OpenLogicEFI/Hardware/README.md

# [OpenLogicEFI](https://www.openlogicefi.com)
Formerly: DetonationEMS

</div>

OpenLogicEFI ECU's are based off an open source project called Speeduino by Josh Stewart. Currently all released boards use official Speeduino firmware. In TunerStudio set to "Board Layout" to "Speeduino 0.4"

</div>

# License
All designs are released under the [TAPR Open Hardware License v1.0](https://files.tapr.org/OHL/TAPR_Open_Hardware_License_v1.0.txt)

</div>

# Documentation

- The [Official Speeduino Manual](https://wiki.speeduino.com), documents and discord are the best places to start.

- [Official Speeduino Forum](https://speeduino.com/forum)

- [Official Speeduino Discord](https://discord.gg/jcmar3zfSJ)

- [Additional Documentation and Links](https://www.openlogicefi.com/support)

</div>
