OpenLogicEFI/Hardware/Modules/VR Conditioner NCV1124/RevB2/README.md

# VR Conditioner
Based on the NCV1124 Chip
RevB2

Changes:
*Updated Silkscreen 
*Increased input trace size
*Increased NCV1124 pad size for easier hand soldering
