OpenLogicEFI/Hardware/Engine Managment/Pre-Ignition/Pre-Ignition x4/End Cap/README.md

# PCB end caps for Hammond Cases (1455L1201,1455L1202) when used with Pre-Ignition x4 PN:MX4C
# End-caps compatible with Pre-Ignition x4 PN: MX4A,B,C when installed in 2nd slot from the bottom in Hammond Case PN: 1455L1201 & 1455L1202

www.OpenLogicEFI.com
