OpenLogicEFI/Hardware/Engine Managment/1.x/v1.3/1.3d/IDC8.PNG

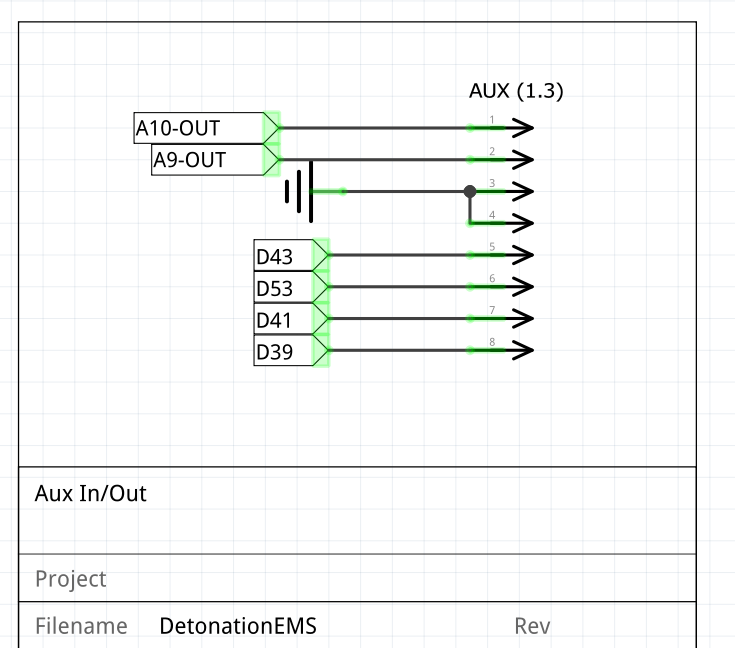
Engine Managment/1.x/v1.3/1.3d/IDC8.PNG
