OpenLogicEFI/Hardware/Engine Managment/1.x/v1.3/1.3d/uln2003.PNG

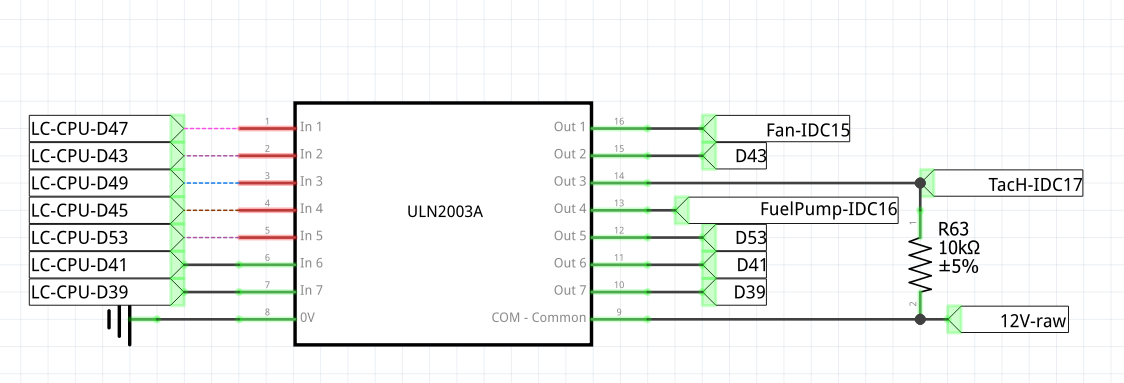
Engine Managment/1.x/v1.3/1.3d/uln2003.PNG
