OpenLogicEFI/Hardware/Engine Managment/Closed Deck/Closed Deck x4/Documentation/Black-B&W-Landscape.jpg

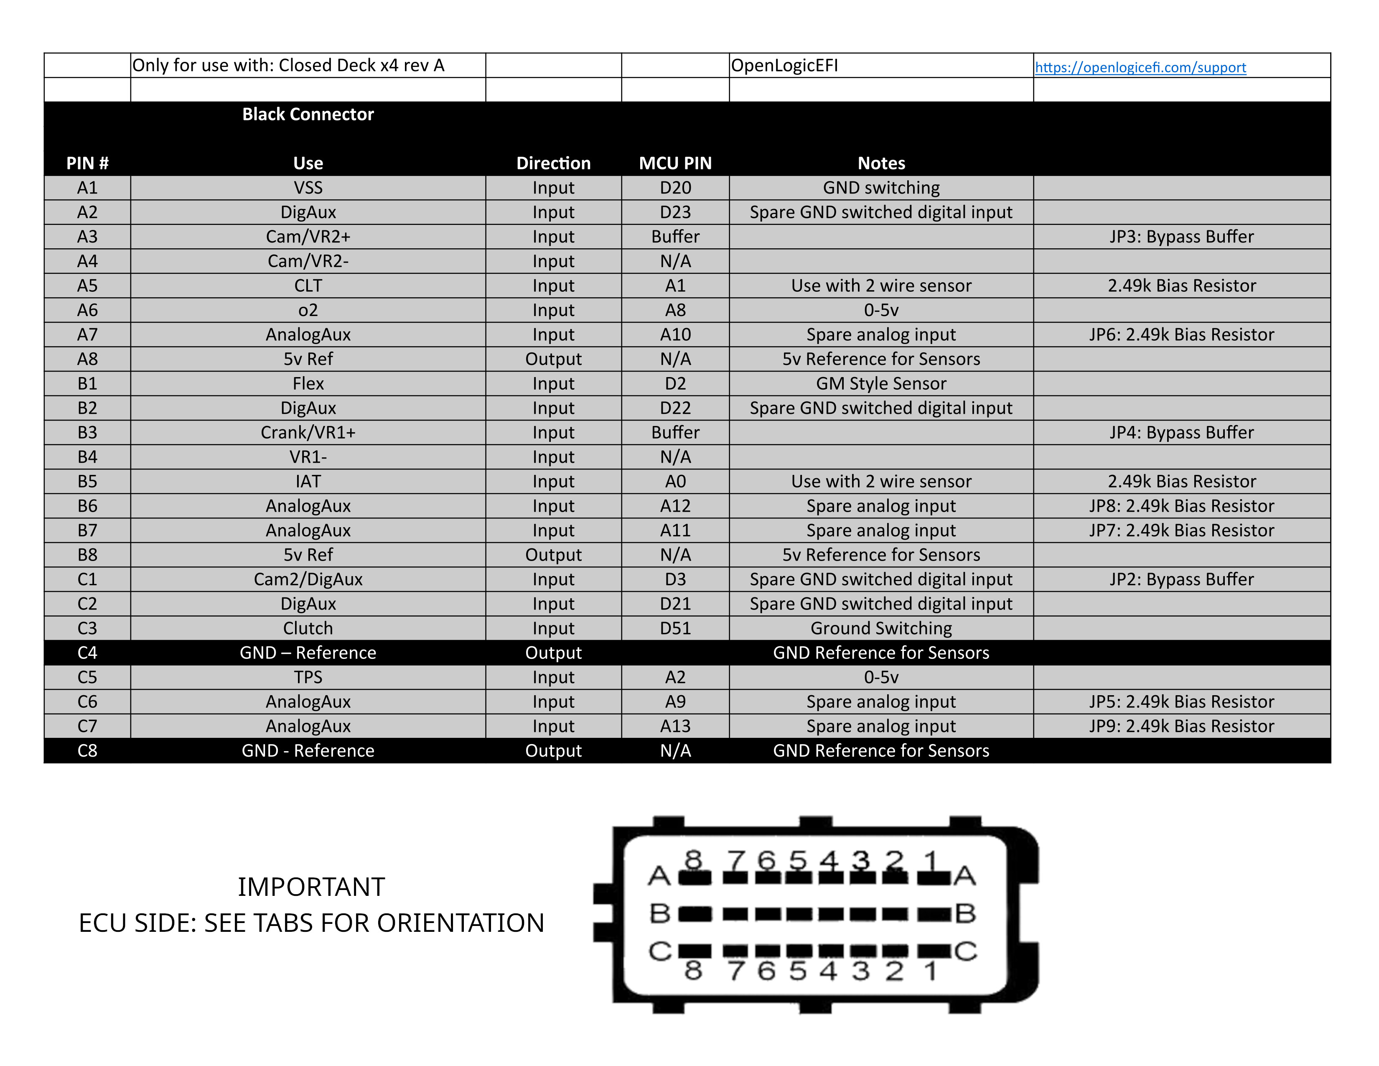
Engine Managment/Closed Deck/Closed Deck x4/Documentation/Black-B&W-Landscape.jpg
