OpenLogicEFI/Hardware/Engine Managment/Pre-Ignition/Pre-Ignition x2/Documents/MX2.jpg

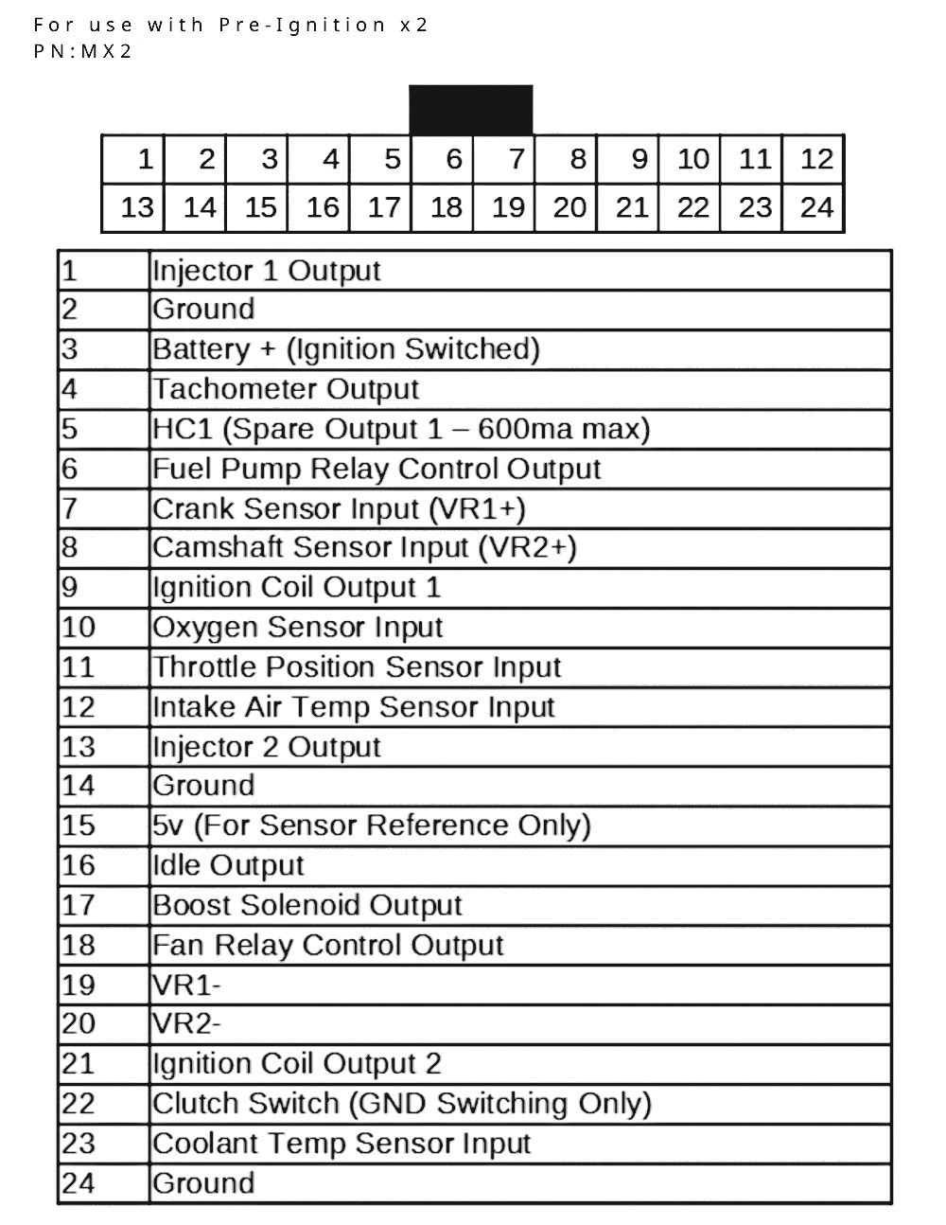
Engine Managment/Pre-Ignition/Pre-Ignition x2/Documents/MX2.jpg
