OpenLogicEFI/Hardware/Engine Managment/Pre-Ignition/Pre-Ignition x2/Documents/x2-24pin-harness.png

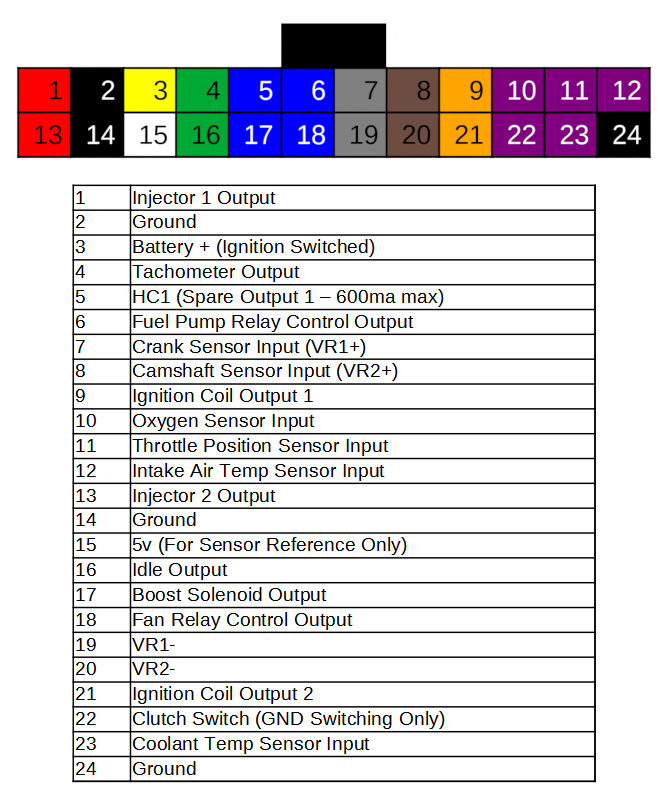
Engine Managment/Pre-Ignition/Pre-Ignition x2/Documents/x2-24pin-harness.png
