OpenLogicEFI/Hardware/Engine Managment/Pre-Ignition/Pre-Ignition x4/Documents/20pin-Bottom Mounted Connetcors.png

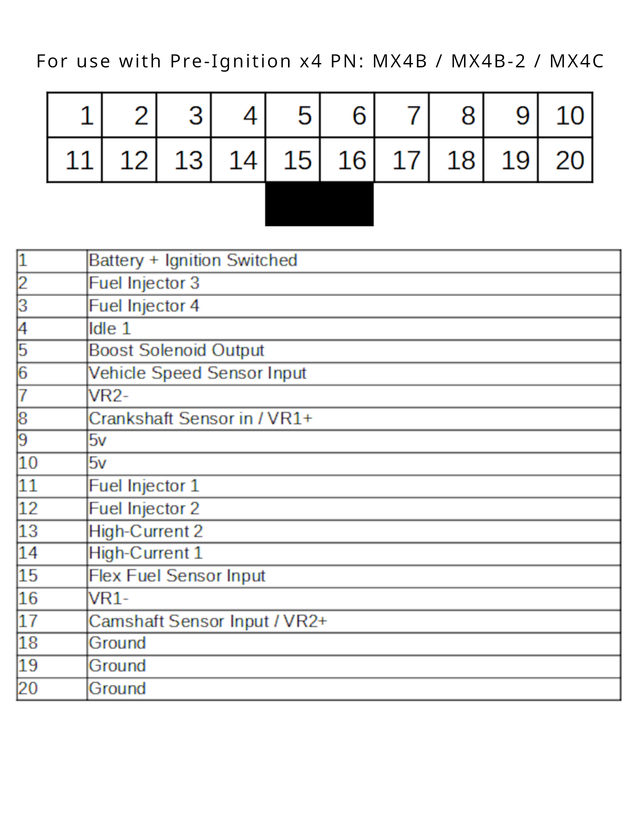
Engine Managment/Pre-Ignition/Pre-Ignition x4/Documents/20pin-Bottom Mounted Connetcors.png
