OpenLogicEFI/Hardware/Engine Managment/Pre-Ignition/Pre-Ignition x4/Documents/24pin-Bottom Mounted Connetcors.png

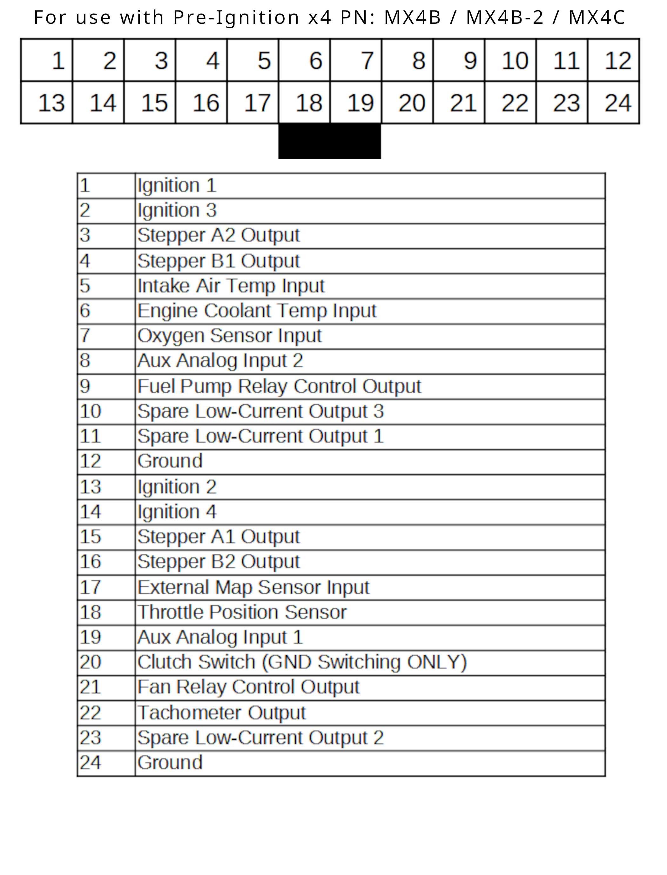
Engine Managment/Pre-Ignition/Pre-Ignition x4/Documents/24pin-Bottom Mounted Connetcors.png
