OpenLogicEFI/Hardware/Engine Managment/Pre-Ignition/Pre-Ignition x4/Documents/Harness20pin-LowMounted.png

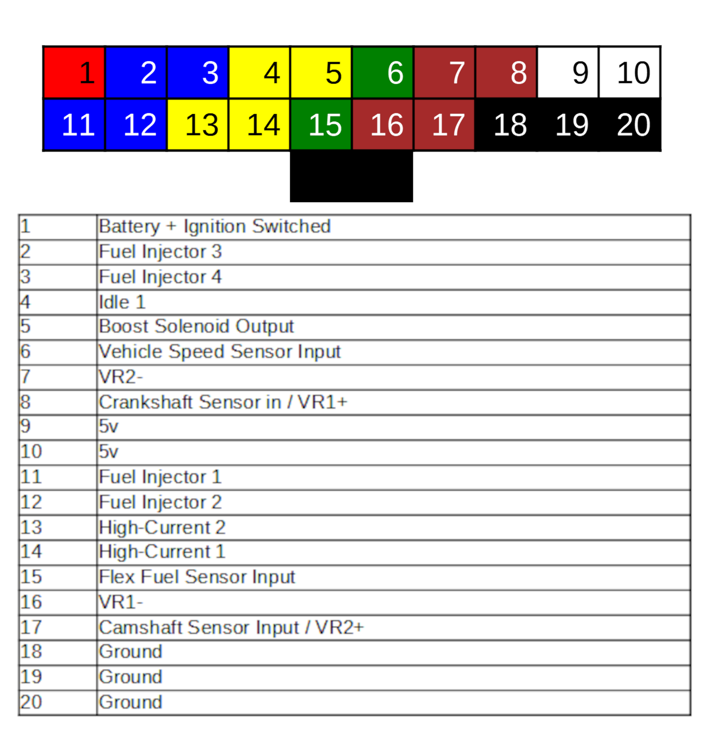
Engine Managment/Pre-Ignition/Pre-Ignition x4/Documents/Harness20pin-LowMounted.png
