OpenLogicEFI/Hardware/Engine Managment/Pre-Ignition/Pre-Ignition x4/Documents/Harness24pin-LowMounted.png

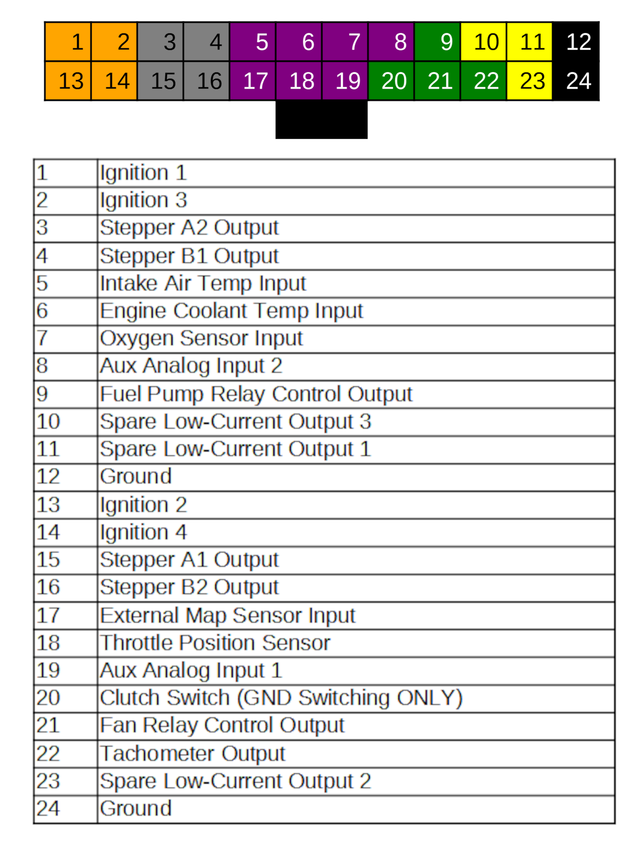
Engine Managment/Pre-Ignition/Pre-Ignition x4/Documents/Harness24pin-LowMounted.png
