OpenLogicEFI/Hardware/Modules/INJ THT Fet/docs/TO-220_pkgdim.gif

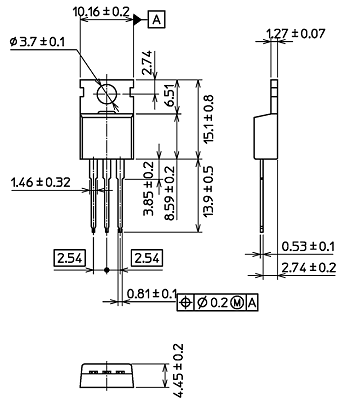
Modules/INJ THT Fet/docs/TO-220_pkgdim.gif
