OpenLogicEFI/Hardware/STL/1.3e/1.3 - Front.stl

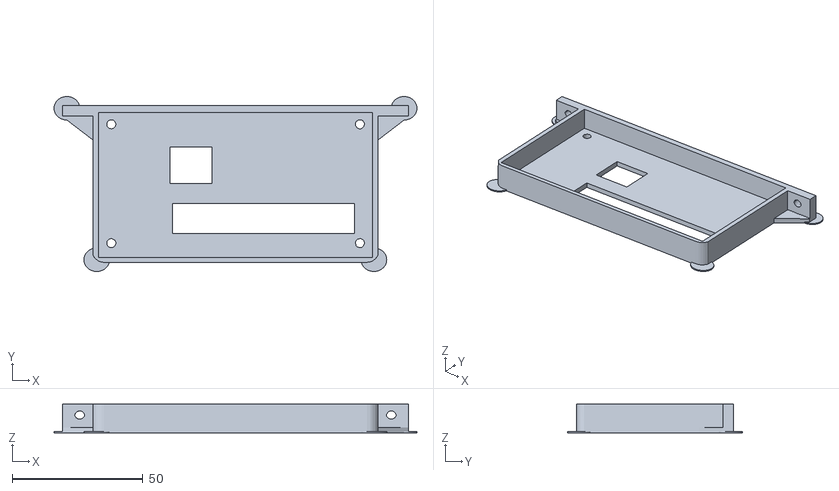
[picture p13: CAD file, 2022-08-21]
STL/1.3e/1.3 - Front.stl
139.0 x 67.0 x 11.1
