OpenLogicEFI/Hardware/STL/pre-ignition x4/Front.stl

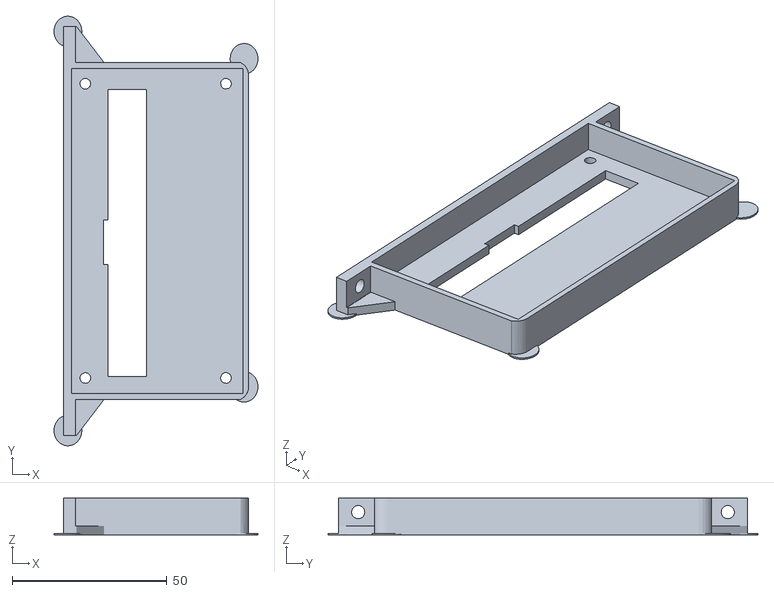
[picture p14: CAD file, 2022-08-21]
STL/pre-ignition x4/Front.stl
66.0 x 139.0 x 11.9
