OpenLogicEFI/Hardware/STL/1.3e/1.3 - Back.stl

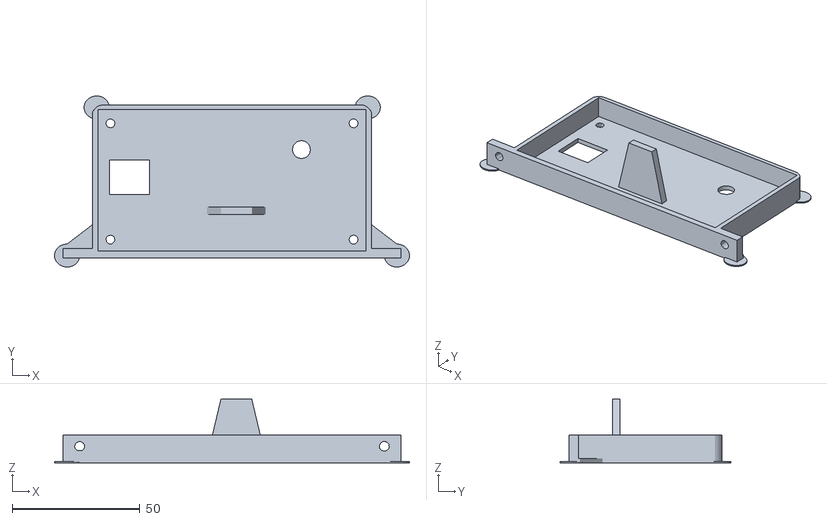
[picture p15: CAD file, 2022-08-21]
STL/1.3e/1.3 - Back.stl
139.0 x 67.0 x 25.0
