OpenLogicEFI/Hardware/STL/pre-ignition x4/Back.stl

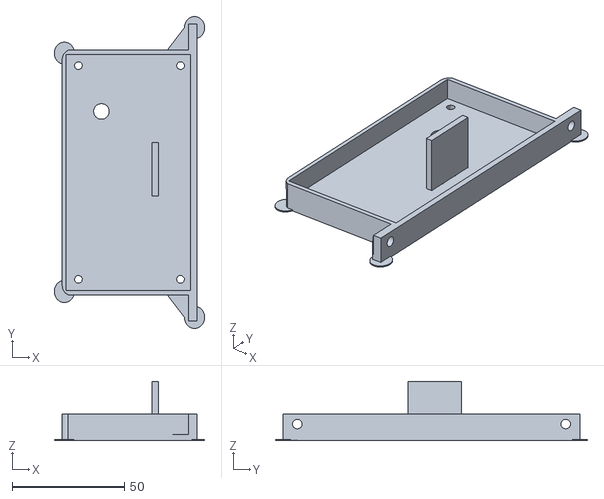
[picture p16: CAD file, 2022-08-21]
STL/pre-ignition x4/Back.stl
67.0 x 139.0 x 26.4
