OpenLogicEFI/Hardware/STL/Pre-Ignition x2/body.stl

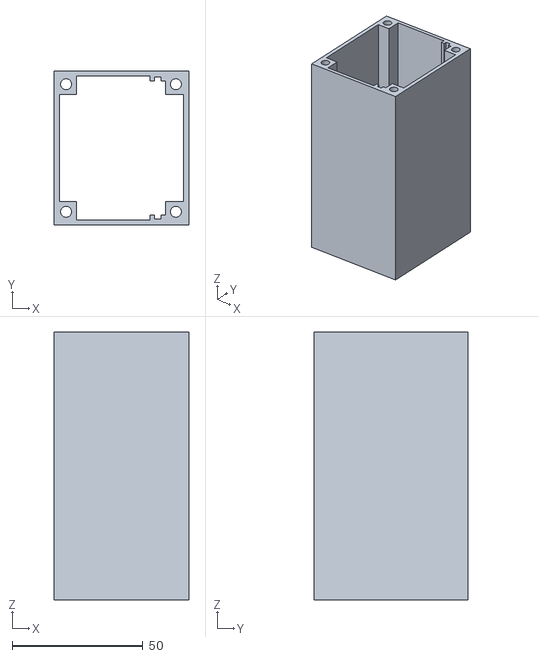
[picture p17: CAD file, 2021-10-03]
STL/Pre-Ignition x2/body.stl
51.5 x 58.8 x 102.5
