OpenLogicEFI/Hardware/STL/Pre-Ignition x2/back.stl

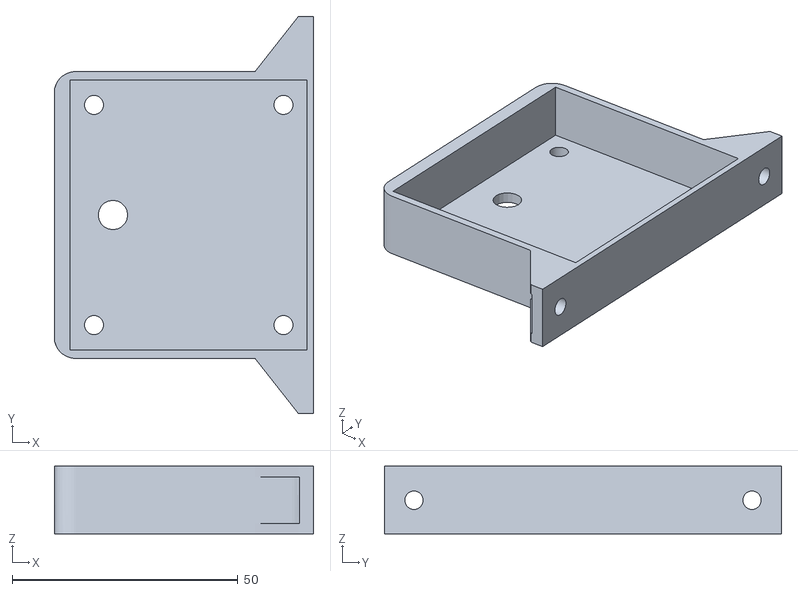
[picture p18: CAD file, 2021-10-03, an earlier design]
STL/Pre-Ignition x2/back.stl
57.5 x 88.0 x 15.0
