OpenLogicEFI/Hardware/STL/Pre-Ignition x2/front.stl

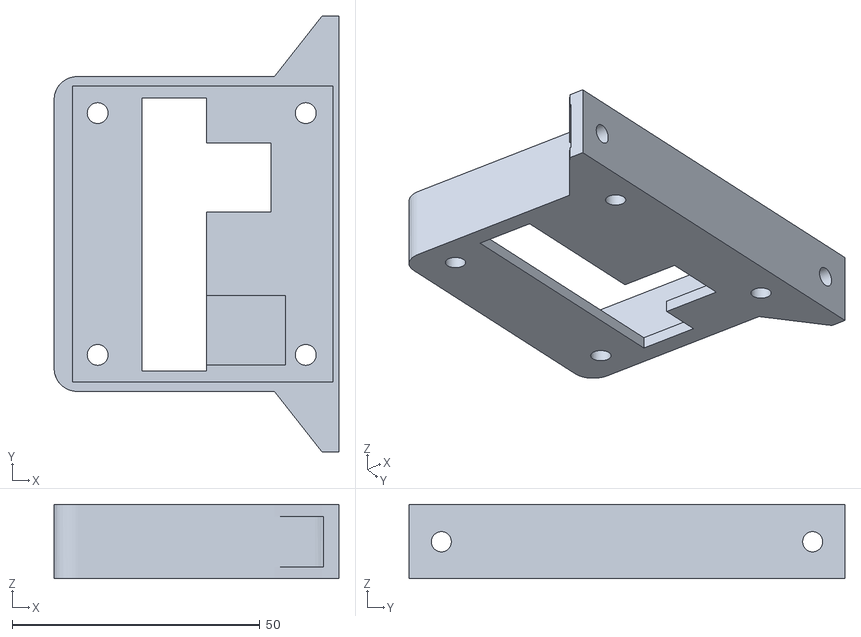
[picture p19: CAD file, 2021-10-03, an earlier design]
STL/Pre-Ignition x2/front.stl
57.5 x 88.0 x 15.0
