OpenLogicEFI/Hardware/Modules/VR Conditioner NCV1124/RevA/Instructions.odt

Instructions

Pin Setup:

This Conditioner is capable of conditioning two variable reluctance inputs but cannot pass through other signal types such as hall (square) signals. If one of your inputs is NOT a VR signal do NOT populate both input and output pins for that signal.

Crankshaft Position Sensor - VR1+ / 1 OUT

Camshaft Position Sensor - VR2+ / 2 OUT

Example: The following picture shows the conditioner setup for use with a VR Sensor on the Crankshaft and a Hall Sensor on the camshaft. The pins in the picture below are not populated on pins VR2+ and 2 OUT. Therefor the Camshaft position sensor will not be conditioned.

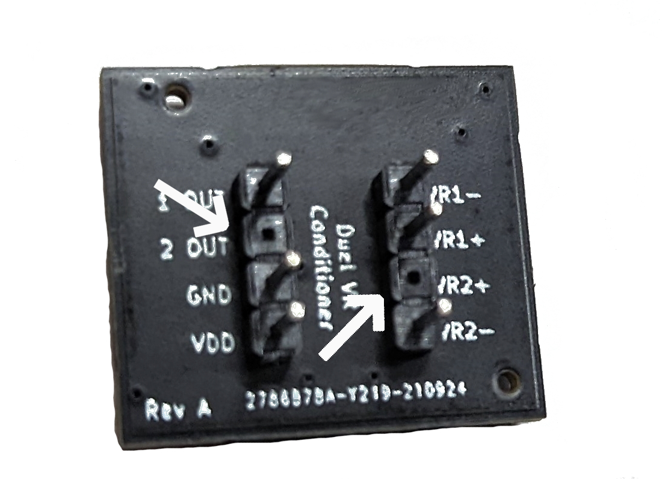
[picture p20: figure]
