OpenLogicEFI/Hardware/Engine Managment/Pre-Ignition/Pre-Ignition x2/MX2B/schematic.pdf

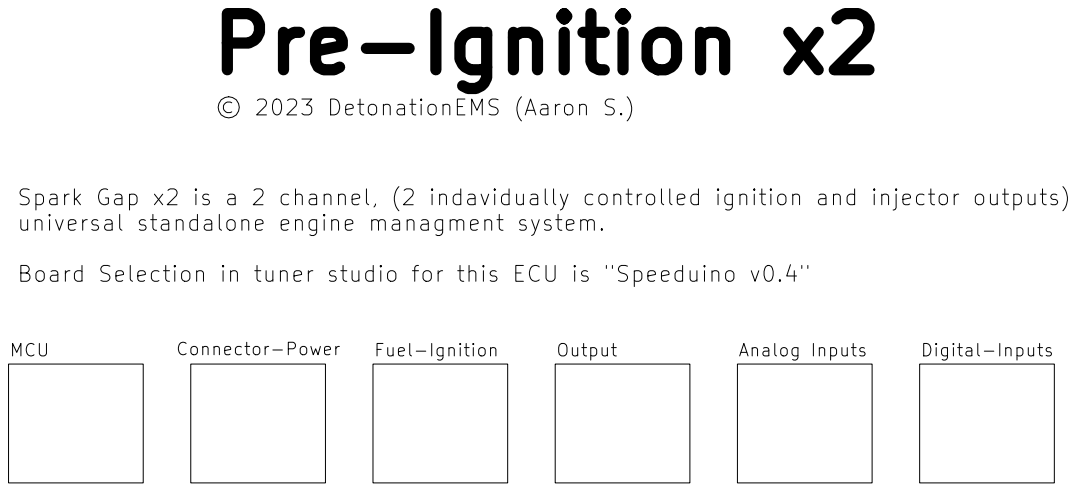
[picture p55: page 1]

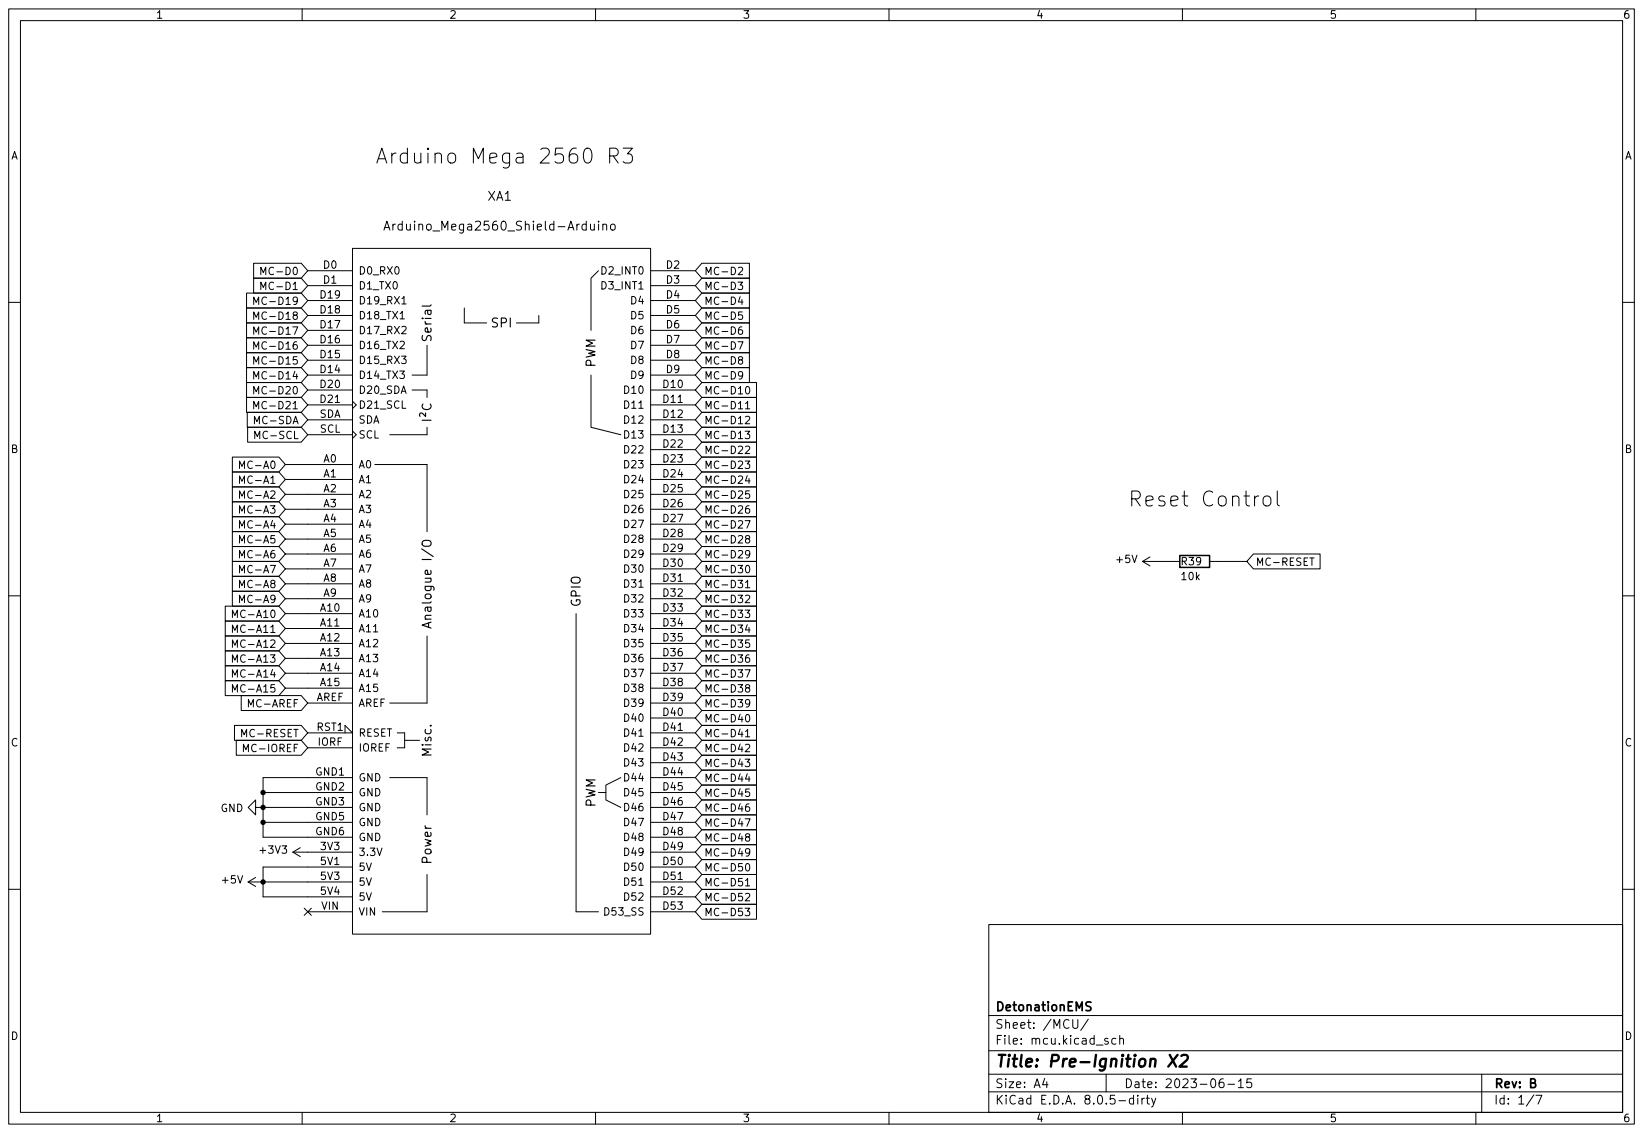
[picture p56: page 2]

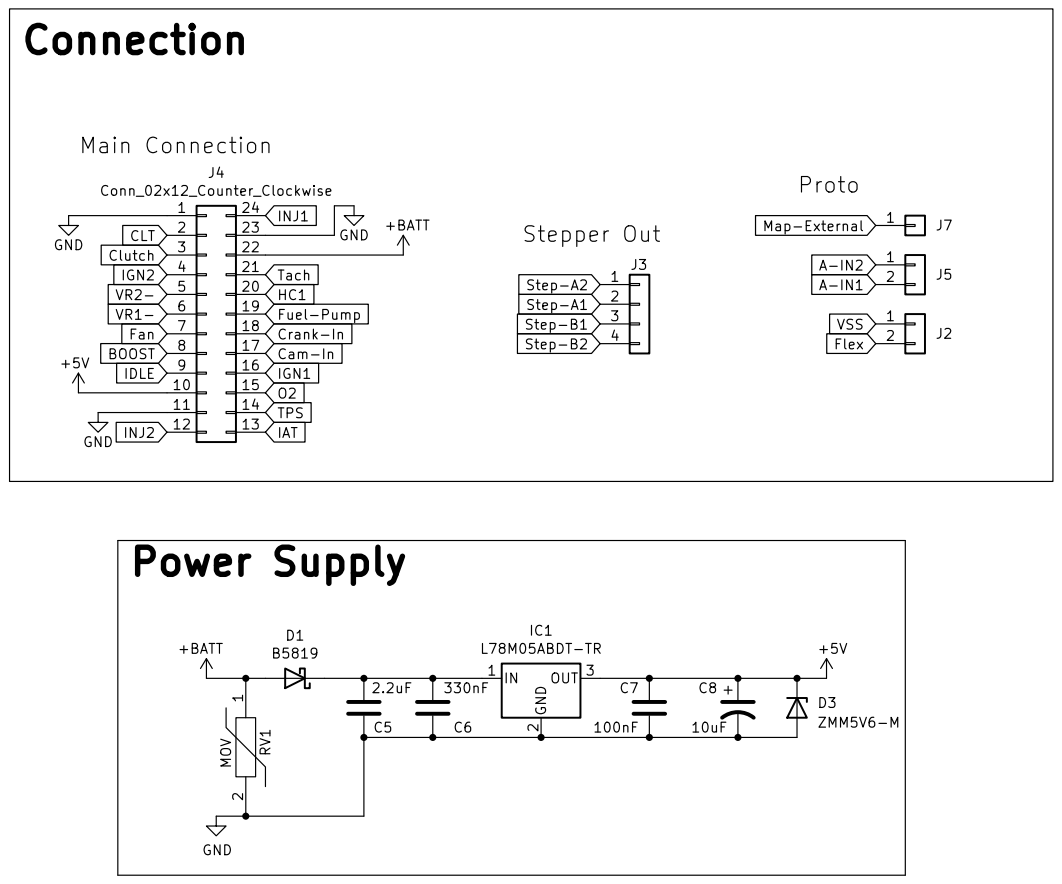
[picture p57: page 3]

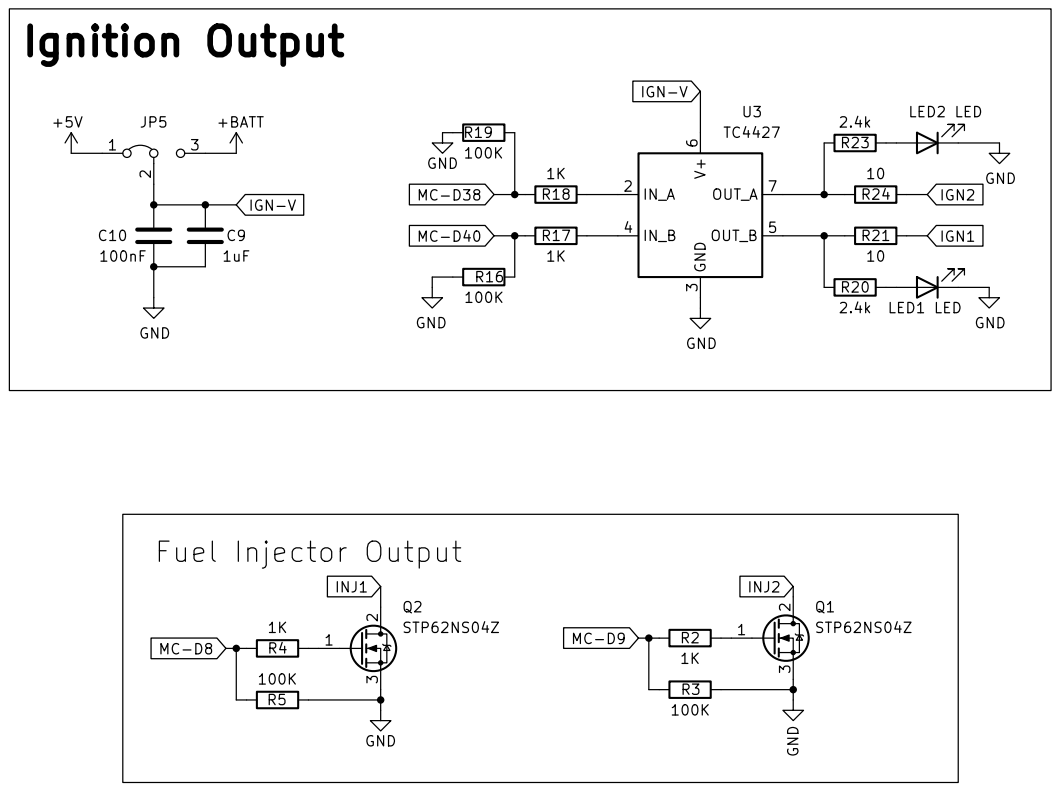
[picture p58: page 4]

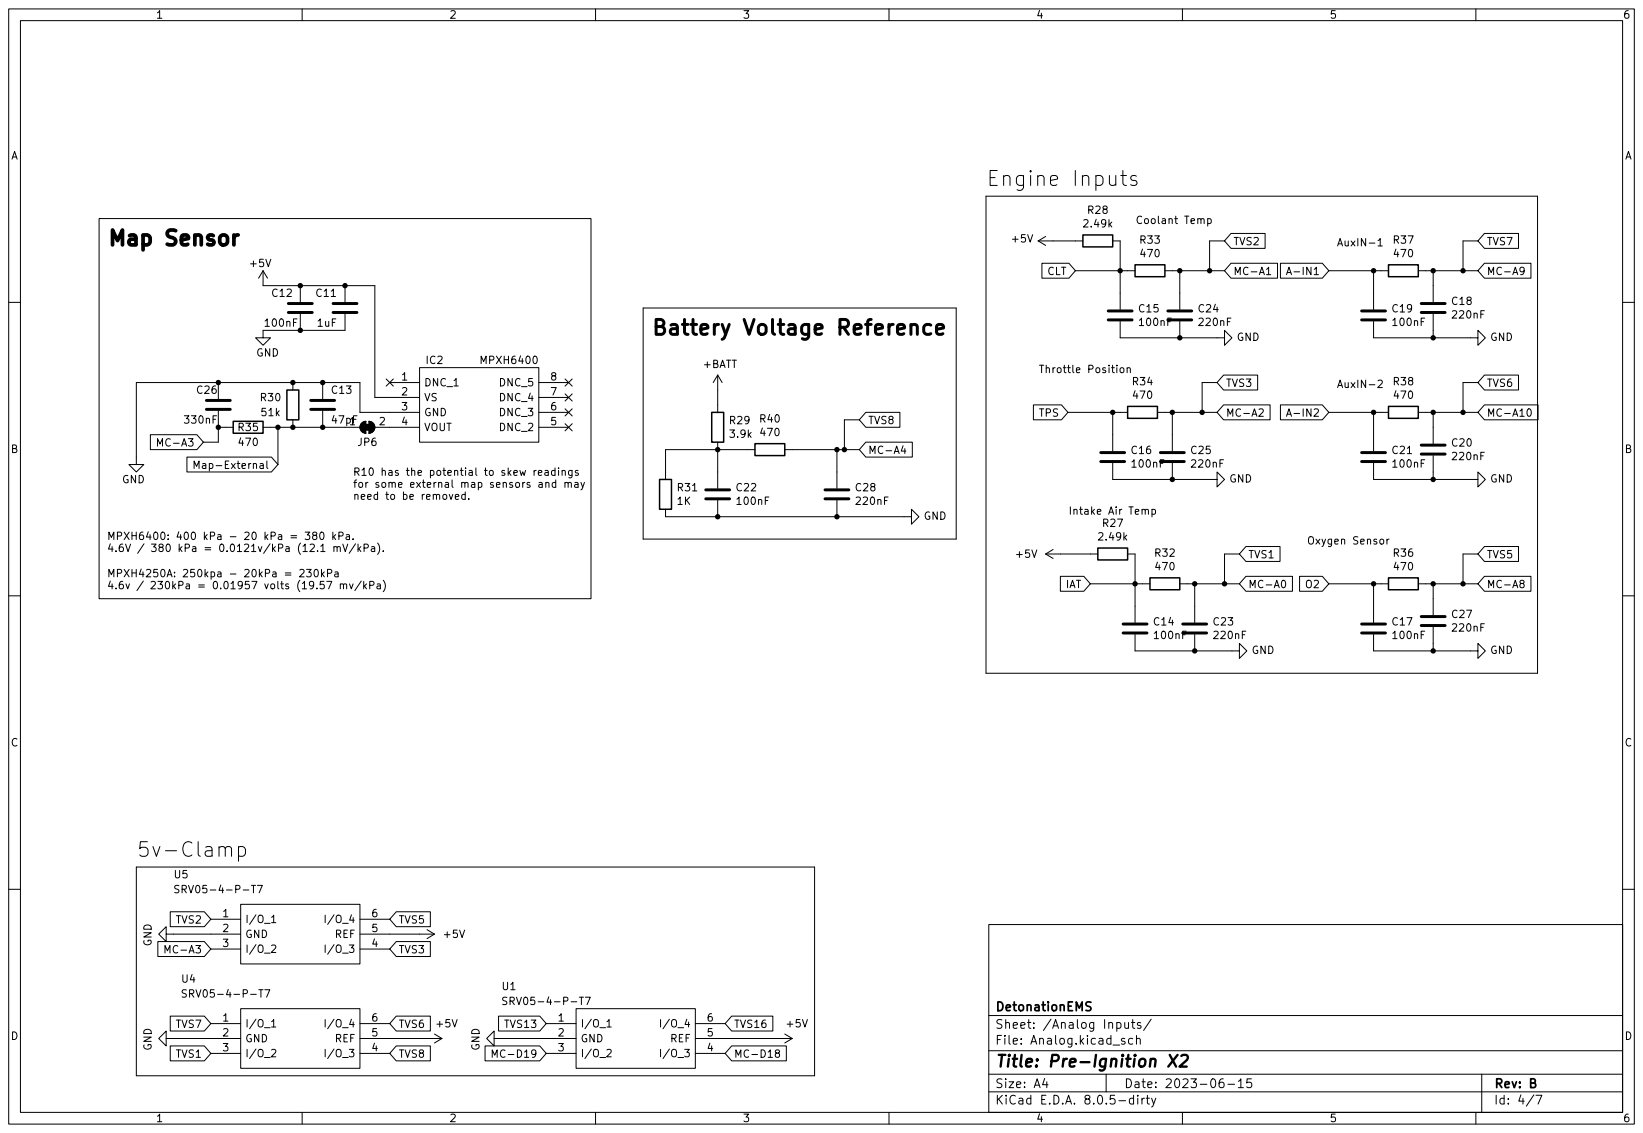
[picture p59: page 5]

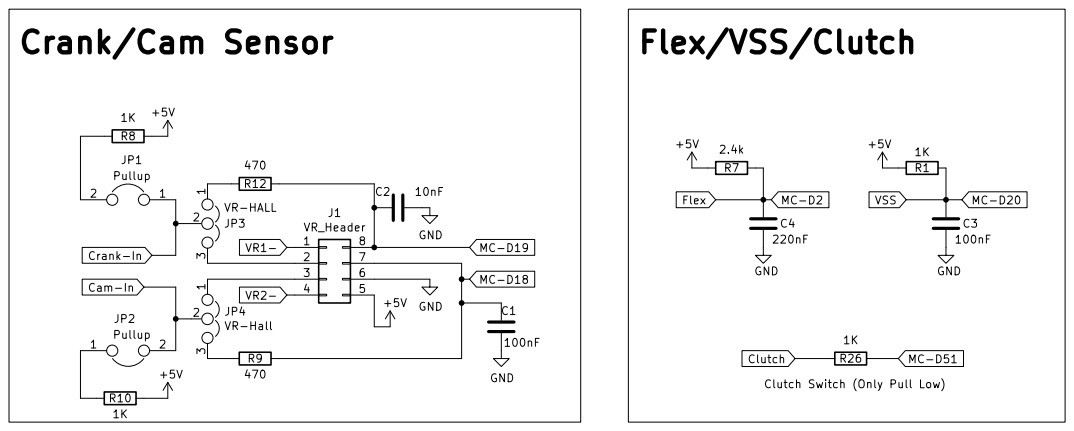
[picture p60: page 6]

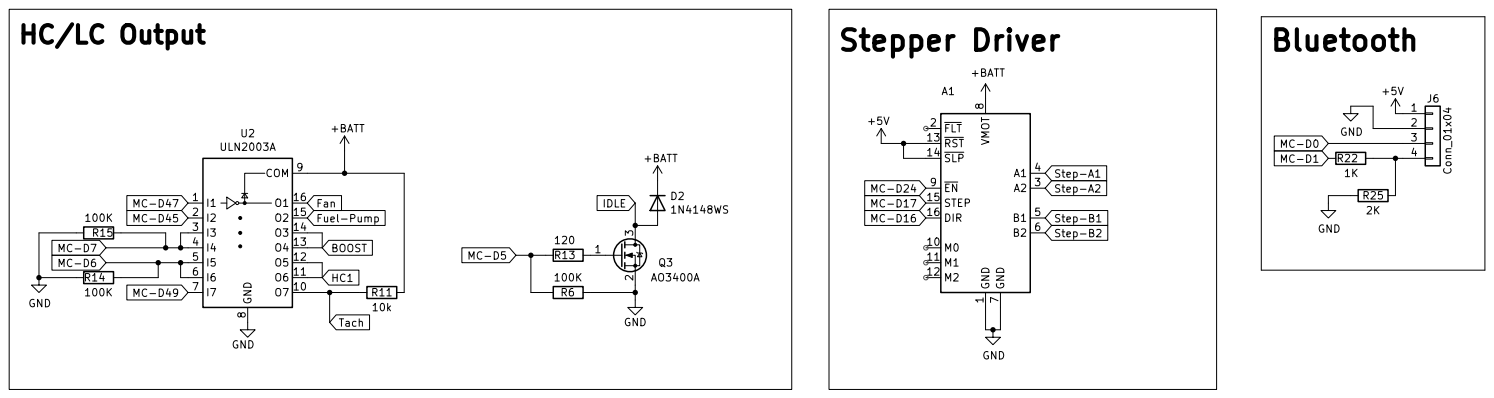
[picture p61: page 7]
