OpenLogicEFI/Hardware/Engine Managment/Spark Gap/Spark Gap X4/Documents/schematic_revA.pdf

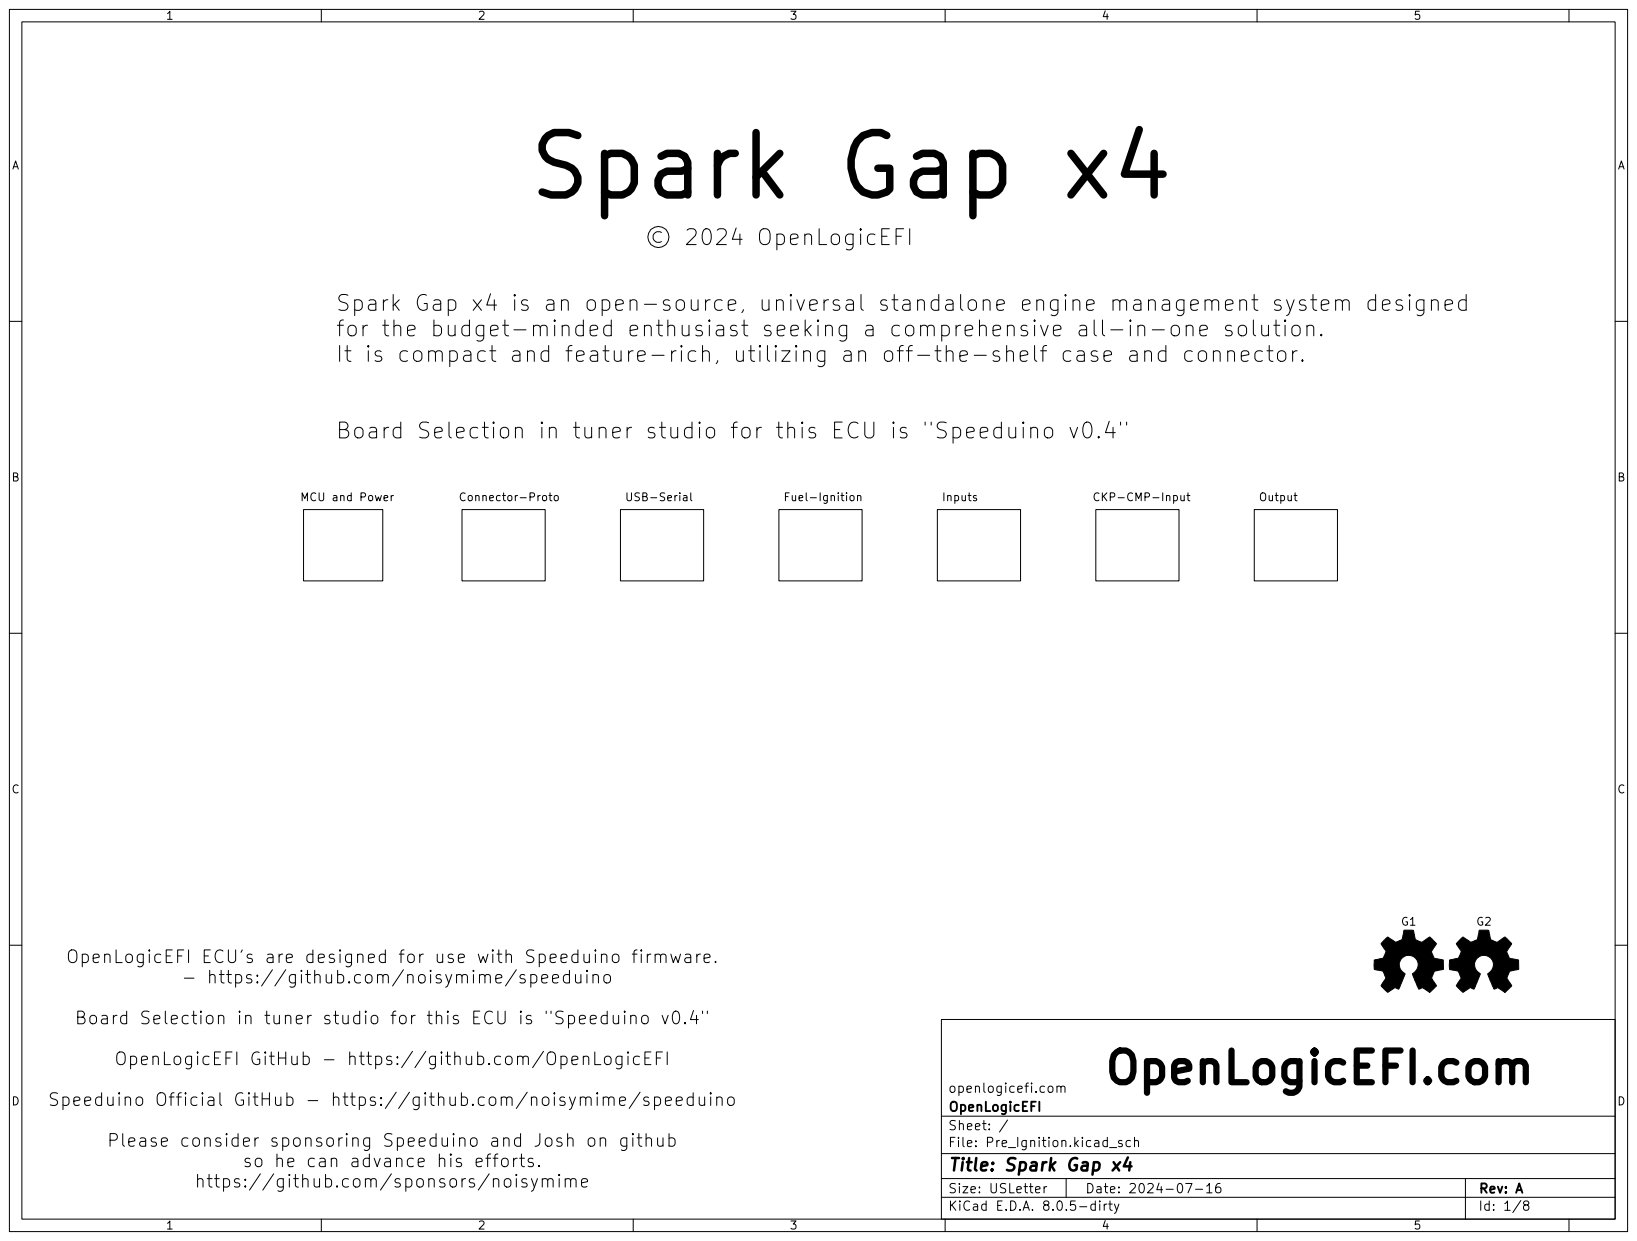
[picture p73: page 1]

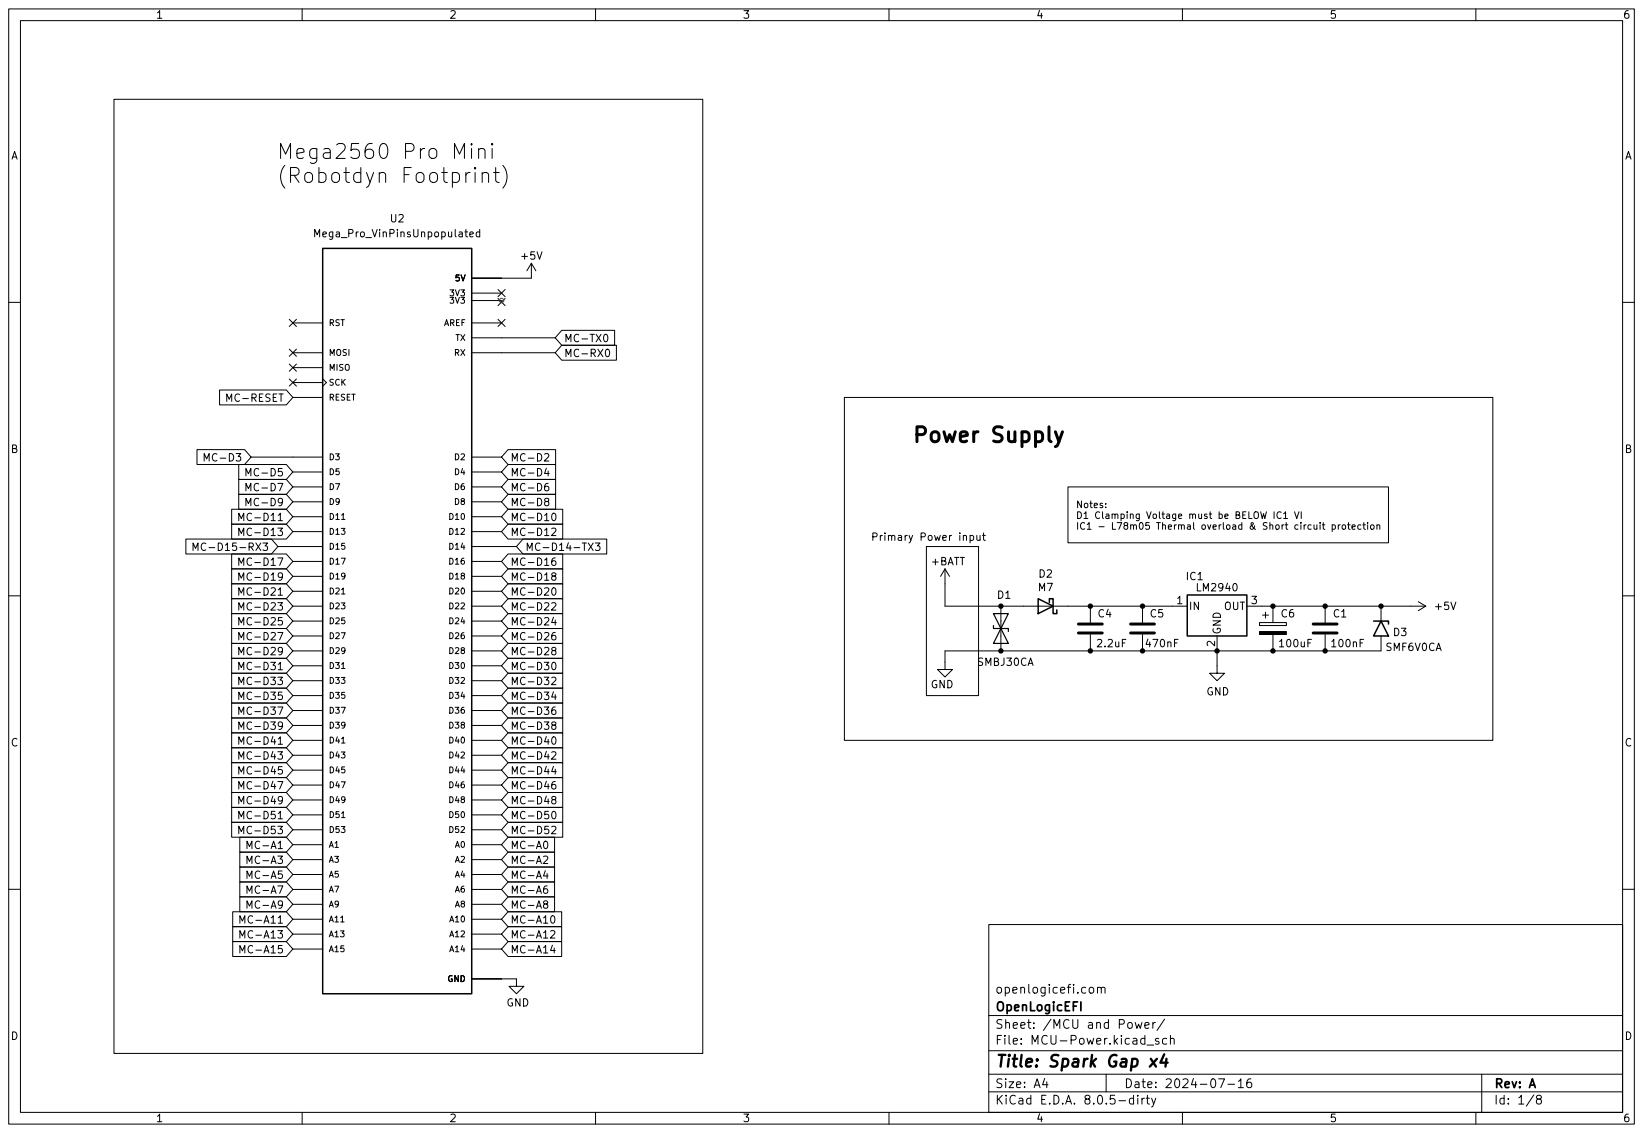
[picture p74: page 2]

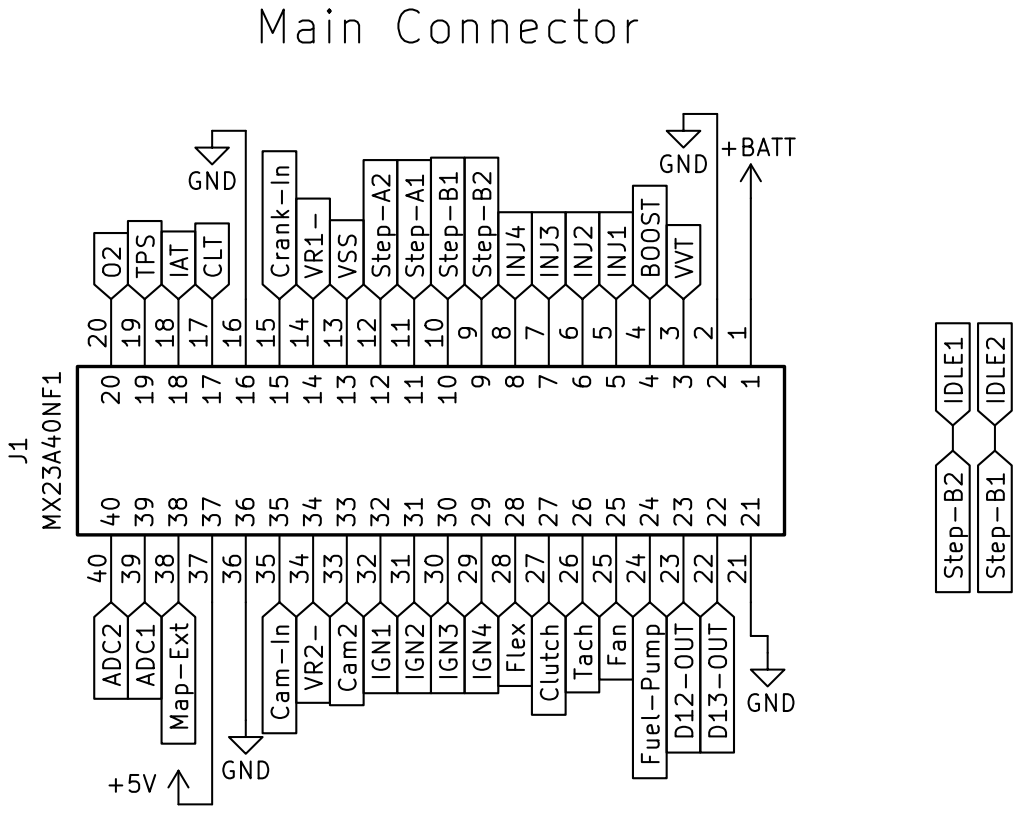
[picture p75: page 3]

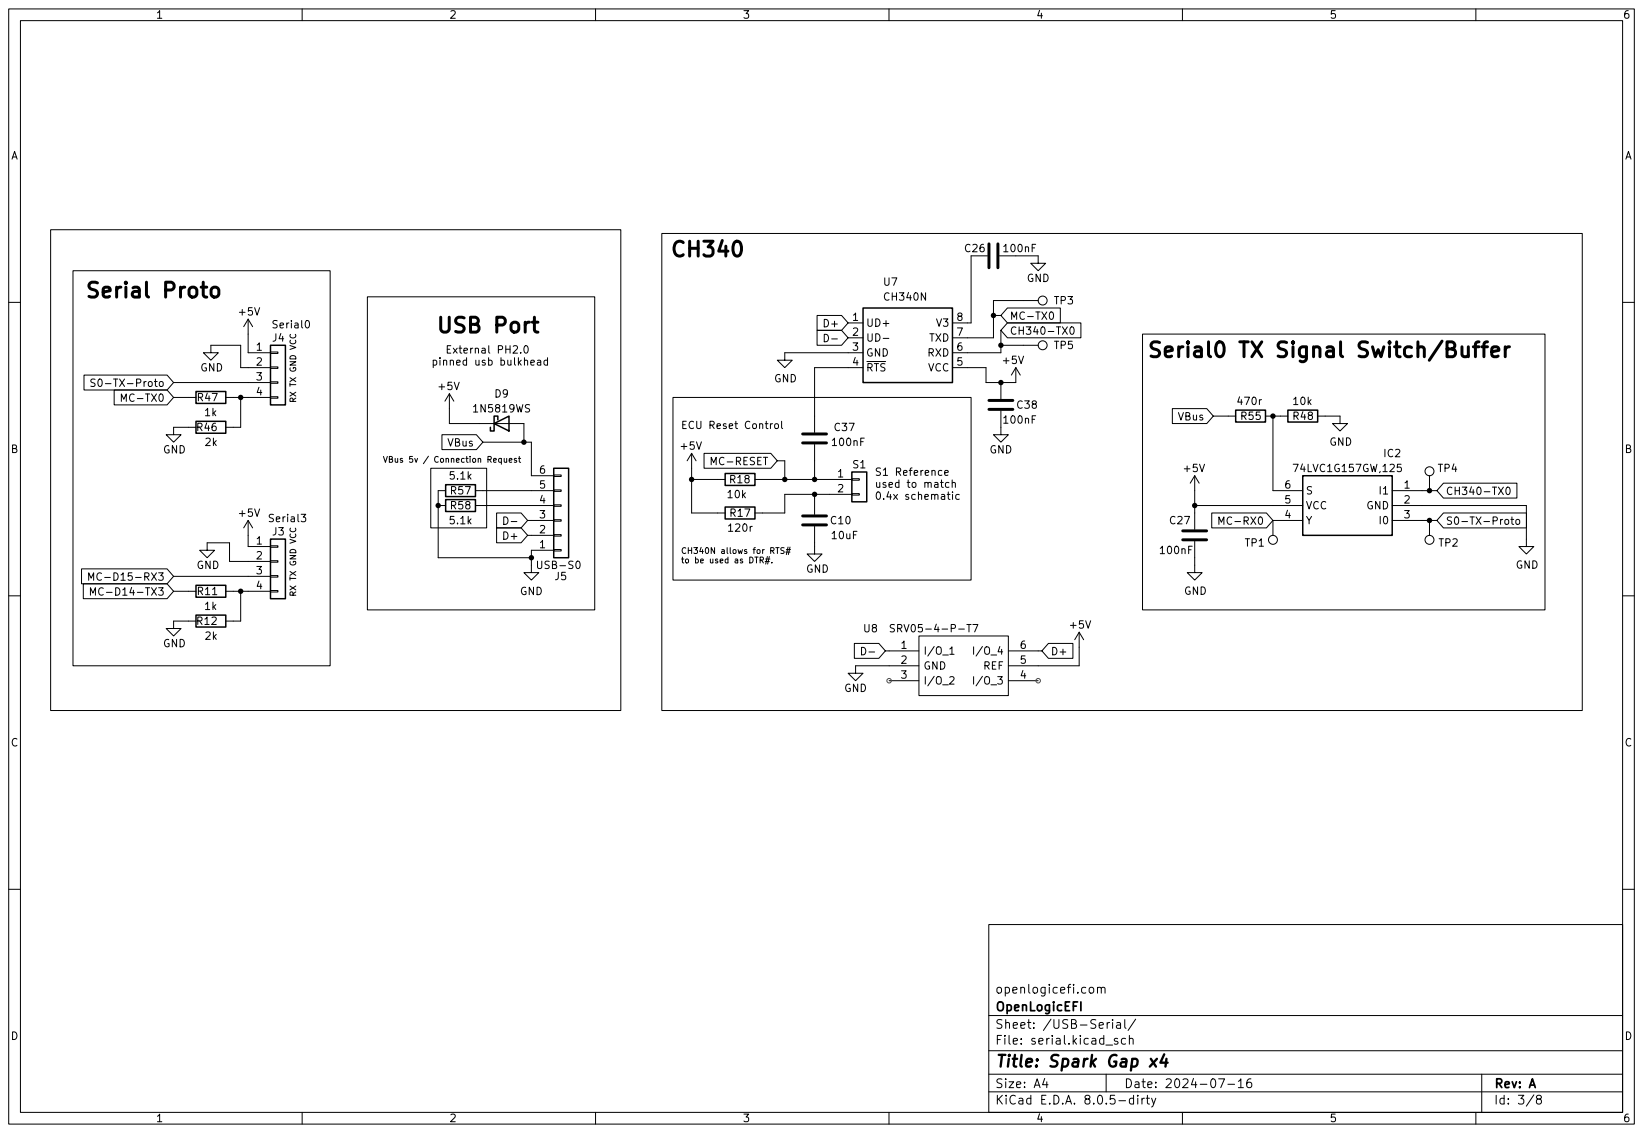
[picture p76: page 4]

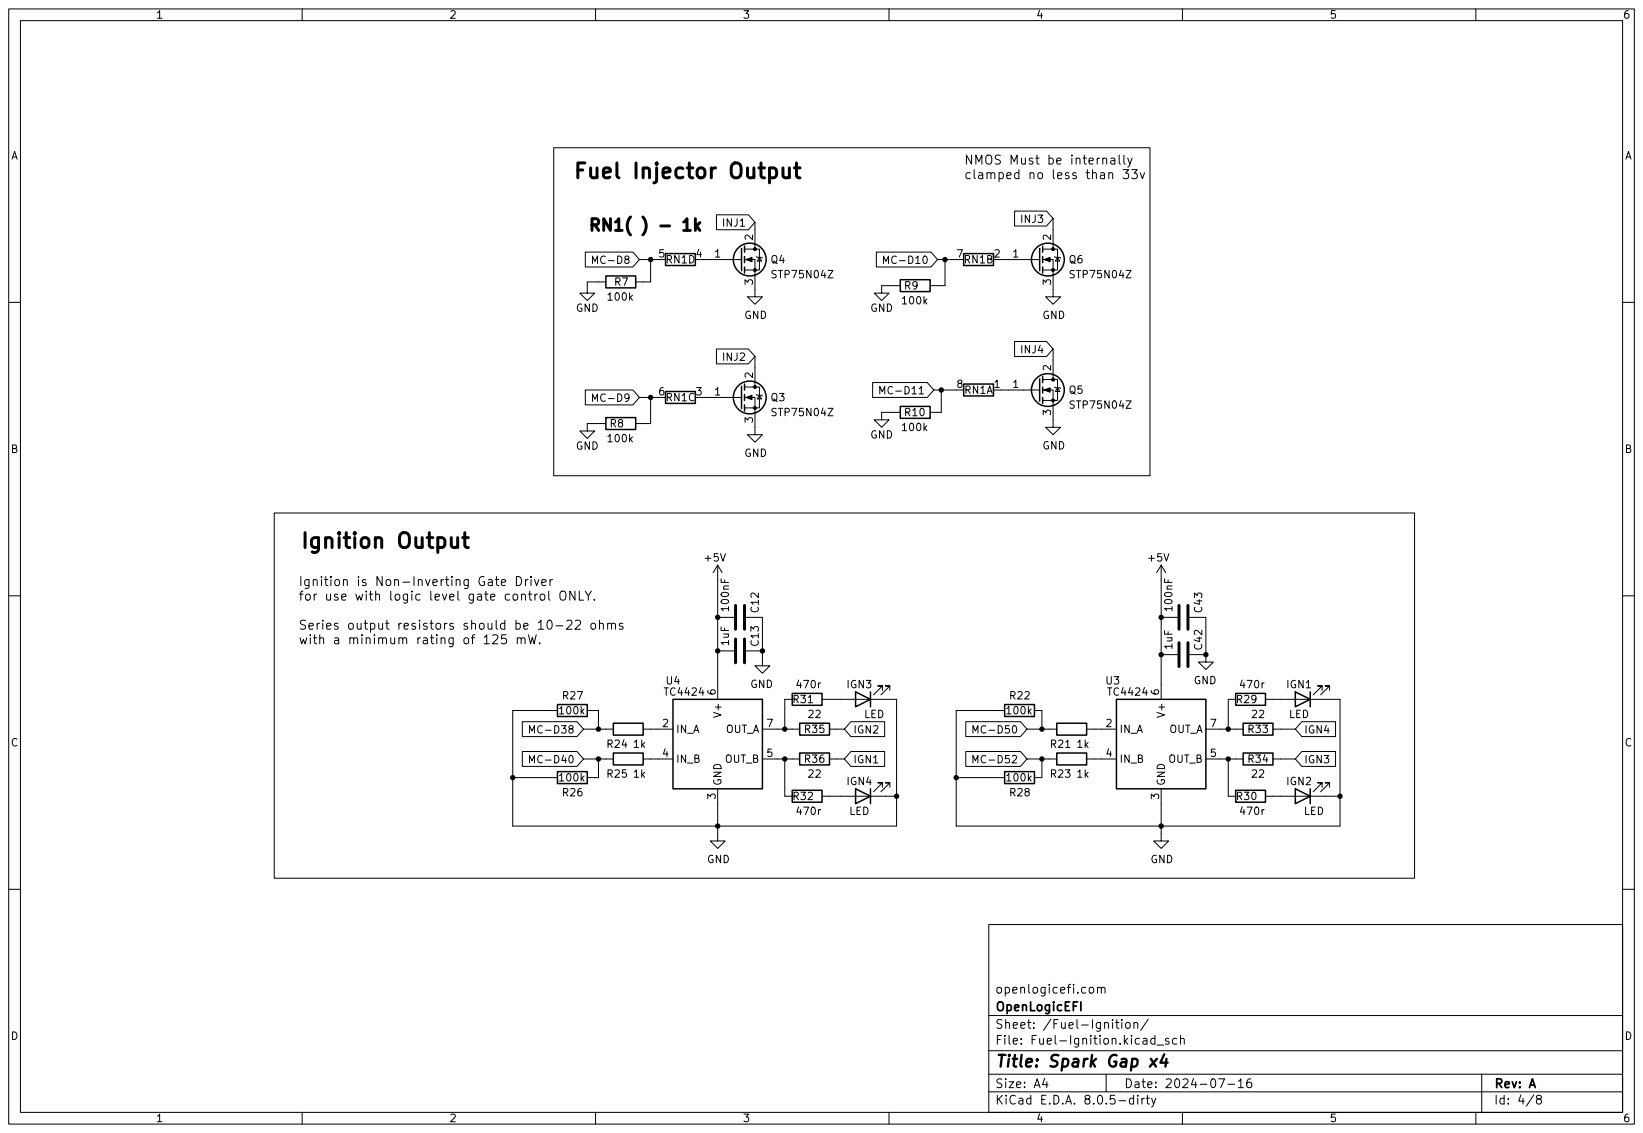
[picture p77: page 5]

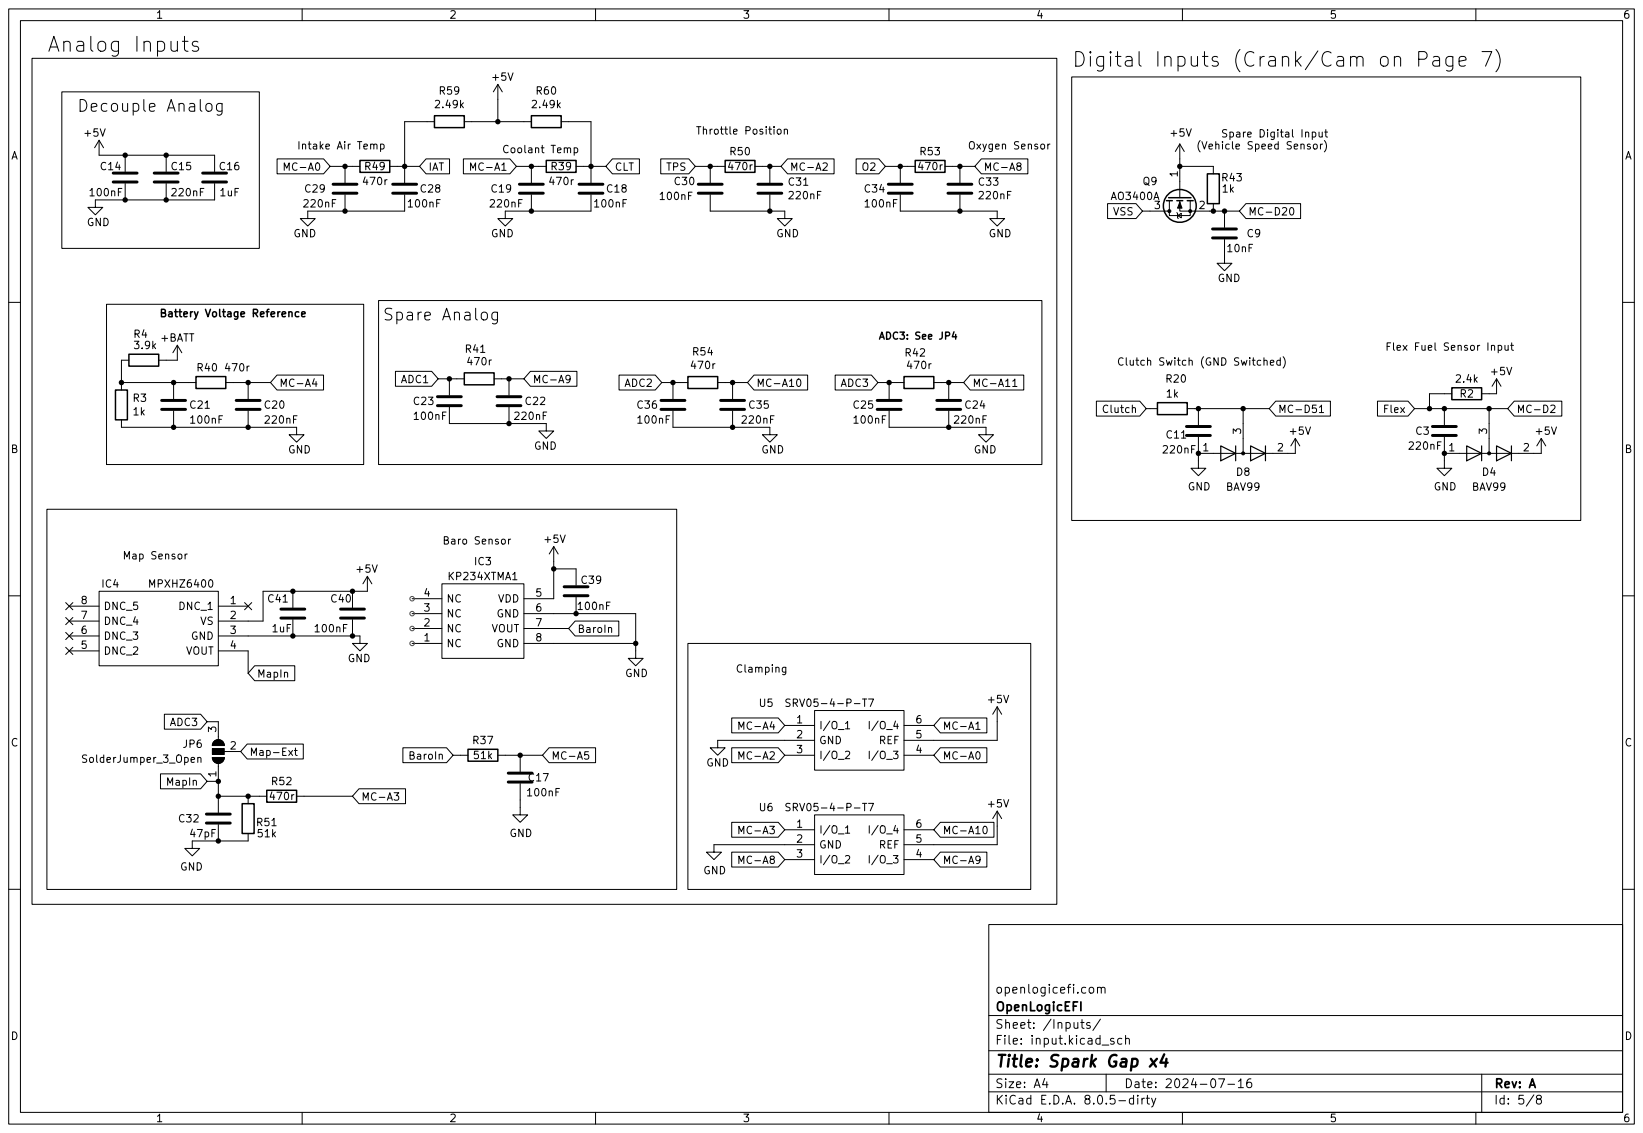
[picture p78: page 6]

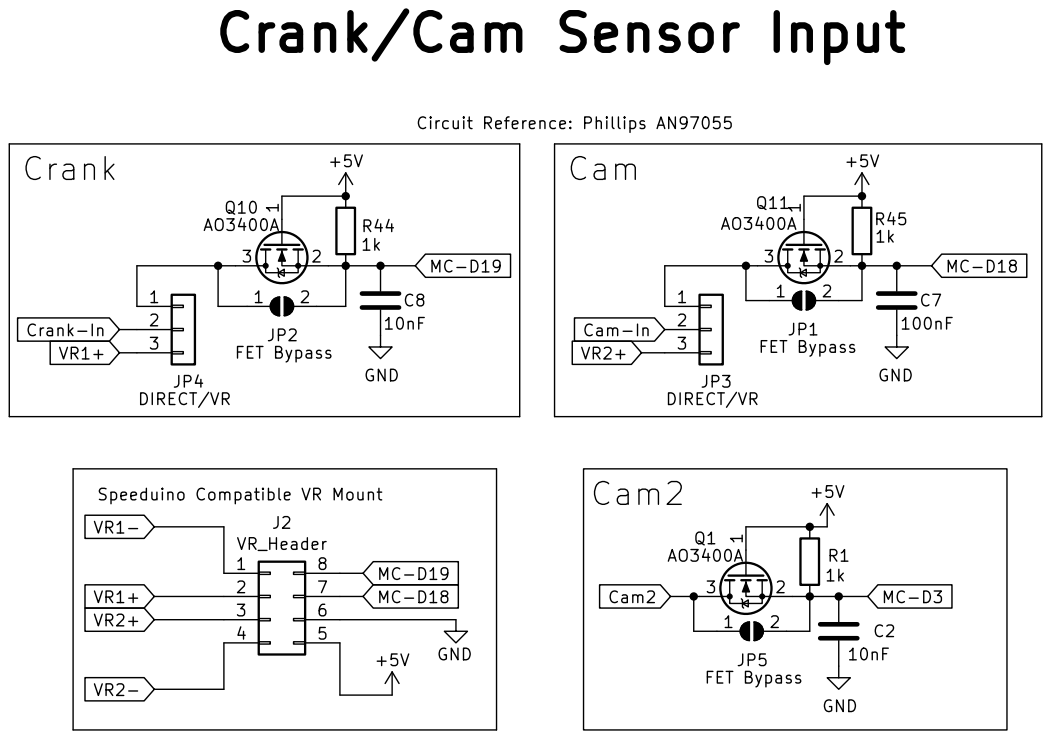
[picture p79: page 7]

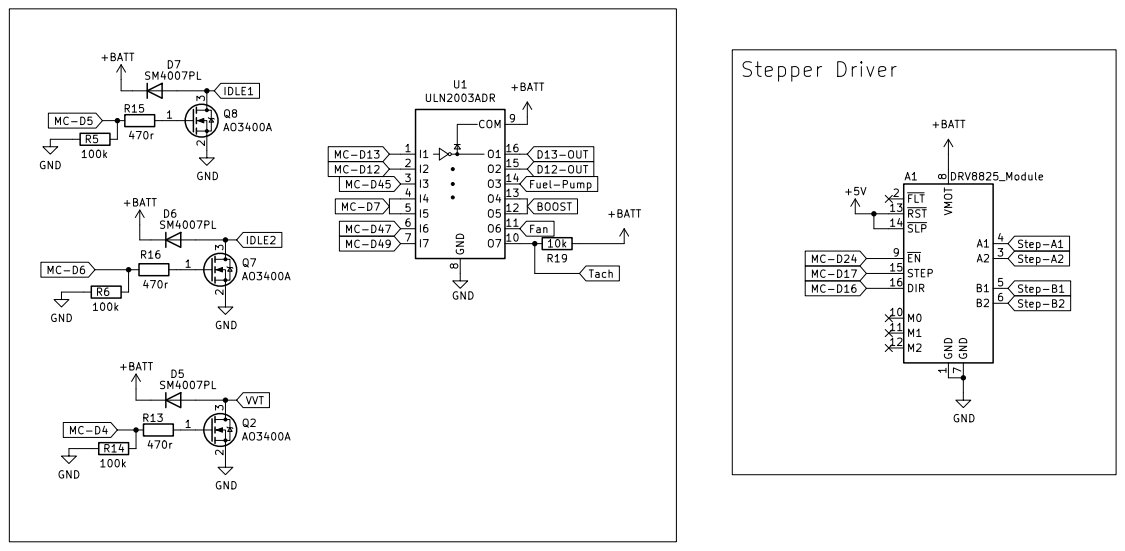
[picture p80: page 8]
