OpenLogicEFI/Hardware/(list of files, drawings)

Other design files:
Engine Managment/1.x/Breakout/Test Screw Terminal Breakout.fzz
Engine Managment/1.x/Breakout/Universal v1.2.fzz
Engine Managment/1.x/v1.1/v1.1b.fzz
Engine Managment/1.x/v1.2/1.2a/v1.2a.fzz
Engine Managment/1.x/v1.2/1.2b/v1.2b.fzz
Engine Managment/1.x/v1.3/1.3a/v1.3a.fzz
Engine Managment/1.x/v1.3/1.3d/v1.3.fzz
Modules/Ignition Control Module/IGNC-2-v2.fzz
