OpenLogicEFI/Hardware/Engine Simulation/8 Channel/RevD/Simulator.kicad_pcb

## KiCad design Engine Simulation/8 Channel/RevD/Simulator.kicad_pcb (2026-10-17)

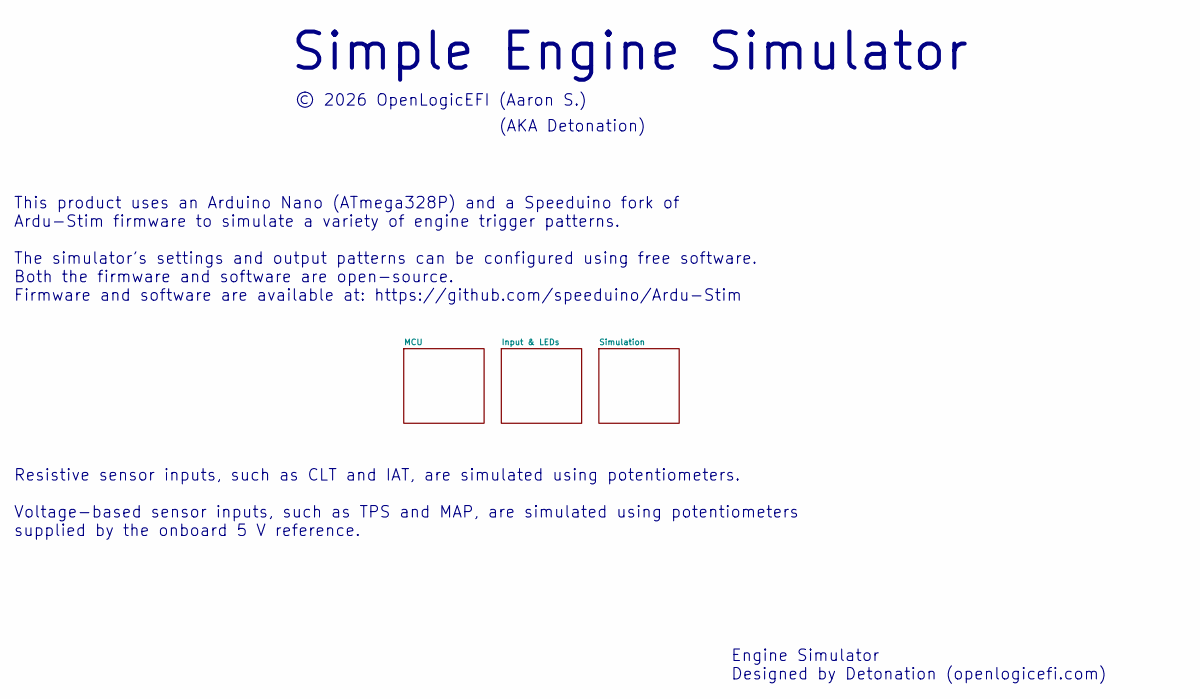
[picture p81: schematic Simulator.kicad_sch, Engine Simulator]

Notes on the sheet:
This product uses an Arduino Nano (ATmega328P) and a Speeduino fork of Ardu-Stim firmware to simulate a variety of engine trigger patterns. The simulator's settings and output patterns can be configured using free software. Both the firmware and software are open-source. Firmware and software are a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
Engine Simulator Designed by Detonation (openlogicefi.com)
(AKA Detonation)
Resistive sensor inputs, such as CLT and IAT, are simulated using potentiometers. Voltage-based sensor inputs, such as TPS and MAP, are simulated using potentiometers supplied by the onboard 5 V reference.
© 2026 OpenLogicEFI (Aaron S.)
Simple Engine Simulator

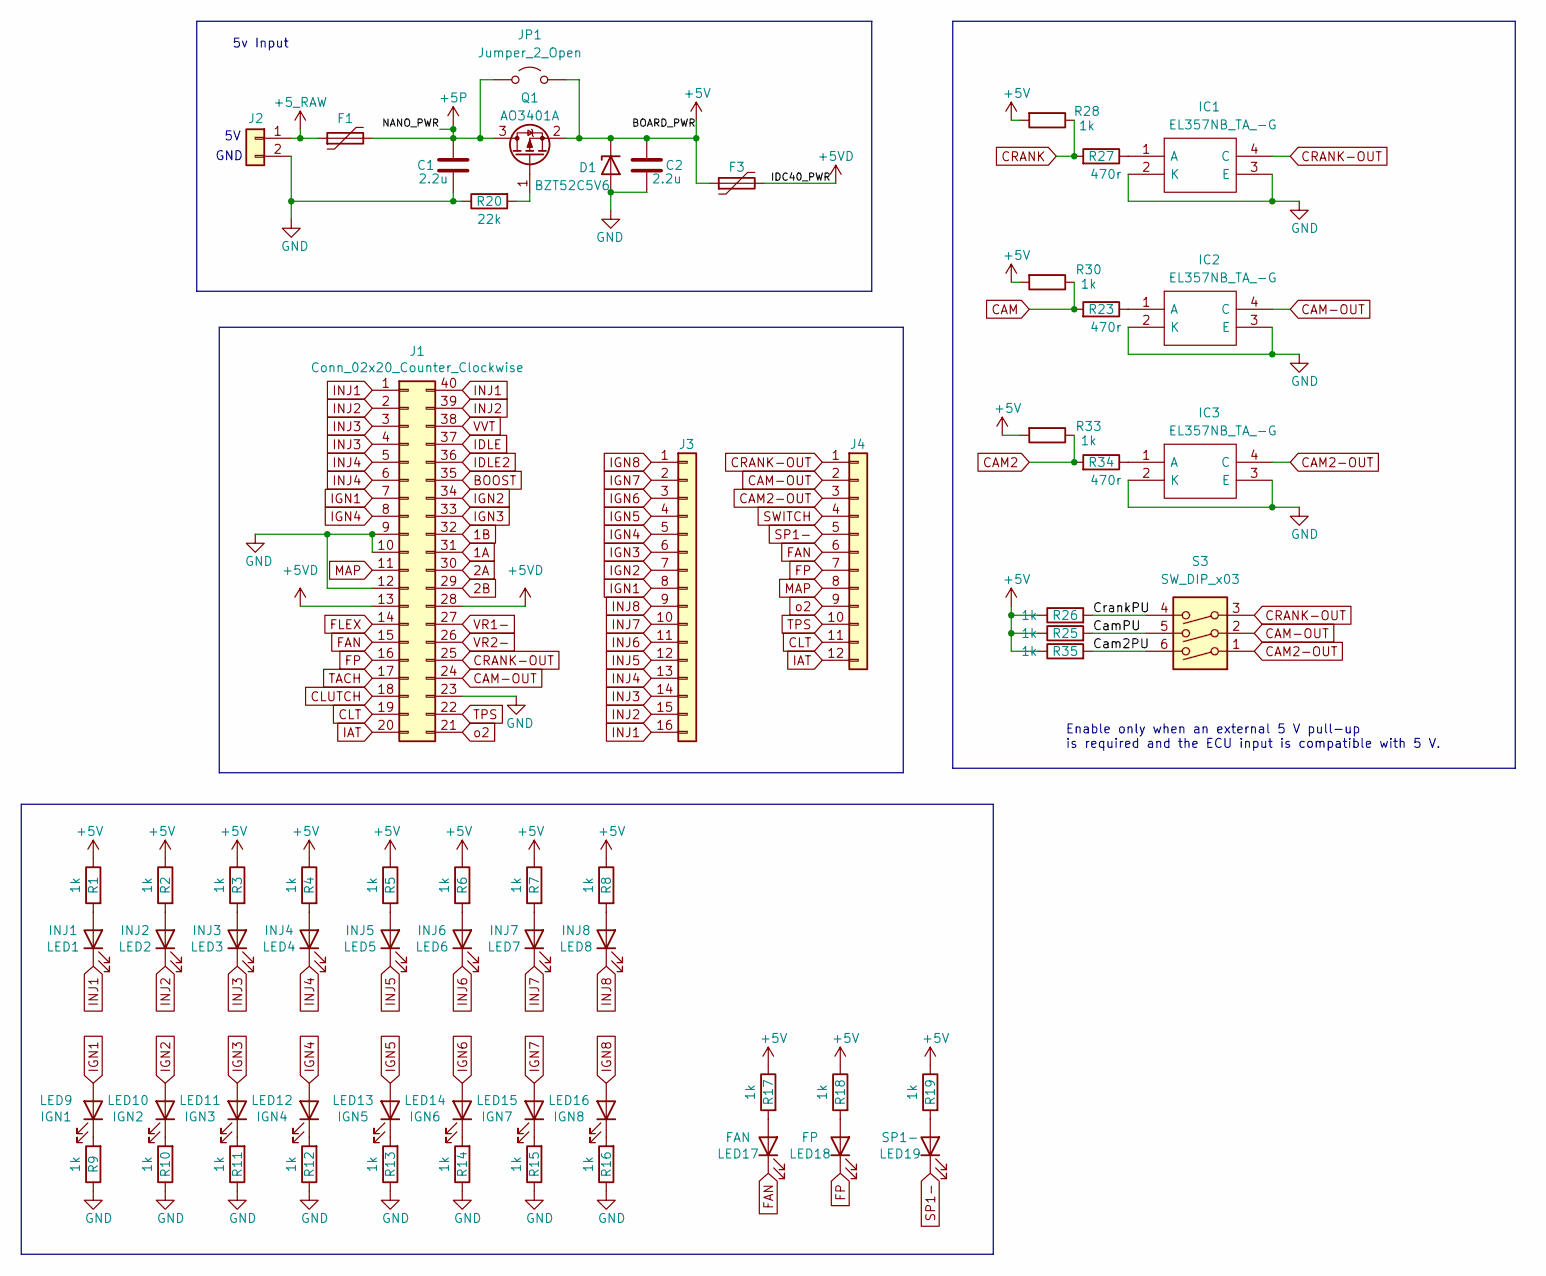
[picture p82: schematic input.kicad_sch, Engine Simulator]

Parts:
C1, C2: 2.2u; C_1206_3216Metric; LCSC C50254
D1: BZT52C5V6; D_SOD-123; LCSC C19077402
F1, F3: 1206L100/24NR; Fuse_1206_3216Metric; LCSC C7542957
IC1, IC2, IC3: EL357NB_TA_-G; SOP-4_3.8x4.1mm_P2.54mm; Manufacturer_Part_Number EL357NB(TA)-G; Mouser Part Number 638-EL357NBTAG
J1: Conn_02x20_Counter_Clockwise; IDC-Header_2x20_P2.54mm_Vertical_Speeduino
J2: Conn_01x04; TerminalBlock_Phoenix_PT-1,5-2-5.0-H_1x02_P5.00mm_Horizontal
J3: Conn_01x08; TerminalBlock_Phoenix_PT-1,5-16-3.5-H_1x16_P3.50mm_Horizont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
J4: Conn_01x10; TerminalBlock_Phoenix_PT-1,5-12-3.5-H_1x12_P3.50mm_Horizont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
JP1: Jumper_2_Open; SolderJumper-2_P1.3mm_Open_Rounded_NOCOURTYARD
LED1: INJ1; LED_0603_1608Metric; LCSC C2286
LED2: INJ2; LED_0603_1608Metric; LCSC C2286
LED3: INJ3; LED_0603_1608Metric; LCSC C2286
LED4: INJ4; LED_0603_1608Metric; LCSC C2286
LED5: INJ5; LED_0603_1608Metric; LCSC C2286
LED6: INJ6; LED_0603_1608Metric; LCSC C2286
LED7: INJ7; LED_0603_1608Metric; LCSC C2286
LED8: INJ8; LED_0603_1608Metric; LCSC C2286
LED9: IGN1; LED_0603_1608Metric; LCSC C2286
LED10: IGN2; LED_0603_1608Metric; LCSC C2286
LED11: IGN3; LED_0603_1608Metric; LCSC C2286
LED12: IGN4; LED_0603_1608Metric; LCSC C2286
LED13: IGN5; LED_0603_1608Metric; LCSC C2286
LED14: IGN6; LED_0603_1608Metric; LCSC C2286
LED15: IGN7; LED_0603_1608Metric; LCSC C2286
LED16: IGN8; LED_0603_1608Metric; LCSC C2286
LED17: FAN; LED_0603_1608Metric; LCSC C2286
LED18: FP; LED_0603_1608Metric; LCSC C2286
LED19: SP1-; LED_0603_1608Metric; LCSC C2286
Q1: AO3401A; SOT-23
R1, R2, R3, R4, R5, R6, R7, R8, R9, R10, R11, R12, R13, R14, R15, R16, R17, R18, R19, R25, R26, R28, R30, R33, R35: 1k; R_0603_1608Metric; LCSC C21190
R20: 22k; R_0805_2012Metric; LCSC C17560
R23, R27, R34: 470r; R_0603_1608Metric; LCSC C23179
S3: SW_DIP_x03; SW_DIP_SPSTx03_Slide_9.78x9.8mm_W7.62mm_P2.54mm

Connections:
1A: J1.31
1B: J1.32
2A: J1.30
2B: J1.29
+5P: C1.1, F1.2, JP1.1 (A), Q1.3 (D); also elsewhere on the board
+5V: C2.1, D1.1 (K), F3.1, JP1.2 (B), Q1.2 (S), R1.1, R2.1, R3.1, R4.1, R5.1, R6.1, R7.1, R8.1, R17.1, R18.1, R19.1, R25.1, R26.1, R28.2, R30.2, R33.2, R35.1; also elsewhere on the board
+5VD: F3.2, J1.13, J1.28
+5_RAW: F1.1, J2.1
/Input & LED's/Cam2PU: R35.2, S3.6
/Input & LED's/CamPU: R25.2, S3.5
/Input & LED's/CrankPU: R26.2, S3.4
BOOST: J1.35
CAM: R23.2, R30.1; also elsewhere on the board
CAM2: R33.1, R34.2; also elsewhere on the board
CAM2-OUT: IC3.4 (C), J4.3, S3.1
CAM-OUT: IC2.4 (C), J1.24, J4.2, S3.2
CLT: J1.19, J4.11; also elsewhere on the board
CLUTCH: J1.18
CRANK: R27.2, R28.1; also elsewhere on the board
CRANK-OUT: IC1.4 (C), J1.25, J4.1, S3.3
FAN: J1.15, J4.6, LED17.1 (K)
FLEX: J1.14
FP: J1.16, J4.7, LED18.1 (K)
GND: C1.2, C2.2, D1.2 (A), IC1.2 (K), IC1.3 (E), IC2.2 (K), IC2.3 (E), IC3.2 (K), IC3.3 (E), J1.9, J1.10, J1.12, J1.23, J2.2, R9.1, R10.1, R11.1, R12.1, R13.1, R14.1, R15.1, R16.1, R20.1; also elsewhere on the board
IAT: J1.20, J4.12; also elsewhere on the board
IDLE: J1.37
IDLE2: J1.36
IGN1: J1.7, J3.8, LED9.2 (A)
IGN2: J1.34, J3.7, LED10.2 (A)
IGN3: J1.33, J3.6, LED11.2 (A)
IGN4: J1.8, J3.5, LED12.2 (A)
IGN5: J3.4, LED13.2 (A)
IGN6: J3.3, LED14.2 (A)
IGN7: J3.2, LED15.2 (A)
IGN8: J3.1, LED16.2 (A)
INJ1: J1.1, J1.40, J3.16, LED1.1 (K)
INJ2: J1.2, J1.39, J3.15, LED2.1 (K)
INJ3: J1.3, J1.4, J3.14, LED3.1 (K)
INJ4: J1.5, J1.6, J3.13, LED4.1 (K)
INJ5: J3.12, LED5.1 (K)
INJ6: J3.11, LED6.1 (K)
INJ7: J3.10, LED7.1 (K)
INJ8: J3.9, LED8.1 (K)
MAP: J1.11, J4.8; also elsewhere on the board
unnamed: IC1.1 (A), R27.1
unnamed: IC2.1 (A), R23.1
unnamed: IC3.1 (A), R34.1
unnamed: LED1.2 (A), R1.2
unnamed: LED2.2 (A), R2.2
unnamed: LED3.2 (A), R3.2
unnamed: LED4.2 (A), R4.2
unnamed: LED5.2 (A), R5.2
unnamed: LED6.2 (A), R6.2
unnamed: LED7.2 (A), R7.2
unnamed: LED8.2 (A), R8.2
unnamed: LED9.1 (K), R9.2
unnamed: LED10.1 (K), R10.2
unnamed: LED11.1 (K), R11.2
unnamed: LED12.1 (K), R12.2
unnamed: LED13.1 (K), R13.2
unnamed: LED14.1 (K), R14.2
unnamed: LED15.1 (K), R15.2
unnamed: LED16.1 (K), R16.2
unnamed: LED17.2 (A), R17.2
unnamed: LED18.2 (A), R18.2
unnamed: LED19.2 (A), R19.2
unnamed: Q1.1 (G), R20.2
SP1-: J4.5, LED19.1 (K)
SWITCH: J4.4; also elsewhere on the board
TACH: J1.17
TPS: J1.22, J4.10; also elsewhere on the board
VR1-: J1.27
VR2-: J1.26
VVT: J1.38
o2: J1.21, J4.9; also elsewhere on the board

Notes on the sheet:
Enable only when an external 5 V pull-up is required and the ECU input is compatible with 5 V.
GND
5v Input

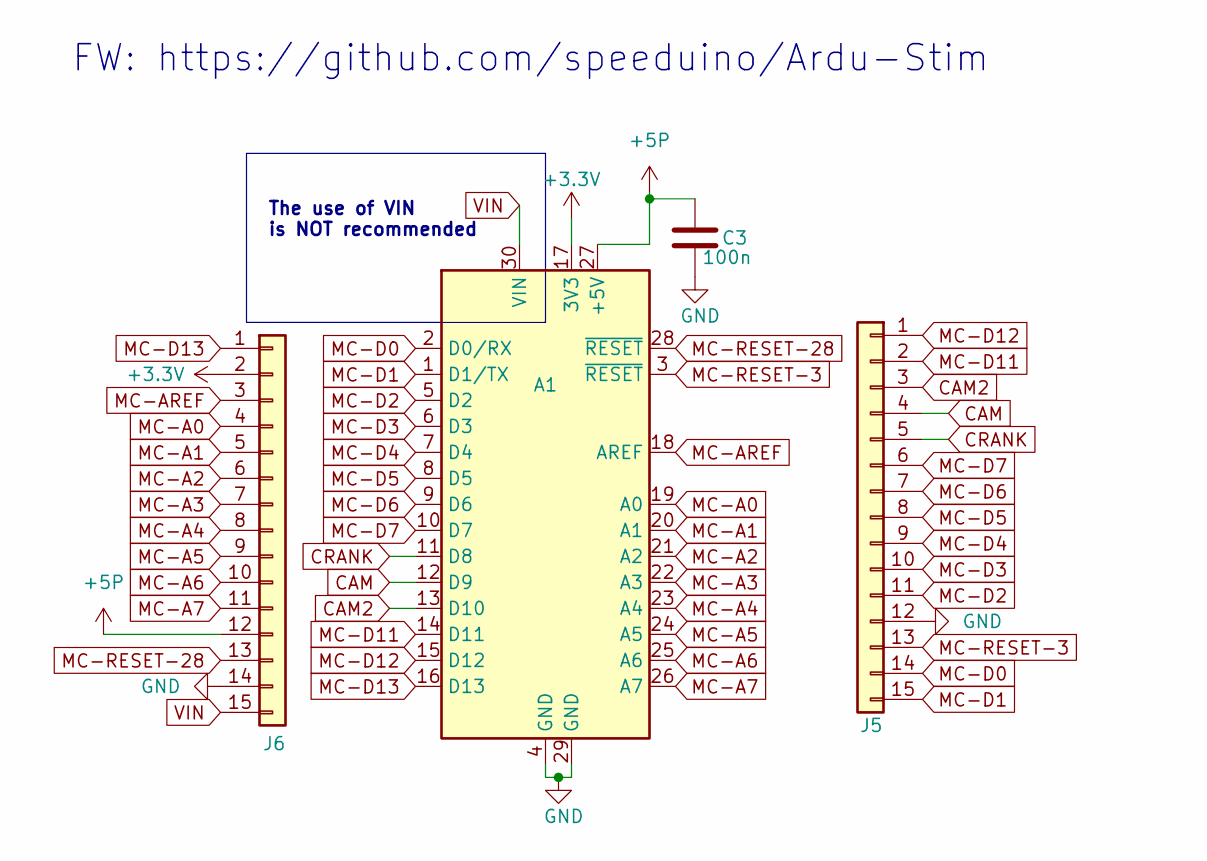
[picture p83: schematic mcu.kicad_sch, Engine Simulator]

Parts:
A1: Arduino_Nano_v3.x; Arduino_Nano
C3: 100n; C_0805_2012Metric; LCSC C49678
J5, J6: Conn_01x04; PinSocket_1x15_P2.54mm_Vertical

Connections:
+3.3V: A1.17 (3V3), J6.2
+5P: A1.27 (+5V), C3.1, J6.12; also elsewhere on the board
CAM: A1.12 (D9), J5.4; also elsewhere on the board
CAM2: A1.13 (D10), J5.3; also elsewhere on the board
CRANK: A1.11 (D8), J5.5; also elsewhere on the board
GND: A1.4 (GND), A1.29 (GND), C3.2, J5.12, J6.14; also elsewhere on the board
MC-A0: A1.19 (A0), J6.4; also elsewhere on the board
MC-A1: A1.20 (A1), J6.5
MC-A2: A1.21 (A2), J6.6
MC-A3: A1.22 (A3), J6.7
MC-A4: A1.23 (A4), J6.8
MC-A5: A1.24 (A5), J6.9
MC-A6: A1.25 (A6), J6.10
MC-A7: A1.26 (A7), J6.11
MC-AREF: A1.18 (AREF), J6.3
MC-D0: A1.2 (D0/RX), J5.14
MC-D1: A1.1 (D1/TX), J5.15
MC-D2: A1.5 (D2), J5.11
MC-D3: A1.6 (D3), J5.10
MC-D4: A1.7 (D4), J5.9
MC-D5: A1.8 (D5), J5.8
MC-D6: A1.9 (D6), J5.7
MC-D7: A1.10 (D7), J5.6
MC-D11: A1.14 (D11), J5.2
MC-D12: A1.15 (D12), J5.1
MC-D13: A1.16 (D13), J6.1
MC-RESET-3: A1.3 (~RESET), J5.13
MC-RESET-28: A1.28 (~RESET), J6.13
VIN: A1.30 (VIN), J6.15

Notes on the sheet:
FW: https://github.com/speeduino/Ardu-Stim
The use of VIN is NOT recommended

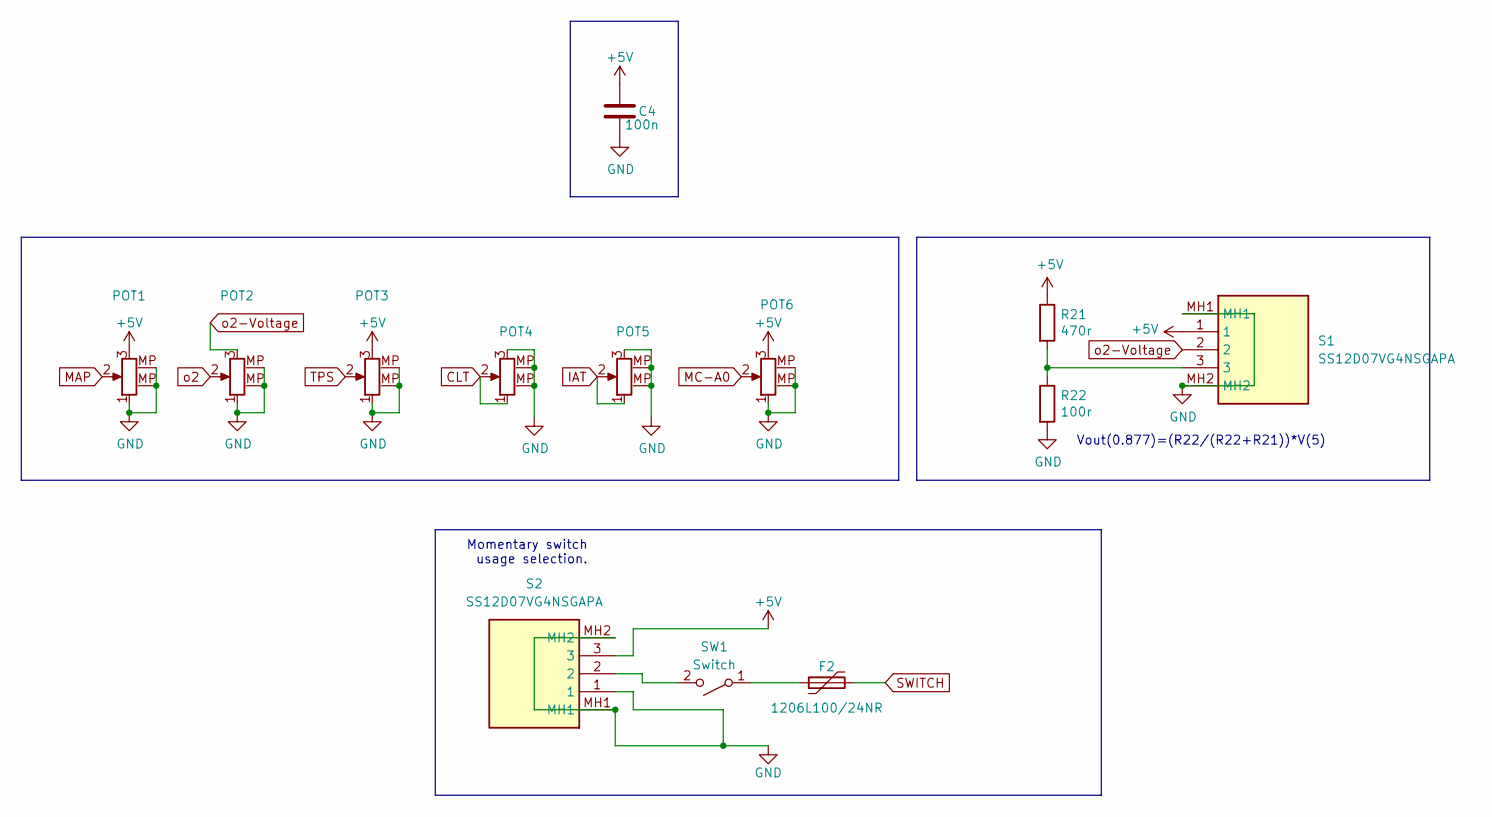
[picture p84: schematic simulation.kicad_sch, Engine Simulator]

Parts:
C4: 100n; C_0805_2012Metric; LCSC C49678
F2: 1206L100/24NR; Fuse_1206_3216Metric; LCSC C7542957
POT1: IAT; Potentiometer_Alps_RK09K_Single_Vertical; LCSC C202373
POT2: CLT; Potentiometer_Alps_RK09K_Single_Vertical; LCSC C202373
POT3: MAP/SP1; Potentiometer_Alps_RK09K_Single_Vertical; LCSC C202373
POT4: TPS; Potentiometer_Alps_RK09K_Single_Vertical; LCSC C202373
POT5: o2; Potentiometer_Alps_RK09K_Single_Vertical; LCSC C202373
POT6: RPM; Potentiometer_Alps_RK09K_Single_Vertical; LCSC C202373
R21: 470r; R_0603_1608Metric; LCSC C23179
R22: 100r; R_0603_1608Metric; LCSC C22775
S1, S2: SS12D07VG4NSGAPA; Manufacturer_Part_Number SS12D07VG4NSGAPA; Mouser Part Number N/A
SW1: Switch; SW_PUSH_6mm_H9.5mm

Connections:
+5V: C4.1, POT1.3, POT3.3, POT6.3, R21.1, S1.1, S2.3; also elsewhere on the board
CLT: POT4.1, POT4.2; also elsewhere on the board
GND: C4.2, POT1.1, POT1.MP (Mounting_Tap), POT2.1, POT2.MP (Mounting_Tap), POT3.1, POT3.MP (Mounting_Tap), POT4.3, POT4.MP (Mounting_Tap), POT5.3, POT5.MP (Mounting_Tap), POT6.1, POT6.MP (Mounting_Tap), R22.2, S1.MH1, S1.MH2, S2.1, S2.MH1, S2.MH2; also elsewhere on the board
IAT: POT5.1, POT5.2; also elsewhere on the board
MAP: POT1.2; also elsewhere on the board
MC-A0: POT6.2; also elsewhere on the board
unnamed: R21.2, R22.1, S1.3
unnamed: F2.1, SW1.1 (A)
unnamed: S2.2, SW1.2 (B)
SWITCH: F2.2; also elsewhere on the board
TPS: POT3.2; also elsewhere on the board
o2: POT2.2; also elsewhere on the board
o2-Voltage: POT2.3, S1.2

Notes on the sheet:
Vout(0.877)=(R22/(R22+R21))*V(5)
Momentary switch usage selection.

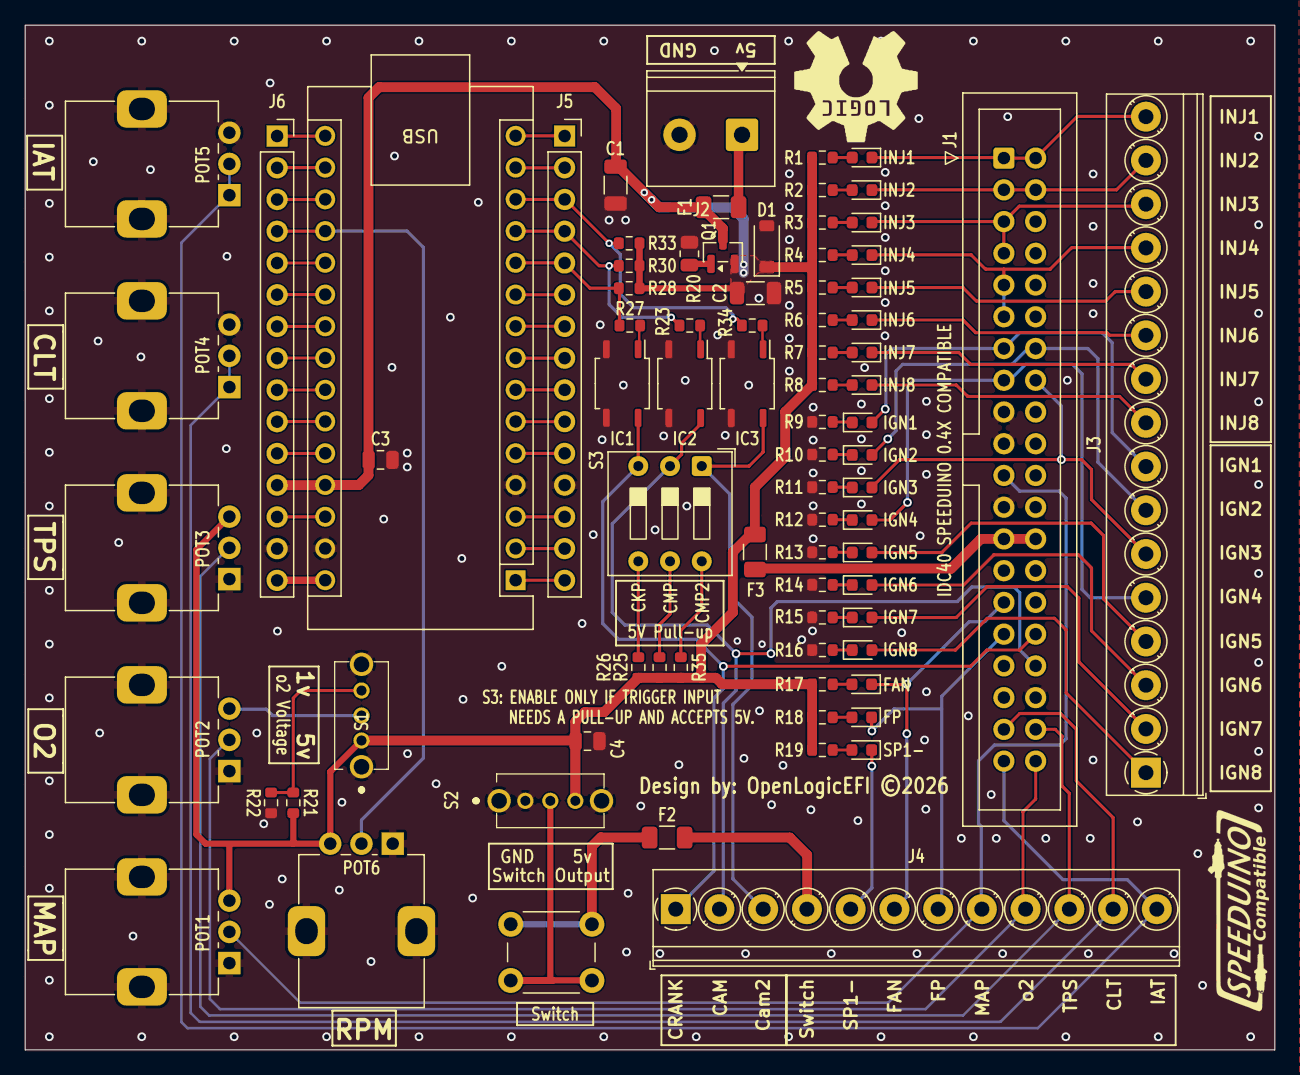
[picture p85: board Engine Simulation/8 Channel/RevD/Simulator.kicad_pcb from above]

Board: 2 copper layers, 100.0 x 82.0 mm, 81 parts (1 on the bottom side), 90 nets.

Other parts of the board:
G2: Logo_Open_Hardware_Small; SpeeduinoCompatible-17mm
