OpenLogicEFI/Hardware/Engine Managment/Spark Gap/Spark Gap X4/RevC2/SparkGapX4.kicad_pcb

## KiCad design Engine Managment/Spark Gap/Spark Gap X4/RevC2/SparkGapX4.kicad_pcb (2026-10-17)

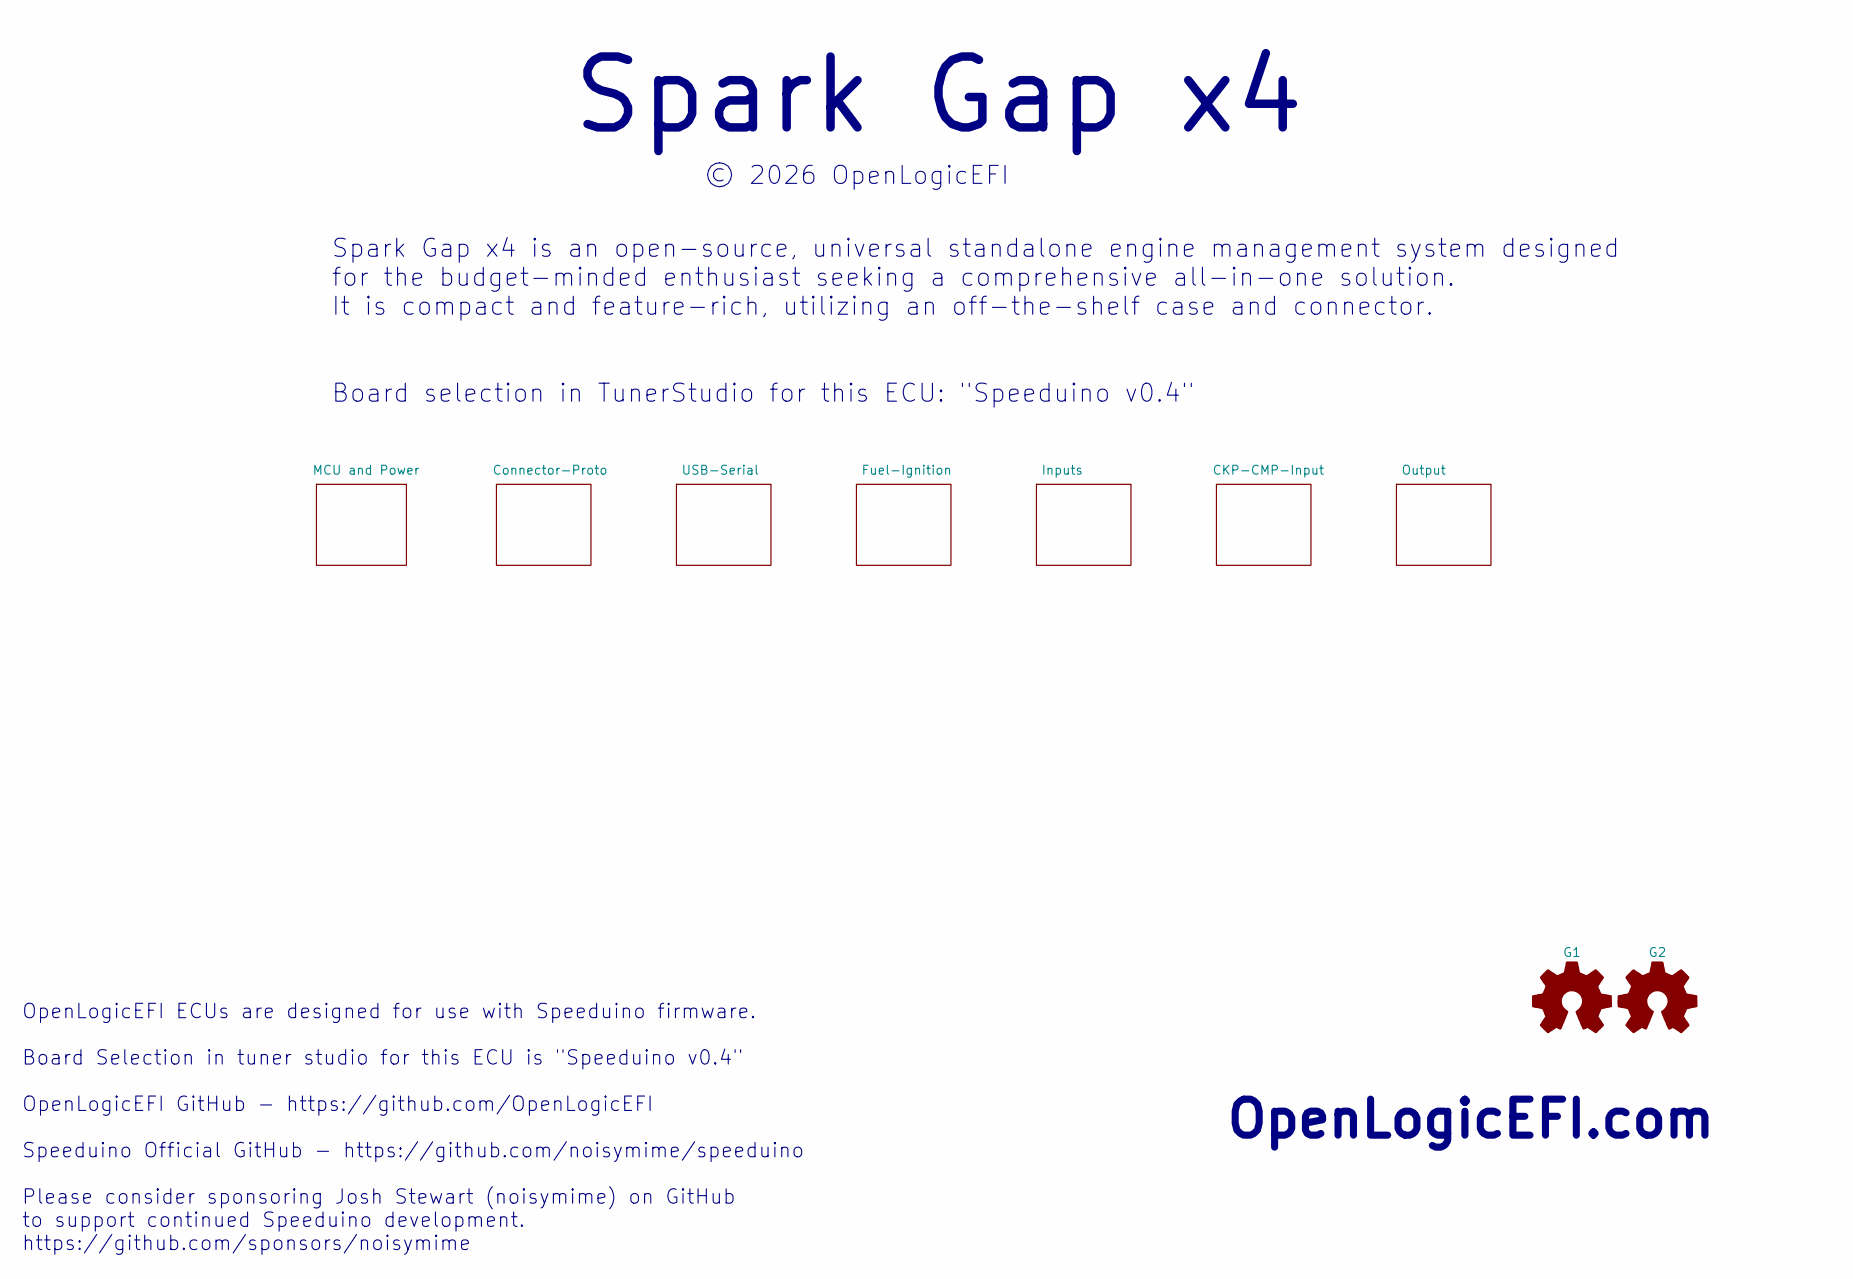
[picture p86: schematic SparkGapX4.kicad_sch, Spark Gap x4]

Parts:
G1: Logo_Open_Hardware_Small; SpeeduinoCompatible-14mm
G2: Logo_Open_Hardware_Small; OSHW-Logo2_7.3x6mm_SilkScreen

Notes on the sheet:
OpenLogicEFI ECUs are designed for use with Speeduino firmware. Board Selection in tuner studio for this ECU is "Speeduino v0.4" OpenLogicEFI GitHub - https://github.com/OpenLogicEFI Speeduino Official GitHub - https://github.com/noisymime/speeduino Please consider sponsoring Josh Stewart (noisymim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
© 2026 OpenLogicEFI
OpenLogicEFI.com
Spark Gap x4 is an open-source, universal standalone engine management system designed for the budget-minded enthusiast seeking a comprehensive all-in-one solution. It is compact and feature-rich, utilizing an off-the-shelf case and connector. Board selection in TunerStudio for this ECU: "Speeduino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
Spark Gap x4

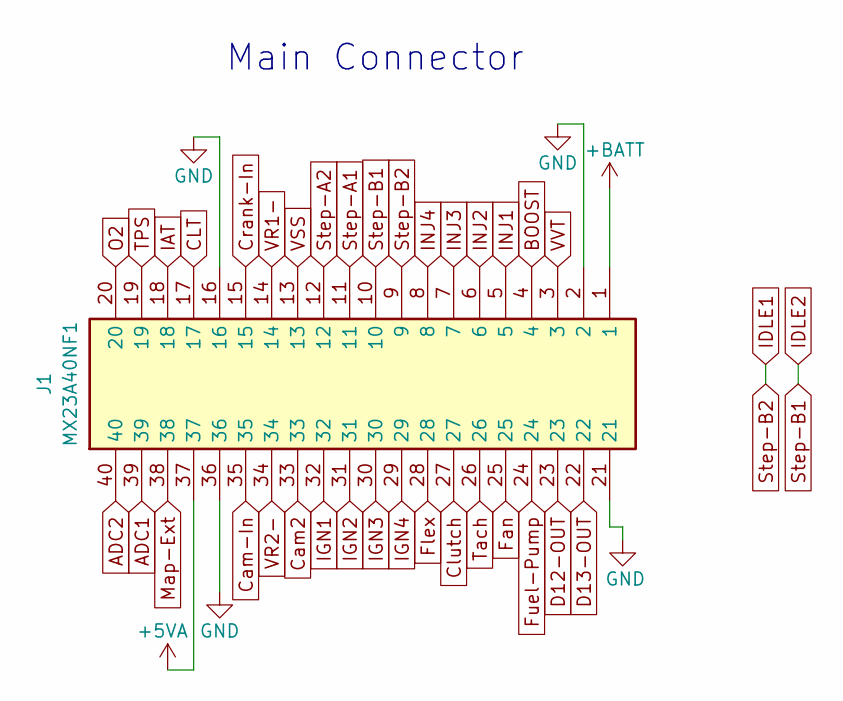
[picture p87: schematic Connector.kicad_sch, Spark Gap x4]

Parts:
J1: MX23A40NF1; Manufacture Part Number MX23A40NF1

Connections:
+5V: J1.37; also elsewhere on the board
+BATT: J1.1; also elsewhere on the board
ADC1: J1.39; also elsewhere on the board
ADC2: J1.40; also elsewhere on the board
BOOST: J1.4; also elsewhere on the board
CLT: J1.17; also elsewhere on the board
Cam2: J1.33; also elsewhere on the board
Cam-In: J1.35; also elsewhere on the board
Clutch: J1.27; also elsewhere on the board
Crank-In: J1.15; also elsewhere on the board
D12-OUT: J1.23; also elsewhere on the board
D13-OUT: J1.22; also elsewhere on the board
Fan: J1.25; also elsewhere on the board
Flex: J1.28; also elsewhere on the board
Fuel-Pump: J1.24; also elsewhere on the board
GND: J1.2, J1.16, J1.21, J1.36; also elsewhere on the board
IAT: J1.18; also elsewhere on the board
IDLE1: J1.9; also elsewhere on the board
IDLE2: J1.10; also elsewhere on the board
IGN1: J1.32; also elsewhere on the board
IGN2: J1.31; also elsewhere on the board
IGN3: J1.30; also elsewhere on the board
IGN4: J1.29; also elsewhere on the board
INJ1: J1.5; also elsewhere on the board
INJ2: J1.6; also elsewhere on the board
INJ3: J1.7; also elsewhere on the board
INJ4: J1.8; also elsewhere on the board
Map-Ext: J1.38; also elsewhere on the board
O2: J1.20; also elsewhere on the board
Step-A1: J1.11; also elsewhere on the board
Step-A2: J1.12; also elsewhere on the board
TPS: J1.19; also elsewhere on the board
Tach: J1.26; also elsewhere on the board
VR1-: J1.14; also elsewhere on the board
VR2-: J1.34; also elsewhere on the board
VSS: J1.13; also elsewhere on the board
VVT: J1.3; also elsewhere on the board

Notes on the sheet:
Main Connector

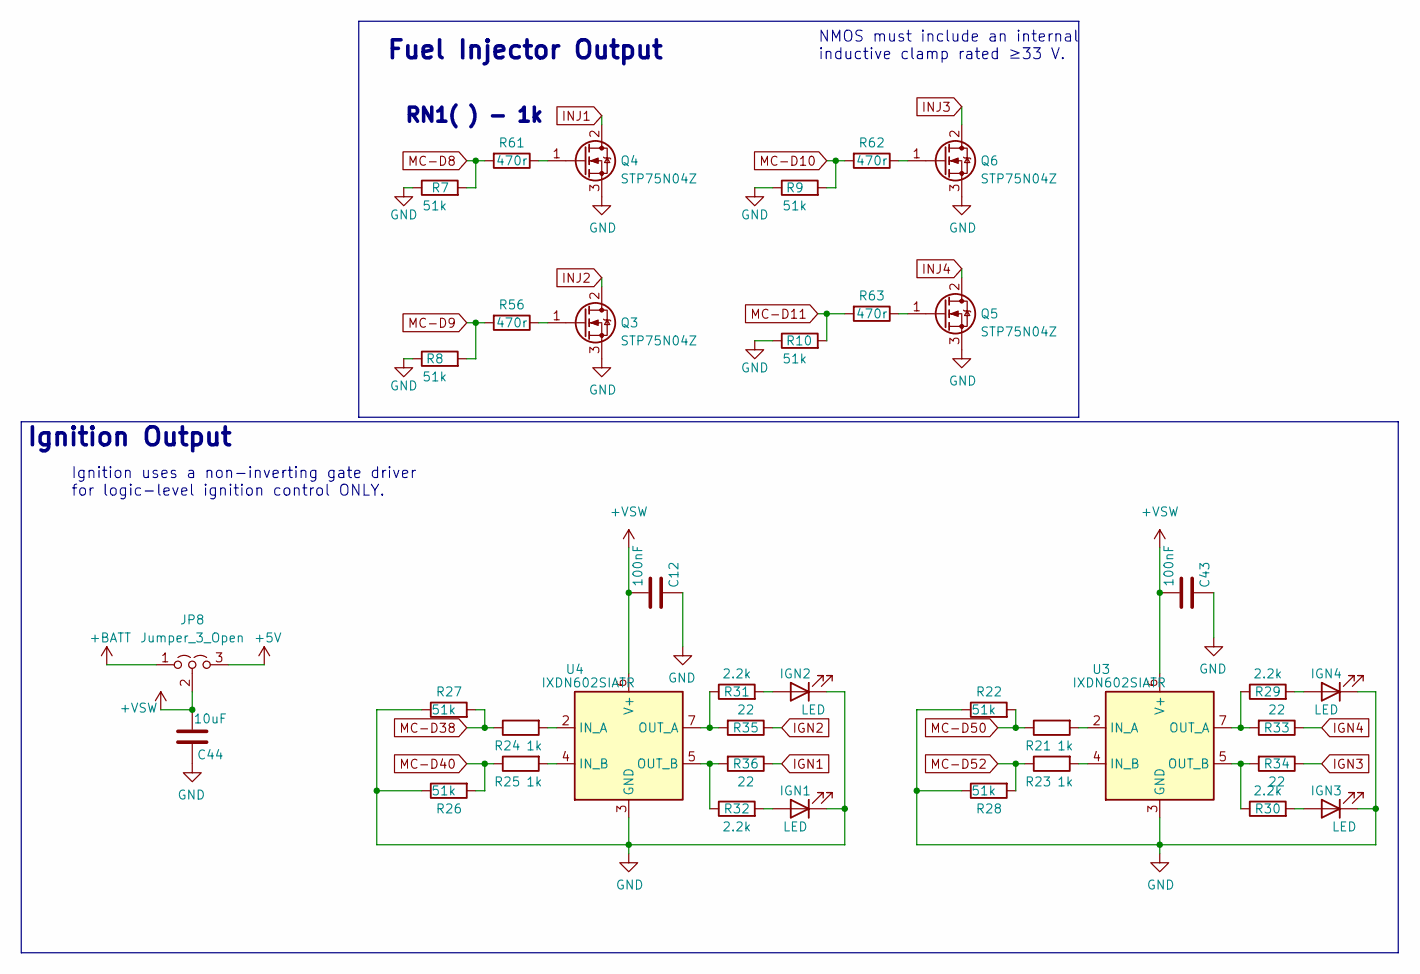
[picture p88: schematic Fuel-Ignition.kicad_sch, Spark Gap x4]

Parts:
C12, C43: 100nF; C_0402_1005Metric; Manufacture Part Number CL05B104KB54PNC; LCSC C307331
C44: 10uF; C_0805_2012Metric; Manufacture Part Number GRM21BR61H106KE43L; LCSC C440198
IGN1, IGN2, IGN3, IGN4: LED; LED_0603_1608Metric; Manufacture Part Number KT-0603R; LCSC C2286
JP8: Jumper_3_Open; 1x03-Proto
Q3, Q4, Q5, Q6: STP75N04Z; TO-220-3_Vertical; Manufacture Part Number STP75N04Z
R7, R8, R9, R10, R22, R26, R27, R28: 51k; R_0402_1005Metric; Manufacture Part Number 0402WGF5102TCE; LCSC C25794
R21, R23, R24, R25: 1k; R_0402_1005Metric; Manufacture Part Number 0402WGF1001TCE; LCSC C11702
R29, R30, R31, R32: 2.2k; R_0402_1005Metric; Manufacture Part Number 0402WGF2201TCE; LCSC C25879
R33, R34, R35, R36: 22; R_0805_2012Metric; Manufacture Part Number 0805W8F220JT5E; LCSC C17561
R56, R61, R62, R63: 470r; R_0402_1005Metric; Manufacture Part Number 0402WGF4700TCE; LCSC C25117
U3, U4: IXDN602SIATR; SOIC-8_3.9x4.9mm_P1.27mm; Manufacture Part Number IXDN602SIATR; LCSC C431679

Connections:
+5V: JP8.3 (B); also elsewhere on the board
+BATT: JP8.1 (A); also elsewhere on the board
+VSW: C12.1, C43.1, C44.1, JP8.2 (C), U3.6 (V+), U4.6 (V+)
GND: C12.2, C43.2, C44.2, IGN1.1 (K), IGN2.1 (K), IGN3.1 (K), IGN4.1 (K), Q3.3 (S), Q4.3 (S), Q5.3 (S), Q6.3 (S), R7.1, R8.1, R9.1, R10.1, R22.1, R26.1, R27.1, R28.1, U3.3 (GND), U4.3 (GND); also elsewhere on the board
IGN1: R36.1; also elsewhere on the board
IGN2: R35.1; also elsewhere on the board
IGN3: R34.1; also elsewhere on the board
IGN4: R33.1; also elsewhere on the board
INJ1: Q4.2 (D); also elsewhere on the board
INJ2: Q3.2 (D); also elsewhere on the board
INJ3: Q6.2 (D); also elsewhere on the board
INJ4: Q5.2 (D); also elsewhere on the board
MC-D8: R7.2, R61.2; also elsewhere on the board
MC-D9: R8.2, R56.2; also elsewhere on the board
MC-D10: R9.2, R62.2; also elsewhere on the board
MC-D11: R10.2, R63.2; also elsewhere on the board
MC-D38: R24.1, R27.2; also elsewhere on the board
MC-D40: R25.1, R26.2; also elsewhere on the board
MC-D50: R21.1, R22.2; also elsewhere on the board
MC-D52: R23.1, R28.2; also elsewhere on the board
unnamed: IGN1.2 (A), R32.2
unnamed: IGN2.2 (A), R31.2
unnamed: IGN3.2 (A), R30.2
unnamed: IGN4.2 (A), R29.2
unnamed: Q3.1 (G), R56.1
unnamed: Q4.1 (G), R61.1
unnamed: Q5.1 (G), R63.1
unnamed: Q6.1 (G), R62.1
unnamed: R21.2, U3.2 (IN_A)
unnamed: R23.2, U3.4 (IN_B)
unnamed: R29.1, R33.2, U3.7 (OUT_A)
unnamed: R30.1, R34.2, U3.5 (OUT_B)
unnamed: R24.2, U4.2 (IN_A)
unnamed: R25.2, U4.4 (IN_B)
unnamed: R31.1, R35.2, U4.7 (OUT_A)
unnamed: R32.1, R36.2, U4.5 (OUT_B)

Notes on the sheet:
Fuel Injector Output
RN1( ) - 1k
NMOS must include an internal inductive clamp rated ≥33 V.
Ignition Output
Ignition uses a non-inverting gate driver for logic-level ignition control ONLY.

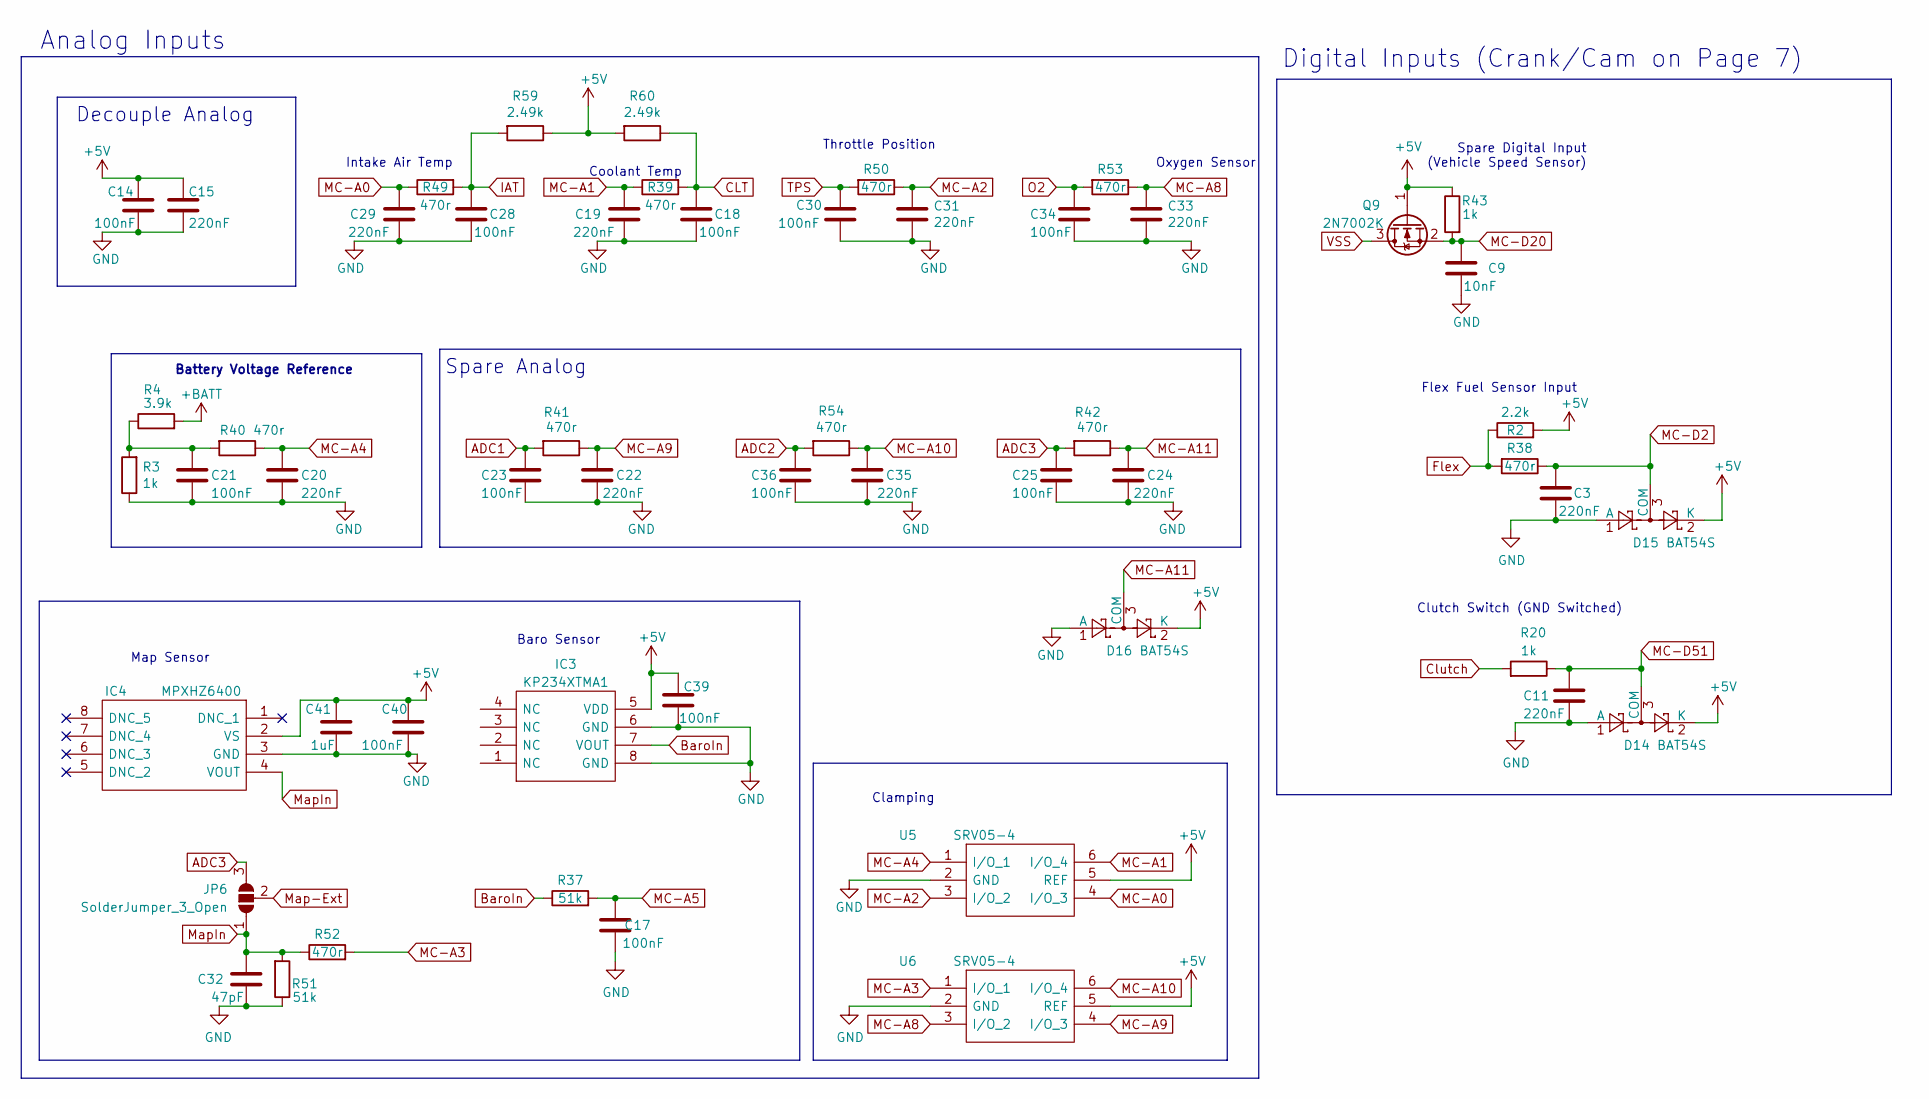
[picture p89: schematic input.kicad_sch, Spark Gap x4]

Parts:
C3, C11, C15, C19, C20, C22, C24, C29, C31, C33, C35: 220nF; C_0402_1005Metric; Manufacture Part Number CL05B224KO5NNNC; LCSC C16772
C9: 10nF; C_0402_1005Metric; Manufacture Part Number CL05B103KB5NNNC; LCSC C15195
C14, C17, C18, C21, C23, C25, C28, C30, C34, C36, C39, C40: 100nF; C_0402_1005Metric; Manufacture Part Number CL05B104KB54PNC; LCSC C307331
C32: 47pF; C_0402_1005Metric; Manufacture Part Number 0402CG470J500NT; LCSC C1567
C41: 1uF; C_0402_1005Metric; Manufacture Part Number CL05A105KA5NQNC; LCSC C52923
D14, D15, D16: BAT54S; SOT-23; Manufacture Part Number BAT54S; LCSC C7420333
IC3: KP234XTMA1; KP234-Handsoldering
IC4: MPXHZ6400; MPXHxxx_Handsoldering
JP6: SolderJumper_3_Open; SolderJumper-3-OPEN
Q9: 2N7002K; SOT-23; LCSC C22379475
R2: 2.2k; R_0402_1005Metric; Manufacture Part Number 0402WGF2201TCE; LCSC C25879
R3: 1k; R_0603_1608Metric; Manufacture Part Number 0603WAF1001T5E; LCSC C21190
R4: 3.9k; R_0603_1608Metric; Manufacture Part Number 0603WAF3901T5E; LCSC C23018
R20, R43: 1k; R_0402_1005Metric; Manufacture Part Number 0402WGF1001TCE; LCSC C11702
R37, R51: 51k; R_0402_1005Metric; Manufacture Part Number 0402WGF5102TCE; LCSC C25794
R38, R39, R40, R41, R42, R49, R50, R52, R53, R54: 470r; R_0402_1005Metric; Manufacture Part Number 0402WGF4700TCE; LCSC C25117
R59, R60: 2.49k; R_Axial_DIN0207_L6.3mm_D2.5mm_P7.62mm_Horizontal
U5, U6: SRV05-4; SOT-23-6; LCSC C2836319

Connections:
+5V: C14.1, C15.1, C39.1, C40.1, C41.1, D14.2 (K), D15.2 (K), D16.2 (K), IC3.5 (VDD), IC4.2 (VS), Q9.1 (G), R2.2, R43.1, R59.1, R60.2, U5.5 (REF), U6.5 (REF); also elsewhere on the board
+BATT: R4.2; also elsewhere on the board
ADC1: C23.1, R41.2; also elsewhere on the board
ADC2: C36.1, R54.2; also elsewhere on the board
ADC3: C25.1, JP6.3 (B), R42.2
BaroIn: IC3.7 (VOUT), R37.1
CLT: C18.1, R39.2, R60.1; also elsewhere on the board
Clutch: R20.2; also elsewhere on the board
Flex: R2.1, R38.2; also elsewhere on the board
GND: C3.2, C9.2, C11.2, C14.2, C15.2, C17.2, C18.2, C19.2, C20.2, C21.2, C22.2, C23.2, C24.2, C25.2, C28.2, C29.2, C30.2, C31.2, C32.2, C33.2, C34.2, C35.2, C36.2, C39.2, C40.2, C41.2, D14.1 (A), D15.1 (A), D16.1 (A), IC3.6 (GND), IC3.8 (GND), IC4.3 (GND), R3.1, R51.1, U5.2 (GND), U6.2 (GND); also elsewhere on the board
IAT: C28.1, R49.2, R59.2; also elsewhere on the board
MC-A0: C29.1, R49.1, U5.4 (I/O_3); also elsewhere on the board
MC-A1: C19.1, R39.1, U5.6 (I/O_4); also elsewhere on the board
MC-A2: C31.1, R50.1, U5.3 (I/O_2); also elsewhere on the board
MC-A3: R52.2, U6.1 (I/O_1); also elsewhere on the board
MC-A4: C20.1, R40.1, U5.1 (I/O_1); also elsewhere on the board
MC-A5: C17.1, R37.2; also elsewhere on the board
MC-A8: C33.1, R53.1, U6.3 (I/O_2); also elsewhere on the board
MC-A9: C22.1, R41.1, U6.4 (I/O_3); also elsewhere on the board
MC-A10: C35.1, R54.1, U6.6 (I/O_4); also elsewhere on the board
MC-A11: C24.1, D16.3 (COM), R42.1; also elsewhere on the board
MC-D2: C3.1, D15.3 (COM), R38.1; also elsewhere on the board
MC-D20: C9.1, Q9.2 (S), R43.2; also elsewhere on the board
MC-D51: C11.1, D14.3 (COM), R20.1; also elsewhere on the board
Map-Ext: JP6.2 (C); also elsewhere on the board
MapIn: C32.1, IC4.4 (VOUT), JP6.1 (A), R51.2, R52.1
unnamed: C21.1, R3.2, R4.1, R40.2
O2: C34.1, R53.2; also elsewhere on the board
TPS: C30.1, R50.2; also elsewhere on the board
VSS: Q9.3 (D); also elsewhere on the board

Notes on the sheet:
Map Sensor
Clutch Switch (GND Switched)
Analog Inputs
Throttle Position
Spare Digital Input (Vehicle Speed Sensor)
Oxygen Sensor
Digital Inputs (Crank/Cam on Page 7)
Coolant Temp
Intake Air Temp
Baro Sensor
Battery Voltage Reference
Spare Analog
Flex Fuel Sensor Input
Decouple Analog
Clamping
