OpenLogicEFI/Hardware/Engine Managment/Spark Gap/Spark Gap X4/RevC2/SparkGapX4.kicad_pcb

## KiCad design Engine Managment/Spark Gap/Spark Gap X4/RevC2/SparkGapX4.kicad_pcb (continued)

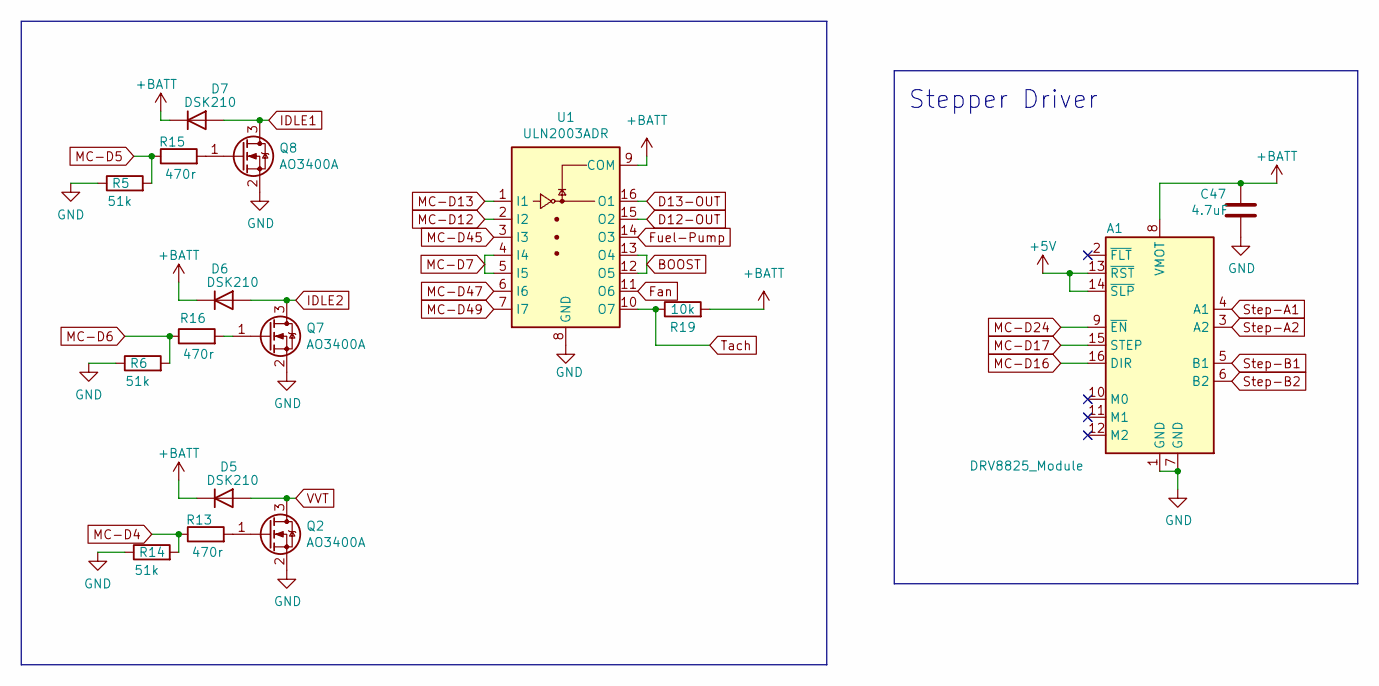
[picture p90: schematic Output.kicad_sch, Spark Gap x4]

Parts:
A1: DRV8825_Module; DVR8825-Labeled-Front
C47: 4.7uF; C_1206_3216Metric; Manufacture Part Number 1206B475K500NT; LCSC C29823
D5, D6, D7: DSK210; D_SOD-123F; Manufacture Part Number DSK210; LCSC C7502713
Q2, Q7, Q8: AO3400A; SOT-23; LCSC C20917
R5, R6, R14: 51k; R_0402_1005Metric; Manufacture Part Number 0402WGF5102TCE; LCSC C25794
R13, R15, R16: 470r; R_0402_1005Metric; Manufacture Part Number 0402WGF4700TCE; LCSC C25117
R19: 10k; R_0402_1005Metric; Manufacture Part Number 0402WGF1002TCE; LCSC C25744
U1: ULN2003ADR; SOIC-16_3.9x9.9mm_P1.27mm; Manufacture Part Number ULN2003ADR; LCSC C7512

Connections:
+5V: A1.13 (~RST), A1.14 (~SLP); also elsewhere on the board
+BATT: A1.8 (VMOT), C47.1, D5.1 (K), D6.1 (K), D7.1 (K), R19.2, U1.9 (COM); also elsewhere on the board
BOOST: U1.12 (O5), U1.13 (O4); also elsewhere on the board
D12-OUT: U1.15 (O2); also elsewhere on the board
D13-OUT: U1.16 (O1); also elsewhere on the board
Fan: U1.11 (O6); also elsewhere on the board
Fuel-Pump: U1.14 (O3); also elsewhere on the board
GND: A1.1 (GND), A1.7 (GND), C47.2, Q2.2 (S), Q7.2 (S), Q8.2 (S), R5.1, R6.1, R14.1, U1.8 (GND); also elsewhere on the board
IDLE1: A1.6 (B2), D7.2 (A), Q8.3 (D); also elsewhere on the board
IDLE2: A1.5 (B1), D6.2 (A), Q7.3 (D); also elsewhere on the board
MC-D4: R13.1, R14.2; also elsewhere on the board
MC-D5: R5.2, R15.1; also elsewhere on the board
MC-D6: R6.2, R16.1; also elsewhere on the board
MC-D7: U1.4 (I4), U1.5 (I5); also elsewhere on the board
MC-D12: U1.2 (I2); also elsewhere on the board
MC-D13: U1.1 (I1); also elsewhere on the board
MC-D16: A1.16 (DIR); also elsewhere on the board
MC-D17: A1.15 (STEP); also elsewhere on the board
MC-D24: A1.9 (~EN); also elsewhere on the board
MC-D45: U1.3 (I3); also elsewhere on the board
MC-D47: U1.6 (I6); also elsewhere on the board
MC-D49: U1.7 (I7); also elsewhere on the board
unnamed: Q2.1 (G), R13.2
unnamed: Q7.1 (G), R16.2
unnamed: Q8.1 (G), R15.2
Step-A1: A1.4 (A1); also elsewhere on the board
Step-A2: A1.3 (A2); also elsewhere on the board
Tach: R19.1, U1.10 (O7); also elsewhere on the board
VVT: D5.2 (A), Q2.3 (D); also elsewhere on the board

Notes on the sheet:
Stepper Driver

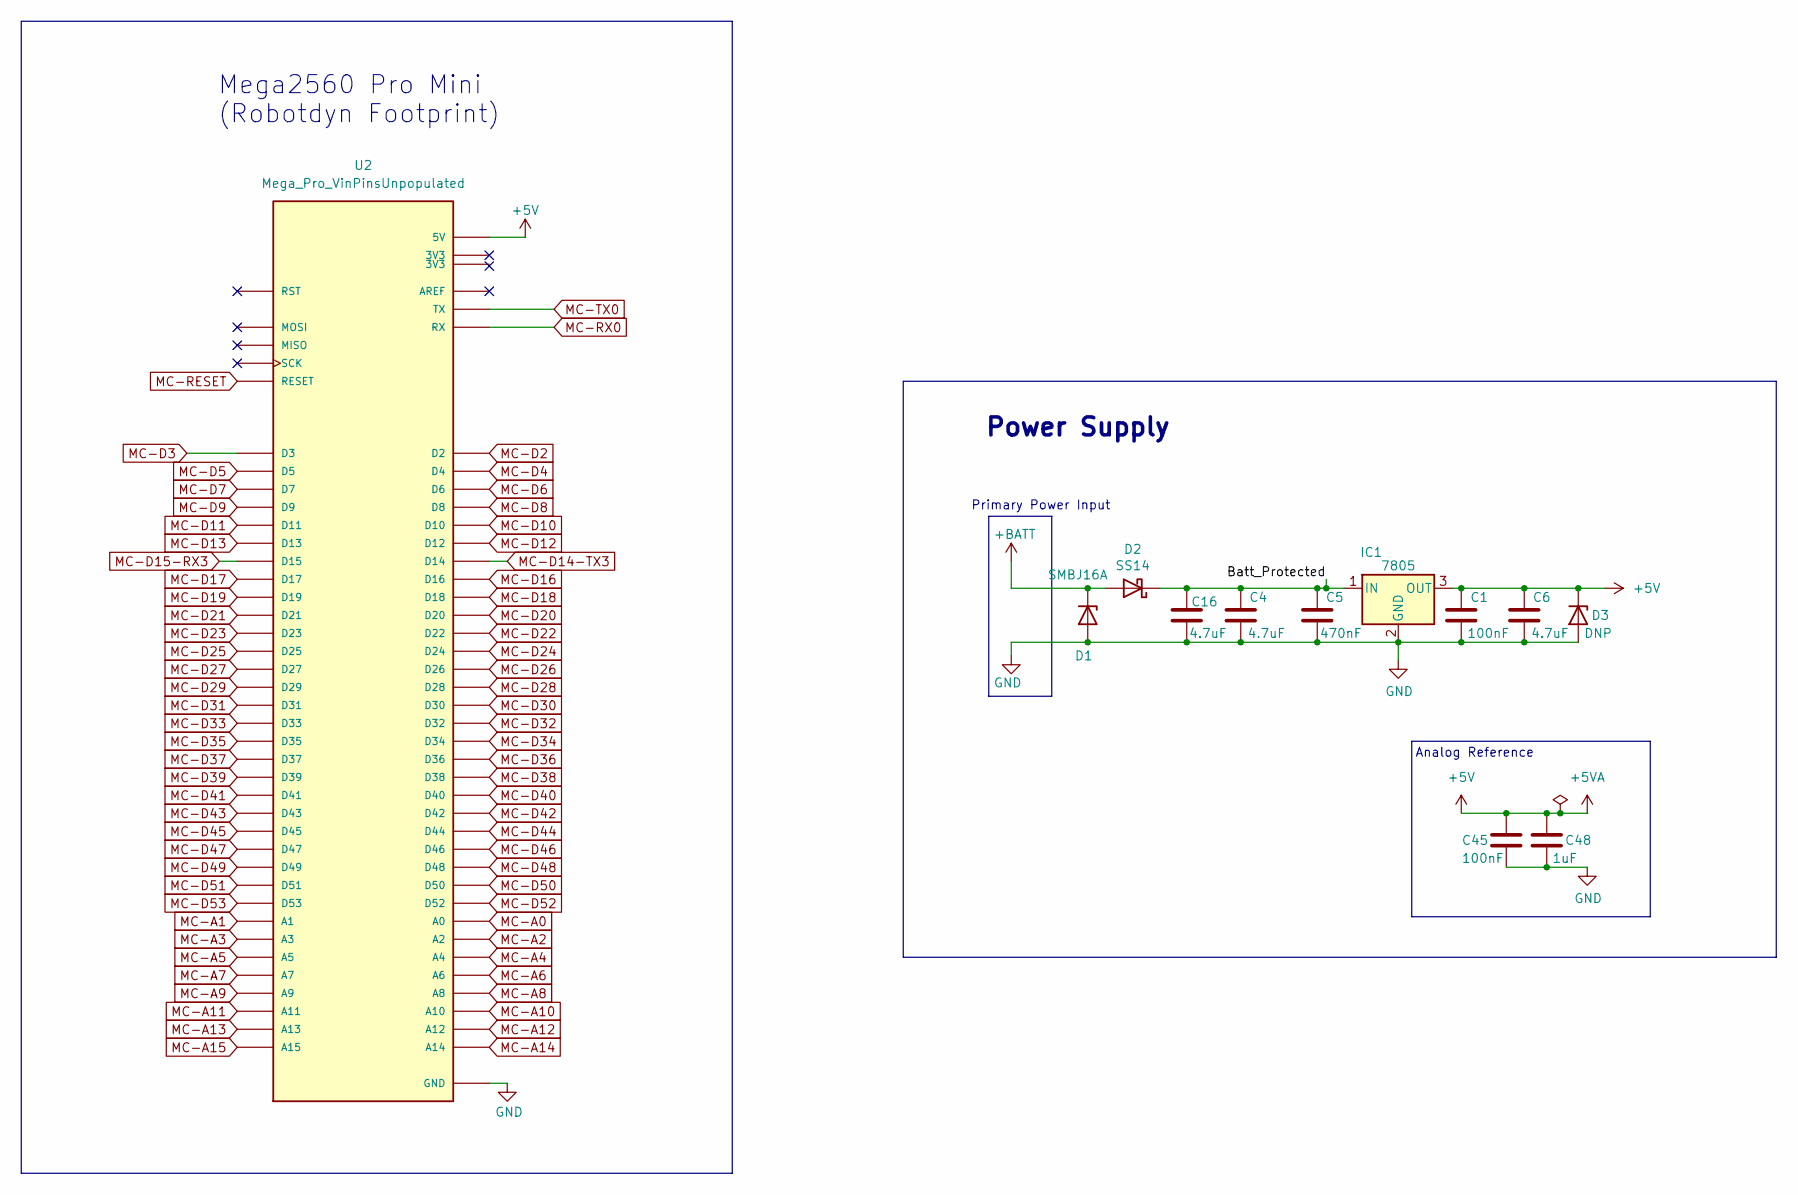
[picture p91: schematic MCU-Power.kicad_sch, Spark Gap x4]

Parts:
C1, C45: 100nF; C_0402_1005Metric; Manufacture Part Number CL05B104KB54PNC; LCSC C307331
C4, C6, C16: 4.7uF; C_1206_3216Metric; Manufacture Part Number 1206B475K500NT; LCSC C29823
C5: 470nF; C_0805_2012Metric; Manufacture Part Number CL21B474KBFNNNE; LCSC C13967
C48: 1uF; C_0402_1005Metric; Manufacture Part Number CL05A105KA5NQNC; LCSC C52923
D1: SMBJ16A; D_SMB; Manufacture Part Number SMBJ16A; LCSC C19077571
D2: SS14; D_SMA; Manufacture Part Number SS14; LCSC C2480
D3: DNP; D_SOD-323; Manufacture Part Number MMSZ5232BS; LCSC C22395563
IC1: 7805; TO-220-3_Vertical_SmallCrtYrd
U2: Mega_Pro_VinPinsUnpopulated; Arduino_Mega_Mini_2560_SmallCrtYd_NoVin

Connections:
+5V: C1.1, C6.1, C45.1, C48.1, D3.1 (K), IC1.3 (OUT), U2.5V_1 (5V), U2.5V_2 (5V), U2.5V_3 (5V); also elsewhere on the board
+BATT: D1.1 (K), D2.2 (A); also elsewhere on the board
/MCU and Power/Batt_Protected: C4.1, C5.1, C16.1, D2.1 (K), IC1.1 (IN)
GND: C1.2, C4.2, C5.2, C6.2, C16.2, C45.2, C48.2, D1.2 (A), D3.2 (A), IC1.2 (GND), U2.GND_1 (GND), U2.GND_2 (GND), U2.GND_3 (GND); also elsewhere on the board
MC-A0: U2.A0; also elsewhere on the board
MC-A1: U2.A1; also elsewhere on the board
MC-A2: U2.A2; also elsewhere on the board
MC-A3: U2.A3; also elsewhere on the board
MC-A4: U2.A4; also elsewhere on the board
MC-A5: U2.A5; also elsewhere on the board
MC-A6: U2.A6
MC-A7: U2.A7
MC-A8: U2.A8; also elsewhere on the board
MC-A9: U2.A9; also elsewhere on the board
MC-A10: U2.A10; also elsewhere on the board
MC-A11: U2.A11; also elsewhere on the board
MC-A12: U2.A12
MC-A13: U2.A13
MC-A14: U2.A14
MC-A15: U2.A15
MC-D2: U2.D2; also elsewhere on the board
MC-D3: U2.D3; also elsewhere on the board
MC-D4: U2.D4; also elsewhere on the board
MC-D5: U2.D5; also elsewhere on the board
MC-D6: U2.D6; also elsewhere on the board
MC-D7: U2.D7; also elsewhere on the board
MC-D8: U2.D8; also elsewhere on the board
MC-D9: U2.D9; also elsewhere on the board
MC-D10: U2.D10; also elsewhere on the board
MC-D11: U2.D11; also elsewhere on the board
MC-D12: U2.D12; also elsewhere on the board
MC-D13: U2.D13; also elsewhere on the board
MC-D14-TX3: U2.D14; also elsewhere on the board
MC-D15-RX3: U2.D15; also elsewhere on the board
MC-D16: U2.D16; also elsewhere on the board
MC-D17: U2.D17; also elsewhere on the board
MC-D18: U2.D18; also elsewhere on the board
MC-D19: U2.D19; also elsewhere on the board
MC-D20: U2.D20; also elsewhere on the board
MC-D21: U2.D21
MC-D22: U2.D22
MC-D23: U2.D23
MC-D24: U2.D24; also elsewhere on the board
MC-D25: U2.D25
MC-D26: U2.D26
MC-D27: U2.D27
MC-D28: U2.D28
MC-D29: U2.D29
MC-D30: U2.D30
MC-D31: U2.D31
MC-D32: U2.D32
MC-D33: U2.D33
MC-D34: U2.D34
MC-D35: U2.D35
MC-D36: U2.D36
MC-D37: U2.D37
MC-D38: U2.D38; also elsewhere on the board
MC-D39: U2.D39
MC-D40: U2.D40; also elsewhere on the board
MC-D41: U2.D41
MC-D42: U2.D42
MC-D43: U2.D43
MC-D44: U2.D44
MC-D45: U2.D45; also elsewhere on the board
MC-D46: U2.D46
MC-D47: U2.D47; also elsewhere on the board
MC-D48: U2.D48
MC-D49: U2.D49; also elsewhere on the board
MC-D50: U2.D50; also elsewhere on the board
MC-D51: U2.D51; also elsewhere on the board
MC-D52: U2.D52; also elsewhere on the board
MC-D53: U2.D53
MC-RESET: U2.RESET; also elsewhere on the board
MC-RX0: U2.RX; also elsewhere on the board
MC-TX0: U2.TX; also elsewhere on the board

Notes on the sheet:
Primary Power Input
Power Supply
Analog Reference
Mega2560 Pro Mini (Robotdyn Footprint)

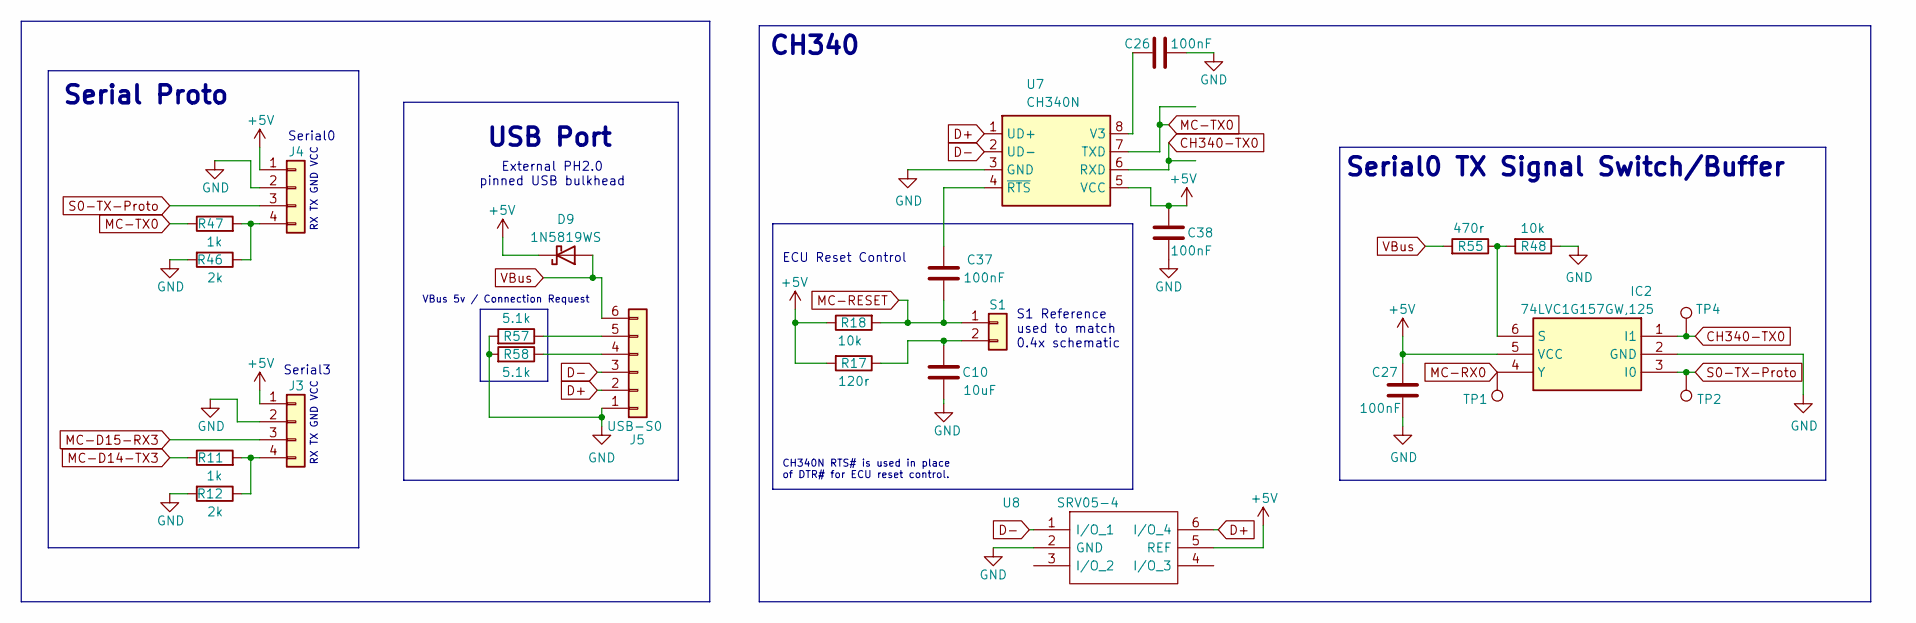
[picture p92: schematic serial.kicad_sch, Spark Gap x4]

Parts:
C10: 10uF; C_0603_1608Metric; Manufacture Part Number CL10A106KP8NNNC; LCSC C19702
C26, C27, C37, C38: 100nF; C_0402_1005Metric; Manufacture Part Number CL05B104KB54PNC; LCSC C307331
D9: 1N5819WS; D_SOD-323; Manufacture Part Number 1N5819WS; LCSC C7420326
IC2: 74LVC1G157GW,125; SOP65P210X110-6N; Manufacture Part Number 74LVC1G157GW,125; LCSC C135822
J3, J4: Conn_01x04; 1X4-PROTO-NoSilk
J5: USB-S0; JST_PH_B6B-PH-K_1x06_P2.00mm_Vertical
R11, R47: 1k; R_0402_1005Metric; Manufacture Part Number 0402WGF1001TCE; LCSC C11702
R12, R46: 2k; R_0402_1005Metric; Manufacture Part Number 0402WGF2001TCE; LCSC C4109
R17: 120r; R_0603_1608Metric; Manufacture Part Number 0402WGF4700TCE; LCSC C22787
R18, R48: 10k; R_0402_1005Metric; Manufacture Part Number 0402WGF1002TCE; LCSC C25744
R55: 470r; R_0402_1005Metric; Manufacture Part Number 0402WGF4700TCE; LCSC C25117
R57, R58: 5.1k; R_0402_1005Metric; Manufacture Part Number 0402WGF5101TCE; LCSC C25905
S1: Reset Control; PinHeader_1x02_P2.54mm_Horizontal
TP1, TP2, TP4: TestPoint; TestPoint_THT_D0.6mm_Drill0.3mm
U7: CH340N; SOIC-8_3.9x4.9mm_P1.27mm; LCSC C2977777
U8: SRV05-4; SOT-23-6; LCSC C2836319

Connections:
+5V: C27.2, C38.1, D9.1 (K), IC2.5 (VCC), J3.1, J4.1, R17.2, R18.1, U7.5 (VCC), U8.5 (REF); also elsewhere on the board
CH340-TX0: IC2.1 (I1), TP4.1 (1_1), U7.6 (RXD)
D+: J5.2, U7.1 (UD+), U8.6 (I/O_4)
D-: J5.3, U7.2 (UD-), U8.1 (I/O_1)
GND: C10.2, C26.2, C27.1, C38.2, IC2.2 (GND), J3.2, J4.2, J5.1, R12.2, R46.2, R48.1, R57.2, R58.2, U7.3 (GND), U8.2 (GND); also elsewhere on the board
MC-D14-TX3: R11.1; also elsewhere on the board
MC-D15-RX3: J3.3; also elsewhere on the board
MC-RESET: C37.2, R18.2, S1.1; also elsewhere on the board
MC-RX0: IC2.4 (Y), TP1.1 (1_1); also elsewhere on the board
MC-TX0: R47.1, U7.7 (TXD); also elsewhere on the board
unnamed: IC2.6 (S), R48.2, R55.1
unnamed: J3.4, R11.2, R12.1
unnamed: J4.4, R46.1, R47.2
unnamed: J5.4, R58.1
unnamed: J5.5, R57.1
unnamed: C10.1, R17.1, S1.2
unnamed: C26.1, U7.8 (V3)
unnamed: C37.1, U7.4 (~RTS)
S0-TX-Proto: IC2.3 (I0), J4.3, TP2.1 (1_1)
VBus: D9.2 (A), J5.6, R55.2

Notes on the sheet:
CH340
RX TX GND VCC
Serial3
S1 Reference used to match 0.4x schematic
External PH2.0 pinned USB bulkhead
Serial0
ECU Reset Control
VBus 5v / Connection Request
Serial0 TX Signal Switch/Buffer
USB Port
CH340N RTS# is used in place of DTR# for ECU reset control.
Serial Proto

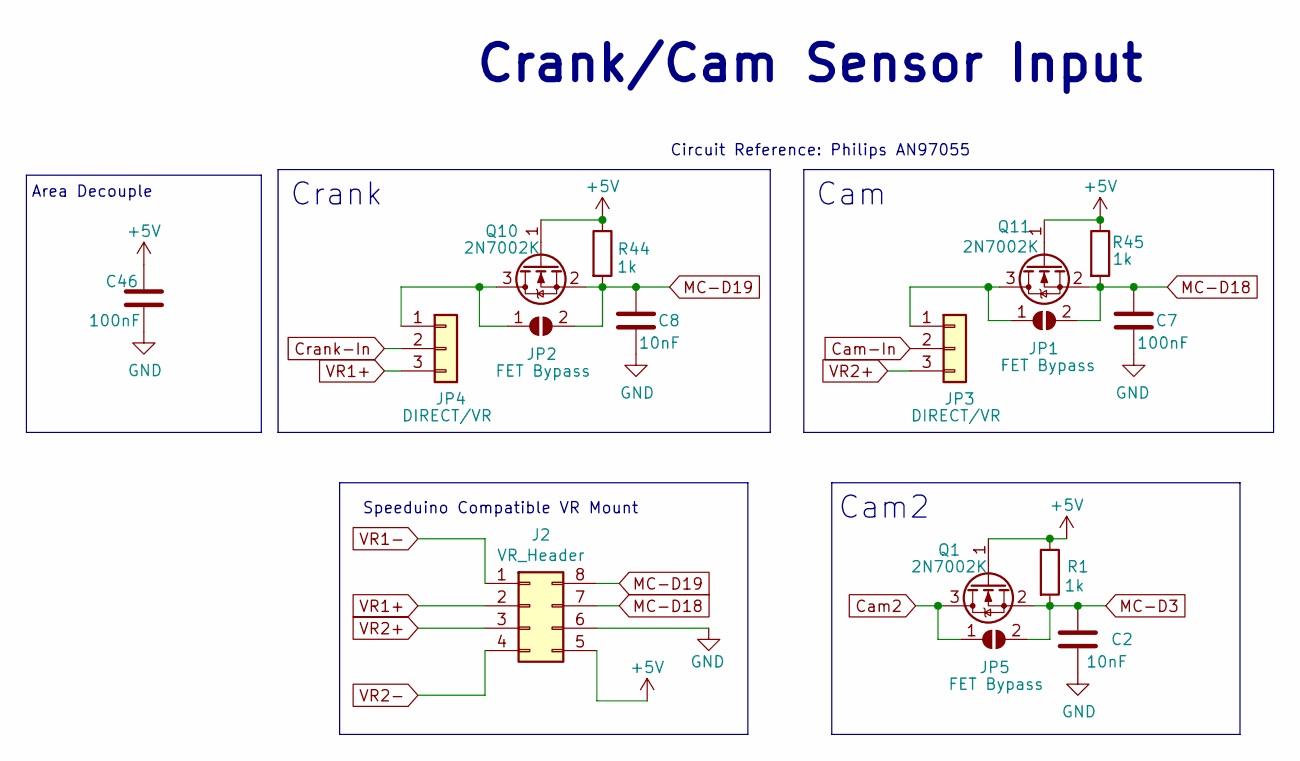
[picture p93: schematic trigger.kicad_sch, Spark Gap x4]

Parts:
C2, C8: 10nF; C_0402_1005Metric; Manufacture Part Number CL05B103KB5NNNC; LCSC C15195
C7, C46: 100nF; C_0402_1005Metric; Manufacture Part Number CL05B104KB54PNC; LCSC C307331
J2: VR_Header; Socket_VRConditioner_Corrected
JP1, JP2, JP5: FET Bypass; SolderJumper-2_P1.3mm_Open_RoundedPad1.0x1.5mm
JP3, JP4: DIRECT/VR; 1x03-Proto
Q1, Q10, Q11: 2N7002K; SOT-23; LCSC C22379475
R1, R44, R45: 1k; R_0402_1005Metric; Manufacture Part Number 0402WGF1001TCE; LCSC C11702

Connections:
+5V: C46.1, J2.5, Q1.1 (G), Q10.1 (G), Q11.1 (G), R1.1, R44.1, R45.1; also elsewhere on the board
Cam2: JP5.1 (A), Q1.3 (D); also elsewhere on the board
Cam-In: JP3.2; also elsewhere on the board
Crank-In: JP4.2; also elsewhere on the board
GND: C2.1, C7.1, C8.1, C46.2, J2.6; also elsewhere on the board
MC-D3: C2.2, JP5.2 (B), Q1.2 (S), R1.2; also elsewhere on the board
MC-D18: C7.2, J2.7, JP1.2 (B), Q11.2 (S), R45.2; also elsewhere on the board
MC-D19: C8.2, J2.8, JP2.2 (B), Q10.2 (S), R44.2; also elsewhere on the board
unnamed: JP1.1 (A), JP3.1, Q11.3 (D)
unnamed: JP2.1 (A), JP4.1, Q10.3 (D)
VR1+: J2.2, JP4.3
VR1-: J2.1; also elsewhere on the board
VR2+: J2.3, JP3.3
VR2-: J2.4; also elsewhere on the board

Notes on the sheet:
Crank/Cam Sensor Input
Cam2
Cam
Speeduino Compatible VR Mount
Area Decouple
Circuit Reference: Philips AN97055
Crank

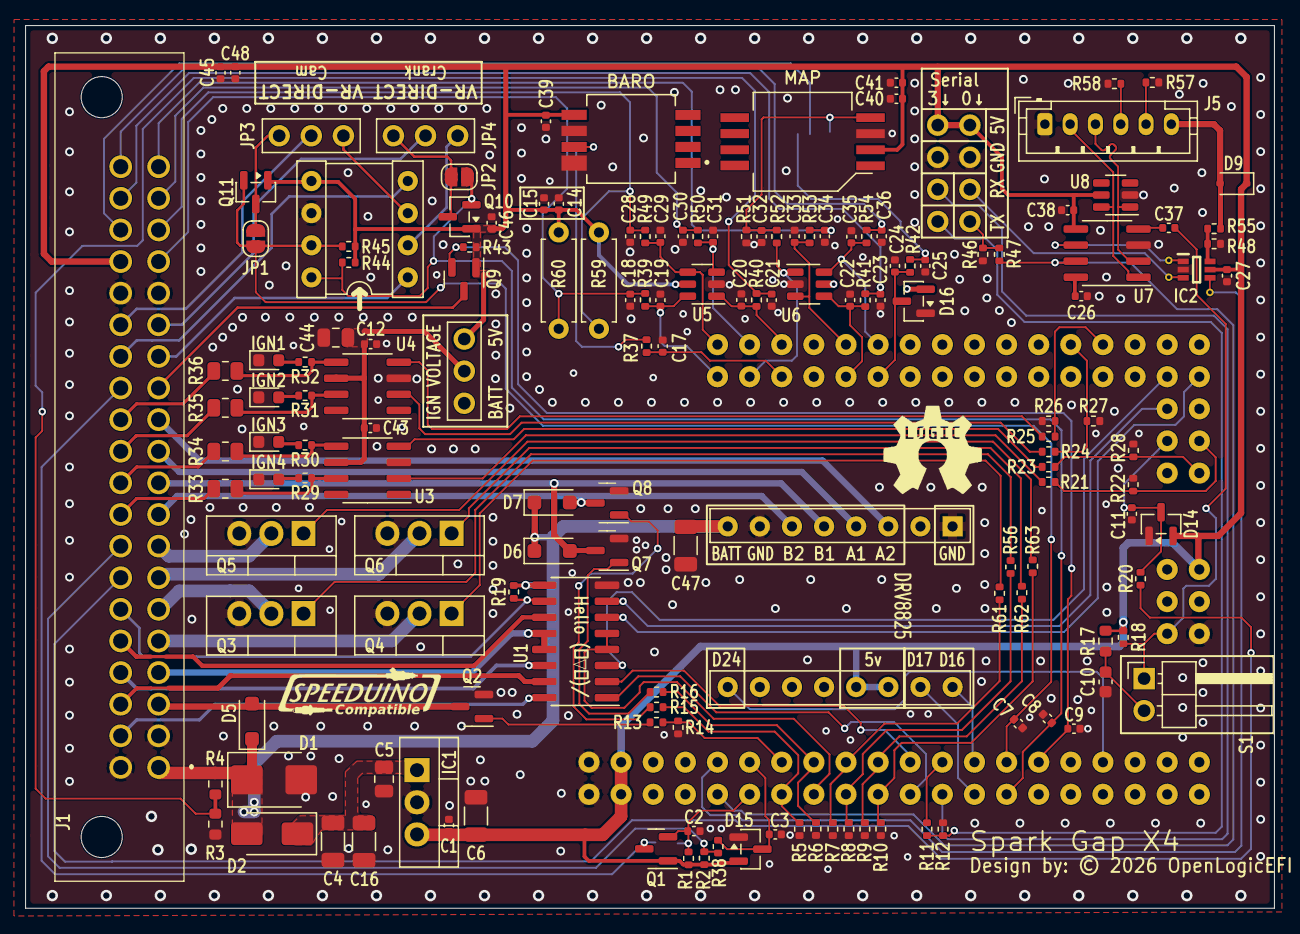
[picture p94: board SparkGapX4.kicad_pcb from above]

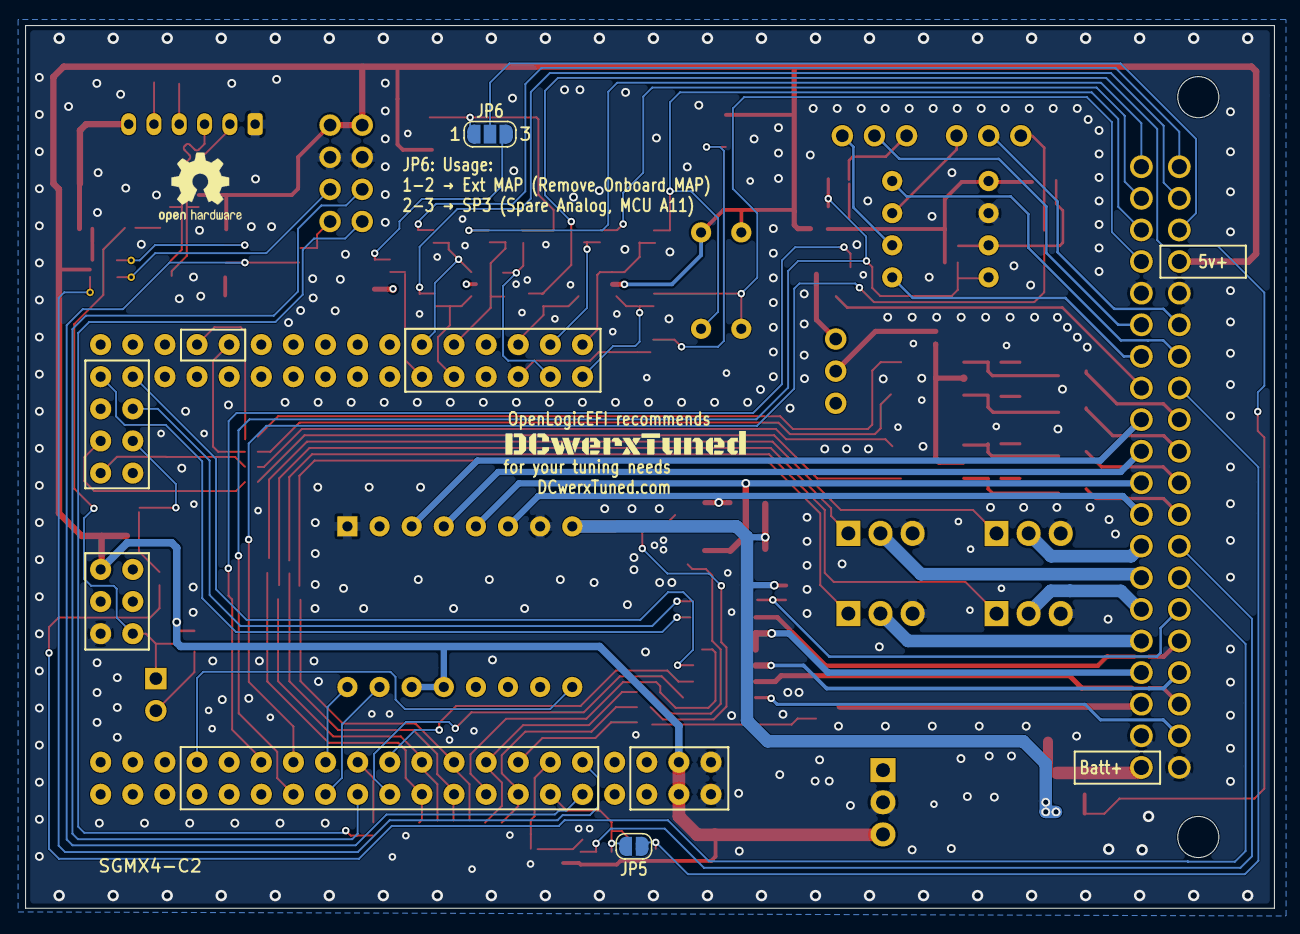
[picture p95: board SparkGapX4.kicad_pcb from below]

Board: 4 copper layers, 98.8 x 69.8 mm, 164 parts (3 on the bottom side), 120 nets.
