OpenLogicEFI/Hardware/Engine Managment/Closed Deck/Closed Deck x4/RevB2/closed-deck-x4.kicad_pcb

## KiCad design Engine Managment/Closed Deck/Closed Deck x4/RevB2/closed-deck-x4.kicad_pcb (2026-07-25)

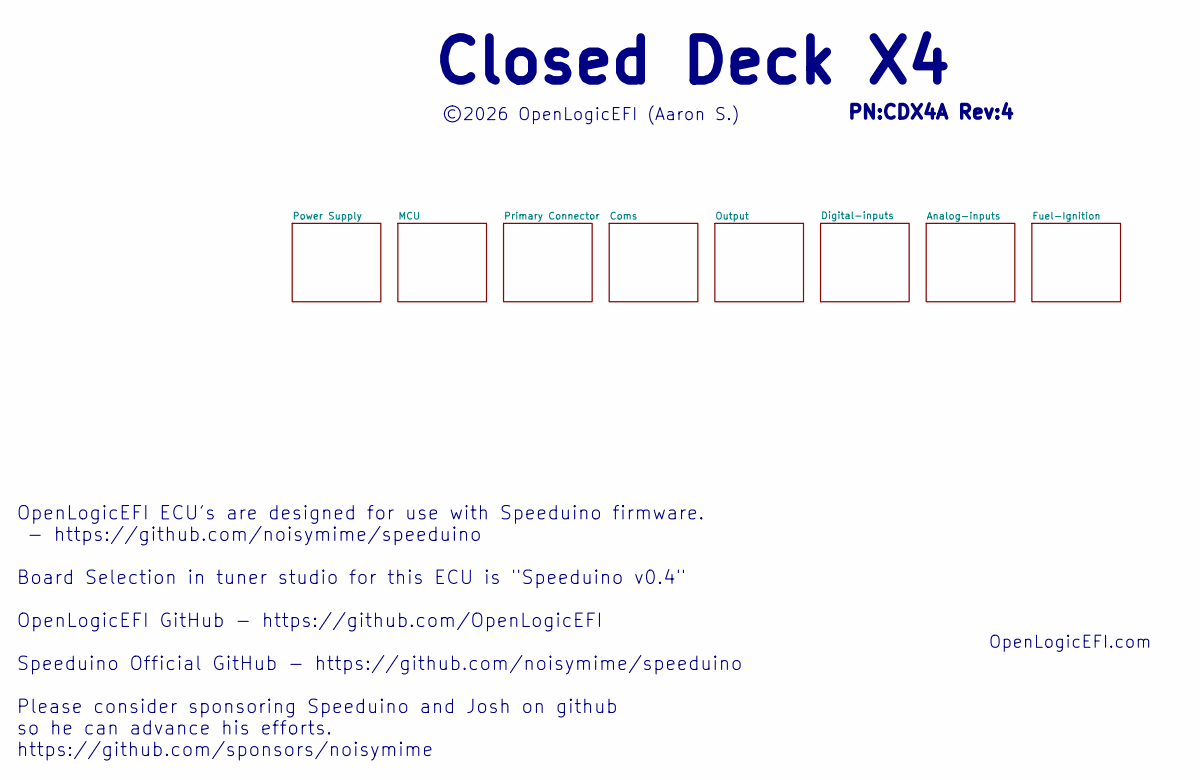
[picture p96: schematic closed-deck-x4.kicad_sch, Closed Deck X4]

Notes on the sheet:
©2026 OpenLogicEFI (Aaron S.)
OpenLogicEFI ECU's are designed for use with Speeduino firmware. - https://github.com/noisymime/speeduino Board Selection in tuner studio for this ECU is "Speeduino v0.4" OpenLogicEFI GitHub - https://github.com/OpenLogicEFI Speeduino Official GitHub - https://github.com/noisymime/speeduino Please 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
Closed Deck X4
PN:CDX4A Rev:4
OpenLogicEFI.com

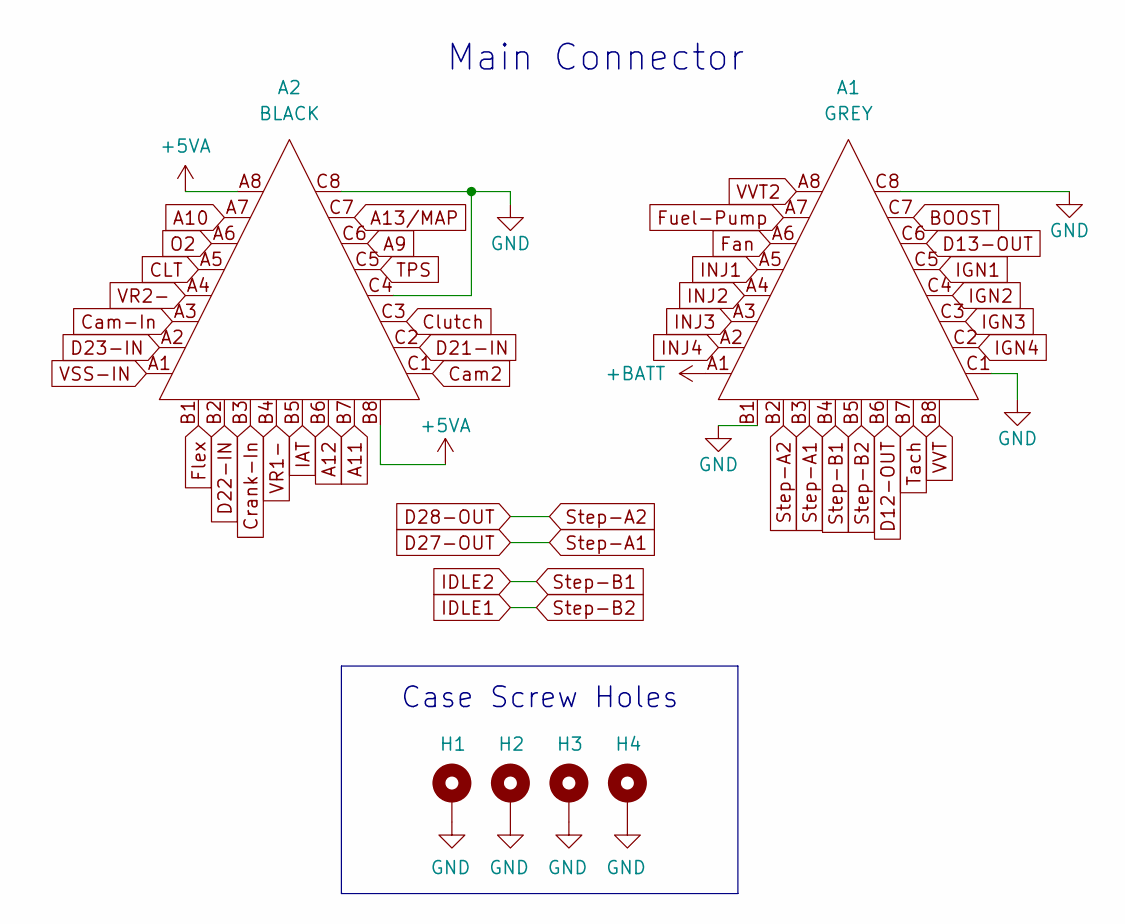
[picture p97: schematic connector.kicad_sch, Closed Deck X4]

Parts:
A1: GREY; Delphi_Sicma_24_Grey
A2: BLACK; Delphi_Sicma_24_Black
H1, H2, H3, H4: MountingHole_Pad; MountingHole_3.5mm_Pad

Connections:
+5VA: A2.A8, A2.B8; also elsewhere on the board
+BATT: A1.A1; also elsewhere on the board
A9: A2.C6; also elsewhere on the board
A10: A2.A7; also elsewhere on the board
A11: A2.B7; also elsewhere on the board
A12: A2.B6; also elsewhere on the board
A13/MAP: A2.C7; also elsewhere on the board
BOOST: A1.C7; also elsewhere on the board
CLT: A2.A5; also elsewhere on the board
Cam2: A2.C1; also elsewhere on the board
Cam-In: A2.A3; also elsewhere on the board
Clutch: A2.C3; also elsewhere on the board
Crank-In: A2.B3; also elsewhere on the board
D12-OUT: A1.B6; also elsewhere on the board
D13-OUT: A1.C6; also elsewhere on the board
D21-IN: A2.C2; also elsewhere on the board
D22-IN: A2.B2; also elsewhere on the board
D23-IN: A2.A2; also elsewhere on the board
D27-OUT: A1.B3; also elsewhere on the board
D28-OUT: A1.B2; also elsewhere on the board
Fan: A1.A6; also elsewhere on the board
Flex: A2.B1; also elsewhere on the board
Fuel-Pump: A1.A7; also elsewhere on the board
GND: A1.B1, A1.C1, A1.C8, A2.C4, A2.C8, H1.1 (1_1), H2.1 (1_1), H3.1 (1_1), H4.1 (1_1); also elsewhere on the board
IAT: A2.B5; also elsewhere on the board
IDLE1: A1.B5; also elsewhere on the board
IDLE2: A1.B4; also elsewhere on the board
IGN1: A1.C5; also elsewhere on the board
IGN2: A1.C4; also elsewhere on the board
IGN3: A1.C3; also elsewhere on the board
IGN4: A1.C2; also elsewhere on the board
INJ1: A1.A5; also elsewhere on the board
INJ2: A1.A4; also elsewhere on the board
INJ3: A1.A3; also elsewhere on the board
INJ4: A1.A2; also elsewhere on the board
O2: A2.A6; also elsewhere on the board
TPS: A2.C5; also elsewhere on the board
Tach: A1.B7; also elsewhere on the board
VR1-: A2.B4; also elsewhere on the board
VR2-: A2.A4; also elsewhere on the board
VSS-IN: A2.A1; also elsewhere on the board
VVT: A1.B8; also elsewhere on the board
VVT2: A1.A8; also elsewhere on the board

Notes on the sheet:
Case Screw Holes
Main Connector

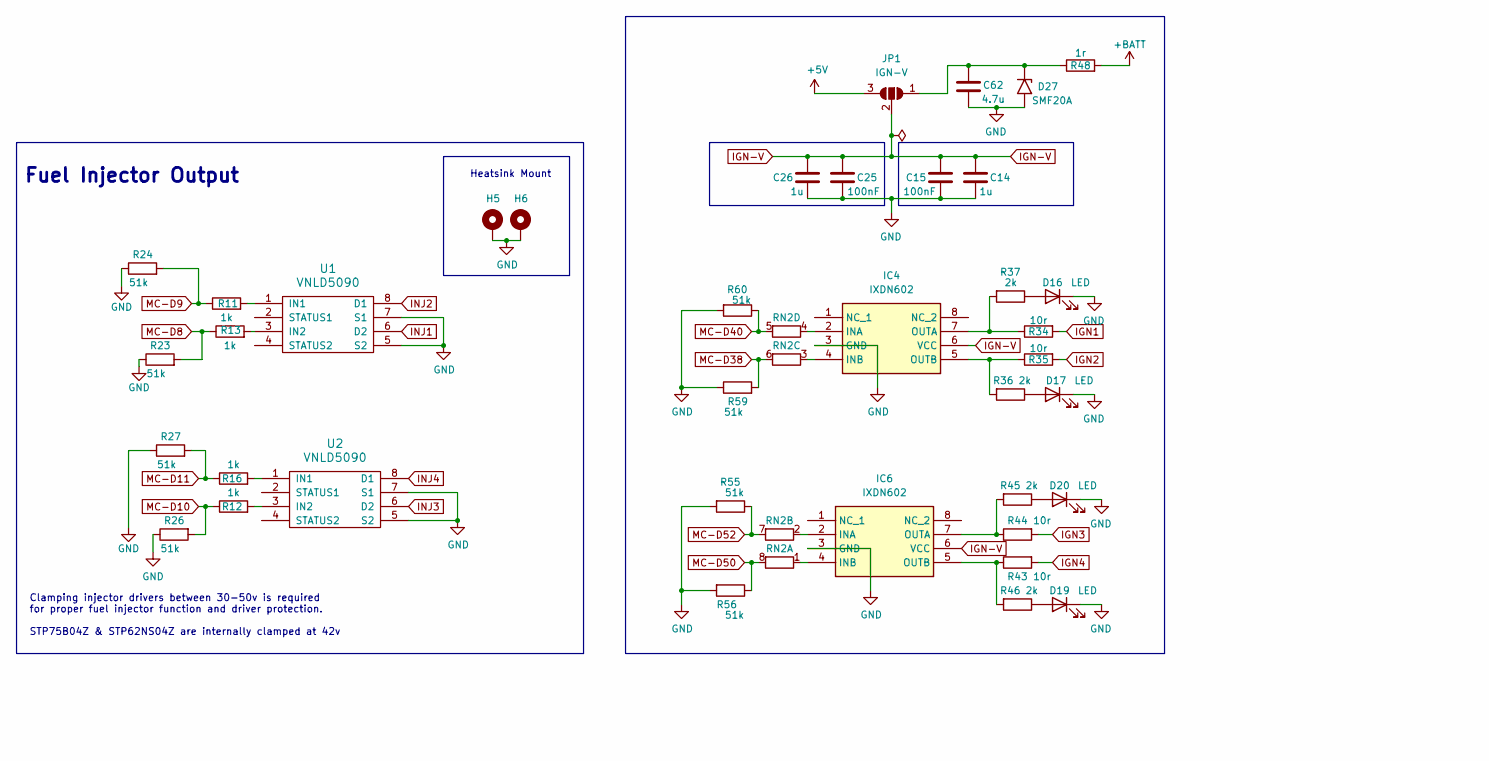
[picture p98: schematic fuel-ignition.kicad_sch, Closed Deck X4, part in row 1, column 1]

Parts:
C14, C26: 1u; C_0402_1005Metric; LCSC C52923
C15, C25: 100nF; C_0402_1005Metric; LCSC C307331
C62: 4.7u; C_1206_3216Metric; Manufacture Part Number 1206B475K500NT; LCSC C29823
D16, D17, D19, D20: LED; LED_0603_1608Metric; Manufacture Part Number KT-0603R; LCSC C2286
D27: SMF20A; D_SMF; LCSC C41411782
H5, H6: MountingHole_Pad; MountingHole_CD_Heatsink
IC4, IC6: IXDN602; SOIC-8_3.9x4.9mm_P1.27mm; Manufacture Part Number IXDN602; LCSC C431679
JP1: IGN-V; 1x03-Proto
R11, R12, R13, R16: 1k; R_0402_1005Metric; Manufacture Part Number 0402WGF1001TCE; LCSC C11702
R23, R24, R26, R27, R55, R56, R59, R60: 51k; R_0402_1005Metric; Manufacture Part Number 0402WGF5102TCE; LCSC C25794
R34, R35, R43, R44: 10r; R_0805_2012Metric; Manufacture Part Number 0805W8F100JT5E; LCSC C17415
R36, R37, R45, R46: 2k; R_0402_1005Metric; Manufacture Part Number 0402WGF2001TCE; LCSC C4109
R48: 1r; R_1206_3216Metric; Manufacture Part Number 1206W4F100KT5E; LCSC C17928
RN2: 1k; R_Array_Concave_4x0603; Manufacture Part Number 4D03WGJ0102T5E; LCSC C20197
U1, U2: VNLD5090; SO-8_3.9x4.9mm_P1.27mm_HandSoldering; LCSC C222209

Connections:
+5V: JP1.3 (B); also elsewhere on the board
+BATT: R48.2; also elsewhere on the board
GND: C14.2, C15.2, C25.2, C26.2, C62.2, D16.1 (K), D17.1 (K), D19.1 (K), D20.1 (K), D27.2 (A2), H5.1 (1_1), H6.1 (1_1), IC4.3 (GND), IC6.3 (GND), R23.1, R24.1, R26.1, R27.1, R55.2, R56.2, R59.1, R60.2, U1.5 (S2), U1.7 (S1), U2.5 (S2), U2.7 (S1); also elsewhere on the board
IGN1: R34.2; also elsewhere on the board
IGN2: R35.2; also elsewhere on the board
IGN3: R44.2; also elsewhere on the board
IGN4: R43.2; also elsewhere on the board
IGN-V: C14.1, C15.1, C25.1, C26.1, IC4.6 (VCC), IC6.6 (VCC), JP1.2 (C)
INJ1: U1.6 (D2); also elsewhere on the board
INJ2: U1.8 (D1); also elsewhere on the board
INJ3: U2.6 (D2); also elsewhere on the board
INJ4: U2.8 (D1); also elsewhere on the board
MC-D8: R13.1, R23.2; also elsewhere on the board
MC-D9: R11.1, R24.2; also elsewhere on the board
MC-D10: R12.1, R26.2; also elsewhere on the board
MC-D11: R16.1, R27.2; also elsewhere on the board
MC-D38: R59.2, RN2.6 (R3.2); also elsewhere on the board
MC-D40: R60.1, RN2.5 (R4.2); also elsewhere on the board
MC-D50: R56.1, RN2.8 (R1.2); also elsewhere on the board
MC-D52: R55.1, RN2.7 (R2.2); also elsewhere on the board
unnamed: D16.2 (A), R37.1
unnamed: D17.2 (A), R36.1
unnamed: D19.2 (A), R46.1
unnamed: D20.2 (A), R45.1
unnamed: C62.1, D27.1 (A1), JP1.1 (A), R48.1
unnamed: IC4.2 (INA), RN2.4 (R4.1)
unnamed: IC4.4 (INB), RN2.3 (R3.1)
unnamed: IC4.7 (OUTA), R34.1, R37.2
unnamed: IC4.5 (OUTB), R35.1, R36.2
unnamed: IC6.2 (INA), RN2.2 (R2.1)
unnamed: IC6.4 (INB), RN2.1 (R1.1)
unnamed: IC6.7 (OUTA), R44.1, R45.2
unnamed: IC6.5 (OUTB), R43.1, R46.2
unnamed: R11.2, U1.1 (IN1)
unnamed: R13.2, U1.3 (IN2)
unnamed: R16.2, U2.1 (IN1)
unnamed: R12.2, U2.3 (IN2)

Notes on the sheet:
Heatsink Mount
Clamping injector drivers between 30-50v is required for proper fuel injector function and driver protection. STP75B04Z & STP62NS04Z are internally clamped at 42v
Fuel Injector Output
Logic Level Ignition Output
