OpenLogicEFI/Hardware/Engine Managment/Closed Deck/Closed Deck x4/RevB2/closed-deck-x4.kicad_pcb

## KiCad design Engine Managment/Closed Deck/Closed Deck x4/RevB2/closed-deck-x4.kicad_pcb (continued)

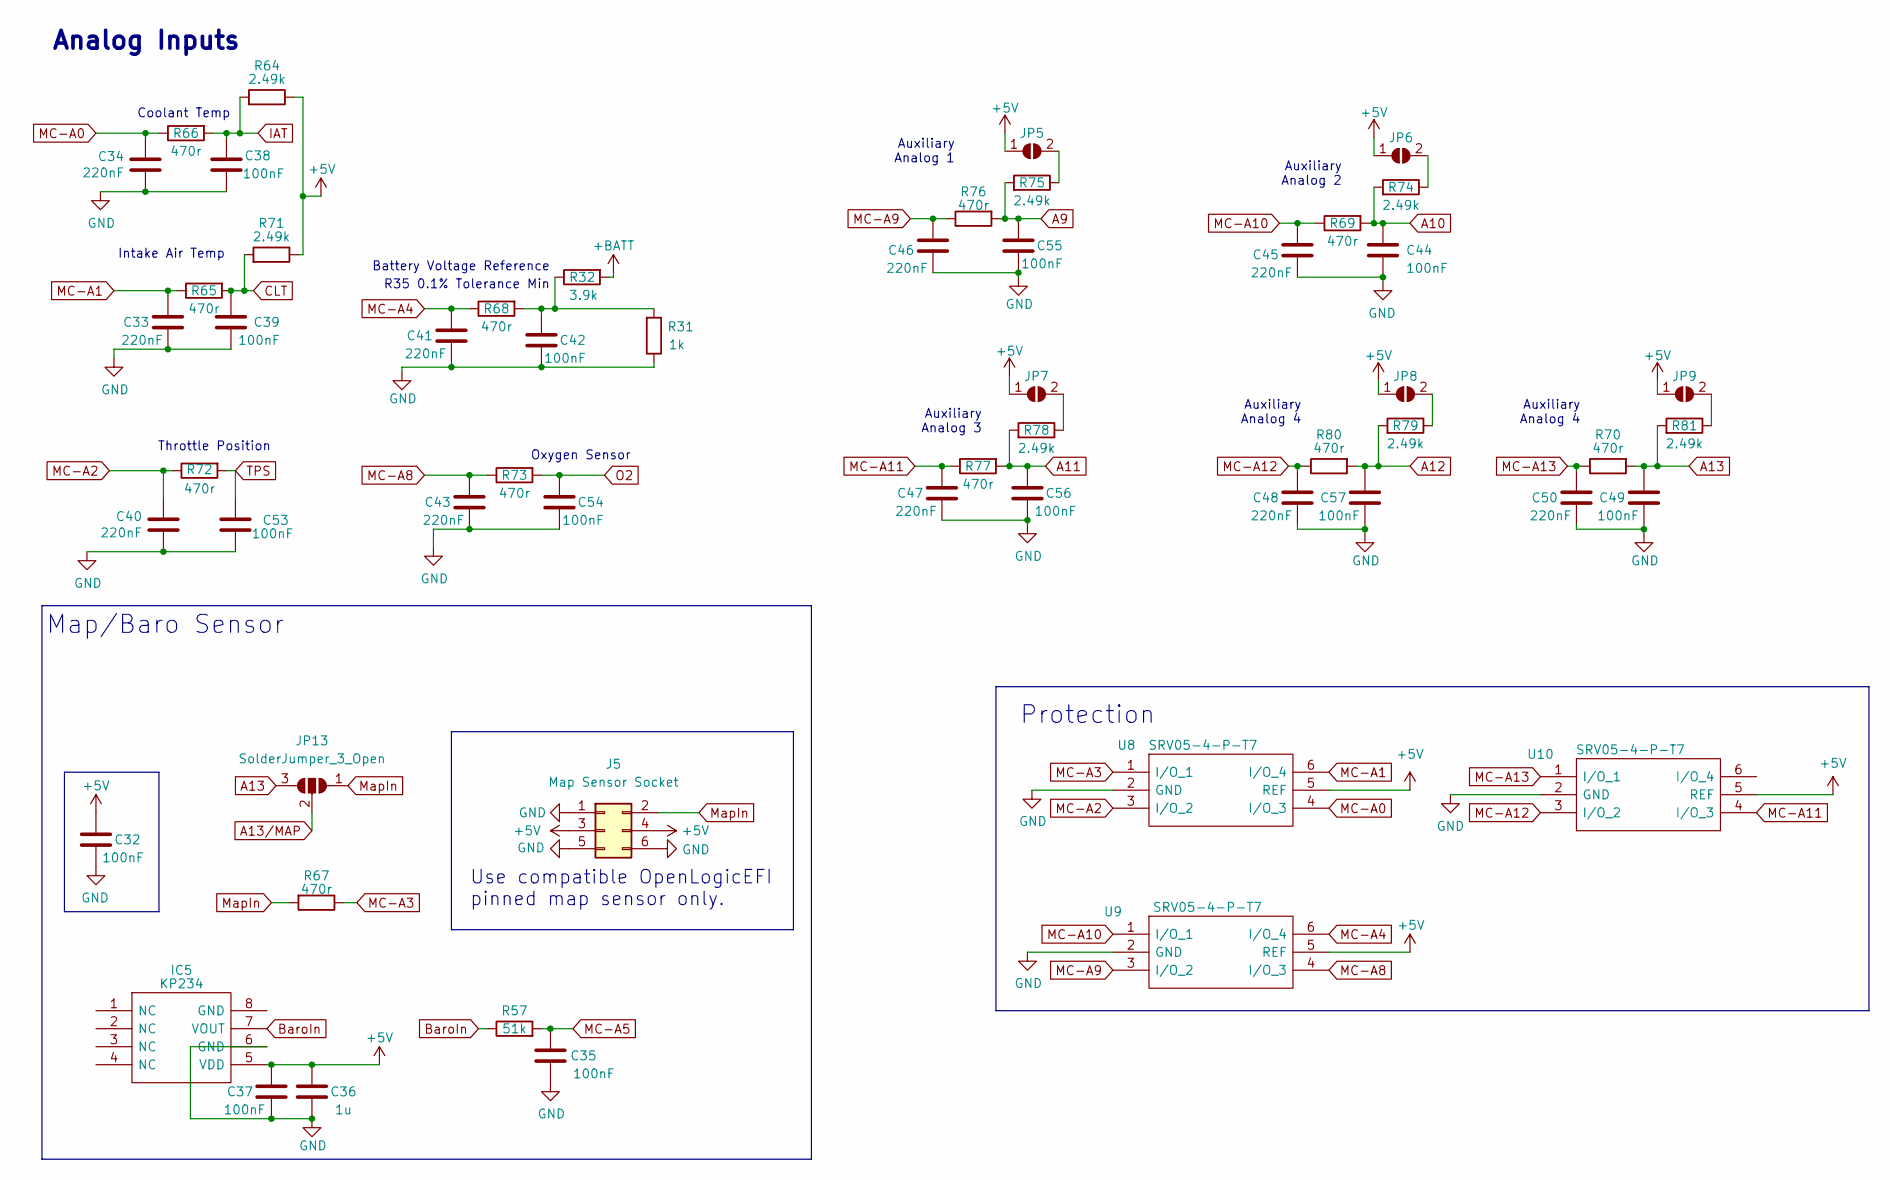
[picture p99: schematic input.kicad_sch, Closed Deck X4]

Parts:
C32, C37, C38, C39, C42, C44, C49, C53, C54, C55, C56, C57: 100nF; C_0402_1005Metric; LCSC C307331
C33, C34, C40, C41, C43, C45, C46, C47, C48, C50: 220nF; C_0402_1005Metric; LCSC C16772
C35: 100nF; C_0402_1005Metric; Manufacture Part Number CL05B104KB54PNC; LCSC C307331
C36: 1u; C_0402_1005Metric; LCSC C52923
IC5: KP234; KP234-Handsoldering; Manufacture Part Number KP234XTMA1
J5: Map Sensor Socket; PinSocket 2x03
JP5, JP6, JP7, JP8, JP9: SolderJumper_2_Open; SolderJumper-2_P1.3mm_Open_RoundedPad1.0x1.5mm
JP13: SolderJumper_3_Open; SolderJumper-3-OPEN
R31: 1k; R_0402_1005Metric; Manufacture Part Number 0402WGF1001TCE; LCSC C11702
R32: 3.9k; R_0603_1608Metric; Manufacture Part Number 0603WAF3901T5E; LCSC C23018
R57: 51k; R_0402_1005Metric; Manufacture Part Number 0402WGF5102TCE; LCSC C25794
R64, R71: 2.49k; R_Axial_DIN0207_L6.3mm_D2.5mm_P7.62mm_Horizontal
R65, R66, R67, R68, R69, R70, R72, R73, R76, R77, R80: 470r; R_0402_1005Metric; Manufacture Part Number 0402WGF4700TCE; LCSC C25117
R74, R75, R78, R79, R81: 2.49k; R_0402_1005Metric; Manufacture Part Number RC0402FR-072K49L; LCSC C145071
U8, U9, U10: SRV05-4-P-T7; SOT-23-6; LCSC C85364

Connections:
+5V: C32.2, C36.1, C37.1, IC5.5 (VDD), J5.3, J5.4, JP5.1 (A), JP6.1 (A), JP7.1 (A), JP8.1 (A), JP9.1 (A), R64.1, R71.1, U8.5 (REF), U9.5 (REF), U10.5 (REF); also elsewhere on the board
+BATT: R32.2; also elsewhere on the board
A9: C55.1, R75.2, R76.2; also elsewhere on the board
A10: C44.1, R69.2, R74.2; also elsewhere on the board
A11: C56.1, R77.2, R78.2; also elsewhere on the board
A12: C57.1, R79.2, R80.2; also elsewhere on the board
A13: C49.1, JP13.3 (B), R70.2, R81.2
A13/MAP: JP13.2 (C); also elsewhere on the board
BaroIn: IC5.7 (VOUT), R57.1
CLT: C39.1, R65.2, R71.2; also elsewhere on the board
GND: C32.1, C33.2, C34.2, C35.2, C36.2, C37.2, C38.2, C39.2, C40.2, C41.2, C42.2, C43.2, C44.2, C45.2, C46.2, C47.2, C48.2, C49.2, C50.2, C53.2, C54.2, C55.2, C56.2, C57.2, IC5.6 (GND), J5.1, J5.5, J5.6, R31.1, U8.2 (GND), U9.2 (GND), U10.2 (GND); also elsewhere on the board
IAT: C38.1, R64.2, R66.2; also elsewhere on the board
MC-A0: C34.1, R66.1, U8.4 (I/O_3); also elsewhere on the board
MC-A1: C33.1, R65.1, U8.6 (I/O_4); also elsewhere on the board
MC-A2: C40.1, R72.1, U8.3 (I/O_2); also elsewhere on the board
MC-A3: R67.1, U8.1 (I/O_1); also elsewhere on the board
MC-A4: C41.1, R68.1, U9.6 (I/O_4); also elsewhere on the board
MC-A5: C35.1, R57.2; also elsewhere on the board
MC-A8: C43.1, R73.1, U9.4 (I/O_3); also elsewhere on the board
MC-A9: C46.1, R76.1, U9.3 (I/O_2); also elsewhere on the board
MC-A10: C45.1, R69.1, U9.1 (I/O_1); also elsewhere on the board
MC-A11: C47.1, R77.1, U10.4 (I/O_3); also elsewhere on the board
MC-A12: C48.1, R80.1, U10.3 (I/O_2); also elsewhere on the board
MC-A13: C50.1, R70.1, U10.1 (I/O_1); also elsewhere on the board
MapIn: J5.2, JP13.1 (A), R67.2
unnamed: C42.1, R31.2, R32.1, R68.2
unnamed: JP5.2 (B), R75.1
unnamed: JP6.2 (B), R74.1
unnamed: JP7.2 (B), R78.1
unnamed: JP8.2 (B), R79.1
unnamed: JP9.2 (B), R81.1
O2: C54.1, R73.2; also elsewhere on the board
TPS: C53.1, R72.2; also elsewhere on the board

Notes on the sheet:
Analog Inputs
Throttle Position
Auxiliary Analog 2
Auxiliary Analog 4
Auxiliary Analog 1
R35 0.1% Tolerance Min
Oxygen Sensor
Map/Baro Sensor
Use compatible OpenLogicEFI pinned map sensor only.
Coolant Temp
Intake Air Temp
Battery Voltage Reference
Protection
Auxiliary Analog 3

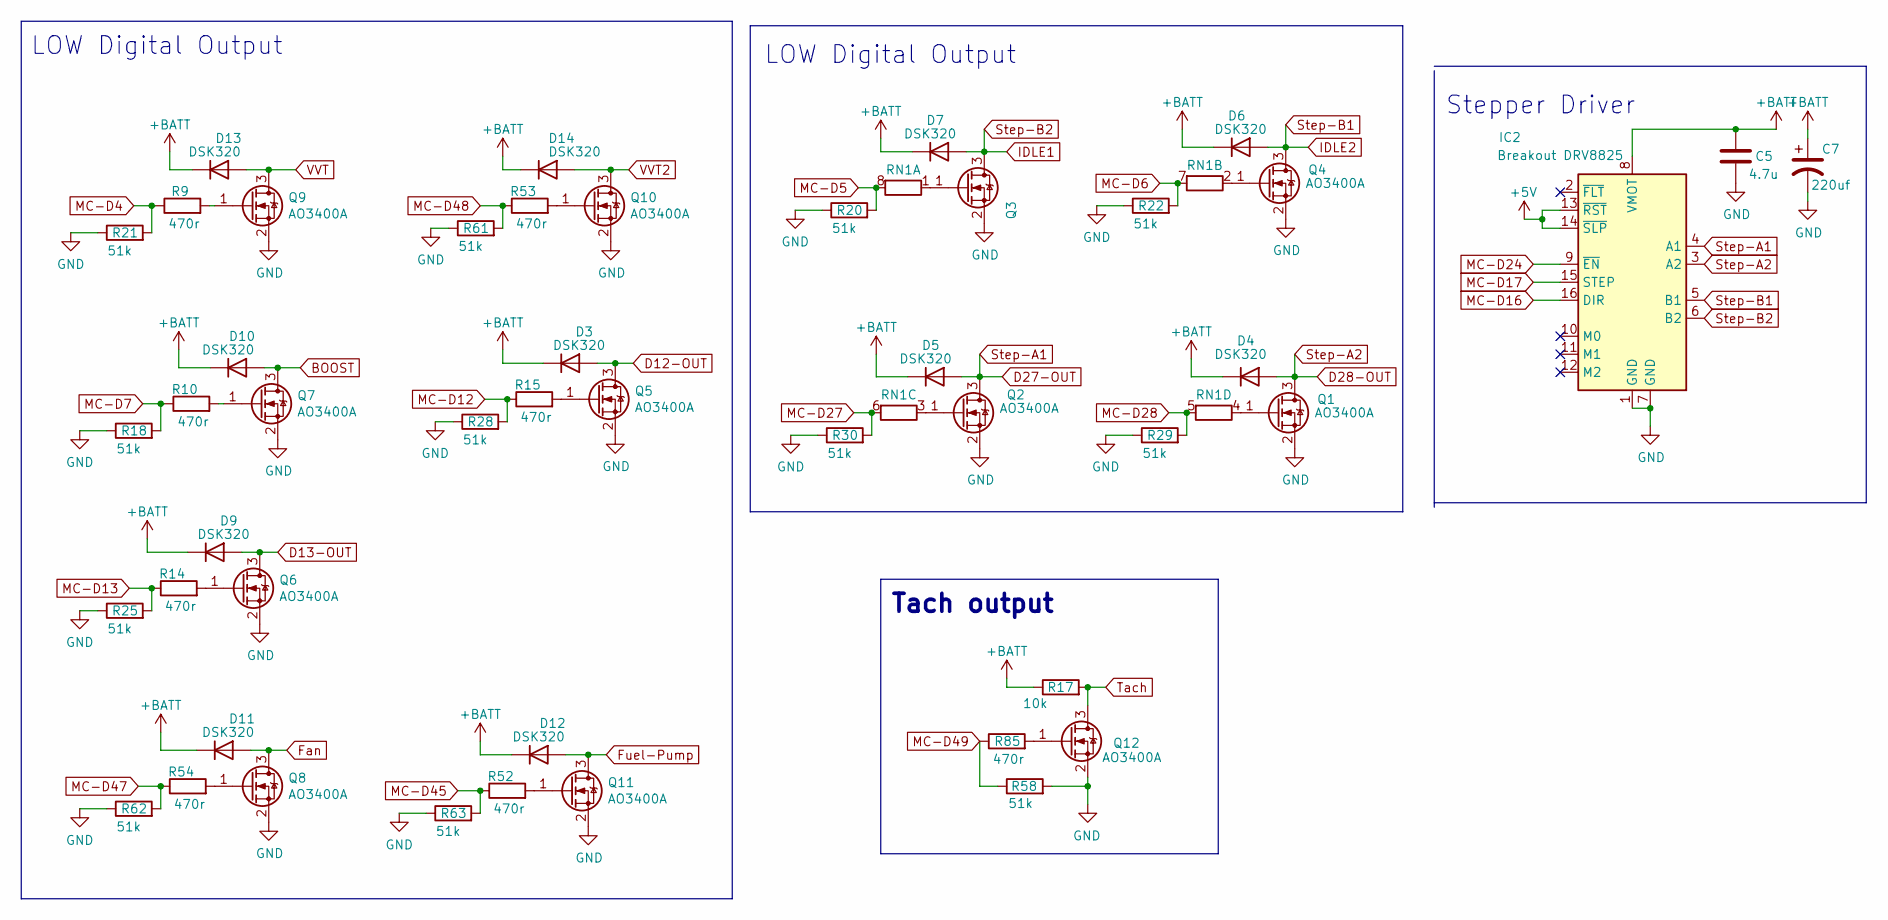
[picture p100: schematic output.kicad_sch, Closed Deck X4]

Parts:
C5: 4.7u; C_1206_3216Metric; Manufacture Part Number 1206B475K500NT; LCSC C29823
C7: 220uf; CP_Radial_D6.3mm_P2.50mm
D3, D4, D5, D6, D7, D9, D10, D11, D12, D13, D14: DSK320; D_SOD-123F; JLC C2128
IC2: Breakout DRV8825; DVR8825-Labeled-Front
Q1, Q2, Q3, Q4, Q5, Q6, Q12: AO3400A; SOT-23; Manufacture Part Number AO3400A; LCSC C20917
Q7, Q8, Q9, Q10, Q11: AO3400A; SOT-23; Manufacture Part Number AO3400A; JLC C20917
R9, R10, R14, R15, R52, R53, R54, R85: 470r; R_0402_1005Metric; Manufacture Part Number 0402WGF4700TCE; LCSC C25117
R17: 10k; R_0402_1005Metric; Manufacture Part Number 0402WGF1002TCE; LCSC C25744
R18, R20, R21, R22, R25, R28, R29, R30, R58, R61, R62, R63: 51k; R_0402_1005Metric; Manufacture Part Number 0402WGF5102TCE; LCSC C25794
RN1: 1k; R_Array_Concave_4x0603; Manufacture Part Number 4D03WGJ0102T5E; LCSC C20197

Connections:
+5V: IC2.13 (~RST), IC2.14 (~SLP); also elsewhere on the board
+BATT: C5.1, C7.1, D3.1 (K), D4.1 (K), D5.1 (K), D6.1 (K), D7.1 (K), D9.1 (K), D10.1 (K), D11.1 (K), D12.1 (K), D13.1 (K), D14.1 (K), IC2.8 (VMOT), R17.1; also elsewhere on the board
BOOST: D10.2 (A), Q7.3 (D); also elsewhere on the board
D12-OUT: D3.2 (A), Q5.3 (D); also elsewhere on the board
D13-OUT: D9.2 (A), Q6.3 (D); also elsewhere on the board
D27-OUT: D5.2 (A), IC2.4 (A1), Q2.3 (D); also elsewhere on the board
D28-OUT: D4.2 (A), IC2.3 (A2), Q1.3 (D); also elsewhere on the board
Fan: D11.2 (A), Q8.3 (D); also elsewhere on the board
Fuel-Pump: D12.2 (A), Q11.3 (D); also elsewhere on the board
GND: C5.2, C7.2, IC2.1 (GND), IC2.7 (GND), Q1.2 (S), Q2.2 (S), Q3.2 (S), Q4.2 (S), Q5.2 (S), Q6.2 (S), Q7.2 (S), Q8.2 (S), Q9.2 (S), Q10.2 (S), Q11.2 (S), Q12.2 (S), R18.1, R20.1, R21.1, R22.1, R25.1, R28.1, R29.1, R30.1, R58.2, R61.1, R62.1, R63.1; also elsewhere on the board
IDLE1: D7.2 (A), IC2.6 (B2), Q3.3 (D); also elsewhere on the board
IDLE2: D6.2 (A), IC2.5 (B1), Q4.3 (D); also elsewhere on the board
MC-D4: R9.1, R21.2; also elsewhere on the board
MC-D5: R20.2, RN1.8 (R1.2); also elsewhere on the board
MC-D6: R22.2, RN1.7 (R2.2); also elsewhere on the board
MC-D7: R10.1, R18.2; also elsewhere on the board
MC-D12: R15.1, R28.2; also elsewhere on the board
MC-D13: R14.1, R25.2; also elsewhere on the board
MC-D16: IC2.16 (DIR); also elsewhere on the board
MC-D17: IC2.15 (STEP); also elsewhere on the board
MC-D24: IC2.9 (~EN); also elsewhere on the board
MC-D27: R30.2, RN1.6 (R3.2); also elsewhere on the board
MC-D28: R29.2, RN1.5 (R4.2); also elsewhere on the board
MC-D45: R52.1, R63.2; also elsewhere on the board
MC-D47: R54.1, R62.2; also elsewhere on the board
MC-D48: R53.1, R61.2; also elsewhere on the board
MC-D49: R58.1, R85.1; also elsewhere on the board
unnamed: Q1.1 (G), RN1.4 (R4.1)
unnamed: Q2.1 (G), RN1.3 (R3.1)
unnamed: Q3.1 (G), RN1.1 (R1.1)
unnamed: Q4.1 (G), RN1.2 (R2.1)
unnamed: Q5.1 (G), R15.2
unnamed: Q6.1 (G), R14.2
unnamed: Q7.1 (G), R10.2
unnamed: Q8.1 (G), R54.2
unnamed: Q9.1 (G), R9.2
unnamed: Q10.1 (G), R53.2
unnamed: Q11.1 (G), R52.2
unnamed: Q12.1 (G), R85.2
Tach: Q12.3 (D), R17.2; also elsewhere on the board
VVT: D13.2 (A), Q9.3 (D); also elsewhere on the board
VVT2: D14.2 (A), Q10.3 (D); also elsewhere on the board

Notes on the sheet:
Tach output
LOW Digital Output
Stepper Driver

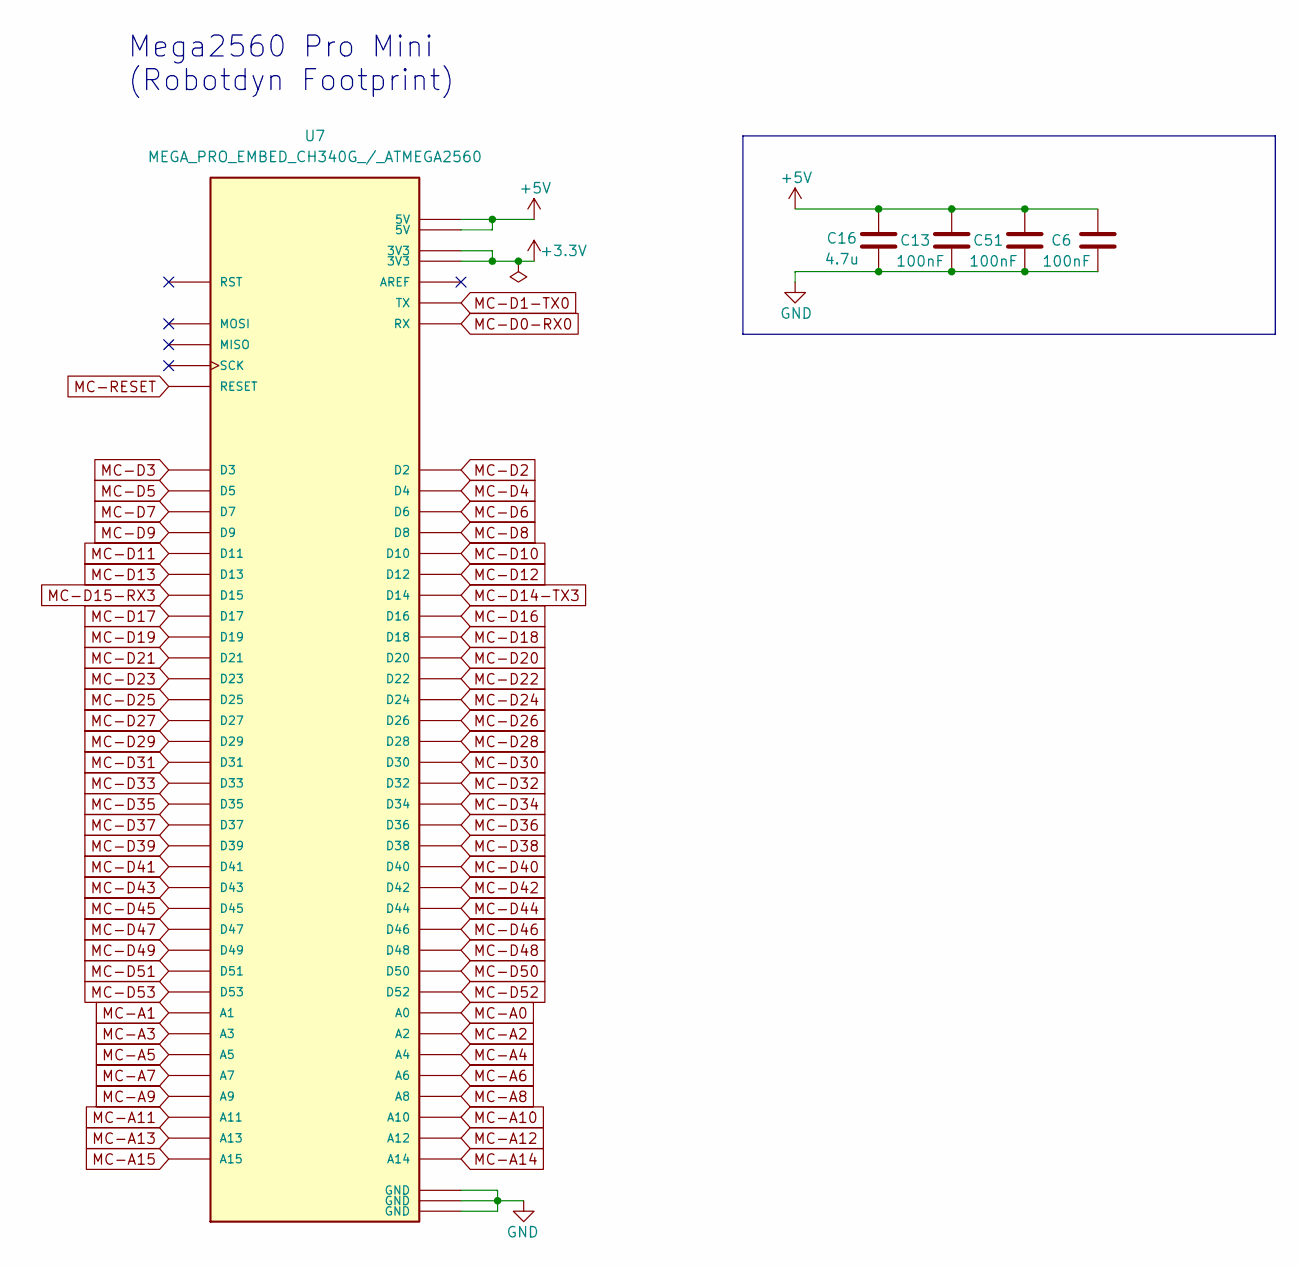
[picture p101: schematic mcu.kicad_sch, Closed Deck X4]

Parts:
C6, C13, C51: 100nF; C_0402_1005Metric; LCSC C307331
C16: 4.7u; C_1206_3216Metric; Manufacture Part Number 1206B475K500NT; LCSC C29823
U7: MEGA_PRO_EMBED_CH340G_/_ATMEGA2560; Arduino_Mega_Mini_2560_SmallCrtYd_NoVin

Connections:
+3.3V: U7.3V3_1 (3V3), U7.3V3_2 (3V3)
+5V: C6.2, C13.2, C16.1, C51.2, U7.5V_1 (5V), U7.5V_2 (5V), U7.5V_3 (5V); also elsewhere on the board
GND: C6.1, C13.1, C16.2, C51.1, U7.GND_1 (GND), U7.GND_2 (GND), U7.GND_3 (GND); also elsewhere on the board
MC-A0: U7.A0; also elsewhere on the board
MC-A1: U7.A1; also elsewhere on the board
MC-A2: U7.A2; also elsewhere on the board
MC-A3: U7.A3; also elsewhere on the board
MC-A4: U7.A4; also elsewhere on the board
MC-A5: U7.A5; also elsewhere on the board
MC-A6: U7.A6
MC-A7: U7.A7
MC-A8: U7.A8; also elsewhere on the board
MC-A9: U7.A9; also elsewhere on the board
MC-A10: U7.A10; also elsewhere on the board
MC-A11: U7.A11; also elsewhere on the board
MC-A12: U7.A12; also elsewhere on the board
MC-A13: U7.A13; also elsewhere on the board
MC-A14: U7.A14
MC-A15: U7.A15
MC-D0-RX0: U7.RX; also elsewhere on the board
MC-D1-TX0: U7.TX; also elsewhere on the board
MC-D2: U7.D2; also elsewhere on the board
MC-D3: U7.D3; also elsewhere on the board
MC-D4: U7.D4; also elsewhere on the board
MC-D5: U7.D5; also elsewhere on the board
MC-D6: U7.D6; also elsewhere on the board
MC-D7: U7.D7; also elsewhere on the board
MC-D8: U7.D8; also elsewhere on the board
MC-D9: U7.D9; also elsewhere on the board
MC-D10: U7.D10; also elsewhere on the board
MC-D11: U7.D11; also elsewhere on the board
MC-D12: U7.D12; also elsewhere on the board
MC-D13: U7.D13; also elsewhere on the board
MC-D14-TX3: U7.D14; also elsewhere on the board
MC-D15-RX3: U7.D15; also elsewhere on the board
MC-D16: U7.D16; also elsewhere on the board
MC-D17: U7.D17; also elsewhere on the board
MC-D18: U7.D18; also elsewhere on the board
MC-D19: U7.D19; also elsewhere on the board
MC-D20: U7.D20; also elsewhere on the board
MC-D21: U7.D21; also elsewhere on the board
MC-D22: U7.D22; also elsewhere on the board
MC-D23: U7.D23; also elsewhere on the board
MC-D24: U7.D24; also elsewhere on the board
MC-D25: U7.D25
MC-D26: U7.D26
MC-D27: U7.D27; also elsewhere on the board
MC-D28: U7.D28; also elsewhere on the board
MC-D29: U7.D29
MC-D30: U7.D30
MC-D31: U7.D31
MC-D32: U7.D32
MC-D33: U7.D33
MC-D34: U7.D34
MC-D35: U7.D35
MC-D36: U7.D36
MC-D37: U7.D37
MC-D38: U7.D38; also elsewhere on the board
MC-D39: U7.D39
MC-D40: U7.D40; also elsewhere on the board
MC-D41: U7.D41
MC-D42: U7.D42
MC-D43: U7.D43
MC-D44: U7.D44
MC-D45: U7.D45; also elsewhere on the board
MC-D46: U7.D46
MC-D47: U7.D47; also elsewhere on the board
MC-D48: U7.D48; also elsewhere on the board
MC-D49: U7.D49; also elsewhere on the board
MC-D50: U7.D50; also elsewhere on the board
MC-D51: U7.D51; also elsewhere on the board
MC-D52: U7.D52; also elsewhere on the board
MC-D53: U7.D53
MC-RESET: U7.RESET; also elsewhere on the board

Notes on the sheet:
Mega2560 Pro Mini (Robotdyn Footprint)

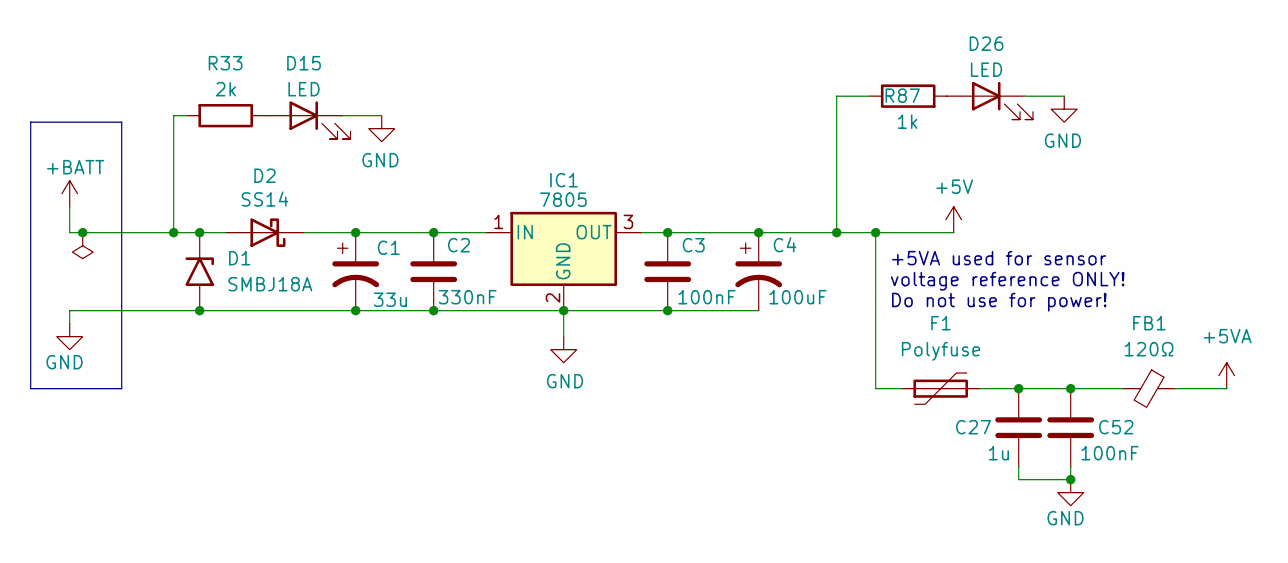
[picture p102: schematic powersupply.kicad_sch, Closed Deck X4]

Parts:
C1: 33u; CP_EIA-6032-28_Kemet-C; Manufacture Part Number TAJC106K035RNJ; LCSC C7211
C2: 330nF; C_0805_2012Metric; Manufacture Part Number 0805B334K500NT; LCSC C1740
C3: 100nF; C_0805_2012Metric; Manufacture Part Number CC0805KRX7R9BB104; LCSC C49678
C4: 100uF; CP_EIA-3528-15_AVX-H; Manufacture Part Number TAJB107K006RNJ; LCSC C16133
C27: 1u; C_0402_1005Metric; LCSC C52923
C52: 100nF; C_0402_1005Metric; LCSC C307331
D1: SMBJ18A; D_SMB; LCSC C19077573
D2: SS14; D_SMA; Manufacture Part Number SS14; LCSC C2480
D15, D26: LED; LED_0603_1608Metric; Manufacture Part Number KT-0603R; LCSC C2286
F1: Polyfuse; Fuse_1206_3216Metric; LCSC C976305
FB1: 120Ω; C_0603_1608Metric; Manufacture Part Number BLM18PG121SN1D; LCSC C14709
IC1: 7805; TO-263-2; Manufacture Part Number L78M05ABDT-TR; LCSC C86206
R33: 2k; R_0402_1005Metric; Manufacture Part Number 0402WGF2001TCE; LCSC C4109
R87: 1k; R_0402_1005Metric; Manufacture Part Number 0402WGF1001TCE; LCSC C11702

Connections:
+5V: C3.1, C4.1, F1.1, IC1.3 (OUT), R87.1; also elsewhere on the board
+5VA: FB1.1; also elsewhere on the board
+BATT: D1.1 (A1), D2.2 (A), R33.2; also elsewhere on the board
GND: C1.2, C2.2, C3.2, C4.2, C27.2, C52.2, D1.2 (A2), D15.1 (K), D26.1 (K), IC1.2 (GND); also elsewhere on the board
unnamed: C27.1, C52.1, F1.2, FB1.2
unnamed: C1.1, C2.1, D2.1 (K), IC1.1 (IN)
unnamed: D15.2 (A), R33.1
unnamed: D26.2 (A), R87.2

Notes on the sheet:
+5VA used for sensor voltage reference ONLY! Do not use for power!

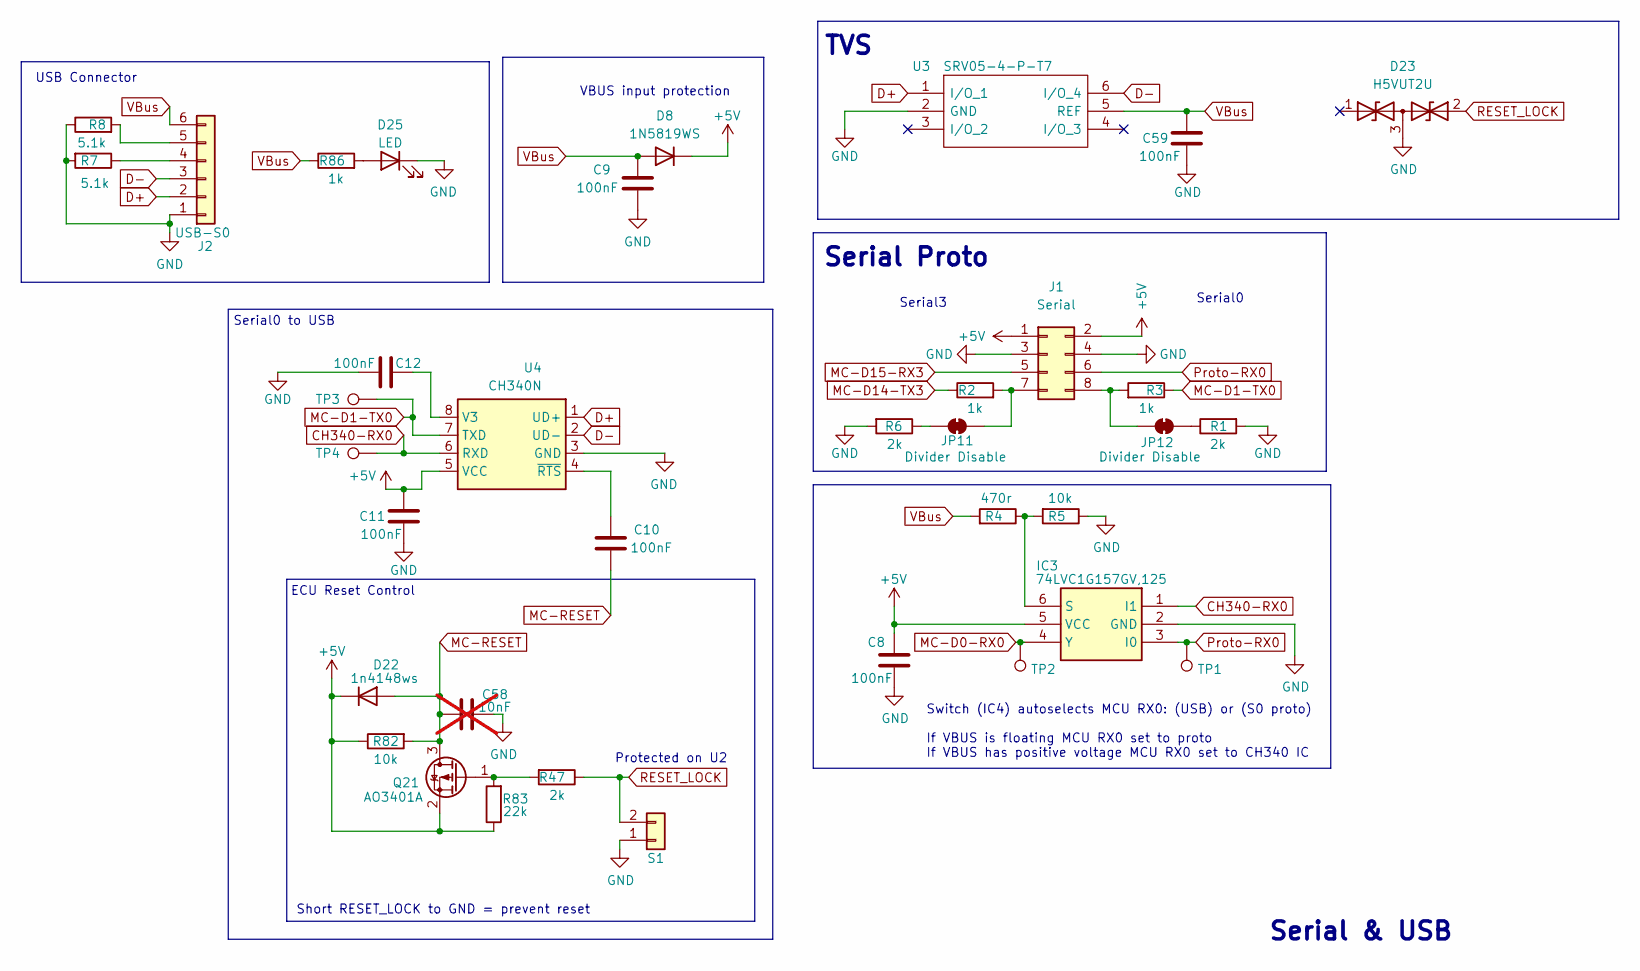
[picture p103: schematic usb.kicad_sch, Closed Deck X4]

Parts:
C8, C9, C10, C11, C12, C59: 100nF; C_0402_1005Metric; LCSC C307331
C58: 10nF; C_0402_1005Metric; Manufacture Part Number CL05B103KB5NNNC; LCSC C15195; not fitted
D8: 1N5819WS; D_SOD-323; Manufacture Part Number 1N5819WS; LCSC C191023
D22: 1n4148ws; D_SOD-323; LCSC C2128
D23: H5VUT2U; SOT-23; LCSC C20615824
D25: LED; LED_0603_1608Metric; Manufacture Part Number KT-0603R; LCSC C2286
IC3: 74LVC1G157GV,125; TSOT-23-6; Manufacture Part Number 74LVC1G157GW,125; LCSC C53114339
J1: Serial; 2x04-2.54mm-Serial-withSilk
J2: USB-S0; JST_PH_B6B-PH-K_1x06_P2.00mm_Vertical
JP11, JP12: Divider Disable; SolderJumper-2_P1.3mm_Bridged_RoundedPad1.0x1.5mm
Q21: AO3401A; SOT-23; Manufacture Part Number AO3401A; LCSC C15127
R1, R6, R47: 2k; R_0402_1005Metric; Manufacture Part Number 0402WGF2001TCE; LCSC C4109
R2, R3, R86: 1k; R_0402_1005Metric; Manufacture Part Number 0402WGF1001TCE; LCSC C11702
R4: 470r; R_0402_1005Metric; Manufacture Part Number 0402WGF4700TCE; LCSC C25117
R5, R82: 10k; R_0402_1005Metric; Manufacture Part Number 0402WGF1002TCE; LCSC C25744
R7, R8: 5.1k; R_0402_1005Metric; Manufacture Part Number 0402WGF5101TCE; LCSC C25905
R83: 22k; R_0402_1005Metric; LCSC C25768
S1: Reset Control; PinHeader_1x02_P2.54mm_Vertical
TP1, TP2, TP3, TP4: TestPoint; TestPoint_THT_D0.6mm_Drill0.3mm
U3: SRV05-4-P-T7; SOT-23-6; LCSC C85364
U4: CH340N; SOIC-8_3.9x4.9mm_P1.27mm; LCSC C2977777

Connections:
+5V: C8.2, C11.1, D8.1 (K), D22.1 (K), IC3.5 (VCC), J1.1, J1.2, Q21.2 (S), R82.1, R83.1, U4.5 (VCC); also elsewhere on the board
CH340-RX0: IC3.1 (I1), TP4.1 (1_1), U4.6 (RXD)
D+: J2.2, U3.1 (I/O_1), U4.1 (UD+)
D-: J2.3, U3.6 (I/O_4), U4.2 (UD-)
GND: C8.1, C9.2, C11.2, C12.2, C58.1, C59.1, D23.3 (common), D25.1 (K), IC3.2 (GND), J1.3, J1.4, J2.1, R1.2, R5.1, R6.2, R7.2, R8.1, S1.1, U3.2 (GND), U4.3 (GND); also elsewhere on the board
MC-D0-RX0: IC3.4 (Y), TP2.1 (1_1); also elsewhere on the board
MC-D1-TX0: R3.1, TP3.1 (1_1), U4.7 (TXD); also elsewhere on the board
MC-D14-TX3: R2.1; also elsewhere on the board
MC-D15-RX3: J1.5; also elsewhere on the board
MC-RESET: C10.2, C58.2, D22.2 (A), Q21.3 (D), R82.2; also elsewhere on the board
unnamed: D25.2 (A), R86.2
unnamed: IC3.6 (S), R4.1, R5.2
unnamed: J1.7, JP11.2 (B), R2.2
unnamed: J1.8, JP12.1 (A), R3.2
unnamed: J2.4, R7.1
unnamed: J2.5, R8.2
unnamed: JP11.1 (A), R6.1
unnamed: JP12.2 (B), R1.1
unnamed: Q21.1 (G), R47.2, R83.2
unnamed: C12.1, U4.8 (V3)
unnamed: C10.1, U4.4 (~RTS)
Proto-RX0: IC3.3 (I0), J1.6, TP1.1 (1_1)
RESET_LOCK: D23.2 (A2), R47.1, S1.2
VBus: C9.1, C59.2, D8.2 (A), J2.6, R4.2, R86.1, U3.5 (REF)

Notes on the sheet:
Serial0
TVS
VBUS input protection
Switch (IC4) autoselects MCU RX0: (USB) or (S0 proto) If VBUS is floating MCU RX0 set to proto If VBUS has positive voltage MCU RX0 set to CH340 IC
Protected on U2
Serial & USB
ECU Reset Control
Short RESET_LOCK to GND = prevent reset
Serial3
Serial0 to USB
USB Connector
Serial Proto

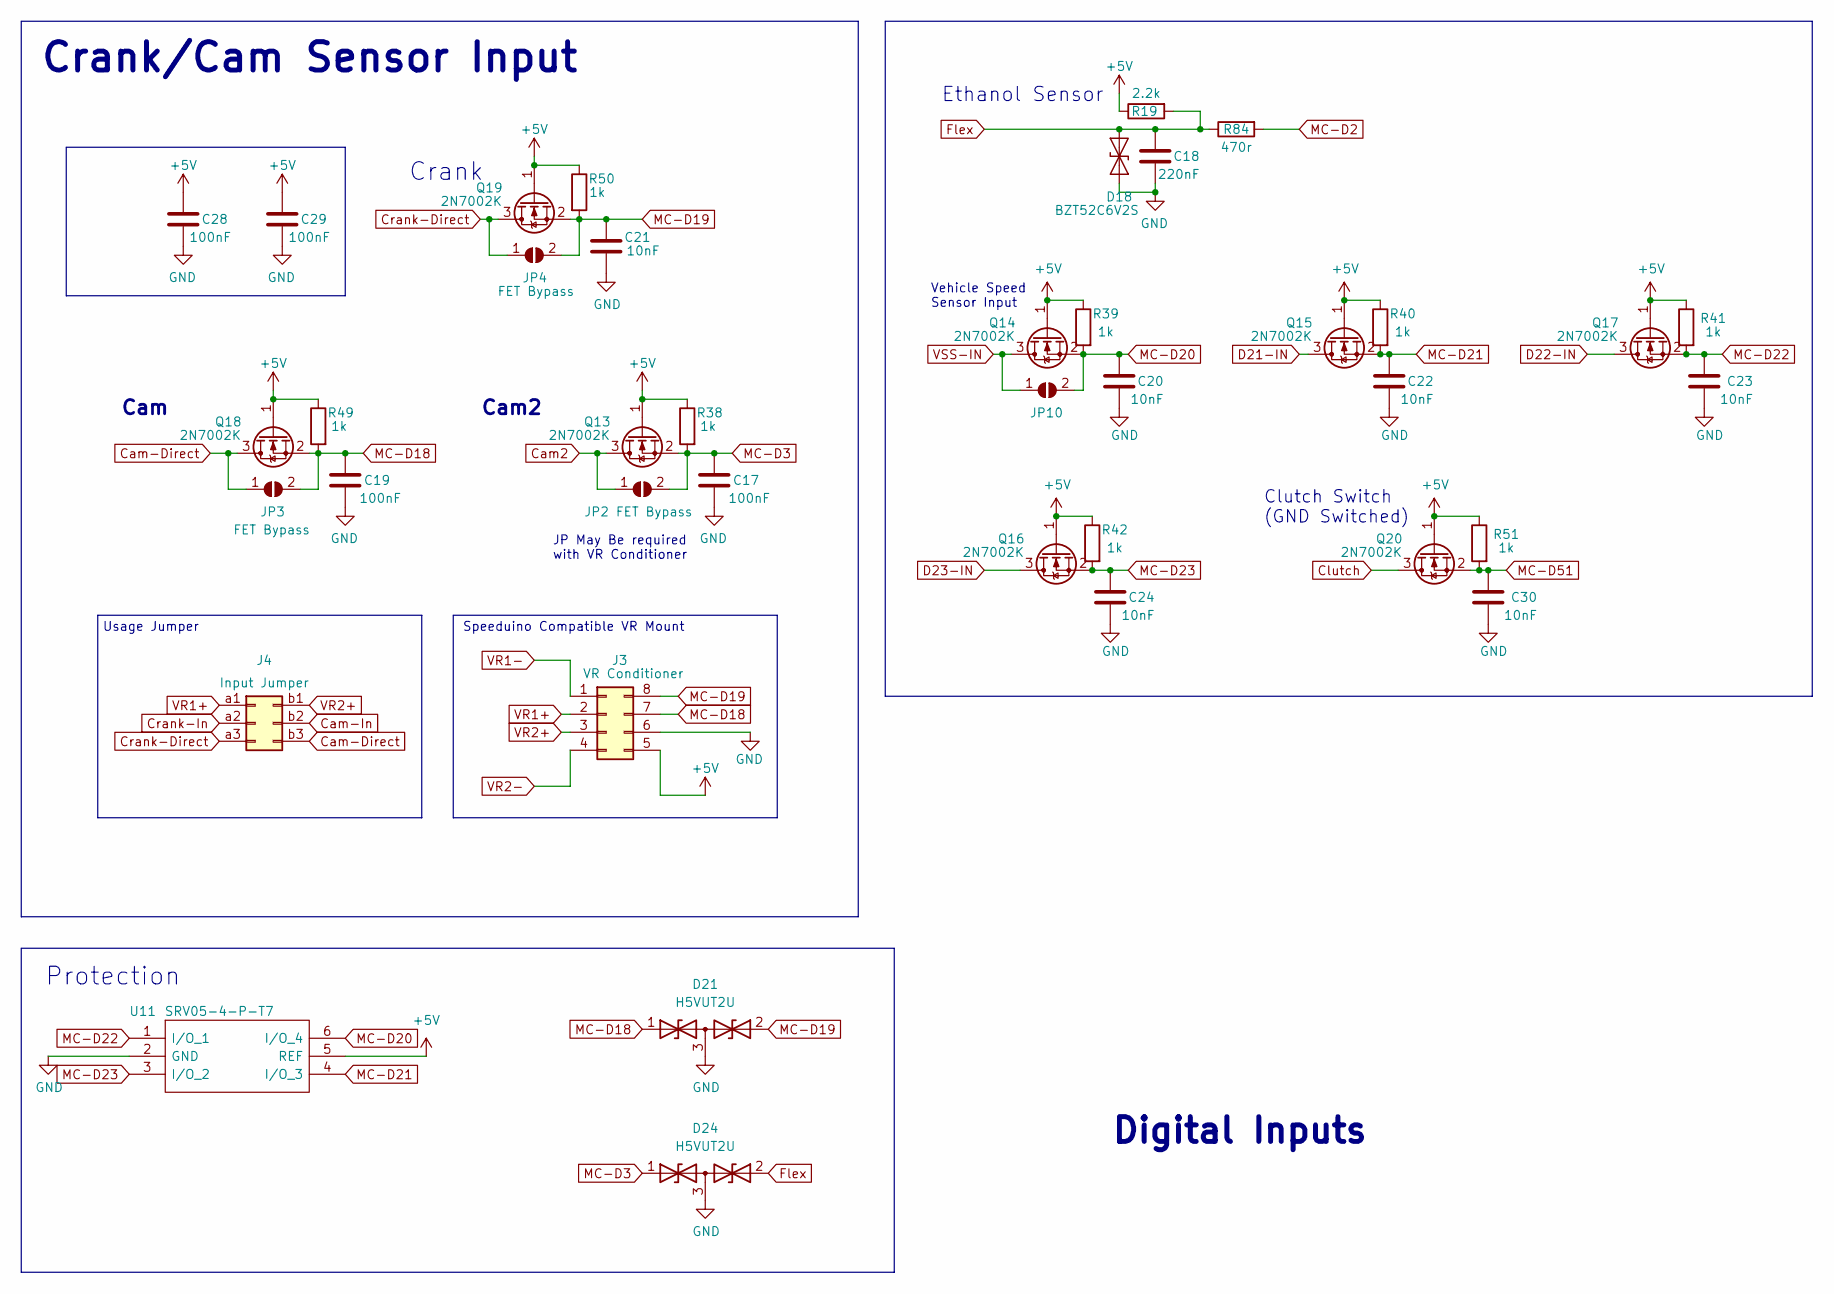
[picture p104: schematic digital-inputs.kicad_sch, Closed Deck X4]

Parts:
C17, C19, C28, C29: 100nF; C_0402_1005Metric; LCSC C307331
C18: 220nF; C_0402_1005Metric; LCSC C16772
C20, C21, C22, C23, C24, C30: 10nF; C_0402_1005Metric; Manufacture Part Number CL05B103KB5NNNC; LCSC C15195
D18: BZT52C6V2S; D_SOD-323; LCSC C19077442
D21, D24: H5VUT2U; SOT-23; LCSC C20615824
J3: VR Conditioner; Socket_VRConditioner_Corrected
J4: Input Jumper; PinHeader2x03_Jumper
JP2, JP3, JP4, JP10: FET Bypass; SolderJumper-2_P1.3mm_Open_RoundedPad1.0x1.5mm
Q13, Q14, Q15, Q16, Q17, Q18, Q19, Q20: 2N7002K; SOT-23; Manufacture Part Number 2N7002K; LCSC C22379475
R19: 2.2k; R_0402_1005Metric; Manufacture Part Number 0402WGF2201TCE; LCSC C25879
R38, R39, R40, R41, R42, R49, R50, R51: 1k; R_0402_1005Metric; Manufacture Part Number 0402WGF1001TCE; LCSC C11702
R84: 470r; R_0402_1005Metric; Manufacture Part Number 0402WGF4700TCE; LCSC C25117
U11: SRV05-4-P-T7; SOT-23-6; LCSC C85364

Connections:
+5V: C28.2, C29.2, J3.5, Q13.1 (G), Q14.1 (G), Q15.1 (G), Q16.1 (G), Q17.1 (G), Q18.1 (G), Q19.1 (G), Q20.1 (G), R19.1, R38.1, R39.1, R40.1, R41.1, R42.1, R49.1, R50.1, R51.1, U11.5 (REF); also elsewhere on the board
Cam2: JP2.1 (A), Q13.3 (D); also elsewhere on the board
Cam-Direct: J4.b3, JP3.1 (A), Q18.3 (D)
Cam-In: J4.b2; also elsewhere on the board
Clutch: Q20.3 (D); also elsewhere on the board
Crank-Direct: J4.a3, JP4.1 (A), Q19.3 (D)
Crank-In: J4.a2; also elsewhere on the board
D21-IN: Q15.3 (D); also elsewhere on the board
D22-IN: Q17.3 (D); also elsewhere on the board
D23-IN: Q16.3 (D); also elsewhere on the board
Flex: C18.1, D18.1 (A1), D24.2 (A2), R19.2, R84.1; also elsewhere on the board
GND: C17.1, C18.2, C19.1, C20.2, C21.1, C22.2, C23.2, C24.2, C28.1, C29.1, C30.2, D18.2 (A2), D21.3 (common), D24.3 (common), J3.6, U11.2 (GND); also elsewhere on the board
MC-D2: R84.2; also elsewhere on the board
MC-D3: C17.2, D24.1 (A1), JP2.2 (B), Q13.2 (S), R38.2; also elsewhere on the board
MC-D18: C19.2, D21.1 (A1), J3.7, JP3.2 (B), Q18.2 (S), R49.2; also elsewhere on the board
MC-D19: C21.2, D21.2 (A2), J3.8, JP4.2 (B), Q19.2 (S), R50.2; also elsewhere on the board
MC-D20: C20.1, JP10.2 (B), Q14.2 (S), R39.2, U11.6 (I/O_4); also elsewhere on the board
MC-D21: C22.1, Q15.2 (S), R40.2, U11.4 (I/O_3); also elsewhere on the board
MC-D22: C23.1, Q17.2 (S), R41.2, U11.1 (I/O_1); also elsewhere on the board
MC-D23: C24.1, Q16.2 (S), R42.2, U11.3 (I/O_2); also elsewhere on the board
MC-D51: C30.1, Q20.2 (S), R51.2; also elsewhere on the board
VR1+: J3.2, J4.a1
VR1-: J3.1; also elsewhere on the board
VR2+: J3.3, J4.b1
VR2-: J3.4; also elsewhere on the board
VSS-IN: JP10.1 (A), Q14.3 (D); also elsewhere on the board

Notes on the sheet:
Vehicle Speed Sensor Input
JP May Be required with VR Conditioner
Protection
Cam
Speeduino Compatible VR Mount
Clutch Switch (GND Switched)
Ethanol Sensor
Usage Jumper
Crank
Crank/Cam Sensor Input
Cam2
Digital Inputs
