OpenLogicEFI/Hardware/Engine Managment/Closed Deck/Closed Deck x4/RevB2/closed-deck-x4.kicad_pcb

## KiCad design Engine Managment/Closed Deck/Closed Deck x4/RevB2/closed-deck-x4.kicad_pcb (continued)

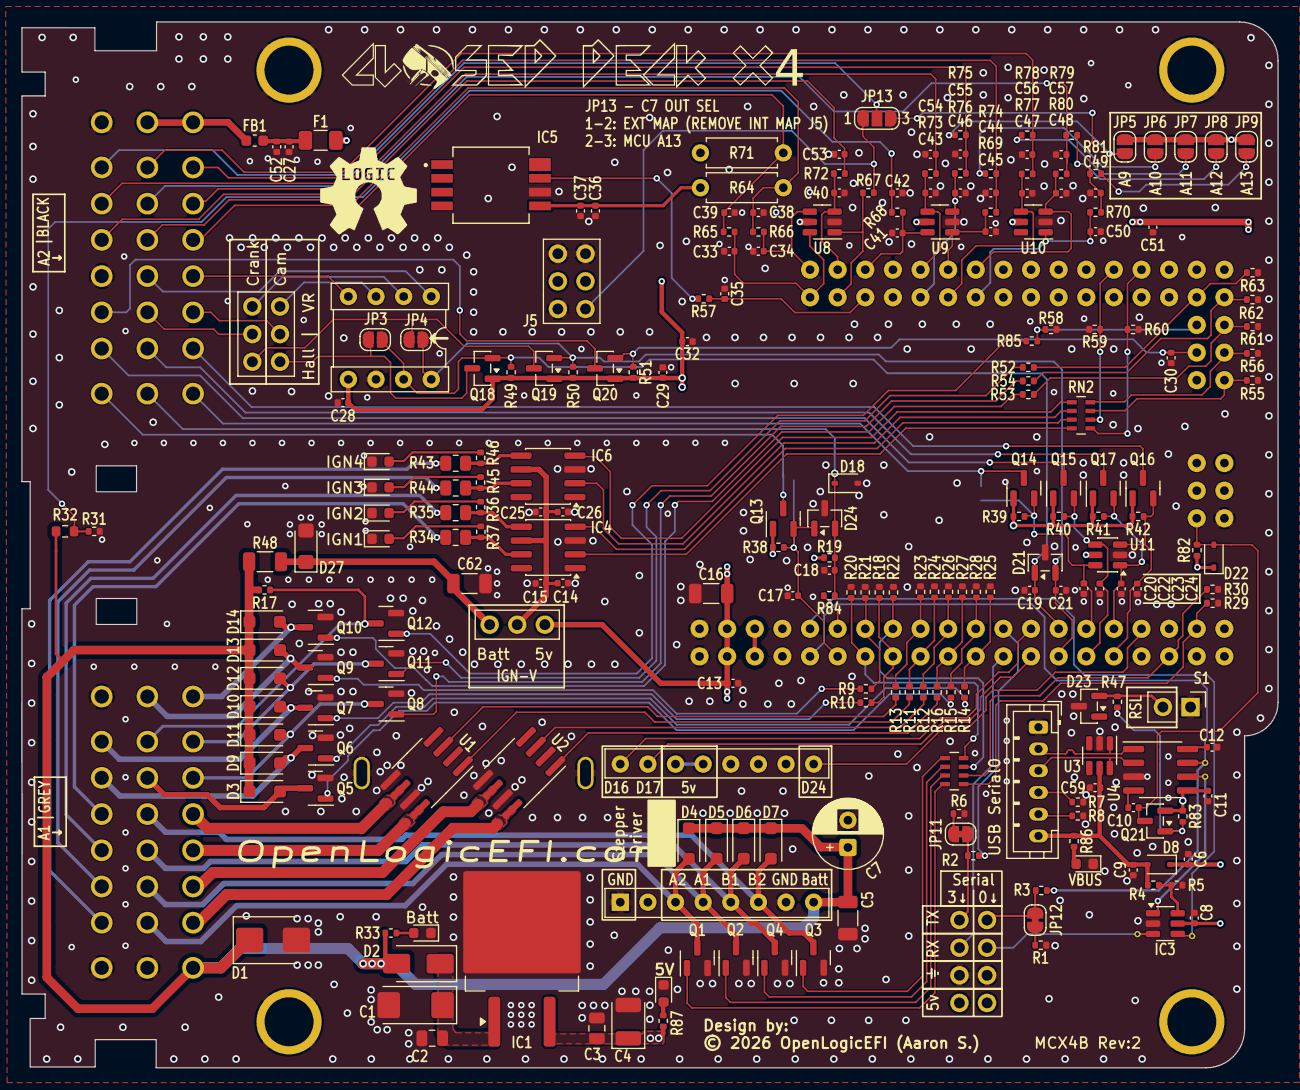
[picture p105: board Engine Managment/Closed Deck/Closed Deck x4/RevB2/closed-deck-x4.kica… from above]

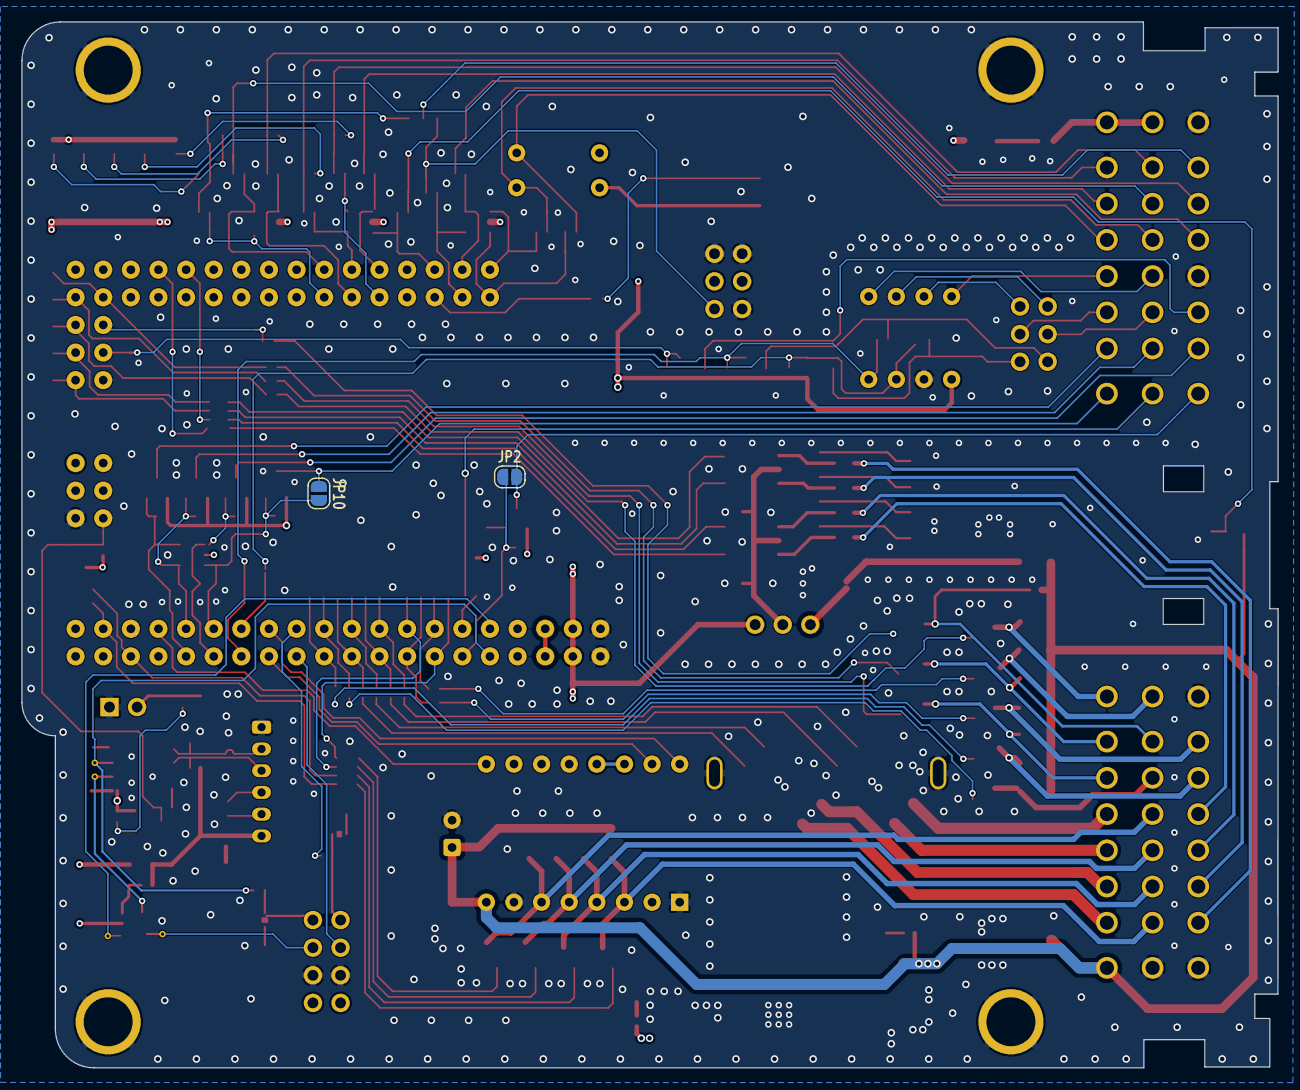
[picture p106: board Engine Managment/Closed Deck/Closed Deck x4/RevB2/closed-deck-x4.kica… from below]

Board: 4 copper layers, 115.5 x 96.2 mm, 243 parts (2 on the bottom side), 158 nets.
