OpenLogicEFI/Hardware/Modules/Ignition Control Module/ICM2/RevB/ICM.kicad_pcb

## KiCad design Modules/Ignition Control Module/ICM2/RevB/ICM.kicad_pcb (2026-06-21)

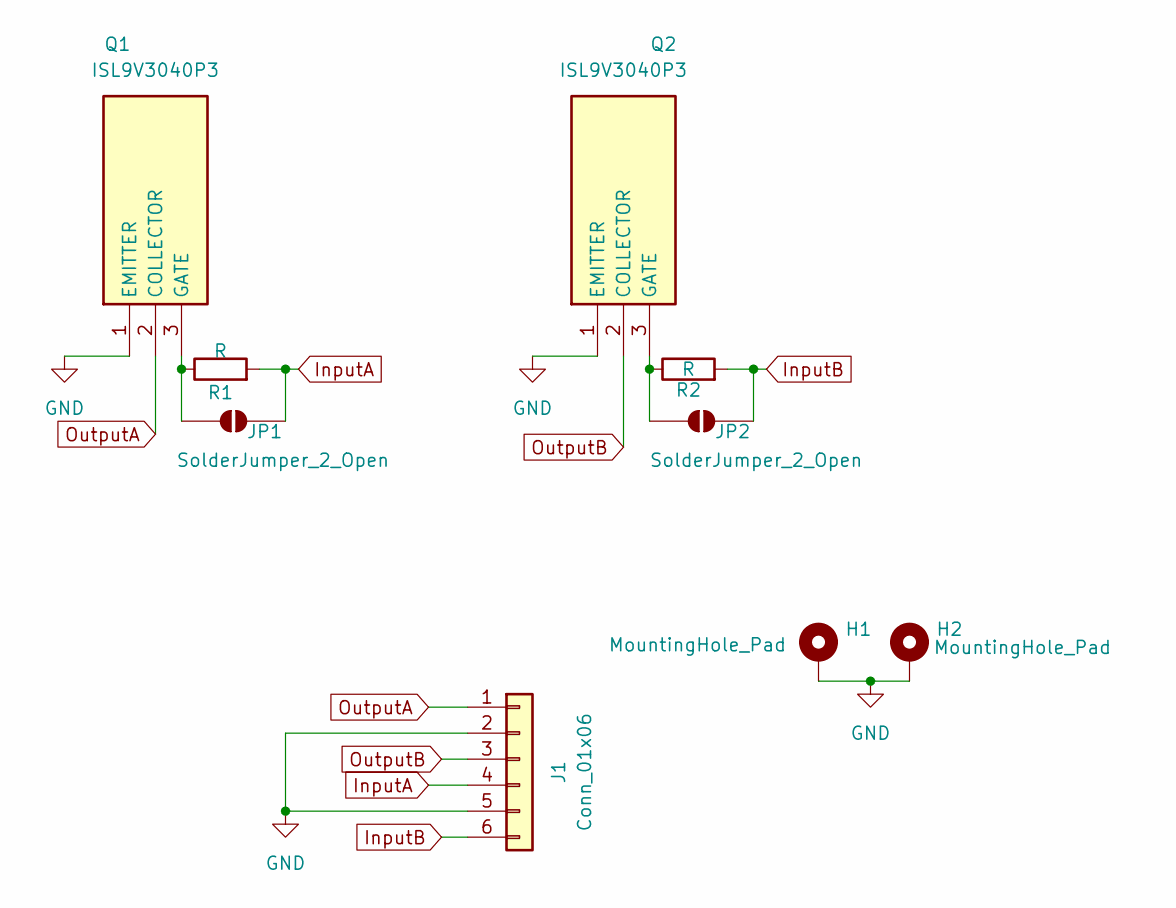
[picture p107: schematic ICM.kicad_sch, ICM2a]

Parts:
H1, H2: MountingHole_Pad; MountingHole_3.2mm_M3_DIN965_Pad_TopBottom
J1: Conn_01x06; Molex_Mini-Fit_Jr_5569-06A2_2x03_P4.20mm_Horizontal
JP1, JP2: SolderJumper_2_Open; SolderJumper-2_P1.3mm_Bridged_RoundedPad1.0x1.5mm
Q1, Q2: ISL9V3040P3; TO-252-2-frontThermalOnly; Manufacturer_Part_Number ISL9V3040P3; Mouser Part Number 512-ISL9V3040P3
R1, R2: R; R_Axial_DIN0207_L6.3mm_D2.5mm_P10.16mm_Horizontal

Connections:
GND: H1.1 (1_1), H2.1 (1_1), J1.2, J1.5, Q1.1 (EMITTER), Q2.1 (EMITTER)
InputA: J1.4, JP1.2 (B), R1.2
InputB: J1.6, JP2.2 (B), R2.2
unnamed: JP1.1 (A), Q1.3 (GATE), R1.1
unnamed: JP2.1 (A), Q2.3 (GATE), R2.1
OutputA: J1.1, Q1.2 (COLLECTOR)
OutputB: J1.3, Q2.2 (COLLECTOR)

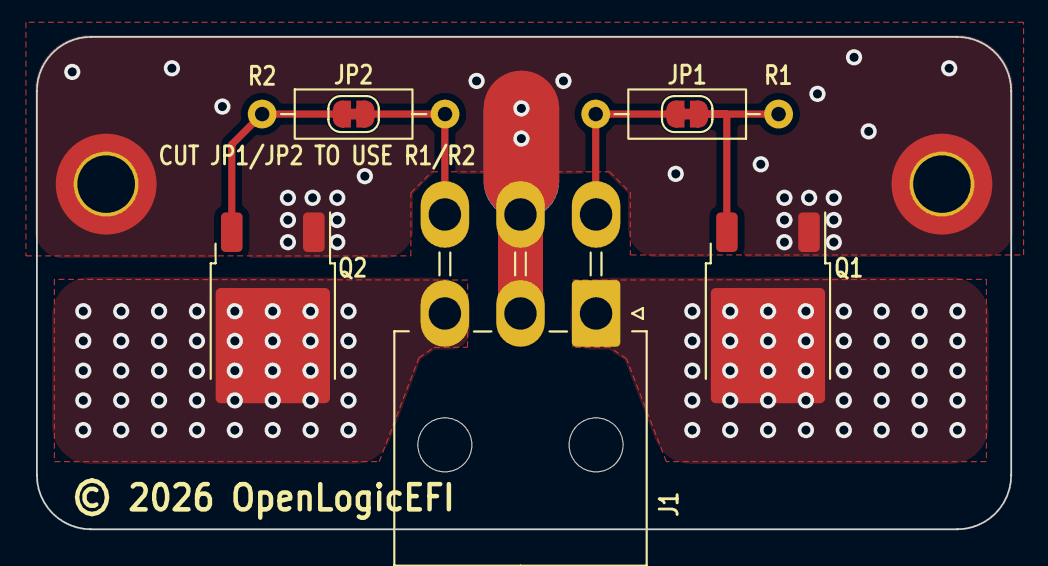
[picture p108: board ICM.kicad_pcb from above]

Board: 2 copper layers, 54.1 x 27.4 mm, 9 parts (0 on the bottom side), 7 nets.
