OpenLogicEFI/Hardware/Engine Managment/Pre-Ignition/Pre-Ignition x2/MX2B/Pre_Ignition.kicad_pcb

## KiCad design Engine Managment/Pre-Ignition/Pre-Ignition x2/MX2B/Pre_Ignition.kicad_pcb (2026-06-21)

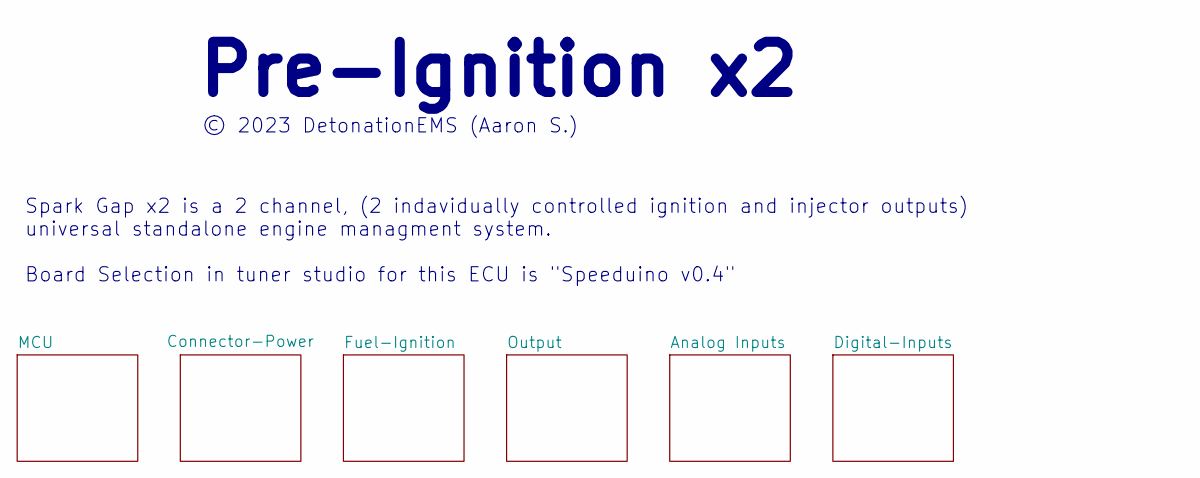
[picture p109: schematic Pre_Ignition.kicad_sch, Pre-Ignition X2]

Notes on the sheet:
Pre-Ignition x2
Spark Gap x2 is a 2 channel, (2 indavidually controlled ignition and injector outputs) universal standalone engine managment system. Board Selection in tuner studio for this ECU is "Speeduino v0.4"
© 2023 DetonationEMS (Aaron S.)

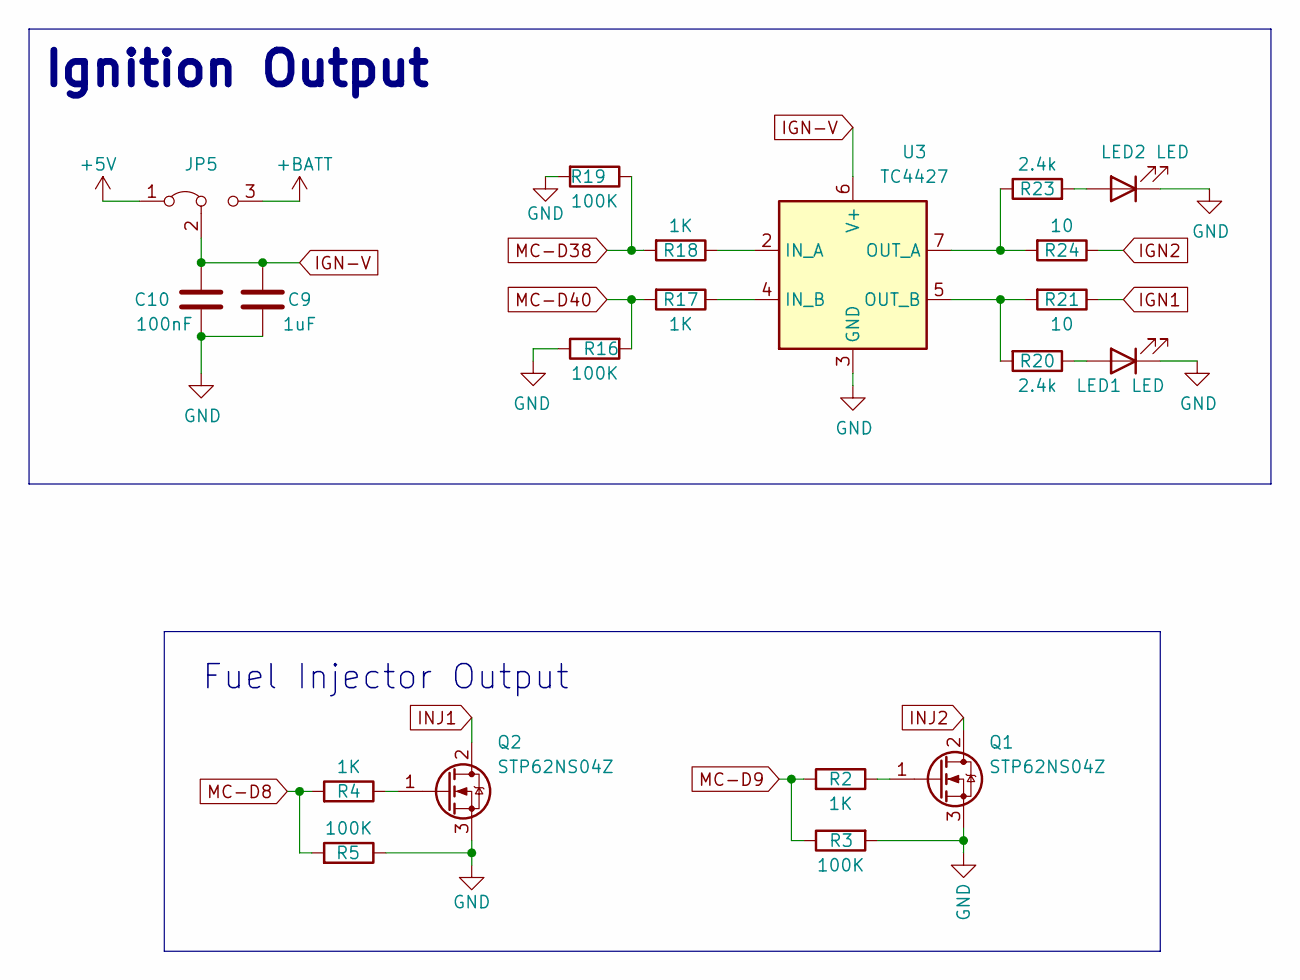
[picture p110: schematic Fuel-Ignition.kicad_sch, Pre-Ignition X2]

Parts:
C9: 1uF; C_0603_1608Metric; LCSC C15849
C10: 100nF; C_0603_1608Metric; LCSC C14663
JP5: Jumper_3_Bridged12; SolderJumper-3_P1.3mm_Bridged12_RoundedPad1.0x1.5mm_NumberL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
LED1, LED2: LED; LED_0603_1608Metric; LCSC C2286
Q1: STP62NS04Z; TO-220-3_Vertical; Manufacturer_Part_Number STP62NS04Z; Mouser Part Number 511-STP62NS04Z
Q2: STP62NS04Z; TO-220-3_Vertical; Manufacturer_Part_Number STP62NS04Z
R2, R4, R17, R18: 1K; R_0603_1608Metric; LCSC C21190
R3, R5, R16, R19: 100K; R_0603_1608Metric; LCSC C25803
R20, R23: 2.4k; R_0603_1608Metric; LCSC C22940
R21, R24: 10; R_1206_3216Metric; LCSC C17903
U3: TC4427; SOIC-8_3.9x4.9mm_P1.27mm; LCSC C31450

Connections:
+5V: JP5.1 (A); also elsewhere on the board
+BATT: JP5.3 (B); also elsewhere on the board
GND: C9.2, C10.2, LED1.1 (K), LED2.1 (K), Q1.3 (S), Q2.3 (S), R3.2, R5.1, R16.1, R19.2, U3.3 (GND); also elsewhere on the board
IGN1: R21.1; also elsewhere on the board
IGN2: R24.1; also elsewhere on the board
IGN-V: C9.1, C10.1, JP5.2 (C), U3.6 (V+)
INJ1: Q2.2 (D); also elsewhere on the board
INJ2: Q1.2 (D); also elsewhere on the board
MC-D8: R4.2, R5.2; also elsewhere on the board
MC-D9: R2.2, R3.1; also elsewhere on the board
MC-D38: R18.2, R19.1; also elsewhere on the board
MC-D40: R16.2, R17.2; also elsewhere on the board
unnamed: LED1.2 (A), R20.1
unnamed: LED2.2 (A), R23.2
unnamed: Q1.1 (G), R2.1
unnamed: Q2.1 (G), R4.1
unnamed: R18.1, U3.2 (IN_A)
unnamed: R17.1, U3.4 (IN_B)
unnamed: R23.1, R24.2, U3.7 (OUT_A)
unnamed: R20.2, R21.2, U3.5 (OUT_B)

Notes on the sheet:
Ignition Output
Fuel Injector Output

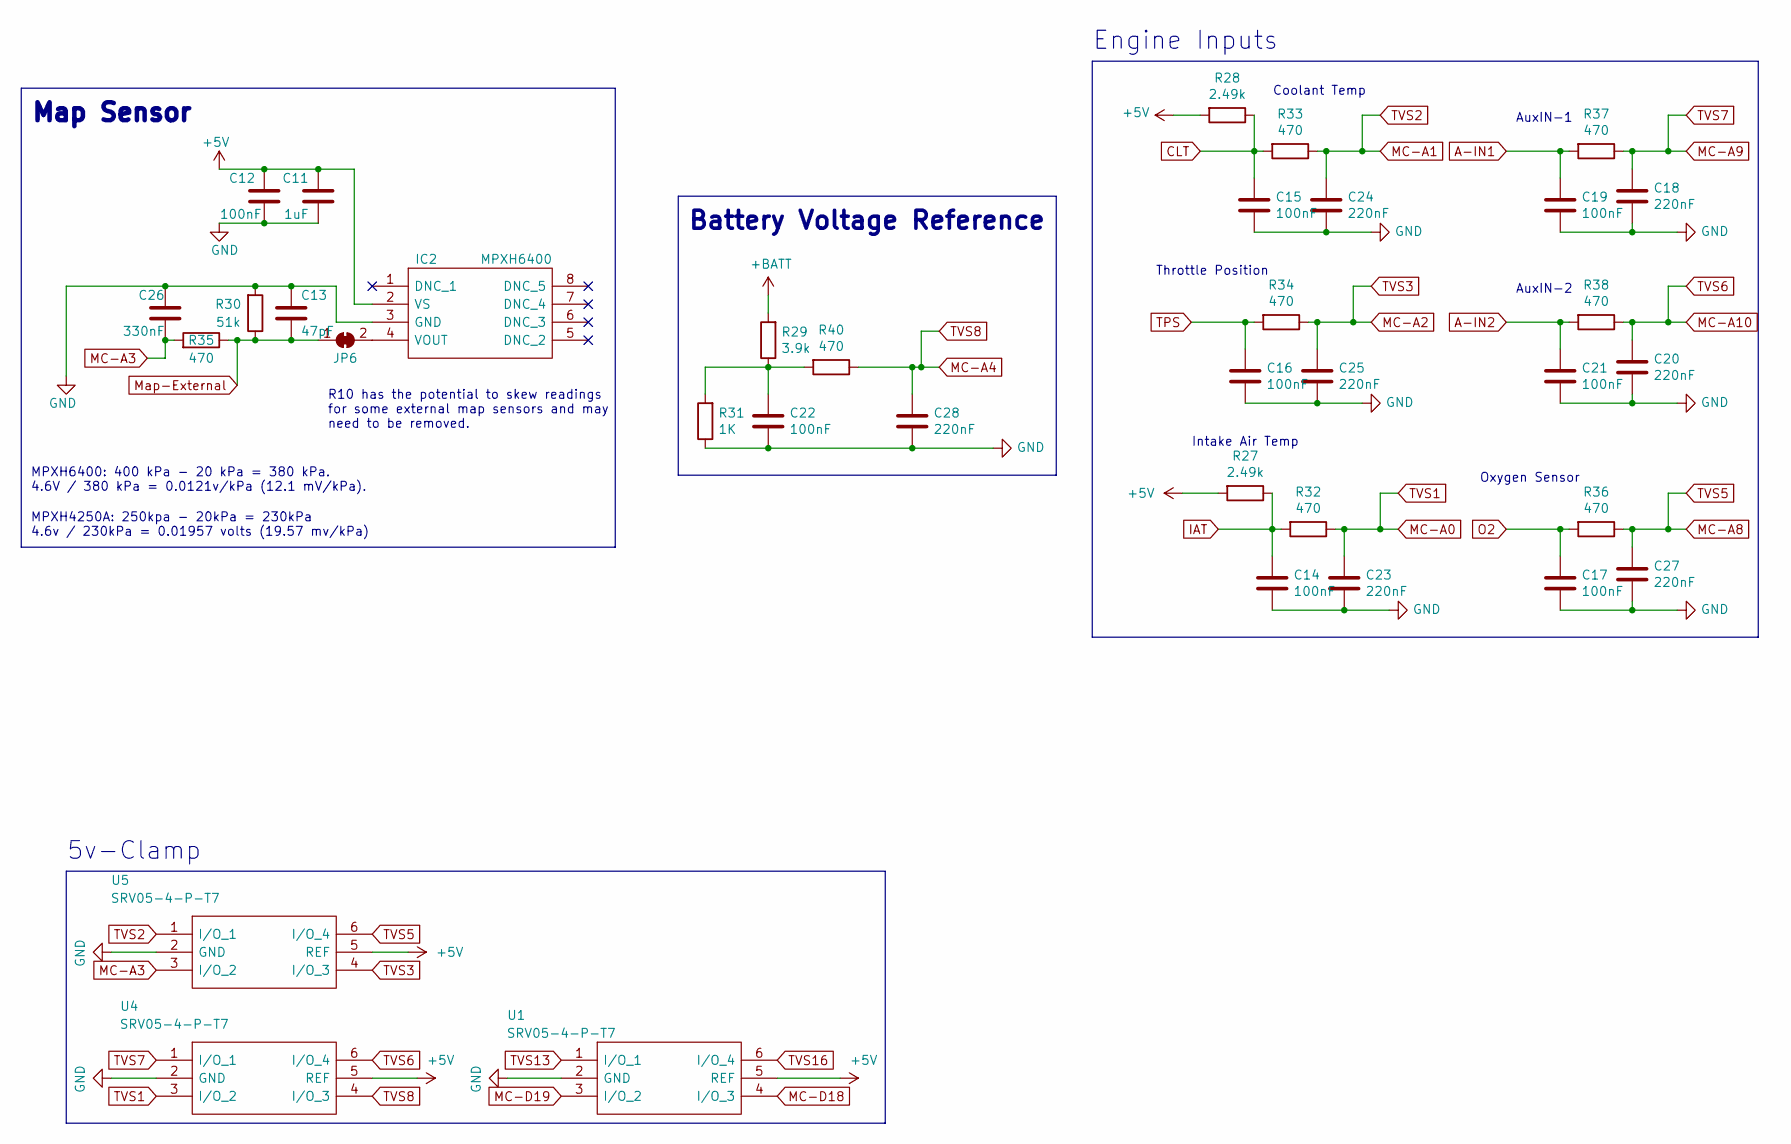
[picture p111: schematic Analog.kicad_sch, Pre-Ignition X2]

Parts:
C11: 1uF; C_0603_1608Metric; LCSC C15849
C12, C14, C15, C16, C17, C19, C21, C22: 100nF; C_0603_1608Metric; LCSC C14663
C13: 47pF; C_0603_1608Metric; LCSC C1671
C18, C20, C23, C24, C25, C27, C28: 220nF; C_0603_1608Metric; LCSC C5378
C26: 330nF; C_0603_1608Metric; LCSC C1615
IC2: MPXH6400; MPXH6250; Manufacturer_Part_Number MPXH6250AC6U; Mouser Part Number 841-MPXH6250AC6U
JP6: SolderJumper-2_P1.3mm_Bridged_RoundedPad1.0x1.5mm
R27, R28: 2.49k; R_0603_1608Metric; LCSC C309658
R29: 3.9k; R_0603_1608Metric; LCSC C23018
R30: 51k; R_0603_1608Metric; LCSC C23196
R31: 1K; R_0603_1608Metric; LCSC C21190
R32, R33, R34, R35, R36, R37, R38, R40: 470; R_0603_1608Metric; LCSC C23179
U1, U4, U5: SRV05-4-P-T7; SOT-23-6; LCSC C85364

Connections:
+5V: C11.2, C12.1, IC2.2 (VS), R27.2, R28.2, U1.5 (REF), U4.5 (REF), U5.5 (REF); also elsewhere on the board
+BATT: R29.2; also elsewhere on the board
A-IN1: C19.1, R37.2; also elsewhere on the board
A-IN2: C21.1, R38.2; also elsewhere on the board
CLT: C15.1, R28.1, R33.2; also elsewhere on the board
GND: C11.1, C12.2, C13.2, C14.2, C15.2, C16.2, C17.2, C18.2, C19.2, C20.2, C21.2, C22.2, C23.2, C24.2, C25.2, C26.1, C27.2, C28.2, IC2.3 (GND), R30.2, R31.1, U1.2 (GND), U4.2 (GND), U5.2 (GND); also elsewhere on the board
IAT: C14.1, R27.1, R32.2; also elsewhere on the board
MC-A0: C23.1, R32.1, U4.3 (I/O_2); also elsewhere on the board
MC-A1: C24.1, R33.1, U5.1 (I/O_1); also elsewhere on the board
MC-A2: C25.1, R34.1, U5.4 (I/O_3); also elsewhere on the board
MC-A3: C26.2, R35.2, U5.3 (I/O_2); also elsewhere on the board
MC-A4: C28.1, R40.1, U4.4 (I/O_3); also elsewhere on the board
MC-A8: C27.1, R36.1, U5.6 (I/O_4); also elsewhere on the board
MC-A9: C18.1, R37.1, U4.1 (I/O_1); also elsewhere on the board
MC-A10: C20.1, R38.1, U4.6 (I/O_4); also elsewhere on the board
MC-D18: U1.4 (I/O_3); also elsewhere on the board
MC-D19: U1.3 (I/O_2); also elsewhere on the board
Map-External: C13.1, JP6.1 (A), R30.1, R35.1; also elsewhere on the board
unnamed: C22.1, R29.1, R31.2, R40.2
unnamed: IC2.4 (VOUT), JP6.2 (B)
O2: C17.1, R36.2; also elsewhere on the board
TPS: C16.1, R34.2; also elsewhere on the board
TVS13: U1.1 (I/O_1)
TVS16: U1.6 (I/O_4)

Notes on the sheet:
R10 has the potential to skew readings for some external map sensors and may need to be removed.
5v-Clamp
Coolant Temp
Oxygen Sensor
Engine Inputs
AuxIN-2
Battery Voltage Reference
Map Sensor
MPXH4250A: 250kpa - 20kPa = 230kPa 4.6v / 230kPa = 0.01957 volts (19.57 mv/kPa)
MPXH6400: 400 kPa - 20 kPa = 380 kPa. 4.6V / 380 kPa = 0.0121v/kPa (12.1 mV/kPa).
Intake Air Temp
Throttle Position
AuxIN-1

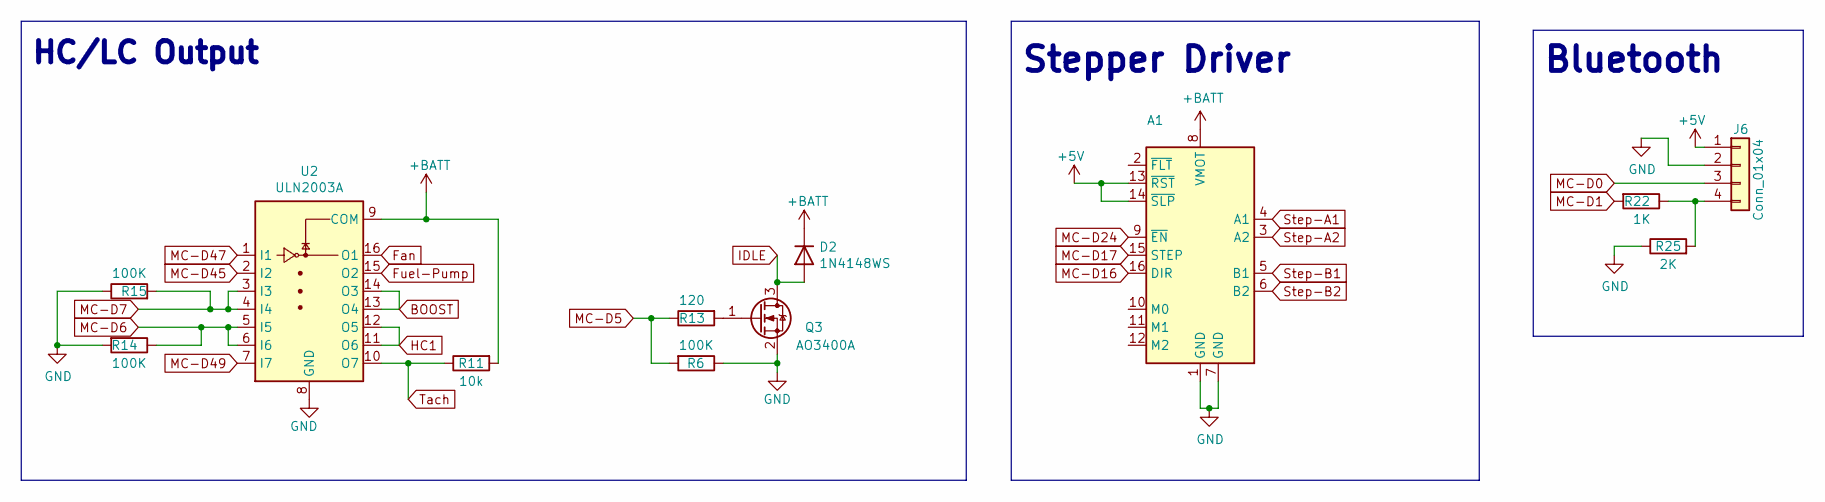
[picture p112: schematic Output.kicad_sch, Pre-Ignition X2]

Parts:
A1: Pololu_Breakout_DRV8825; DVR8825-Labeled-Front
D2: 1N4148WS; D_SOD-323F; LCSC C2128
J6: Conn_01x04; 1X4-PROTO
Q3: AO3400A; SOT-23; LCSC C20917
R6, R14, R15: 100K; R_0603_1608Metric; LCSC C25803
R11: 10k; R_0603_1608Metric; LCSC C25804
R13: 120; R_0603_1608Metric; LCSC C22787
R22: 1K; R_0603_1608Metric; LCSC C21190
R25: 2K; R_0603_1608Metric; LCSC C22975
U2: ULN2003A; SOIC-16_3.9x9.9mm_P1.27mm; LCSC C7512

Connections:
+5V: A1.13 (~RST), A1.14 (~SLP), J6.1; also elsewhere on the board
+BATT: A1.8 (VMOT), D2.1 (K), R11.2, U2.9 (COM); also elsewhere on the board
BOOST: U2.13 (O4), U2.14 (O3); also elsewhere on the board
Fan: U2.16 (O1); also elsewhere on the board
Fuel-Pump: U2.15 (O2); also elsewhere on the board
GND: A1.1 (GND), A1.7 (GND), J6.2, Q3.2 (S), R6.1, R14.2, R15.1, R25.1, U2.8 (GND); also elsewhere on the board
HC1: U2.11 (O6), U2.12 (O5); also elsewhere on the board
IDLE: D2.2 (A), Q3.3 (D); also elsewhere on the board
MC-D0: J6.3; also elsewhere on the board
MC-D1: R22.2; also elsewhere on the board
MC-D5: R6.2, R13.1; also elsewhere on the board
MC-D6: R14.1, U2.5 (I5), U2.6 (I6); also elsewhere on the board
MC-D7: R15.2, U2.3 (I3), U2.4 (I4); also elsewhere on the board
MC-D16: A1.16 (DIR); also elsewhere on the board
MC-D17: A1.15 (STEP); also elsewhere on the board
MC-D24: A1.9 (~EN); also elsewhere on the board
MC-D45: U2.2 (I2); also elsewhere on the board
MC-D47: U2.1 (I1); also elsewhere on the board
MC-D49: U2.7 (I7); also elsewhere on the board
unnamed: J6.4, R22.1, R25.2
unnamed: Q3.1 (G), R13.2
Step-A1: A1.4 (A1); also elsewhere on the board
Step-A2: A1.3 (A2); also elsewhere on the board
Step-B1: A1.5 (B1); also elsewhere on the board
Step-B2: A1.6 (B2); also elsewhere on the board
Tach: R11.1, U2.10 (O7); also elsewhere on the board

Notes on the sheet:
Bluetooth
Stepper Driver
HC/LC Output

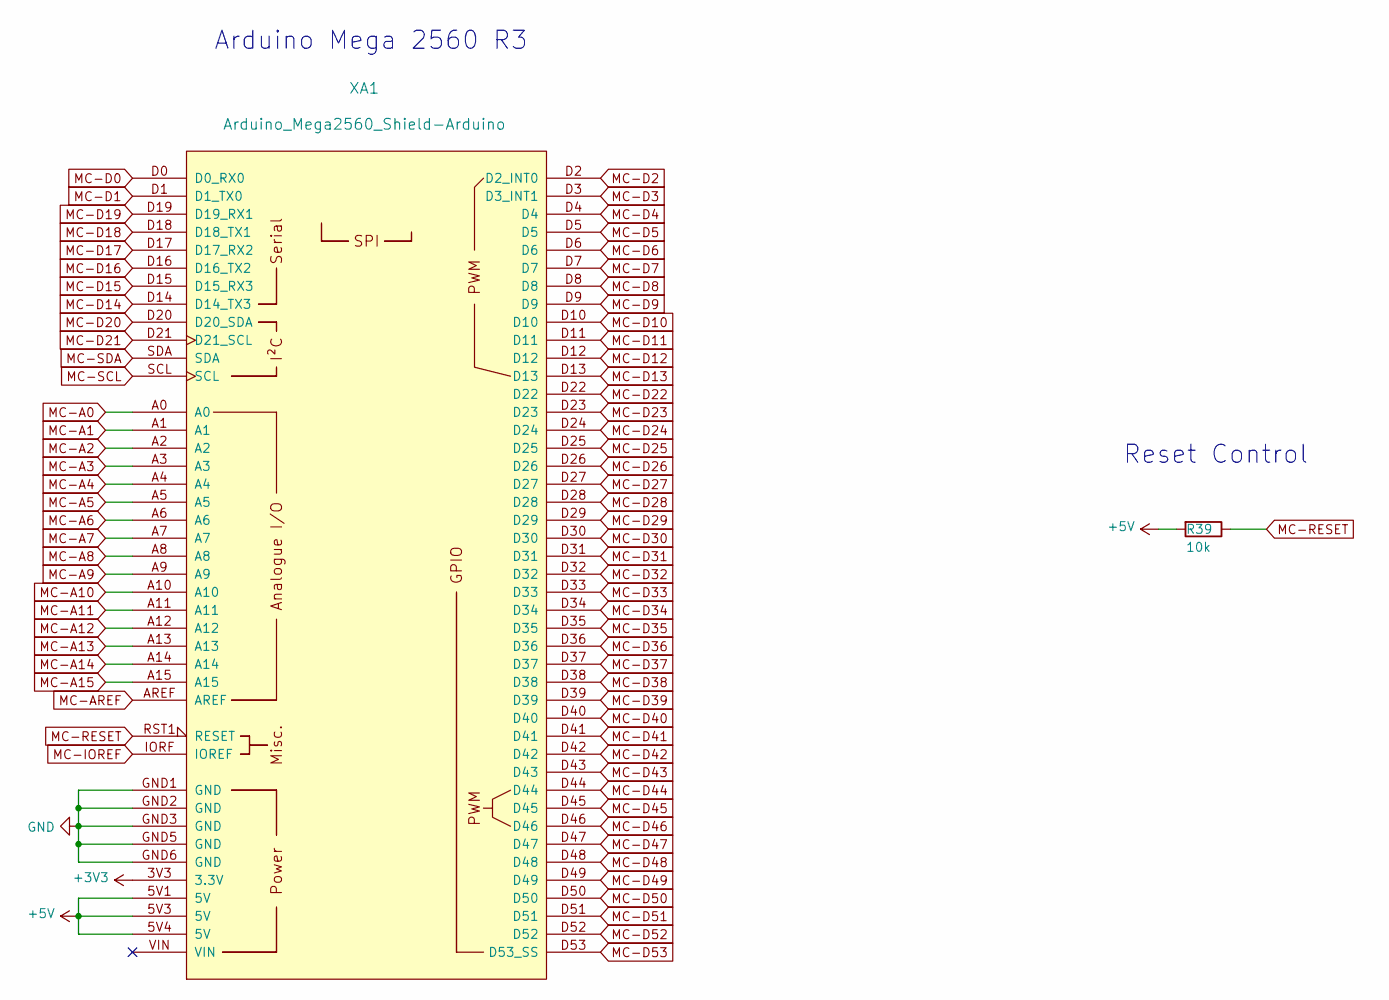
[picture p113: schematic mcu.kicad_sch, Pre-Ignition X2]

Parts:
R39: 10k; R_0603_1608Metric; LCSC C25804
XA1: Arduino_Mega2560_Shield-Arduino; Arduino_Mega2560_Shield_IO_Only_No_Silk_Screen

Connections:
+3V3: XA1.3V3 (3.3V)
+5V: R39.2, XA1.5V1 (5V), XA1.5V3 (5V), XA1.5V4 (5V); also elsewhere on the board
Flex: XA1.D2 (D2_INT0); also elsewhere on the board
GND: XA1.GND1 (GND), XA1.GND2 (GND), XA1.GND3 (GND), XA1.GND5 (GND), XA1.GND6 (GND); also elsewhere on the board
MC-A0: XA1.A0; also elsewhere on the board
MC-A1: XA1.A1; also elsewhere on the board
MC-A2: XA1.A2; also elsewhere on the board
MC-A3: XA1.A3; also elsewhere on the board
MC-A4: XA1.A4; also elsewhere on the board
MC-A5: XA1.A5
MC-A6: XA1.A6
MC-A7: XA1.A7
MC-A8: XA1.A8; also elsewhere on the board
MC-A9: XA1.A9; also elsewhere on the board
MC-A10: XA1.A10; also elsewhere on the board
MC-A11: XA1.A11
MC-A12: XA1.A12
MC-A13: XA1.A13
MC-A14: XA1.A14
MC-A15: XA1.A15
MC-AREF: XA1.AREF
MC-D0: XA1.D0 (D0_RX0); also elsewhere on the board
MC-D1: XA1.D1 (D1_TX0); also elsewhere on the board
MC-D3: XA1.D3 (D3_INT1)
MC-D4: XA1.D4
MC-D5: XA1.D5; also elsewhere on the board
MC-D6: XA1.D6; also elsewhere on the board
MC-D7: XA1.D7; also elsewhere on the board
MC-D8: XA1.D8; also elsewhere on the board
MC-D9: XA1.D9; also elsewhere on the board
MC-D10: XA1.D10
MC-D11: XA1.D11
MC-D12: XA1.D12
MC-D13: XA1.D13
MC-D14: XA1.D14 (D14_TX3)
MC-D15: XA1.D15 (D15_RX3)
MC-D16: XA1.D16 (D16_TX2); also elsewhere on the board
MC-D17: XA1.D17 (D17_RX2); also elsewhere on the board
MC-D18: XA1.D18 (D18_TX1); also elsewhere on the board
MC-D19: XA1.D19 (D19_RX1); also elsewhere on the board
MC-D20: XA1.D20 (D20_SDA); also elsewhere on the board
MC-D21: XA1.D21 (D21_SCL)
MC-D22: XA1.D22
MC-D23: XA1.D23
MC-D24: XA1.D24; also elsewhere on the board
MC-D25: XA1.D25
MC-D26: XA1.D26
MC-D27: XA1.D27
MC-D28: XA1.D28
MC-D29: XA1.D29
MC-D30: XA1.D30
MC-D31: XA1.D31
MC-D32: XA1.D32
MC-D33: XA1.D33
MC-D34: XA1.D34
MC-D35: XA1.D35
MC-D36: XA1.D36
MC-D37: XA1.D37
MC-D38: XA1.D38; also elsewhere on the board
MC-D39: XA1.D39
MC-D40: XA1.D40; also elsewhere on the board
MC-D41: XA1.D41
MC-D42: XA1.D42
MC-D43: XA1.D43
MC-D44: XA1.D44
MC-D45: XA1.D45; also elsewhere on the board
MC-D46: XA1.D46
MC-D47: XA1.D47; also elsewhere on the board
MC-D48: XA1.D48
MC-D49: XA1.D49; also elsewhere on the board
MC-D50: XA1.D50
MC-D51: XA1.D51; also elsewhere on the board
MC-D52: XA1.D52
MC-D53: XA1.D53 (D53_SS)
MC-IOREF: XA1.IORF (IOREF)
MC-RESET: R39.1, XA1.RST1 (RESET)
MC-SCL: XA1.SCL
MC-SDA: XA1.SDA

Notes on the sheet:
Arduino Mega 2560 R3
Reset Control

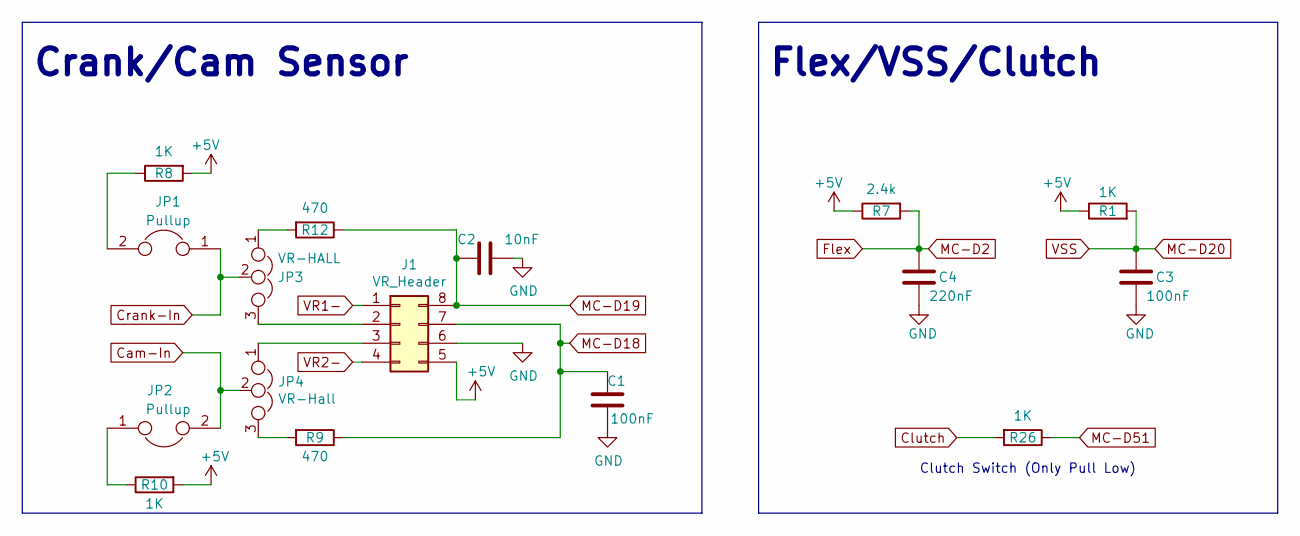
[picture p114: schematic digital.kicad_sch, Pre-Ignition X2]

Parts:
C1, C3: 100nF; C_0603_1608Metric; LCSC C14663
C2: 10nF; C_0603_1608Metric; LCSC C57112
C4: 220nF; C_0603_1608Metric; LCSC C5378
J1: VR_Header; DIP-8_W7.62mm_Socket_VRConditioner
JP1, JP2: Pullup; 1x02-Proto
JP3: VR-HALL; 3x1-GPIO
JP4: VR-Hall; 3x1-GPIO
R1, R8, R10, R26: 1K; R_0603_1608Metric; LCSC C21190
R7: 2.4k; R_0603_1608Metric; LCSC C22940
R9, R12: 470; R_0603_1608Metric; LCSC C23179

Connections:
+5V: J1.5, R1.1, R7.1, R8.2, R10.2; also elsewhere on the board
Cam-In: JP2.2, JP4.2; also elsewhere on the board
Clutch: R26.2; also elsewhere on the board
Crank-In: JP1.1, JP3.2; also elsewhere on the board
Flex: C4.1, R7.2; also elsewhere on the board
GND: C1.1, C2.1, C3.2, C4.2, J1.6; also elsewhere on the board
MC-D18: C1.2, J1.7, R9.1; also elsewhere on the board
MC-D19: C2.2, J1.8, R12.1; also elsewhere on the board
MC-D20: C3.1, R1.2; also elsewhere on the board
MC-D51: R26.1; also elsewhere on the board
unnamed: J1.2, JP3.3
unnamed: J1.3, JP4.1
unnamed: JP1.2, R8.1
unnamed: JP2.1, R10.1
unnamed: JP3.1, R12.2
unnamed: JP4.3, R9.2
VR1-: J1.1; also elsewhere on the board
VR2-: J1.4; also elsewhere on the board

Notes on the sheet:
Crank/Cam Sensor
Clutch Switch (Only Pull Low)
Flex/VSS/Clutch

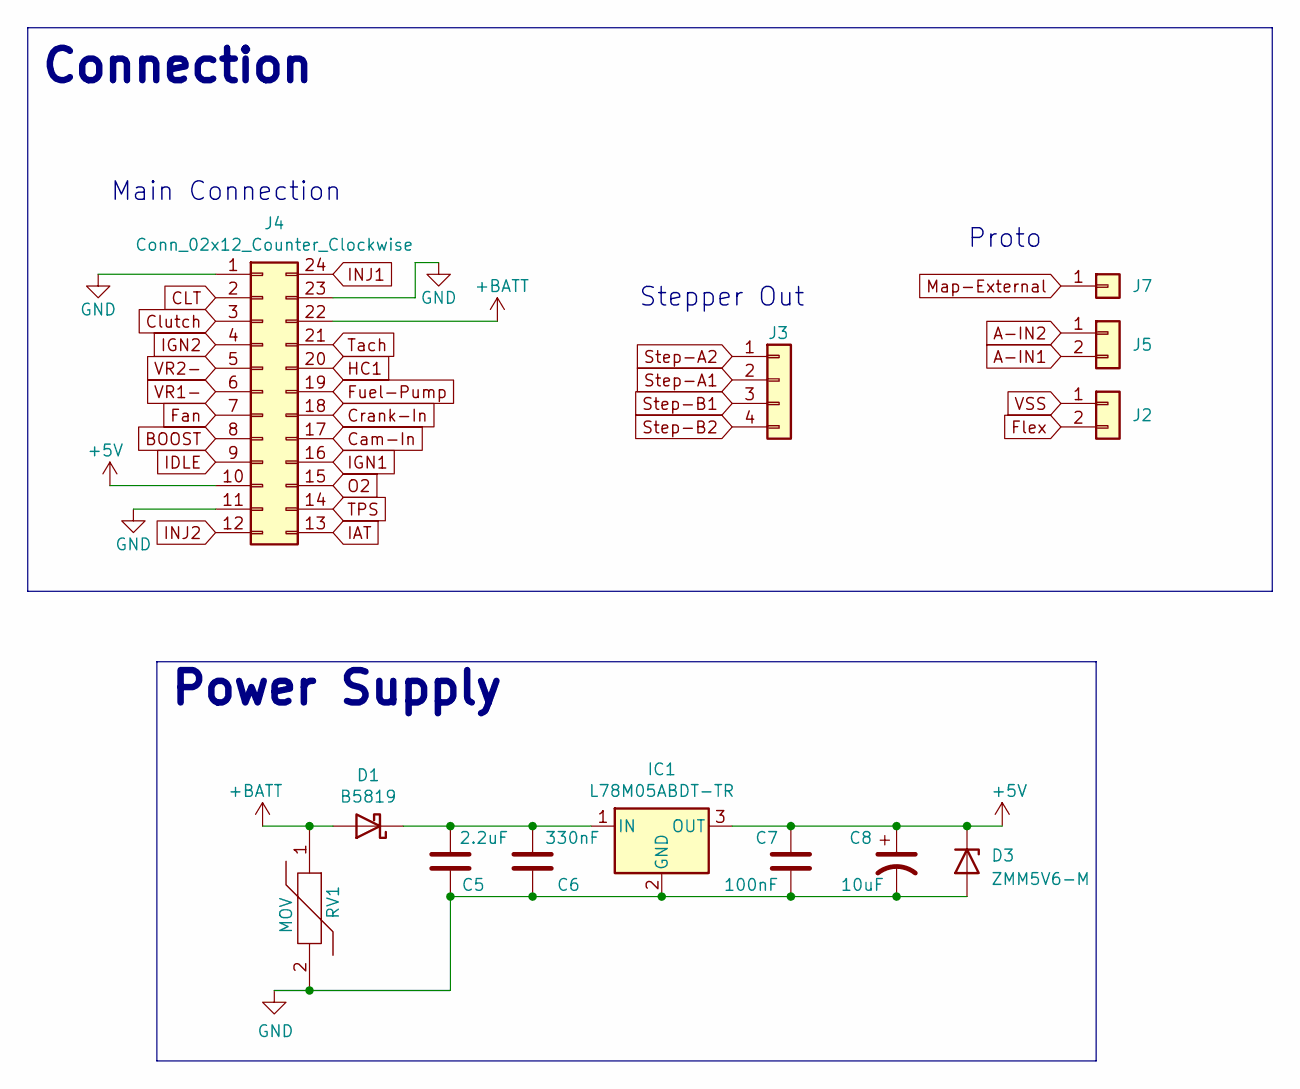
[picture p115: schematic connector-power.kicad_sch, Pre-Ignition X2]

Parts:
C5: 2.2uF; C_1206_3216Metric; Manufacture Part Number CL31B225KBHNNNE; LCSC C50254
C6: 330nF; C_0603_1608Metric; LCSC C1615
C7: 100nF; C_0603_1608Metric; LCSC C14663
C8: 10uF; CP_EIA-3216-18_Kemet-A; Manufacture Part Number TAJA106K016RNJ; LCSC C7171
D1: B5819; D_SOD-123; LCSC C8598
D3: ZMM5V6-M; D_MiniMELF; LCSC C8062
IC1: L78M05ABDT-TR; TO-252-2-Thermal; Manufacturer_Part_Number L78M05ABDT-TR; LCSC C58069
J2, J5: Conn_01x04; 1x02-Proto
J3: Conn_01x04; 1X4-PROTO
J4: Conn_02x12_Counter_Clockwise; Molex_Micro-Fit_3.0_43045-2400_2x12_P3.00mm_Horizontal
J7: Conn_01x04; 1x1-GPIO
RV1: MOV; MOV07D220KTR; Manufacturer_Part_Number MOV-14D220K; Mouser Part Number 652-MOV-14D220K

Connections:
+5V: C7.1, C8.1, D3.1 (K), IC1.3 (OUT), J4.10; also elsewhere on the board
+BATT: D1.2 (A), J4.22, RV1.1; also elsewhere on the board
A-IN1: J5.2; also elsewhere on the board
A-IN2: J5.1; also elsewhere on the board
BOOST: J4.8; also elsewhere on the board
CLT: J4.2; also elsewhere on the board
Cam-In: J4.17; also elsewhere on the board
Clutch: J4.3; also elsewhere on the board
Crank-In: J4.18; also elsewhere on the board
Fan: J4.7; also elsewhere on the board
Flex: J2.2; also elsewhere on the board
Fuel-Pump: J4.19; also elsewhere on the board
GND: C5.2, C6.1, C7.2, C8.2, D3.2 (A), IC1.2 (GND), J4.1, J4.11, J4.23, RV1.2; also elsewhere on the board
HC1: J4.20; also elsewhere on the board
IAT: J4.13; also elsewhere on the board
IDLE: J4.9; also elsewhere on the board
IGN1: J4.16; also elsewhere on the board
IGN2: J4.4; also elsewhere on the board
INJ1: J4.24; also elsewhere on the board
INJ2: J4.12; also elsewhere on the board
MC-D20: J2.1; also elsewhere on the board
Map-External: J7.1; also elsewhere on the board
unnamed: C5.1, C6.2, D1.1 (K), IC1.1 (IN)
O2: J4.15; also elsewhere on the board
Step-A1: J3.2; also elsewhere on the board
Step-A2: J3.1; also elsewhere on the board
Step-B1: J3.3; also elsewhere on the board
Step-B2: J3.4; also elsewhere on the board
TPS: J4.14; also elsewhere on the board
Tach: J4.21; also elsewhere on the board
VR1-: J4.6; also elsewhere on the board
VR2-: J4.5; also elsewhere on the board

Notes on the sheet:
Main Connection
Connection
Power Supply
Proto
Stepper Out

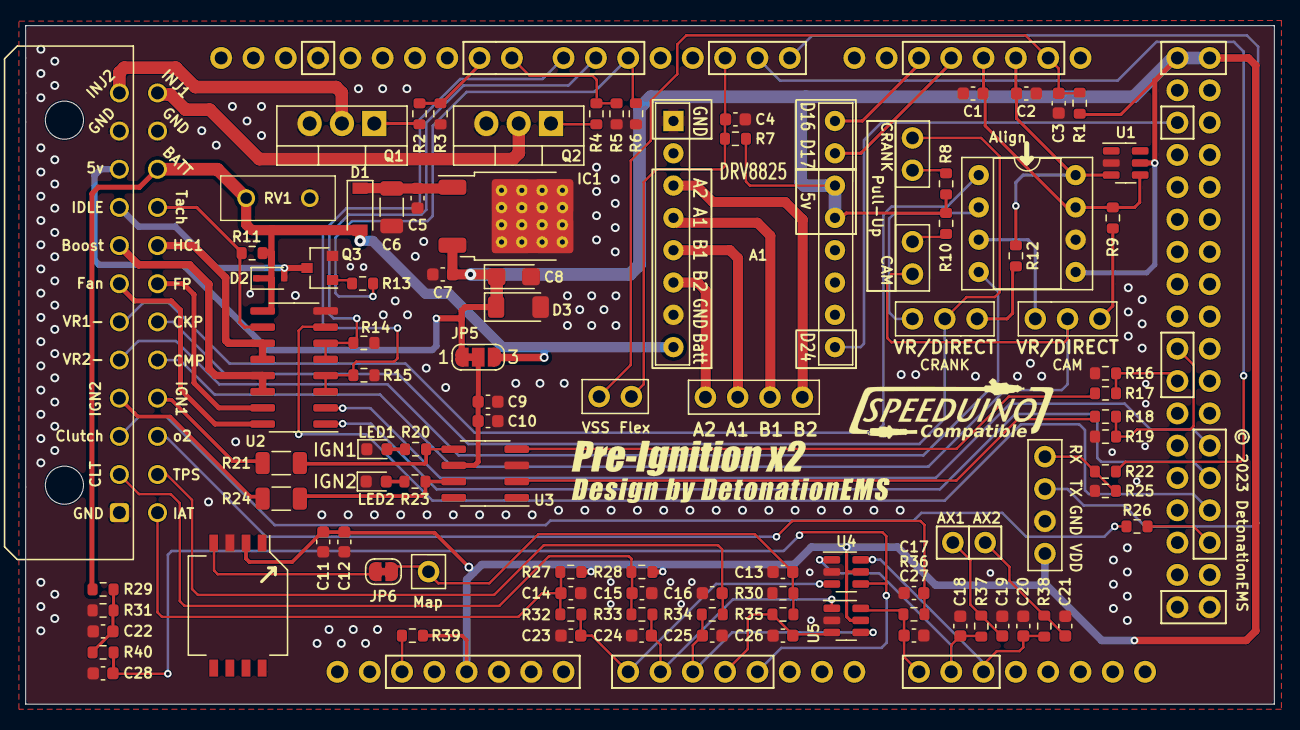
[picture p116: board Engine Managment/Pre-Ignition/Pre-Ignition x2/MX2B/Pre_Ignition.kicad… from above]

Board: 2 copper layers, 98.2 x 53.3 mm, 102 parts (0 on the bottom side), 78 nets.

Other parts of the board:
G1: Logo_Open_Hardware_Small; SpeeduinoCompatible-17mm
G2: Logo_Open_Hardware_Small; Pre-Ignition-800
G3: LOGO; Design by 25mm
