OpenLogicEFI/Hardware/Modules/VR Conditioner NCV1124/RevB3/Duel VR.kicad_pcb

## KiCad design Modules/VR Conditioner NCV1124/RevB3/Duel VR.kicad_pcb (2026-06-21)

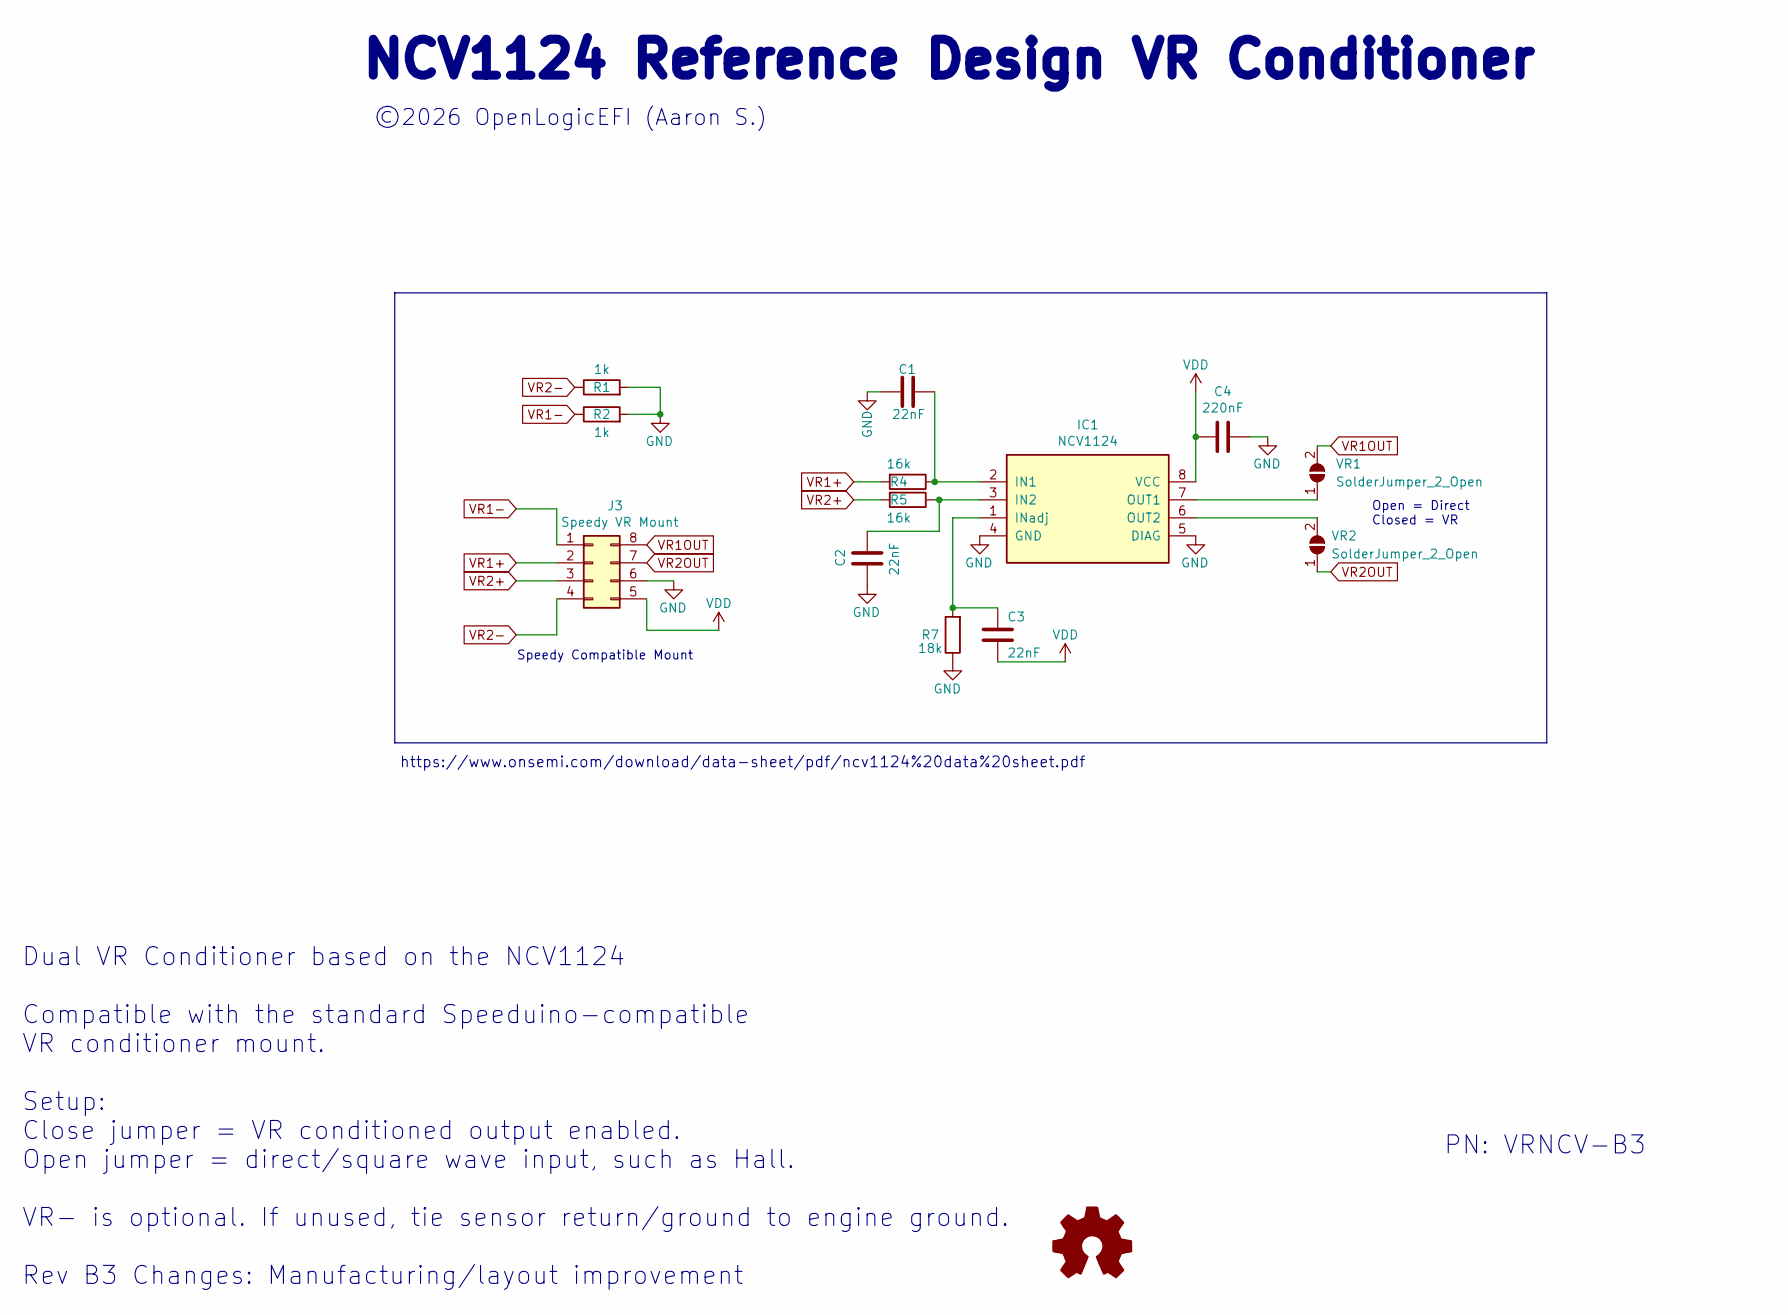
[picture p117: schematic Duel VR.kicad_sch, Duel VRConditioner]

Parts:
C1, C2, C3: 22nF; C_0603_1608Metric; LCSC C21122
C4: 220nF; C_0603_1608Metric; LCSC C21120
G1: Logo_Open_Hardware_Small; SpeeduinoCompatible-14mm
IC1: NCV1124; SO-8_3.9x4.9mm_P1.27mm
J3: Speedy VR Mount; DIP-8_W7.62mm_Socket_VRConditioner
R1, R2: 1k; R_1206_3216Metric; LCSC C4410
R4, R5: 16k; R_1210_3225Metric; LCSC C3013274
R7: 18k; R_0603_1608Metric; LCSC C25810
VR1, VR2: SolderJumper_2_Open; SolderJumper-2_P1.3mm_Open_RoundedPad1.0x1.5mm

Connections:
GND: C1.1, C2.2, C4.2, IC1.4 (GND), IC1.5 (DIAG), J3.6, R1.2, R2.2, R7.1
unnamed: C1.2, IC1.2 (IN1), R4.1
unnamed: C2.1, IC1.3 (IN2), R5.1
unnamed: C3.1, IC1.1 (INadj), R7.2
unnamed: IC1.7 (OUT1), VR1.1 (A)
unnamed: IC1.6 (OUT2), VR2.2 (B)
VDD: C3.2, C4.1, IC1.8 (VCC), J3.5
VR1+: J3.2, R4.2
VR1-: J3.1, R2.1
VR1OUT: J3.8, VR1.2 (B)
VR2+: J3.3, R5.2
VR2-: J3.4, R1.1
VR2OUT: J3.7, VR2.1 (A)

Notes on the sheet:
https://www.onsemi.com/download/data-sheet/pdf/ncv1124%20data%20sheet.pdf
Dual VR Conditioner based on the NCV1124 Compatible with the standard Speeduino-compatible VR conditioner mount. Setup: Close jumper = VR conditioned output enabled. Open jumper = direct/square wave input, such as Hall. VR- is optional. If unused, tie sensor return/ground to engine ground. Rev B3 C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
NCV1124 Reference Design VR Conditioner
©2026 OpenLogicEFI (Aaron S.)
Open = Direct Closed = VR
Speedy Compatible Mount
PN: VRNCV-B3

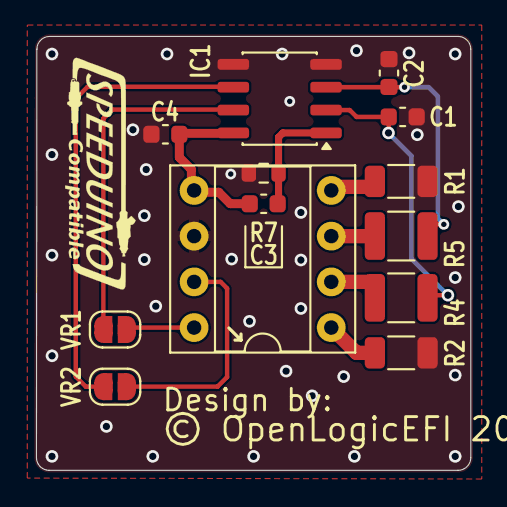
[picture p118: board Modules/VR Conditioner NCV1124/RevB3/Duel VR.kicad_pcb from above]

Board: 2 copper layers, 24.1 x 24.1 mm, 14 parts (0 on the bottom side), 13 nets.
