OpenLogicEFI/Hardware/Modules/MAP Sensor Modules/PMAP-M/Rev2/map-pinned.kicad_pcb

## KiCad design Modules/MAP Sensor Modules/PMAP-M/Rev2/map-pinned.kicad_pcb (2026-06-21)

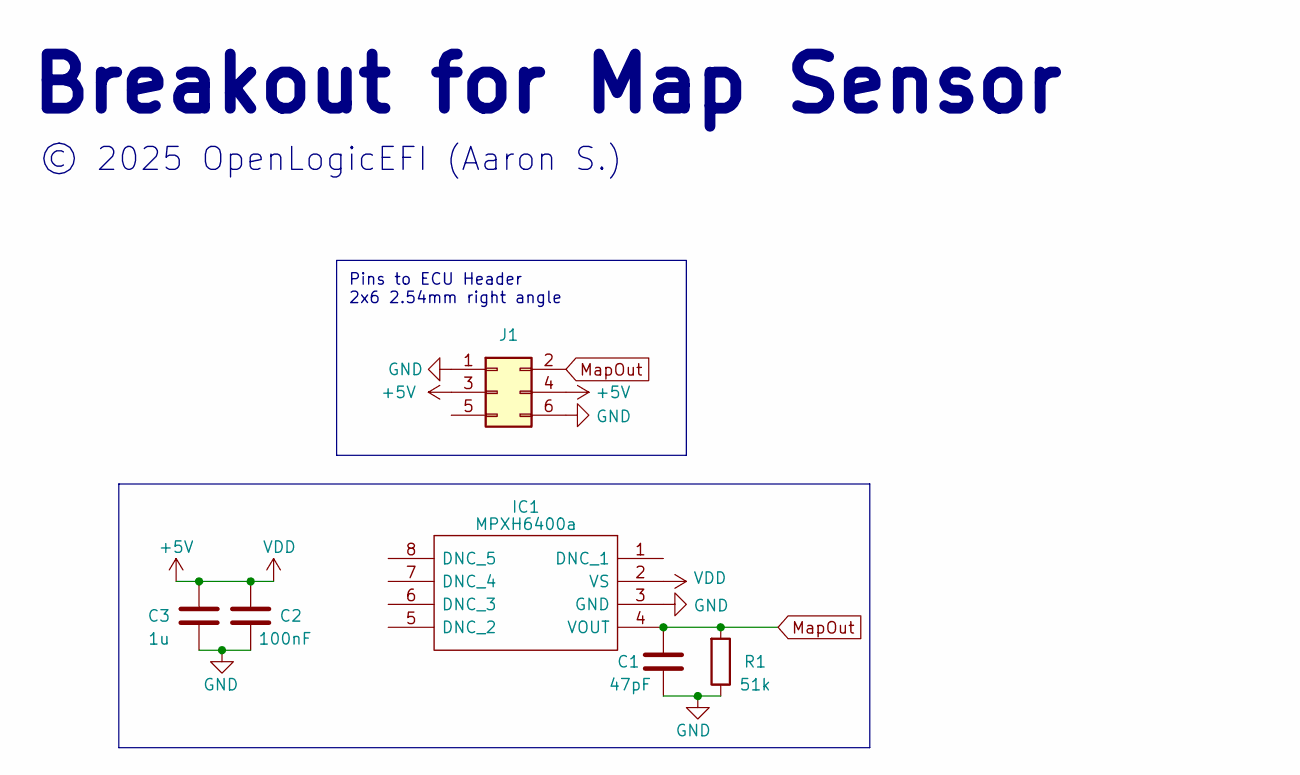
[picture p119: schematic map-pinned.kicad_sch, PMAP-M]

Parts:
C1: 47pF; C_0402_1005Metric; Manufacture Part Number 0402CG470J500NT; LCSC C1567
C2: 100nF; C_0402_1005Metric; Manufacture Part Number CL05B104KO5NNNC; LCSC C1525
C3: 1u; C_0805_2012Metric; Manufacture Part Number CL21B105KBFNNNE; LCSC C28323
IC1: MPXH6400a; MPXHxxx_Handsoldering
J1: Conn_02x03_Odd_Even; PinHeader_2x03_P2.54mm_Horizontal
R1: 51k; R_0402_1005Metric; Manufacture Part Number 0402WGF5102TCE; LCSC C25794

Connections:
+5V: C2.1, C3.1, IC1.2 (VS), J1.3, J1.4
GND: C1.2, C2.2, C3.2, IC1.3 (GND), J1.1, J1.6, R1.1
MapOut: C1.1, IC1.4 (VOUT), J1.2, R1.2

Notes on the sheet:
Pins to ECU Header 2x6 2.54mm right angle
© 2025 OpenLogicEFI (Aaron S.)
Breakout for Map Sensor

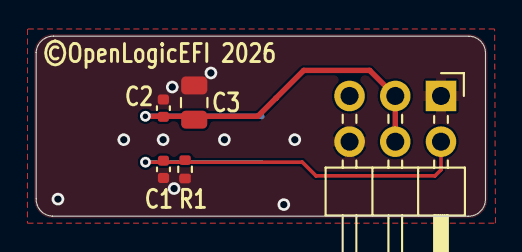
[picture p120: board Modules/MAP Sensor Modules/PMAP-M/Rev2/map-pinned.kicad_pcb from above]

Board: 2 copper layers, 25.0 x 10.0 mm, 6 parts (1 on the bottom side), 3 nets.
