OpenLogicEFI/Hardware/Modules/MAP Sensor Modules/MapDapter-4bar/map-pinned.kicad_pcb

## KiCad design Modules/MAP Sensor Modules/MapDapter-4bar/map-pinned.kicad_pcb (2026-06-21)

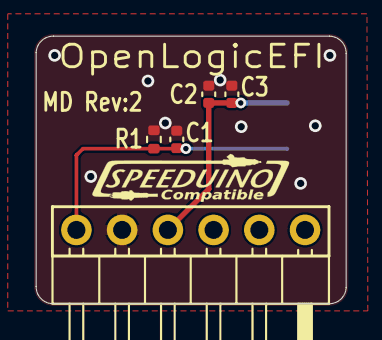
[picture p121: board Modules/MAP Sensor Modules/MapDapter-4bar/map-pinned.kicad_pcb from above]

Board: 2 copper layers, 17.2 x 14.9 mm, 6 parts (1 on the bottom side), 3 nets.

Parts:
C1: 47pF; C_0402_1005Metric
C2: 100nF; C_0402_1005Metric
C3: 1u; C_0402_1005Metric
IC1: MPXH6400a; MPXHxxx_Handsoldering
J2: Conn_01x06; MapDapter_1x06_P2.54mm_Horizontal
R1: 51k; R_0402_1005Metric

Connections:
+5V: C2.1, C3.1, IC1.2 (VS), J2.4
GND: C1.2, C2.2, C3.2, IC1.3 (GND), J2.5, R1.1
MapOut: C1.1, IC1.4 (VOUT), J2.6, R1.2
