OpenLogicEFI/Hardware/Engine Managment/Pre-Ignition/Pre-Ignition x4/MX4C/Pre_Ignition.kicad_pcb

## KiCad design Engine Managment/Pre-Ignition/Pre-Ignition x4/MX4C/Pre_Ignition.kicad_pcb (2026-03-03)

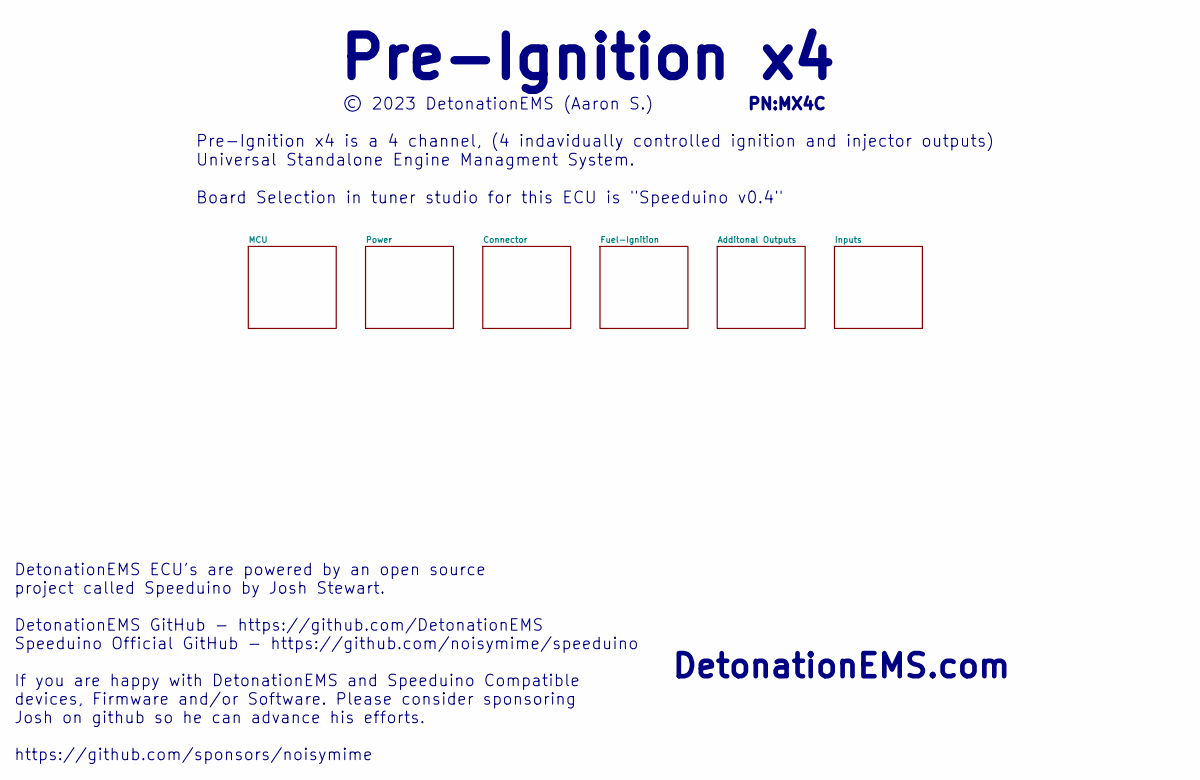
[picture p122: schematic Pre_Ignition.kicad_sch, Pre-Ignition X4]

Notes on the sheet:
Pre-Ignition x4 is a 4 channel, (4 indavidually controlled ignition and injector outputs) Universal Standalone Engine Managment System. Board Selection in tuner studio for this ECU is "Speeduino v0.4"
© 2023 DetonationEMS (Aaron S.)
Pre-Ignition x4
DetonationEMS.com
DetonationEMS ECU's are powered by an open source project called Speeduino by Josh Stewart. DetonationEMS GitHub - https://github.com/DetonationEMS Speeduino Official GitHub - https://github.com/noisymime/speeduino If you are happy with DetonationEMS and Speeduino Compatible devices, Firmware and/o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
PN:MX4C

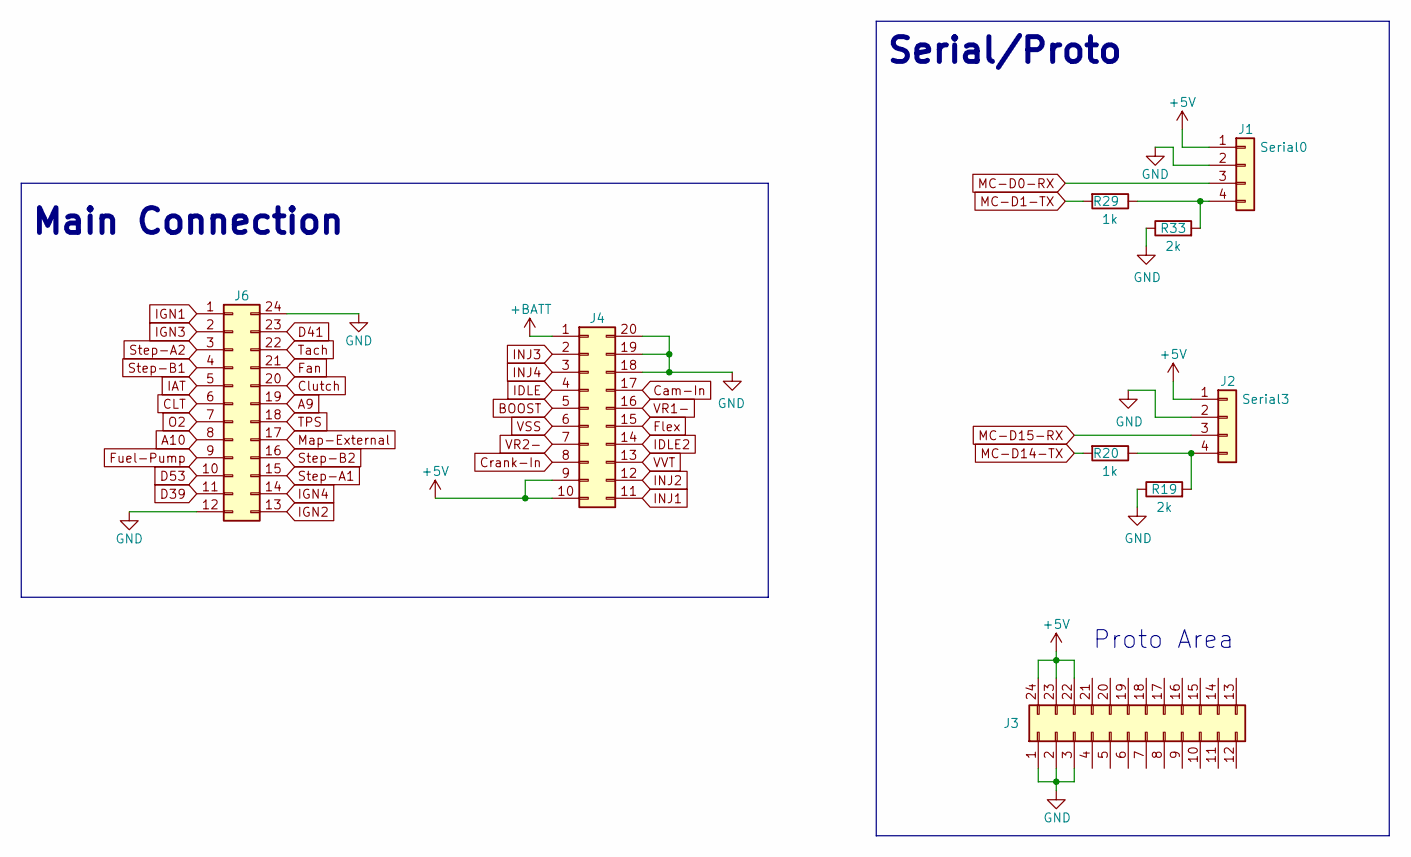
[picture p123: schematic Connector.kicad_sch, Pre-Ignition X4]

Parts:
J1: Serial0; 1X4-PROTO
J2: Serial3; 1X4-PROTO
J3: Conn_02x12_Counter_Clockwise; PROTO-3X8-24pin
J4: Conn_02x10_Counter_Clockwise; Molex_Micro-Fit_3.0_43045-2000_2x10_P3.00mm_Horizontal
J6: Conn_02x12_Counter_Clockwise; Molex_Micro-Fit_3.0_43045-2400_2x12_P3.00mm_Horizontal
R19, R33: 2k; R_0603_1608Metric; LCSC C22975
R20, R29: 1k; R_0603_1608Metric; LCSC C21190

Connections:
+5V: J1.1, J2.1, J3.22, J3.23, J3.24, J4.9, J4.10; also elsewhere on the board
+BATT: J4.1; also elsewhere on the board
A9: J6.19; also elsewhere on the board
A10: J6.8; also elsewhere on the board
BOOST: J4.5; also elsewhere on the board
CLT: J6.6; also elsewhere on the board
Cam-In: J4.17; also elsewhere on the board
Clutch: J6.20; also elsewhere on the board
Crank-In: J4.8; also elsewhere on the board
D39: J6.11; also elsewhere on the board
D41: J6.23; also elsewhere on the board
D53: J6.10; also elsewhere on the board
Fan: J6.21; also elsewhere on the board
Flex: J4.15; also elsewhere on the board
Fuel-Pump: J6.9; also elsewhere on the board
GND: J1.2, J2.2, J3.1, J3.2, J3.3, J4.18, J4.19, J4.20, J6.12, J6.24, R19.1, R33.1; also elsewhere on the board
IAT: J6.5; also elsewhere on the board
IDLE: J4.4; also elsewhere on the board
IDLE2: J4.14; also elsewhere on the board
IGN1: J6.1; also elsewhere on the board
IGN2: J6.13; also elsewhere on the board
IGN3: J6.2; also elsewhere on the board
IGN4: J6.14; also elsewhere on the board
INJ1: J4.11; also elsewhere on the board
INJ2: J4.12; also elsewhere on the board
INJ3: J4.2; also elsewhere on the board
INJ4: J4.3; also elsewhere on the board
MC-D0-RX: J1.3; also elsewhere on the board
MC-D1-TX: R29.2; also elsewhere on the board
MC-D14-TX: R20.2; also elsewhere on the board
MC-D15-RX: J2.3; also elsewhere on the board
Map-External: J6.17; also elsewhere on the board
unnamed: J1.4, R29.1, R33.2
unnamed: J2.4, R19.2, R20.1
O2: J6.7; also elsewhere on the board
Step-A1: J6.15; also elsewhere on the board
Step-A2: J6.3; also elsewhere on the board
Step-B1: J6.4; also elsewhere on the board
Step-B2: J6.16; also elsewhere on the board
TPS: J6.18; also elsewhere on the board
Tach: J6.22; also elsewhere on the board
VR1-: J4.16; also elsewhere on the board
VR2-: J4.7; also elsewhere on the board
VSS: J4.6; also elsewhere on the board
VVT: J4.13; also elsewhere on the board

Notes on the sheet:
Proto Area
Serial/Proto
Main Connection

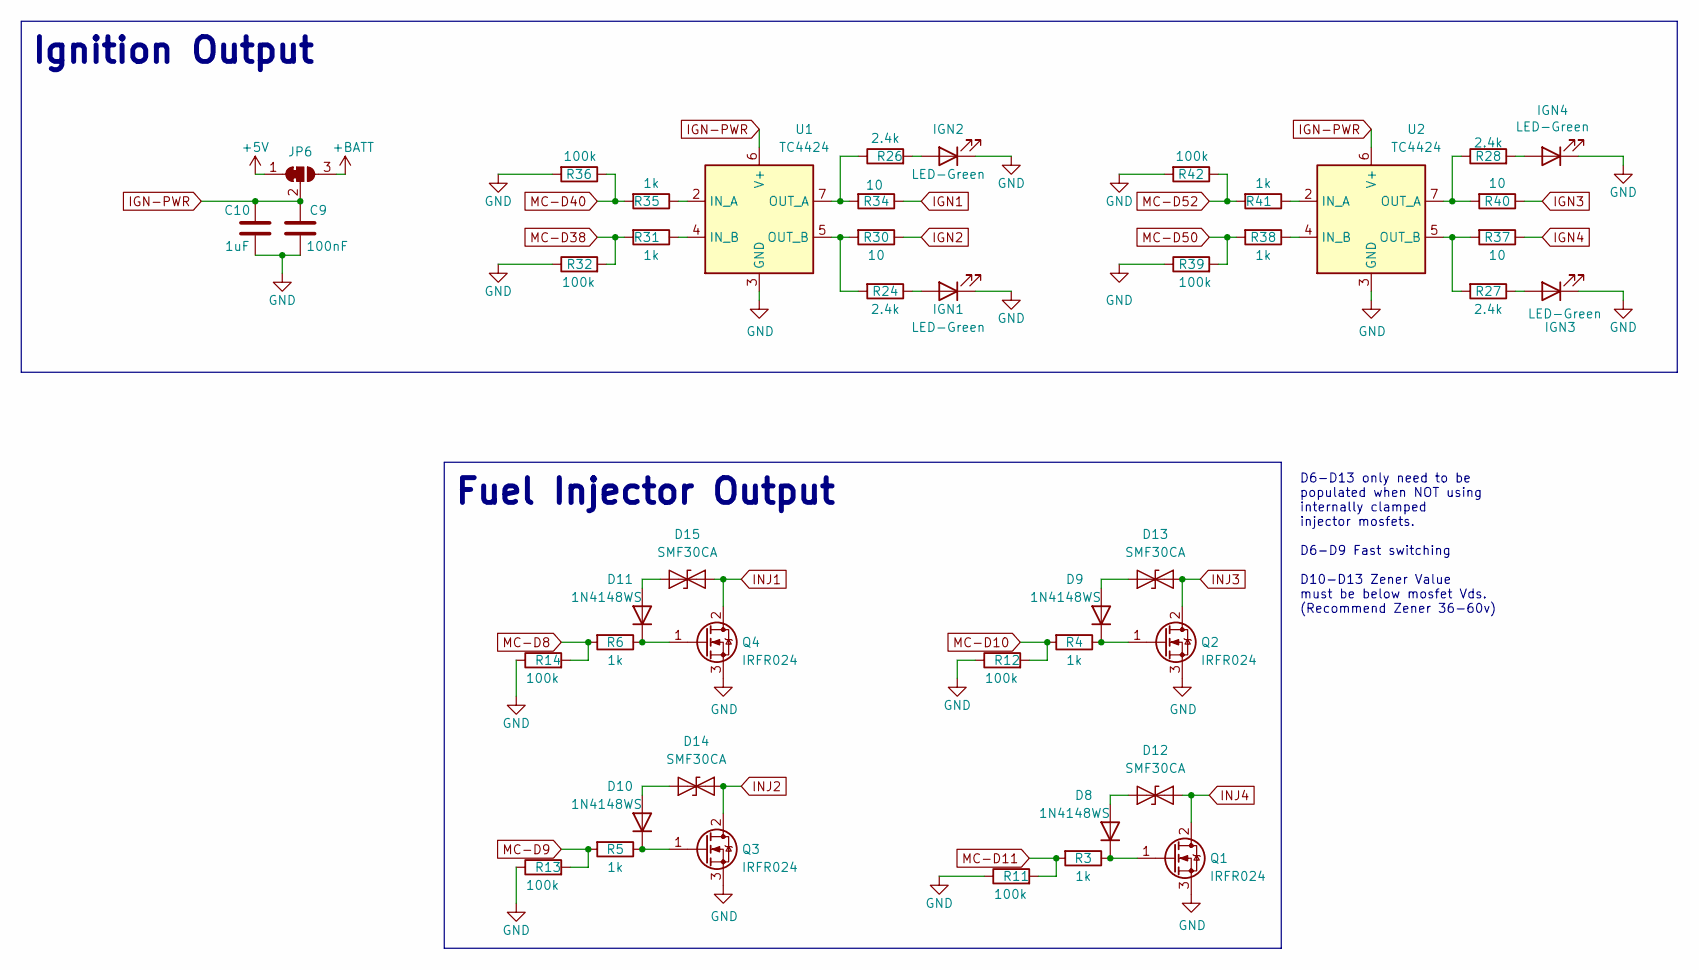
[picture p124: schematic Fuel-Ignition.kicad_sch, Pre-Ignition X4]

Parts:
C9: 100nF; C_0603_1608Metric; JLC C14663
C10: 1uF; C_0603_1608Metric; JLC C15849
D8, D9, D10, D11: 1N4148WS; D_SOD-323F; LCSC C2128
D12, D13, D14, D15: SMF30CA; D_SOD-123F
IGN1, IGN2, IGN3, IGN4: LED-Green; LED_0603_1608Metric; JLC C2286
JP6: SolderJumper_3_Bridged12; SolderJumper-3_P1.3mm_Bridged12_RoundedPad1.0x1.5mm_NumberL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
Q1, Q2, Q3, Q4: IRFR024; TO-252-2; LCSC C2583
R3, R4, R5, R6, R31, R35, R38, R41: 1k; R_0603_1608Metric; JLC C21190
R11, R12, R13, R14, R32, R36, R39, R42: 100k; R_0603_1608Metric; JLC C25803
R24, R27, R28: 2.4k; R_0603_1608Metric; JLC C22940
R26: 2.4k; R_0603_1608Metric; LCSC C22940
R30, R34, R37, R40: 10; R_1206_3216Metric; JLC C17561
U1, U2: TC4424; SOIC-8_3.9x4.9mm_P1.27mm; LCSC C2685358

Connections:
+5V: JP6.1 (A); also elsewhere on the board
+BATT: JP6.3 (B); also elsewhere on the board
GND: C9.2, C10.2, IGN1.1 (K), IGN2.1 (K), IGN3.1 (K), IGN4.1 (K), Q1.3 (S), Q2.3 (S), Q3.3 (S), Q4.3 (S), R11.1, R12.1, R13.1, R14.1, R32.1, R36.2, R39.1, R42.2, U1.3 (GND), U2.3 (GND); also elsewhere on the board
IGN1: R34.1; also elsewhere on the board
IGN2: R30.1; also elsewhere on the board
IGN3: R40.1; also elsewhere on the board
IGN4: R37.1; also elsewhere on the board
IGN-PWR: C9.1, C10.1, JP6.2 (C), U1.6 (V+), U2.6 (V+)
INJ1: D15.1 (A1), Q4.2 (D); also elsewhere on the board
INJ2: D14.1 (A1), Q3.2 (D); also elsewhere on the board
INJ3: D13.1 (A1), Q2.2 (D); also elsewhere on the board
INJ4: D12.1 (A1), Q1.2 (D); also elsewhere on the board
MC-D8: R6.2, R14.2; also elsewhere on the board
MC-D9: R5.2, R13.2; also elsewhere on the board
MC-D10: R4.2, R12.2; also elsewhere on the board
MC-D11: R3.2, R11.2; also elsewhere on the board
MC-D38: R31.2, R32.2; also elsewhere on the board
MC-D40: R35.2, R36.1; also elsewhere on the board
MC-D50: R38.2, R39.2; also elsewhere on the board
MC-D52: R41.2, R42.1; also elsewhere on the board
unnamed: D8.1 (K), Q1.1 (G), R3.1
unnamed: D9.1 (K), Q2.1 (G), R4.1
unnamed: D10.2 (A), D14.2 (A2)
unnamed: D10.1 (K), Q3.1 (G), R5.1
unnamed: D11.2 (A), D15.2 (A2)
unnamed: D11.1 (K), Q4.1 (G), R6.1
unnamed: D8.2 (A), D12.2 (A2)
unnamed: D9.2 (A), D13.2 (A2)
unnamed: IGN1.2 (A), R24.1
unnamed: IGN2.2 (A), R26.2
unnamed: IGN3.2 (A), R27.1
unnamed: IGN4.2 (A), R28.2
unnamed: R35.1, U1.2 (IN_A)
unnamed: R31.1, U1.4 (IN_B)
unnamed: R26.1, R34.2, U1.7 (OUT_A)
unnamed: R24.2, R30.2, U1.5 (OUT_B)
unnamed: R41.1, U2.2 (IN_A)
unnamed: R38.1, U2.4 (IN_B)
unnamed: R28.1, R40.2, U2.7 (OUT_A)
unnamed: R27.2, R37.2, U2.5 (OUT_B)

Notes on the sheet:
Fuel Injector Output
D6-D13 only need to be populated when NOT using internally clamped injector mosfets. D6-D9 Fast switching D10-D13 Zener Value must be below mosfet Vds. (Recommend Zener 36-60v)
Ignition Output

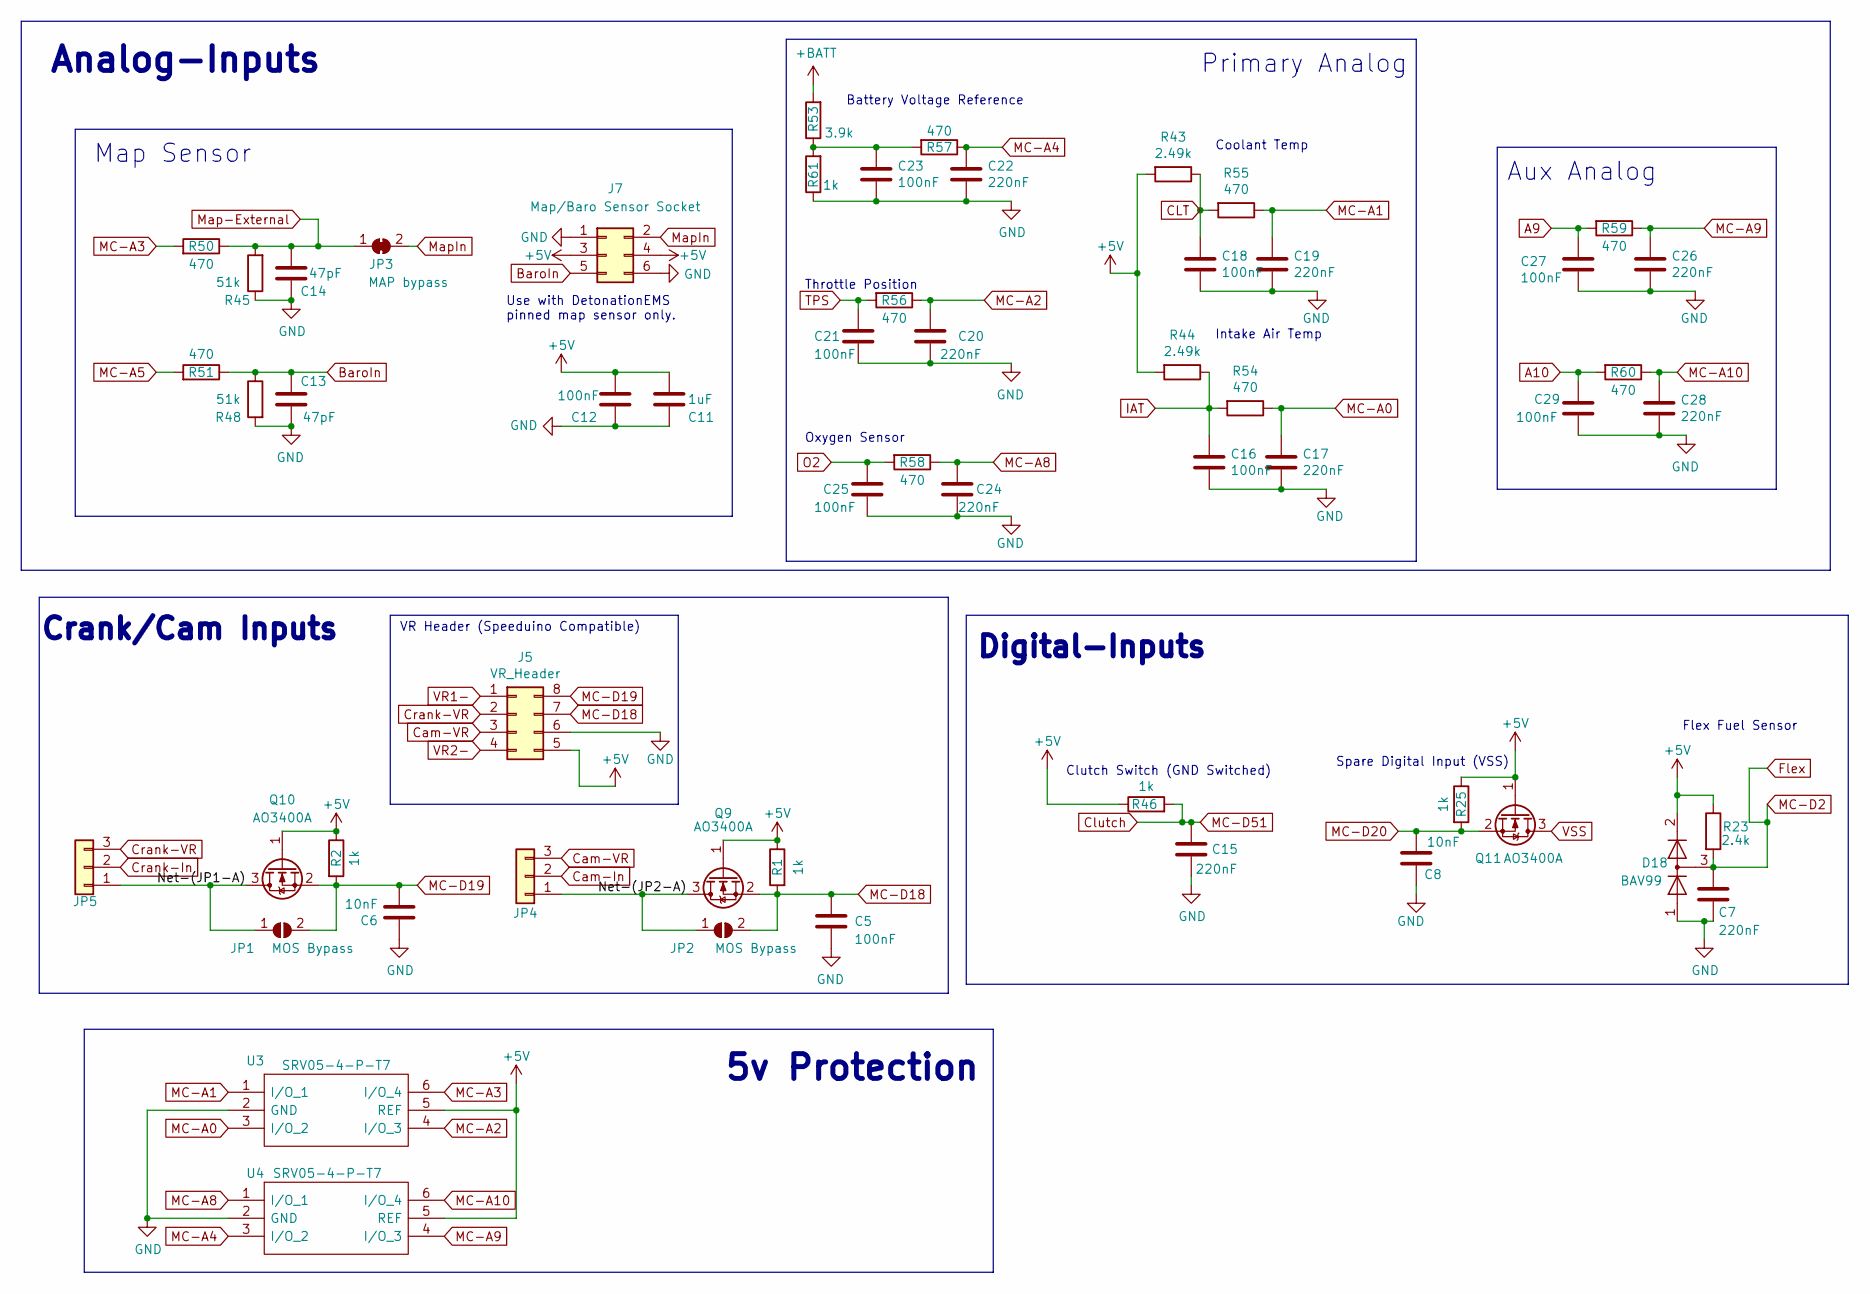
[picture p125: schematic Analog.kicad_sch, Pre-Ignition X4]

Parts:
C5, C12, C16, C18, C21, C23, C25, C27, C29: 100nF; C_0603_1608Metric; JLC C14663
C6, C8: 10nF; C_0603_1608Metric; JLC C57112
C7, C15, C17, C19, C20, C22, C24, C26, C28: 220nF; C_0603_1608Metric; JLC C5378
C11: 1uF; C_0603_1608Metric; JLC C15849
C13, C14: 47pF; C_0603_1608Metric; LCSC C1671
D18: BAV99; SOT-23; LCSC C2500
J5: VR_Header; Socket_VRConditioner_Corrected
J7: Map/Baro Sensor Socket; PinSocket_2x03_P2.54mm_Vertical
JP1, JP2: MOS Bypass; SolderJumper-2_P1.3mm_Open_RoundedPad1.0x1.5mm
JP3: MAP bypass; SolderJumper-2_P1.3mm_Bridged_RoundedPad1.0x1.5mm
JP4, JP5: Conn_01x03; 1x03-Proto
Q9, Q10, Q11: AO3400A; SOT-23; LCSC C20917
R1, R2, R25, R46, R61: 1k; R_0603_1608Metric; JLC C21190
R23: 2.4k; R_0603_1608Metric; JLC C22940
R43, R44: 2.49k; R_Axial_DIN0207_L6.3mm_D2.5mm_P7.62mm_Horizontal
R45, R48: 51k; R_0603_1608Metric; JLC C23196
R50, R51, R54, R55, R56, R57, R58, R59, R60: 470; R_0603_1608Metric; JLC C23179
R53: 3.9k; R_0603_1608Metric; JLC C23018
U3, U4: SRV05-4-P-T7; SOT-23-6; JLC C85364

Connections:
+5V: C11.2, C12.2, D18.2 (A), J5.5, J7.3, J7.4, Q9.1 (G), Q10.1 (G), Q11.1 (G), R1.1, R2.1, R23.1, R25.1, R43.2, R44.2, R46.1, U3.5 (REF), U4.5 (REF); also elsewhere on the board
+BATT: R53.2; also elsewhere on the board
/Inputs/Net-(JP1-A): JP1.1 (A), JP5.1, Q10.3 (D)
/Inputs/Net-(JP2-A): JP2.1 (A), JP4.1, Q9.3 (D)
A9: C27.1, R59.2; also elsewhere on the board
A10: C29.1, R60.2; also elsewhere on the board
BaroIn: C13.1, J7.5, R48.1, R51.1
CLT: C18.1, R43.1, R55.2; also elsewhere on the board
Cam-In: JP4.2; also elsewhere on the board
Cam-VR: J5.3, JP4.3
Clutch: C15.1, R46.2; also elsewhere on the board
Crank-In: JP5.2; also elsewhere on the board
Crank-VR: J5.2, JP5.3
Flex: C7.1, D18.3 (K), R23.2; also elsewhere on the board
GND: C5.1, C6.1, C7.2, C8.2, C11.1, C12.1, C13.2, C14.2, C15.2, C16.2, C17.2, C18.2, C19.2, C20.2, C21.2, C22.2, C23.2, C24.2, C25.2, C26.2, C27.2, C28.2, C29.2, D18.1 (K), J5.6, J7.1, J7.6, R45.1, R48.2, R61.1, U3.2 (GND), U4.2 (GND); also elsewhere on the board
IAT: C16.1, R44.1, R54.2; also elsewhere on the board
MC-A0: C17.1, R54.1, U3.3 (I/O_2); also elsewhere on the board
MC-A1: C19.1, R55.1, U3.1 (I/O_1); also elsewhere on the board
MC-A2: C20.1, R56.1, U3.4 (I/O_3); also elsewhere on the board
MC-A3: R50.2, U3.6 (I/O_4); also elsewhere on the board
MC-A4: C22.1, R57.1, U4.3 (I/O_2); also elsewhere on the board
MC-A5: R51.2; also elsewhere on the board
MC-A8: C24.1, R58.1, U4.1 (I/O_1); also elsewhere on the board
MC-A9: C26.1, R59.1, U4.4 (I/O_3); also elsewhere on the board
MC-A10: C28.1, R60.1, U4.6 (I/O_4); also elsewhere on the board
MC-D18: C5.2, J5.7, JP2.2 (B), Q9.2 (S), R1.2; also elsewhere on the board
MC-D19: C6.2, J5.8, JP1.2 (B), Q10.2 (S), R2.2; also elsewhere on the board
MC-D20: C8.1, Q11.2 (S), R25.2; also elsewhere on the board
Map-External: C14.1, JP3.1 (A), R45.2, R50.1; also elsewhere on the board
MapIn: J7.2, JP3.2 (B)
unnamed: C23.1, R53.1, R57.2, R61.2
O2: C25.1, R58.2; also elsewhere on the board
TPS: C21.1, R56.2; also elsewhere on the board
VR1-: J5.1; also elsewhere on the board
VR2-: J5.4; also elsewhere on the board
VSS: Q11.3 (D); also elsewhere on the board

Notes on the sheet:
Aux Analog
Map Sensor
Throttle Position
Clutch Switch (GND Switched)
Crank/Cam Inputs
Analog-Inputs
Oxygen Sensor
Primary Analog
Coolant Temp
Intake Air Temp
VR Header (Speeduino Compatible)
Battery Voltage Reference
Spare Digital Input (VSS)
Use with DetonationEMS pinned map sensor only.
Flex Fuel Sensor
5v Protection
Digital-Inputs

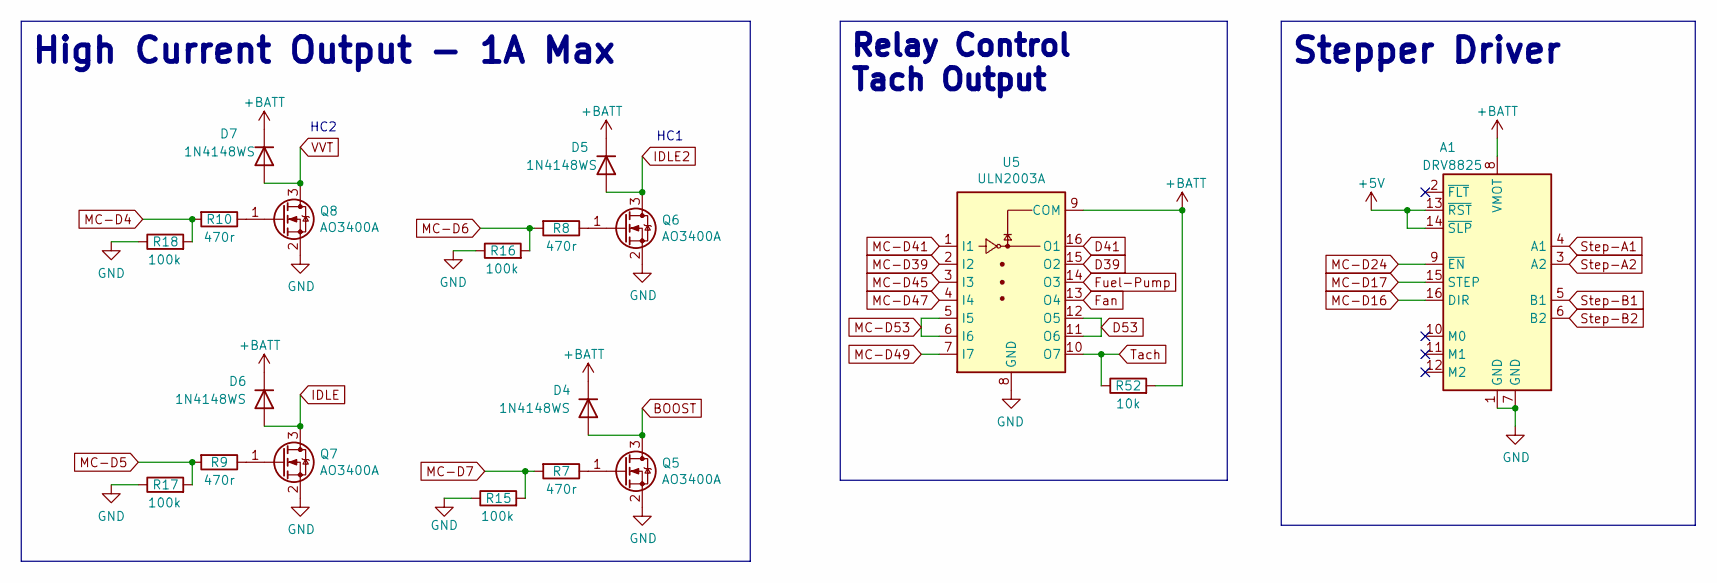
[picture p126: schematic Output.kicad_sch, Pre-Ignition X4]

Parts:
A1: DRV8825; DVR8825-Labeled-Front
D4, D5, D6, D7: 1N4148WS; D_SOD-323F; JLC C2128
Q5, Q6, Q7, Q8: AO3400A; SOT-23; JLC C20917
R7, R8, R9, R10: 470r; R_0402_1005Metric; LCSC C25117
R15, R16, R17, R18: 100k; R_0603_1608Metric; LCSC C25803
R52: 10k; R_0603_1608Metric; LCSC C25804
U5: ULN2003A; SOIC-16_3.9x9.9mm_P1.27mm; JLC C7512

Connections:
+5V: A1.13 (~RST), A1.14 (~SLP); also elsewhere on the board
+BATT: A1.8 (VMOT), D4.1 (K), D5.1 (K), D6.1 (K), D7.1 (K), R52.2, U5.9 (COM); also elsewhere on the board
BOOST: D4.2 (A), Q5.3 (D); also elsewhere on the board
D39: U5.15 (O2); also elsewhere on the board
D41: U5.16 (O1); also elsewhere on the board
D53: U5.11 (O6), U5.12 (O5); also elsewhere on the board
Fan: U5.13 (O4); also elsewhere on the board
Fuel-Pump: U5.14 (O3); also elsewhere on the board
GND: A1.1 (GND), A1.7 (GND), Q5.2 (S), Q6.2 (S), Q7.2 (S), Q8.2 (S), R15.1, R16.1, R17.1, R18.1, U5.8 (GND); also elsewhere on the board
IDLE: D6.2 (A), Q7.3 (D); also elsewhere on the board
IDLE2: D5.2 (A), Q6.3 (D); also elsewhere on the board
MC-D4: R10.2, R18.2; also elsewhere on the board
MC-D5: R9.2, R17.2; also elsewhere on the board
MC-D6: R8.2, R16.2; also elsewhere on the board
MC-D7: R7.2, R15.2; also elsewhere on the board
MC-D16: A1.16 (DIR); also elsewhere on the board
MC-D17: A1.15 (STEP); also elsewhere on the board
MC-D24: A1.9 (~EN); also elsewhere on the board
MC-D39: U5.2 (I2); also elsewhere on the board
MC-D41: U5.1 (I1); also elsewhere on the board
MC-D45: U5.3 (I3); also elsewhere on the board
MC-D47: U5.4 (I4); also elsewhere on the board
MC-D49: U5.7 (I7); also elsewhere on the board
MC-D53: U5.5 (I5), U5.6 (I6); also elsewhere on the board
unnamed: Q5.1 (G), R7.1
unnamed: Q6.1 (G), R8.1
unnamed: Q7.1 (G), R9.1
unnamed: Q8.1 (G), R10.1
Step-A1: A1.4 (A1); also elsewhere on the board
Step-A2: A1.3 (A2); also elsewhere on the board
Step-B1: A1.5 (B1); also elsewhere on the board
Step-B2: A1.6 (B2); also elsewhere on the board
Tach: R52.1, U5.10 (O7); also elsewhere on the board
VVT: D7.2 (A), Q8.3 (D); also elsewhere on the board

Notes on the sheet:
High Current Output - 1A Max
HC2
HC1
Relay Control Tach Output
Stepper Driver

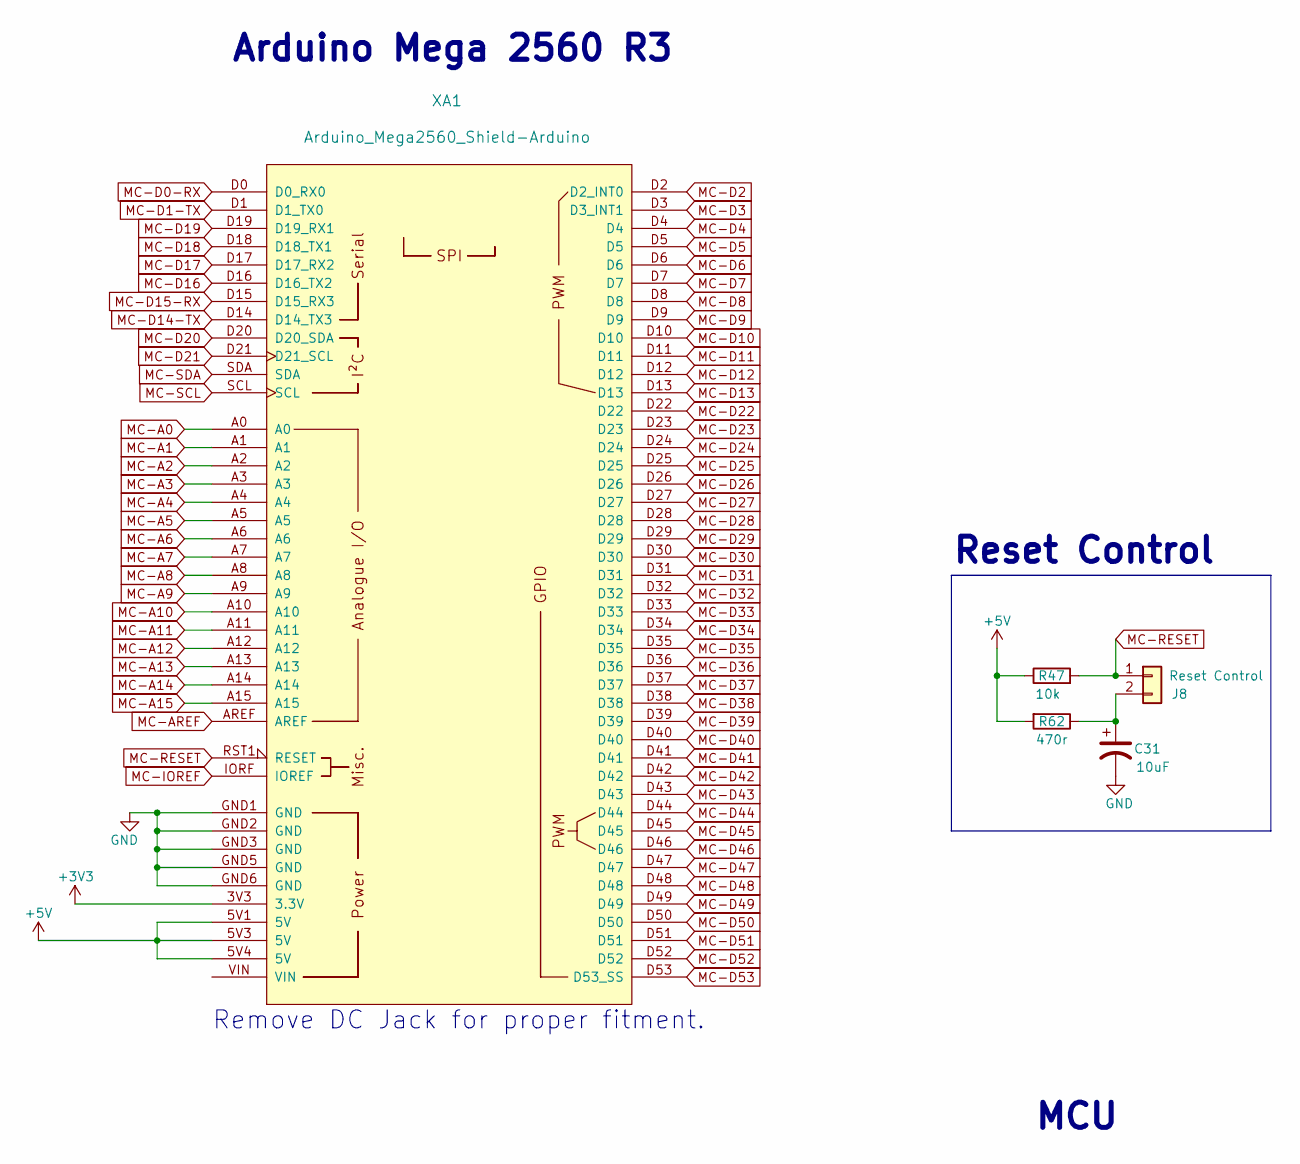
[picture p127: schematic mcu.kicad_sch, Pre-Ignition X4]

Parts:
C31: 10uF; CP_EIA-3216-18_Kemet-A; Manufacture Part Number TAJA106K016RNJ; LCSC C7171
J8: Reset Control; 1x02-Proto
R47: 10k; R_0603_1608Metric; LCSC C25804
R62: 470r; R_0402_1005Metric; LCSC C25117
XA1: Arduino_Mega2560_Shield-Arduino; Arduino-Mega2560-Shield-Speeduino

Connections:
+3V3: XA1.3V3 (3.3V)
+5V: R47.1, R62.2, XA1.5V1 (5V), XA1.5V3 (5V), XA1.5V4 (5V); also elsewhere on the board
Clutch: XA1.D51; also elsewhere on the board
Flex: XA1.D2 (D2_INT0); also elsewhere on the board
GND: C31.2, XA1.GND1 (GND), XA1.GND2 (GND), XA1.GND3 (GND), XA1.GND5 (GND), XA1.GND6 (GND); also elsewhere on the board
MC-A0: XA1.A0; also elsewhere on the board
MC-A1: XA1.A1; also elsewhere on the board
MC-A2: XA1.A2; also elsewhere on the board
MC-A3: XA1.A3; also elsewhere on the board
MC-A4: XA1.A4; also elsewhere on the board
MC-A5: XA1.A5; also elsewhere on the board
MC-A6: XA1.A6
MC-A7: XA1.A7
MC-A8: XA1.A8; also elsewhere on the board
MC-A9: XA1.A9; also elsewhere on the board
MC-A10: XA1.A10; also elsewhere on the board
MC-A11: XA1.A11
MC-A12: XA1.A12
MC-A13: XA1.A13
MC-A14: XA1.A14
MC-A15: XA1.A15
MC-AREF: XA1.AREF
MC-D0-RX: XA1.D0 (D0_RX0); also elsewhere on the board
MC-D1-TX: XA1.D1 (D1_TX0); also elsewhere on the board
MC-D3: XA1.D3 (D3_INT1)
MC-D4: XA1.D4; also elsewhere on the board
MC-D5: XA1.D5; also elsewhere on the board
MC-D6: XA1.D6; also elsewhere on the board
MC-D7: XA1.D7; also elsewhere on the board
MC-D8: XA1.D8; also elsewhere on the board
MC-D9: XA1.D9; also elsewhere on the board
MC-D10: XA1.D10; also elsewhere on the board
MC-D11: XA1.D11; also elsewhere on the board
MC-D12: XA1.D12
MC-D13: XA1.D13
MC-D14-TX: XA1.D14 (D14_TX3); also elsewhere on the board
MC-D15-RX: XA1.D15 (D15_RX3); also elsewhere on the board
MC-D16: XA1.D16 (D16_TX2); also elsewhere on the board
MC-D17: XA1.D17 (D17_RX2); also elsewhere on the board
MC-D18: XA1.D18 (D18_TX1); also elsewhere on the board
MC-D19: XA1.D19 (D19_RX1); also elsewhere on the board
MC-D20: XA1.D20 (D20_SDA); also elsewhere on the board
MC-D21: XA1.D21 (D21_SCL)
MC-D22: XA1.D22
MC-D23: XA1.D23
MC-D24: XA1.D24; also elsewhere on the board
MC-D25: XA1.D25
MC-D26: XA1.D26
MC-D27: XA1.D27
MC-D28: XA1.D28
MC-D29: XA1.D29
MC-D30: XA1.D30
MC-D31: XA1.D31
MC-D32: XA1.D32
MC-D33: XA1.D33
MC-D34: XA1.D34
MC-D35: XA1.D35
MC-D36: XA1.D36
MC-D37: XA1.D37
MC-D38: XA1.D38; also elsewhere on the board
MC-D39: XA1.D39; also elsewhere on the board
MC-D40: XA1.D40; also elsewhere on the board
MC-D41: XA1.D41; also elsewhere on the board
MC-D42: XA1.D42
MC-D43: XA1.D43
MC-D44: XA1.D44
MC-D45: XA1.D45; also elsewhere on the board
MC-D46: XA1.D46
MC-D47: XA1.D47; also elsewhere on the board
MC-D48: XA1.D48
MC-D49: XA1.D49; also elsewhere on the board
MC-D50: XA1.D50; also elsewhere on the board
MC-D52: XA1.D52; also elsewhere on the board
MC-D53: XA1.D53 (D53_SS); also elsewhere on the board
MC-IOREF: XA1.IORF (IOREF)
MC-RESET: J8.1, R47.2, XA1.RST1 (RESET)
MC-SCL: XA1.SCL
MC-SDA: XA1.SDA
unnamed: C31.1, J8.2, R62.1

Notes on the sheet:
Remove DC Jack for proper fitment.
Reset Control
MCU
Arduino Mega 2560 R3
