OpenLogicEFI/Hardware/Engine Managment/Pre-Ignition/Pre-Ignition x4/MX4C/Pre_Ignition.kicad_pcb

## KiCad design Engine Managment/Pre-Ignition/Pre-Ignition x4/MX4C/Pre_Ignition.kicad_pcb (continued)

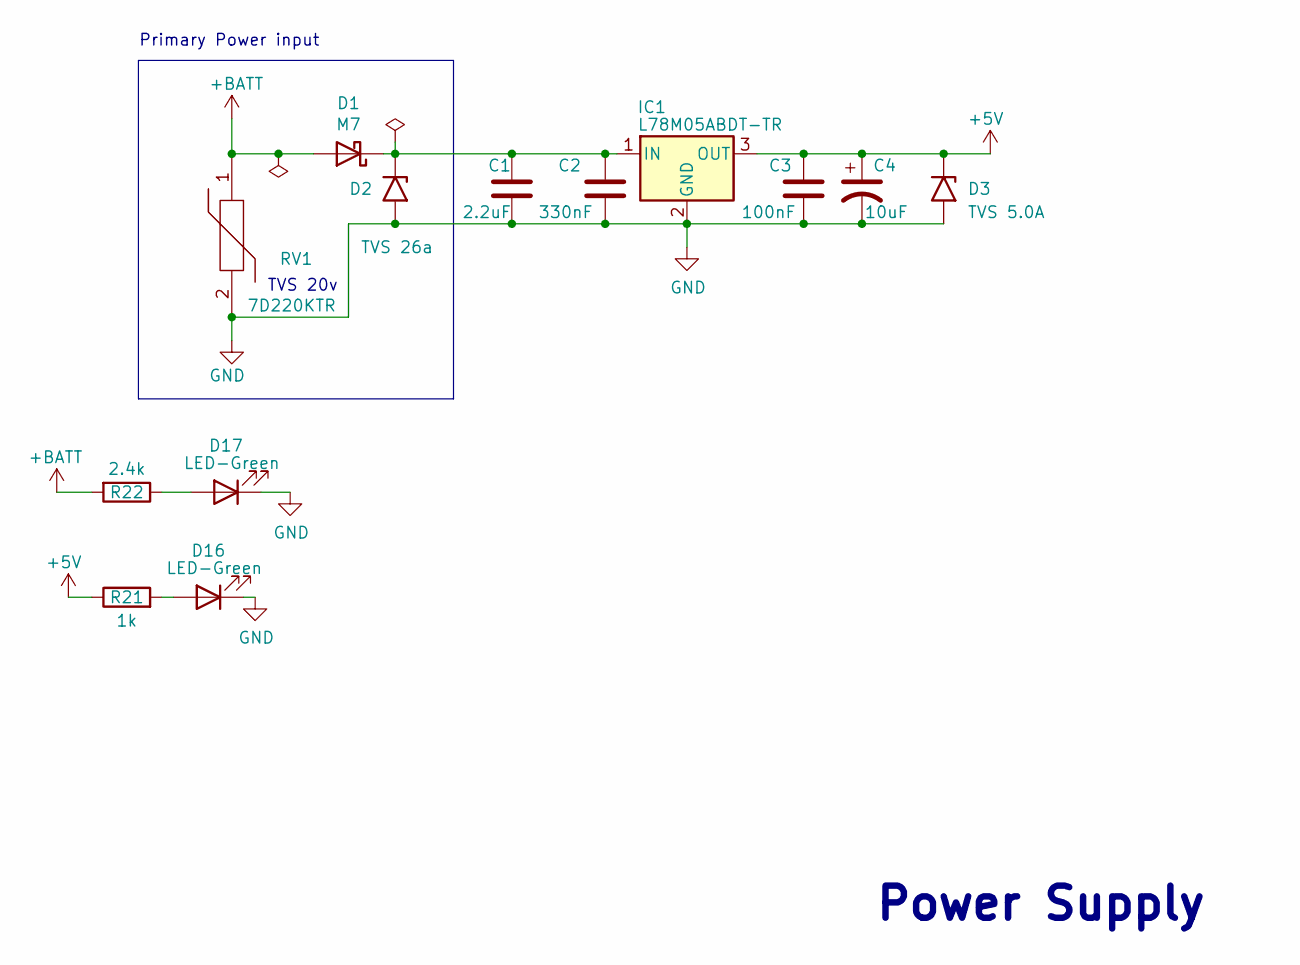
[picture p128: schematic power.kicad_sch, Pre-Ignition X4]

Parts:
C1: 2.2uF; C_1206_3216Metric; Manufacture Part Number CL31B225KBHNNNE; LCSC C50254
C2: 330nF; C_0805_2012Metric; Manufacture Part Number 0805B334K500NT; LCSC C1740
C3: 100nF; C_0603_1608Metric; JLC C14663
C4: 10uF; CP_EIA-3216-18_Kemet-A; Manufacture Part Number TAJA106K016RNJ; LCSC C7171
D1: M7; D_SMA; Manufacture Part Number M7; LCSC C95872
D2: TVS 26a; D_SMA; Manufacture Part Number SMAJ26A; LCSC C3001962
D3: TVS 5.0A; D_SMA; Manufacture Part Number SMAJ5.0A; LCSC C2925443
D16, D17: LED-Green; LED_0603_1608Metric; LCSC C72043
IC1: L78M05ABDT-TR; TO-252-2-Thermal; Manufacture Part Number L78M05ABDT-TR; LCSC C58069
R21: 1k; R_0603_1608Metric; JLC C21190
R22: 2.4k; R_0603_1608Metric; LCSC C22940
RV1: 7D220KTR; MOV07D220KTR

Connections:
+5V: C3.2, C4.1, D3.1 (A1), IC1.3 (OUT), R21.1; also elsewhere on the board
+BATT: D1.2 (A), R22.2, RV1.1; also elsewhere on the board
GND: C1.2, C2.2, C3.1, C4.2, D2.2 (A2), D3.2 (A2), D16.1 (K), D17.1 (K), IC1.2 (GND), RV1.2; also elsewhere on the board
unnamed: C1.1, C2.1, D1.1 (K), D2.1 (A1), IC1.1 (IN)
unnamed: D16.2 (A), R21.2
unnamed: D17.2 (A), R22.1

Notes on the sheet:
Primary Power input
TVS 20v
Power Supply

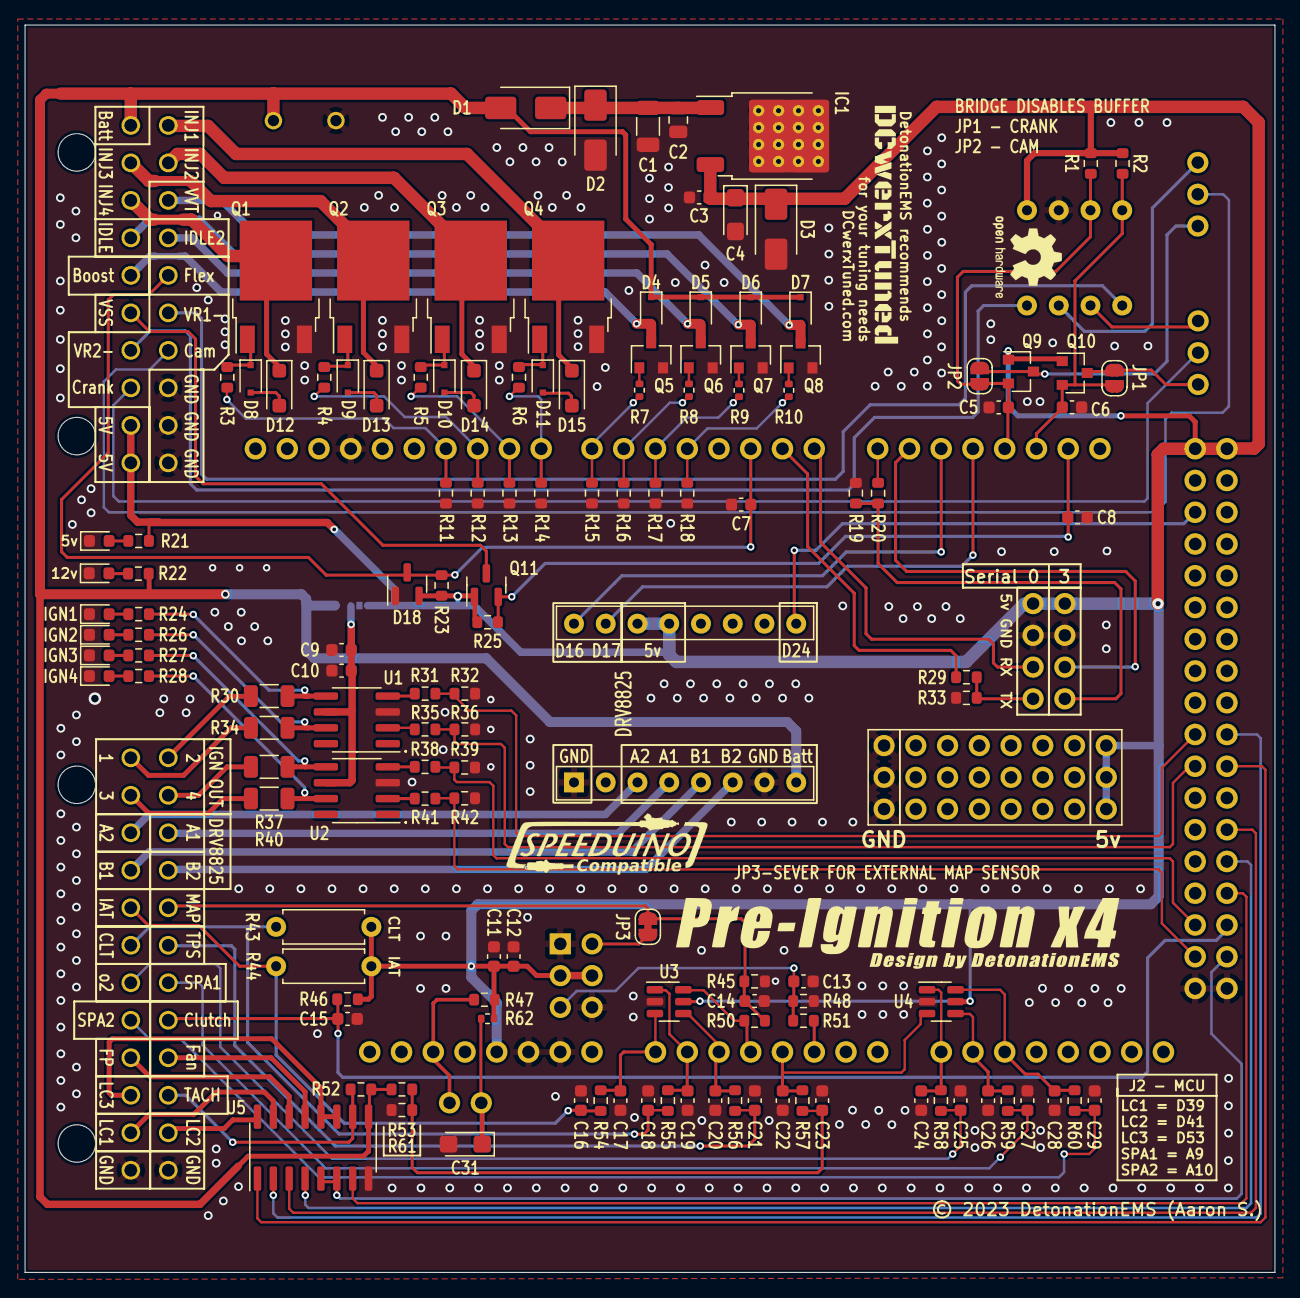
[picture p129: board Engine Managment/Pre-Ignition/Pre-Ignition x4/MX4C/Pre_Ignition.kicad… from above]

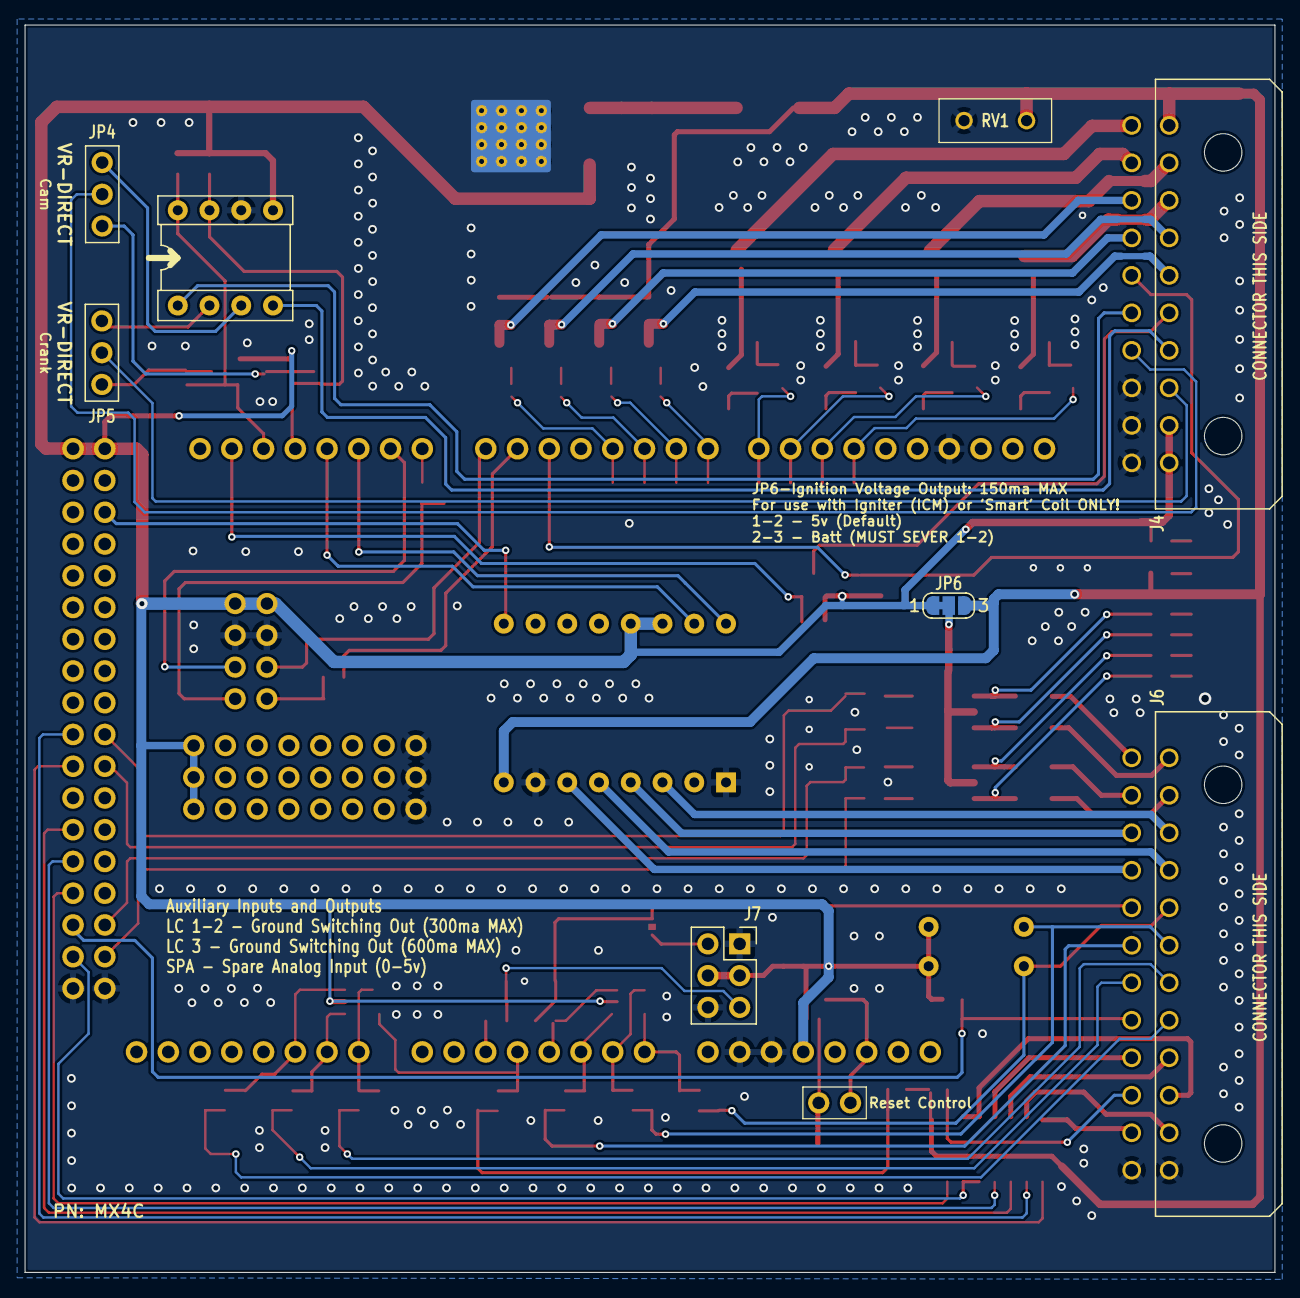
[picture p130: board Engine Managment/Pre-Ignition/Pre-Ignition x4/MX4C/Pre_Ignition.kicad… from below]

Board: 2 copper layers, 100.0 x 99.8 mm, 152 parts (9 on the bottom side), 115 nets.

Other parts of the board:
G1: DCWERX; DCWerx-19mm
G2: OSHW-Logo2_7.3x6mm_SilkScreen
G3: LOGO; SpeeduinoCompatible-17mm
G4: Pre-Ignition; Pre-IgnitionX4-35mm
G5: DESIGN; Design by 20mm
