OpenLogicEFI/Hardware/Engine Managment/Pre-Ignition/Pre-Ignition x4/MX4D/Pre_Ignition.kicad_pcb

## KiCad design Engine Managment/Pre-Ignition/Pre-Ignition x4/MX4D/Pre_Ignition.kicad_pcb (2026-03-03)

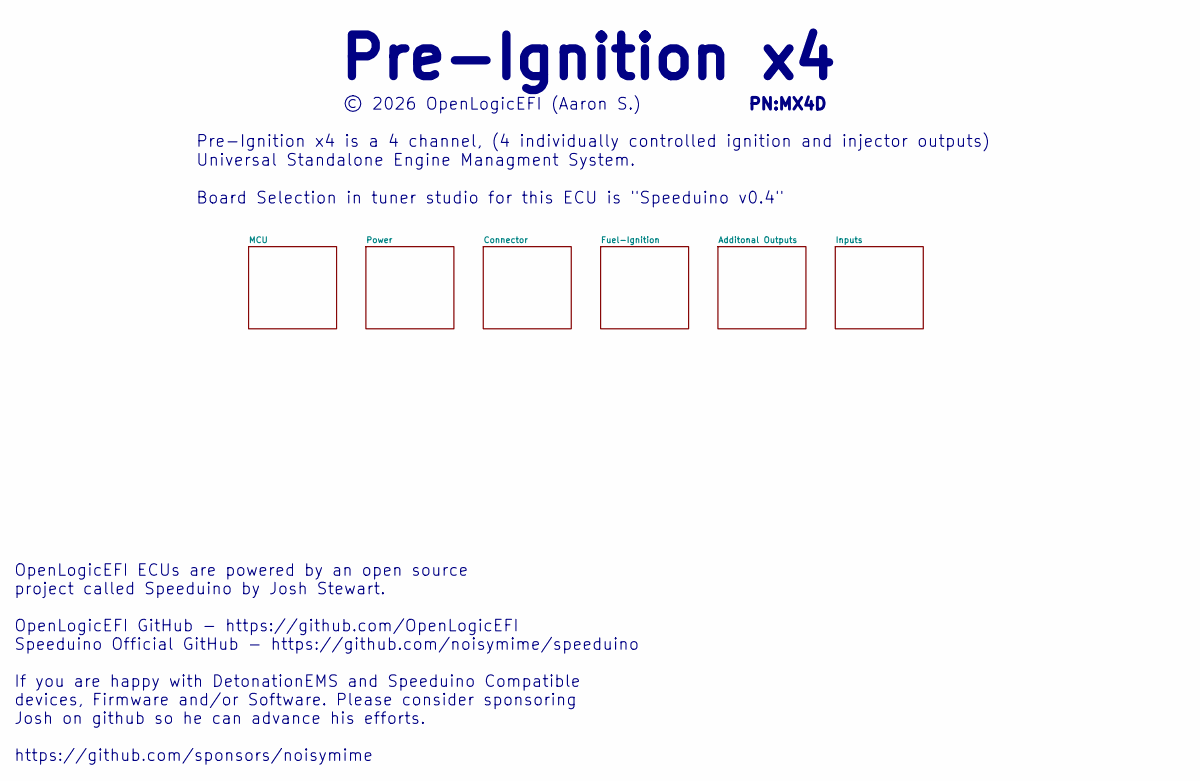
[picture p131: schematic Pre_Ignition.kicad_sch, Pre-Ignition X4]

Notes on the sheet:
Pre-Ignition x4 is a 4 channel, (4 individually controlled ignition and injector outputs) Universal Standalone Engine Managment System. Board Selection in tuner studio for this ECU is "Speeduino v0.4"
© 2026 OpenLogicEFI (Aaron S.)
Pre-Ignition x4
OpenLogicEFI ECUs are powered by an open source project called Speeduino by Josh Stewart. OpenLogicEFI GitHub - https://github.com/OpenLogicEFI Speeduino Official GitHub - https://github.com/noisymime/speeduino If you are happy with DetonationEMS and Speeduino Compatible devices, Firmware and/or So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
PN:MX4D

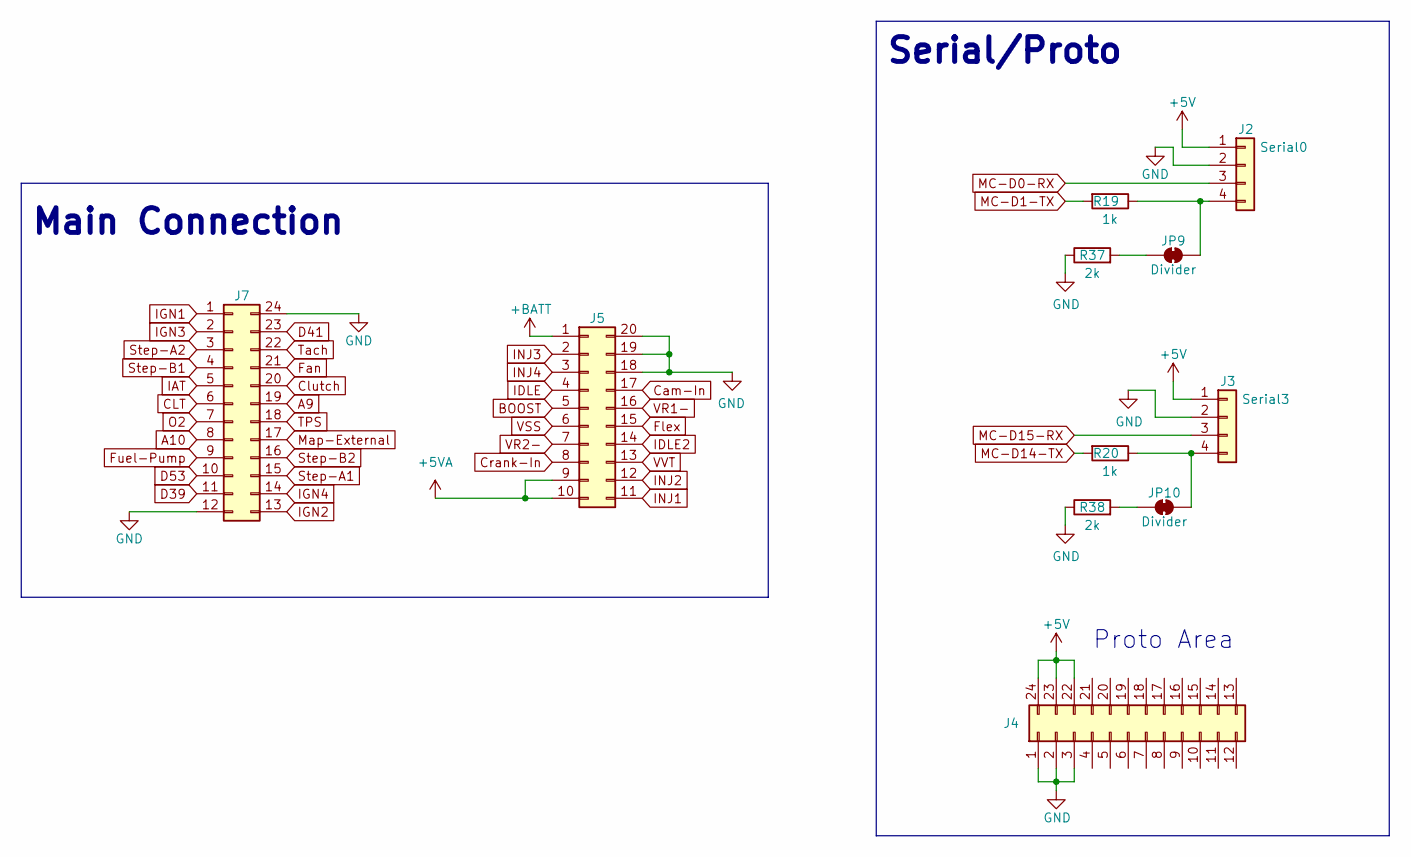
[picture p132: schematic Connector.kicad_sch, Pre-Ignition X4]

Parts:
J2: Serial0; 1X4-PROTO
J3: Serial3; 1X4-PROTO
J4: Conn_02x12_Counter_Clockwise; PROTO-3X8-24pin
J5: Conn_02x10_Counter_Clockwise; Molex_Micro-Fit_3.0_43045-2000_2x10_P3.00mm_Horizontal
J7: Conn_02x12_Counter_Clockwise; Molex_Micro-Fit_3.0_43045-2400_2x12_P3.00mm_Horizontal
JP9, JP10: Divider; SolderJumper-2_P1.3mm_Bridged_RoundedPad1.0x1.5mm
R19, R20: 1k; R_0402_1005Metric; Manufacture Part Number 0402WGF1001TCE; LCSC C11702
R37, R38: 2k; R_0603_1608Metric; LCSC C22975

Connections:
+5V: J2.1, J3.1, J4.22, J4.23, J4.24; also elsewhere on the board
+5VA: J5.9, J5.10; also elsewhere on the board
+BATT: J5.1; also elsewhere on the board
A9: J7.19; also elsewhere on the board
A10: J7.8; also elsewhere on the board
BOOST: J5.5; also elsewhere on the board
CLT: J7.6; also elsewhere on the board
Cam-In: J5.17; also elsewhere on the board
Clutch: J7.20; also elsewhere on the board
Crank-In: J5.8; also elsewhere on the board
D39: J7.11; also elsewhere on the board
D41: J7.23; also elsewhere on the board
D53: J7.10; also elsewhere on the board
Fan: J7.21; also elsewhere on the board
Flex: J5.15; also elsewhere on the board
Fuel-Pump: J7.9; also elsewhere on the board
GND: J2.2, J3.2, J4.1, J4.2, J4.3, J5.18, J5.19, J5.20, J7.12, J7.24, R37.1, R38.1; also elsewhere on the board
IAT: J7.5; also elsewhere on the board
IDLE: J5.4; also elsewhere on the board
IDLE2: J5.14; also elsewhere on the board
IGN1: J7.1; also elsewhere on the board
IGN2: J7.13; also elsewhere on the board
IGN3: J7.2; also elsewhere on the board
IGN4: J7.14; also elsewhere on the board
INJ1: J5.11; also elsewhere on the board
INJ2: J5.12; also elsewhere on the board
INJ3: J5.2; also elsewhere on the board
INJ4: J5.3; also elsewhere on the board
MC-D0-RX: J2.3; also elsewhere on the board
MC-D1-TX: R19.2; also elsewhere on the board
MC-D14-TX: R20.2; also elsewhere on the board
MC-D15-RX: J3.3; also elsewhere on the board
Map-External: J7.17; also elsewhere on the board
unnamed: J2.4, JP9.2 (B), R19.1
unnamed: J3.4, JP10.2 (B), R20.1
unnamed: JP9.1 (A), R37.2
unnamed: JP10.1 (A), R38.2
O2: J7.7; also elsewhere on the board
Step-A1: J7.15; also elsewhere on the board
Step-A2: J7.3; also elsewhere on the board
Step-B1: J7.4; also elsewhere on the board
Step-B2: J7.16; also elsewhere on the board
TPS: J7.18; also elsewhere on the board
Tach: J7.22; also elsewhere on the board
VR1-: J5.16; also elsewhere on the board
VR2-: J5.7; also elsewhere on the board
VSS: J5.6; also elsewhere on the board
VVT: J5.13; also elsewhere on the board

Notes on the sheet:
Proto Area
Serial/Proto
Main Connection

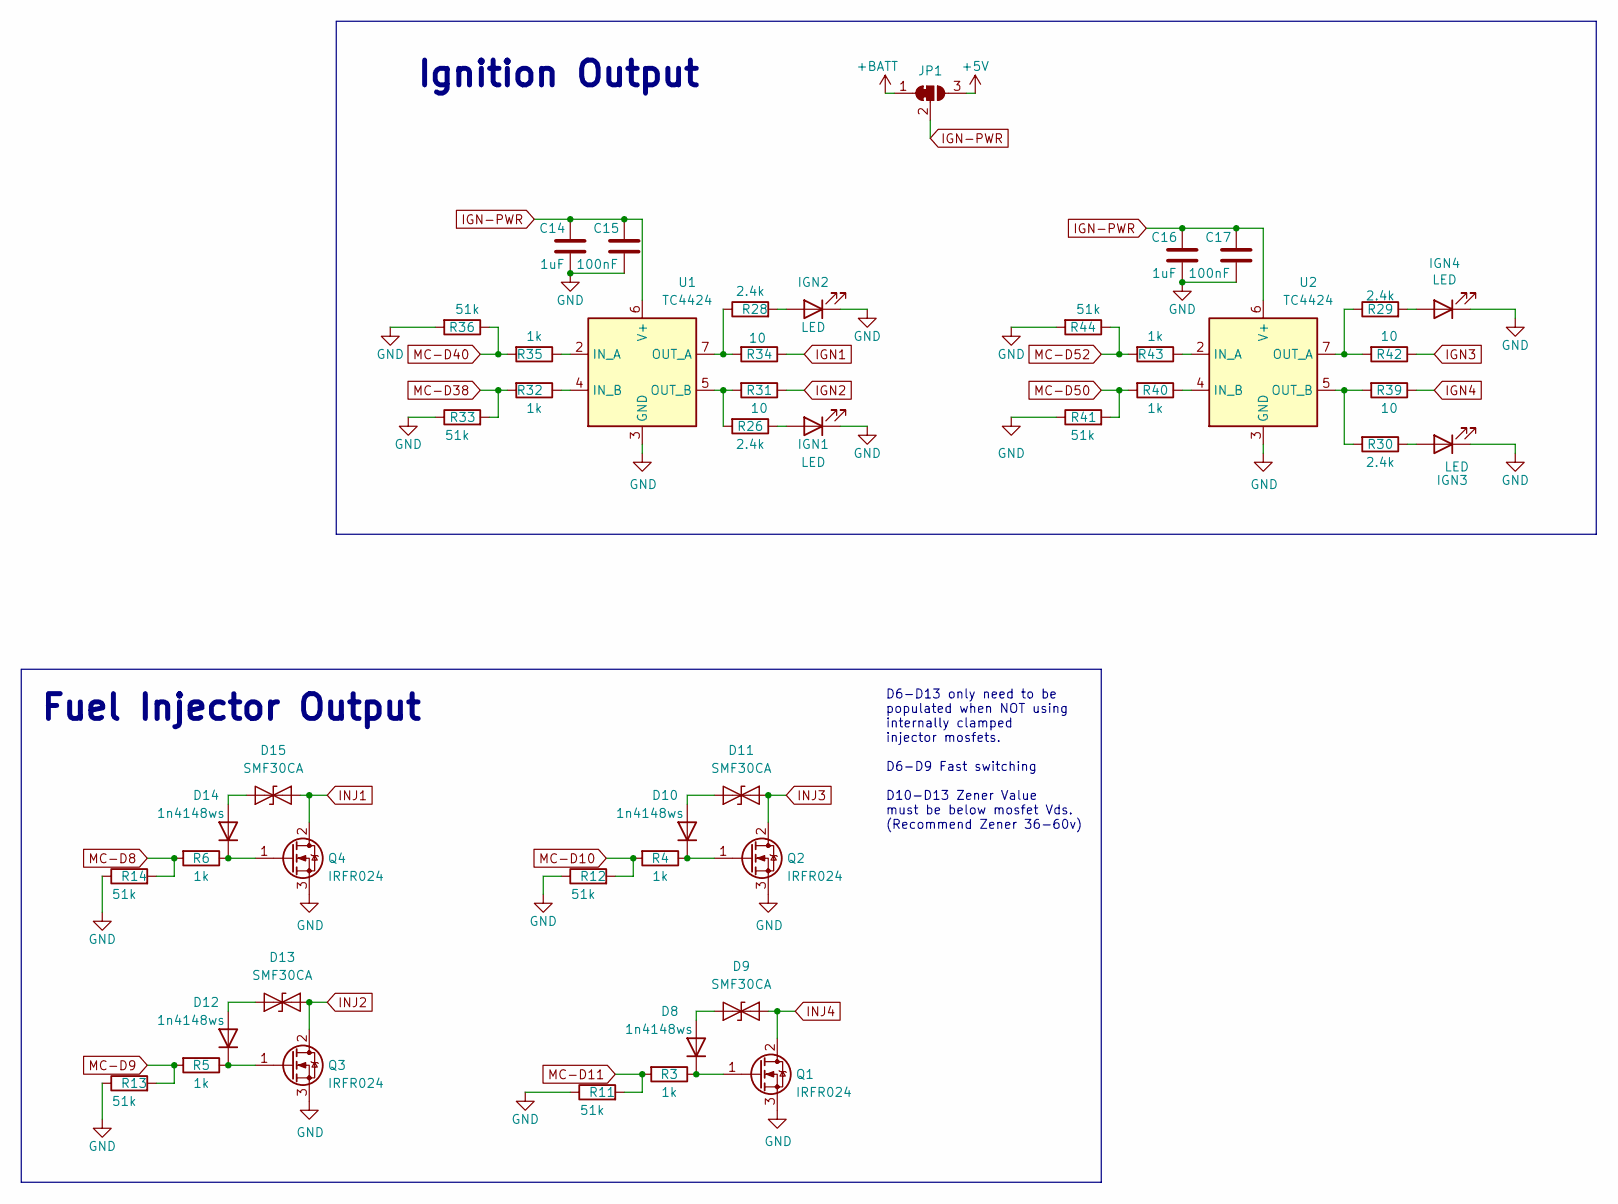
[picture p133: schematic Fuel-Ignition.kicad_sch, Pre-Ignition X4]

Parts:
C14, C16: 1uF; C_0603_1608Metric; LCSC C15849
C15, C17: 100nF; C_0603_1608Metric; LCSC C14663
D8, D10, D12, D14: 1n4148ws; D_SOD-323F; LCSC C2128
D9, D11, D13, D15: SMF30CA; D_SOD-123F; LCSC C19077519
IGN1, IGN2, IGN3, IGN4: LED; LED_0603_1608Metric; LCSC C2286
JP1: SolderJumper_3_Bridged12; 1x03_Horizontal_2.54mm
Q1, Q2, Q3, Q4: IRFR024; TO-252-2; LCSC C2583
R3, R4, R5, R6, R32, R35, R40, R43: 1k; R_0402_1005Metric; Manufacture Part Number 0402WGF1001TCE; LCSC C11702
R11, R12, R13, R14, R33, R36, R41, R44: 51k; R_0402_1005Metric; Manufacture Part Number 0402WGF5102TCE; LCSC C25794
R26, R28, R29, R30: 2.4k; C_0603_1608Metric; LCSC C22940
R31, R34, R39, R42: 10; R_1206_3216Metric; LCSC C17903
U1, U2: TC4424; SOIC-8_3.9x4.9mm_P1.27mm; LCSC C2685358

Connections:
+5V: JP1.3 (B); also elsewhere on the board
+BATT: JP1.1 (A); also elsewhere on the board
GND: C14.2, C15.2, C16.2, C17.2, IGN1.1 (K), IGN2.1 (K), IGN3.1 (K), IGN4.1 (K), Q1.3 (S), Q2.3 (S), Q3.3 (S), Q4.3 (S), R11.1, R12.1, R13.1, R14.1, R33.1, R36.2, R41.1, R44.2, U1.3 (GND), U2.3 (GND); also elsewhere on the board
IGN1: R34.1; also elsewhere on the board
IGN2: R31.1; also elsewhere on the board
IGN3: R42.1; also elsewhere on the board
IGN4: R39.1; also elsewhere on the board
IGN-PWR: C14.1, C15.1, C16.1, C17.1, JP1.2 (C), U1.6 (V+), U2.6 (V+)
INJ1: D15.1 (A1), Q4.2 (D); also elsewhere on the board
INJ2: D13.1 (A1), Q3.2 (D); also elsewhere on the board
INJ3: D11.1 (A1), Q2.2 (D); also elsewhere on the board
INJ4: D9.1 (A1), Q1.2 (D); also elsewhere on the board
MC-D8: R6.2, R14.2; also elsewhere on the board
MC-D9: R5.2, R13.2; also elsewhere on the board
MC-D10: R4.2, R12.2; also elsewhere on the board
MC-D11: R3.2, R11.2; also elsewhere on the board
MC-D38: R32.2, R33.2; also elsewhere on the board
MC-D40: R35.2, R36.1; also elsewhere on the board
MC-D50: R40.2, R41.2; also elsewhere on the board
MC-D52: R43.2, R44.1; also elsewhere on the board
unnamed: D8.2 (A), D9.2 (A2)
unnamed: D8.1 (K), Q1.1 (G), R3.1
unnamed: D10.2 (A), D11.2 (A2)
unnamed: D10.1 (K), Q2.1 (G), R4.1
unnamed: D12.2 (A), D13.2 (A2)
unnamed: D12.1 (K), Q3.1 (G), R5.1
unnamed: D14.2 (A), D15.2 (A2)
unnamed: D14.1 (K), Q4.1 (G), R6.1
unnamed: IGN1.2 (A), R26.1
unnamed: IGN2.2 (A), R28.2
unnamed: IGN3.2 (A), R30.1
unnamed: IGN4.2 (A), R29.2
unnamed: R35.1, U1.2 (IN_A)
unnamed: R32.1, U1.4 (IN_B)
unnamed: R28.1, R34.2, U1.7 (OUT_A)
unnamed: R26.2, R31.2, U1.5 (OUT_B)
unnamed: R43.1, U2.2 (IN_A)
unnamed: R40.1, U2.4 (IN_B)
unnamed: R29.1, R42.2, U2.7 (OUT_A)
unnamed: R30.2, R39.2, U2.5 (OUT_B)

Notes on the sheet:
Fuel Injector Output
D6-D13 only need to be populated when NOT using internally clamped injector mosfets. D6-D9 Fast switching D10-D13 Zener Value must be below mosfet Vds. (Recommend Zener 36-60v)
Ignition Output

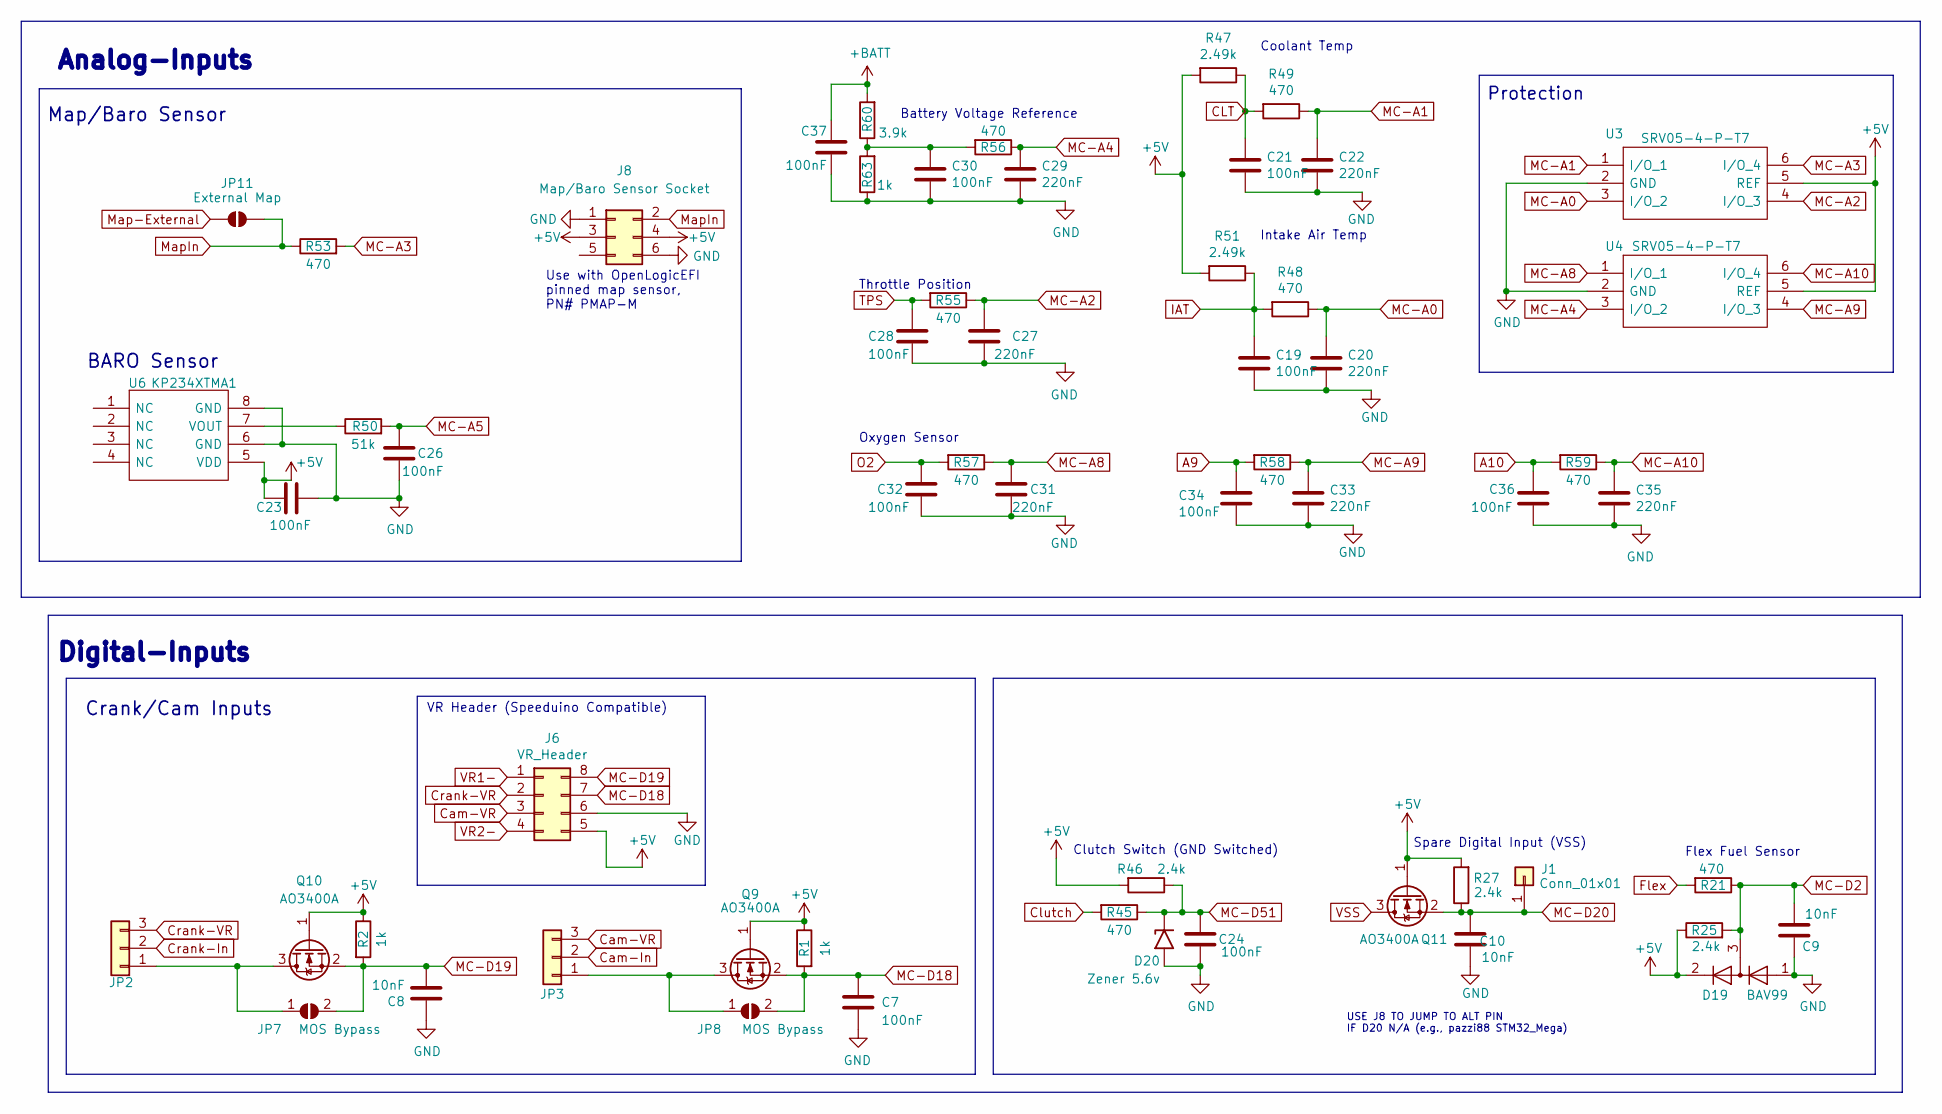
[picture p134: schematic Analog.kicad_sch, Pre-Ignition X4]

Parts:
C7, C19, C21, C23, C24, C26, C28, C30, C32, C34, C36, C37: 100nF; C_0603_1608Metric; LCSC C14663
C8, C9, C10: 10nF; C_0603_1608Metric; LCSC C57112
C20, C22, C27, C29, C31, C33, C35: 220nF; C_0603_1608Metric; LCSC C21120
D19: BAV99; SOT-23; LCSC C2500
D20: Zener 5.6v; D_SOD-323; Manufacture Part Number MM3Z5V6; LCSC C19077456
J1: Conn_01x01; PinSocket_1x01_P2.54mm_Vertical
J6: VR_Header; Socket_VRConditioner_Corrected
J8: Map/Baro Sensor Socket; PinSocket_2x03_P2.54mm_Vertical
JP2, JP3: Conn_01x03; 1x03-Proto
JP7, JP8: MOS Bypass; SolderJumper-2_P1.3mm_Open_RoundedPad1.0x1.5mm
JP11: External Map; SolderJumper-2_P1.3mm_Open_RoundedPad1.0x1.5mm
Q9, Q10, Q11: AO3400A; SOT-23; LCSC C20917
R1, R2, R63: 1k; R_0402_1005Metric; Manufacture Part Number 0402WGF1001TCE; LCSC C11702
R21, R45, R48, R49, R53, R55, R56, R57, R58, R59: 470; R_0603_1608Metric; LCSC C23179
R25: 2.4k; C_0603_1608Metric; LCSC C22940
R27, R46: 2.4k; C_0603_1608Metric; Manufacture Part Number 0402WGF1001TCE; LCSC C22940
R47, R51: 2.49k; R_Axial_DIN0207_L6.3mm_D2.5mm_P7.62mm_Horizontal
R50: 51k; R_0402_1005Metric; Manufacture Part Number 0402WGF5102TCE; LCSC C25794
R60: 3.9k; R_0603_1608Metric; LCSC C23018
U3, U4: SRV05-4-P-T7; SOT-23-6; LCSC C85364
U6: KP234XTMA1; KP234-Handsoldering

Connections:
+5V: C23.2, D19.2 (A), J6.5, J8.3, J8.4, Q9.1 (G), Q10.1 (G), Q11.1 (G), R1.1, R2.1, R25.1, R27.2, R46.2, R47.2, R51.2, U3.5 (REF), U4.5 (REF), U6.5 (VDD); also elsewhere on the board
+BATT: C37.1, R60.2; also elsewhere on the board
A9: C34.1, R58.2; also elsewhere on the board
A10: C36.1, R59.2; also elsewhere on the board
CLT: C21.1, R47.1, R49.2; also elsewhere on the board
Cam-In: JP3.2; also elsewhere on the board
Cam-VR: J6.3, JP3.3
Clutch: R45.2; also elsewhere on the board
Crank-In: JP2.2; also elsewhere on the board
Crank-VR: J6.2, JP2.3
Flex: R21.2; also elsewhere on the board
GND: C7.1, C8.1, C9.2, C10.2, C19.2, C20.2, C21.2, C22.2, C23.1, C24.2, C26.1, C27.2, C28.2, C29.2, C30.2, C31.2, C32.2, C33.2, C34.2, C35.2, C36.2, C37.2, D19.1 (K), D20.2 (A2), J6.6, J8.1, J8.6, R63.1, U3.2 (GND), U4.2 (GND), U6.6 (GND), U6.8 (GND); also elsewhere on the board
IAT: C19.1, R48.2, R51.1; also elsewhere on the board
MC-A0: C20.1, R48.1, U3.3 (I/O_2); also elsewhere on the board
MC-A1: C22.1, R49.1, U3.1 (I/O_1); also elsewhere on the board
MC-A2: C27.1, R55.1, U3.4 (I/O_3); also elsewhere on the board
MC-A3: R53.2, U3.6 (I/O_4); also elsewhere on the board
MC-A4: C29.1, R56.1, U4.3 (I/O_2); also elsewhere on the board
MC-A5: C26.2, R50.2; also elsewhere on the board
MC-A8: C31.1, R57.1, U4.1 (I/O_1); also elsewhere on the board
MC-A9: C33.1, R58.1, U4.4 (I/O_3); also elsewhere on the board
MC-A10: C35.1, R59.1, U4.6 (I/O_4); also elsewhere on the board
MC-D2: C9.1, D19.3 (K), R21.1, R25.2; also elsewhere on the board
MC-D18: C7.2, J6.7, JP8.2 (B), Q9.2 (S), R1.2; also elsewhere on the board
MC-D19: C8.2, J6.8, JP7.2 (B), Q10.2 (S), R2.2; also elsewhere on the board
MC-D20: C10.1, J1.1, Q11.2 (S), R27.1; also elsewhere on the board
MC-D51: C24.1, D20.1 (A1), R45.1, R46.1; also elsewhere on the board
Map-External: JP11.1 (A); also elsewhere on the board
MapIn: J8.2, JP11.2 (B), R53.1
unnamed: C30.1, R56.2, R60.1, R63.2
unnamed: JP2.1, JP7.1 (A), Q10.3 (D)
unnamed: JP3.1, JP8.1 (A), Q9.3 (D)
unnamed: R50.1, U6.7 (VOUT)
O2: C32.1, R57.2; also elsewhere on the board
TPS: C28.1, R55.2; also elsewhere on the board
VR1-: J6.1; also elsewhere on the board
VR2-: J6.4; also elsewhere on the board
VSS: Q11.3 (D); also elsewhere on the board

Notes on the sheet:
Map/Baro Sensor
Throttle Position
Clutch Switch (GND Switched)
Crank/Cam Inputs
Analog-Inputs
Oxygen Sensor
BARO Sensor
Coolant Temp
Intake Air Temp
VR Header (Speeduino Compatible)
Battery Voltage Reference
Spare Digital Input (VSS)
USE J8 TO JUMP TO ALT PIN IF D20 N/A (e.g., pazzi88 STM32_Mega)
Use with OpenLogicEFI pinned map sensor, PN# PMAP-M
Flex Fuel Sensor
Protection
Digital-Inputs

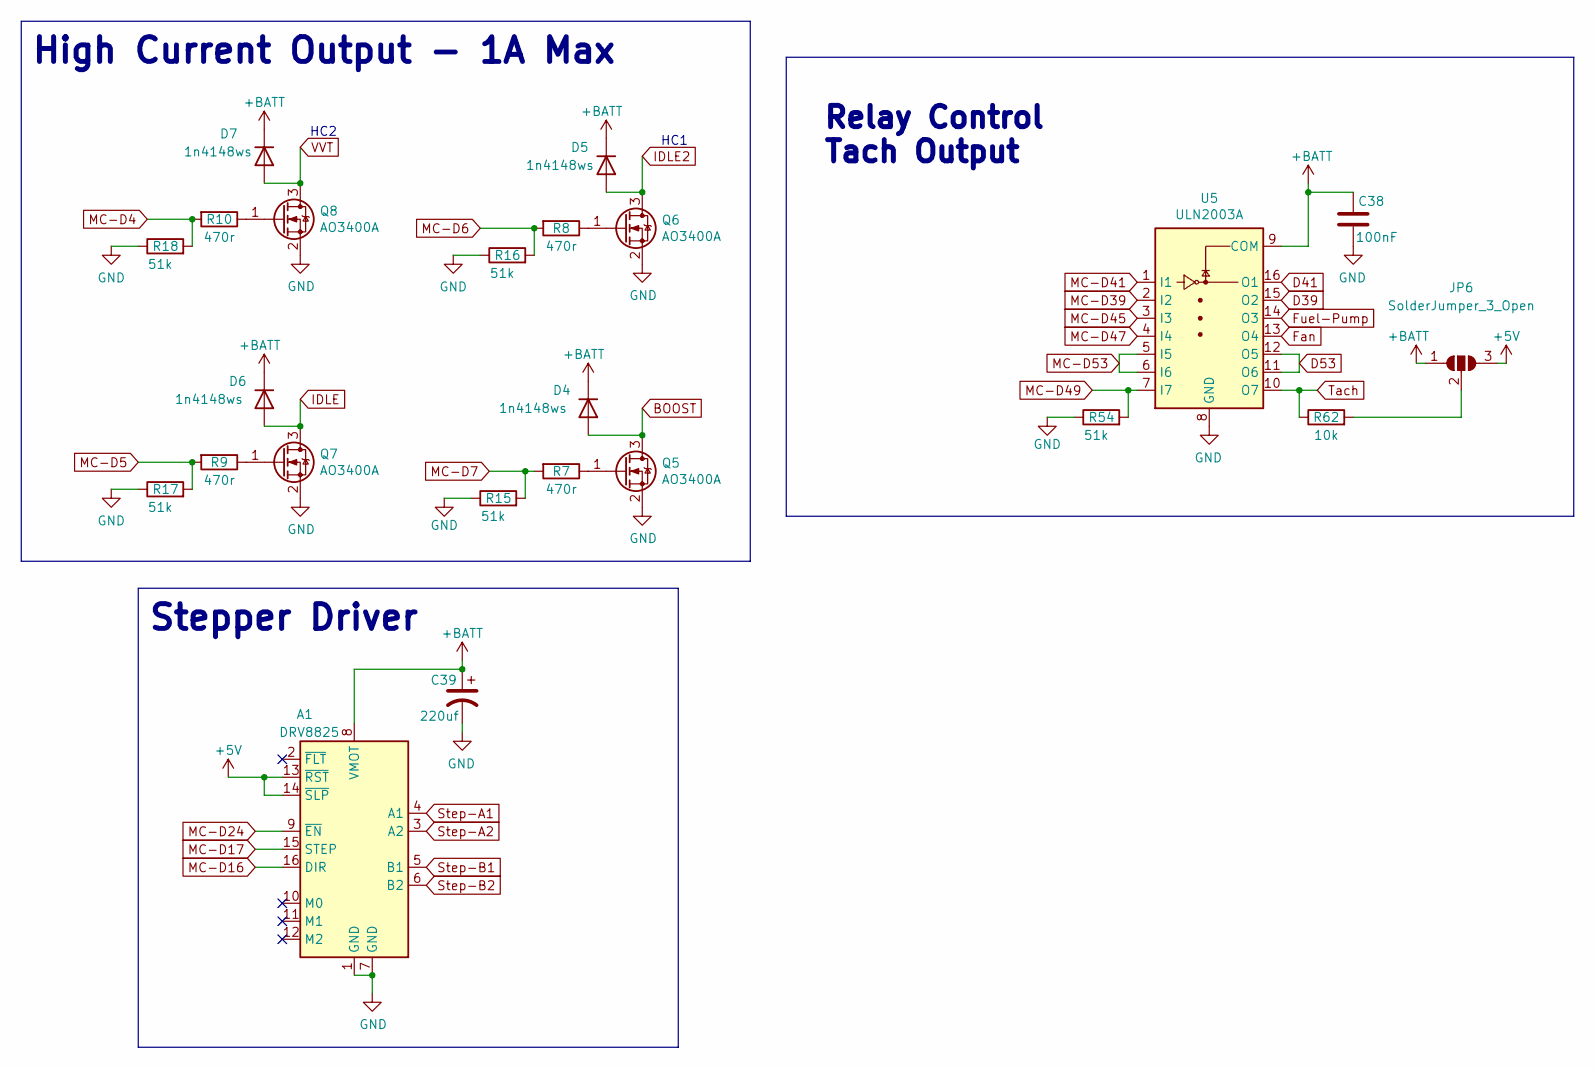
[picture p135: schematic Output.kicad_sch, Pre-Ignition X4]

Parts:
A1: DRV8825; DVR8825-Labeled-Front
C38: 100nF; C_0603_1608Metric; LCSC C14663
C39: 220uf; CP_6.3x11mm_horiz-R
D4, D5, D6, D7: 1n4148ws; D_SOD-323F; LCSC C2128
JP6: SolderJumper_3_Open; SolderJumper-3-OPEN
Q5, Q6, Q7, Q8: AO3400A; SOT-23; LCSC C20917
R7, R8, R9, R10: 470r; R_0402_1005Metric; LCSC C25117
R15, R16, R17, R18, R54: 51k; R_0402_1005Metric; Manufacture Part Number 0402WGF5102TCE; LCSC C25794
R62: 10k; R_0603_1608Metric; LCSC C25804
U5: ULN2003A; SOIC-16_3.9x9.9mm_P1.27mm; LCSC C7512

Connections:
+5V: A1.13 (~RST), A1.14 (~SLP), JP6.3 (B); also elsewhere on the board
+BATT: A1.8 (VMOT), C38.2, C39.1, D4.1 (K), D5.1 (K), D6.1 (K), D7.1 (K), JP6.1 (A), U5.9 (COM); also elsewhere on the board
BOOST: D4.2 (A), Q5.3 (D); also elsewhere on the board
D39: U5.15 (O2); also elsewhere on the board
D41: U5.16 (O1); also elsewhere on the board
D53: U5.11 (O6), U5.12 (O5); also elsewhere on the board
Fan: U5.13 (O4); also elsewhere on the board
Fuel-Pump: U5.14 (O3); also elsewhere on the board
GND: A1.1 (GND), A1.7 (GND), C38.1, C39.2, Q5.2 (S), Q6.2 (S), Q7.2 (S), Q8.2 (S), R15.1, R16.1, R17.1, R18.1, R54.1, U5.8 (GND); also elsewhere on the board
IDLE: D6.2 (A), Q7.3 (D); also elsewhere on the board
IDLE2: D5.2 (A), Q6.3 (D); also elsewhere on the board
MC-D4: R10.2, R18.2; also elsewhere on the board
MC-D5: R9.2, R17.2; also elsewhere on the board
MC-D6: R8.2, R16.2; also elsewhere on the board
MC-D7: R7.2, R15.2; also elsewhere on the board
MC-D16: A1.16 (DIR); also elsewhere on the board
MC-D17: A1.15 (STEP); also elsewhere on the board
MC-D24: A1.9 (~EN); also elsewhere on the board
MC-D39: U5.2 (I2); also elsewhere on the board
MC-D41: U5.1 (I1); also elsewhere on the board
MC-D45: U5.3 (I3); also elsewhere on the board
MC-D47: U5.4 (I4); also elsewhere on the board
MC-D49: R54.2, U5.7 (I7); also elsewhere on the board
MC-D53: U5.5 (I5), U5.6 (I6); also elsewhere on the board
unnamed: JP6.2 (C), R62.2
unnamed: Q5.1 (G), R7.1
unnamed: Q6.1 (G), R8.1
unnamed: Q7.1 (G), R9.1
unnamed: Q8.1 (G), R10.1
Step-A1: A1.4 (A1); also elsewhere on the board
Step-A2: A1.3 (A2); also elsewhere on the board
Step-B1: A1.5 (B1); also elsewhere on the board
Step-B2: A1.6 (B2); also elsewhere on the board
Tach: R62.1, U5.10 (O7); also elsewhere on the board
VVT: D7.2 (A), Q8.3 (D); also elsewhere on the board

Notes on the sheet:
High Current Output - 1A Max
HC2
HC1
Relay Control Tach Output
Stepper Driver
