OpenLogicEFI/Hardware/Engine Managment/Pre-Ignition/Pre-Ignition x4/MX4D/Pre_Ignition.kicad_pcb

## KiCad design Engine Managment/Pre-Ignition/Pre-Ignition x4/MX4D/Pre_Ignition.kicad_pcb (continued)

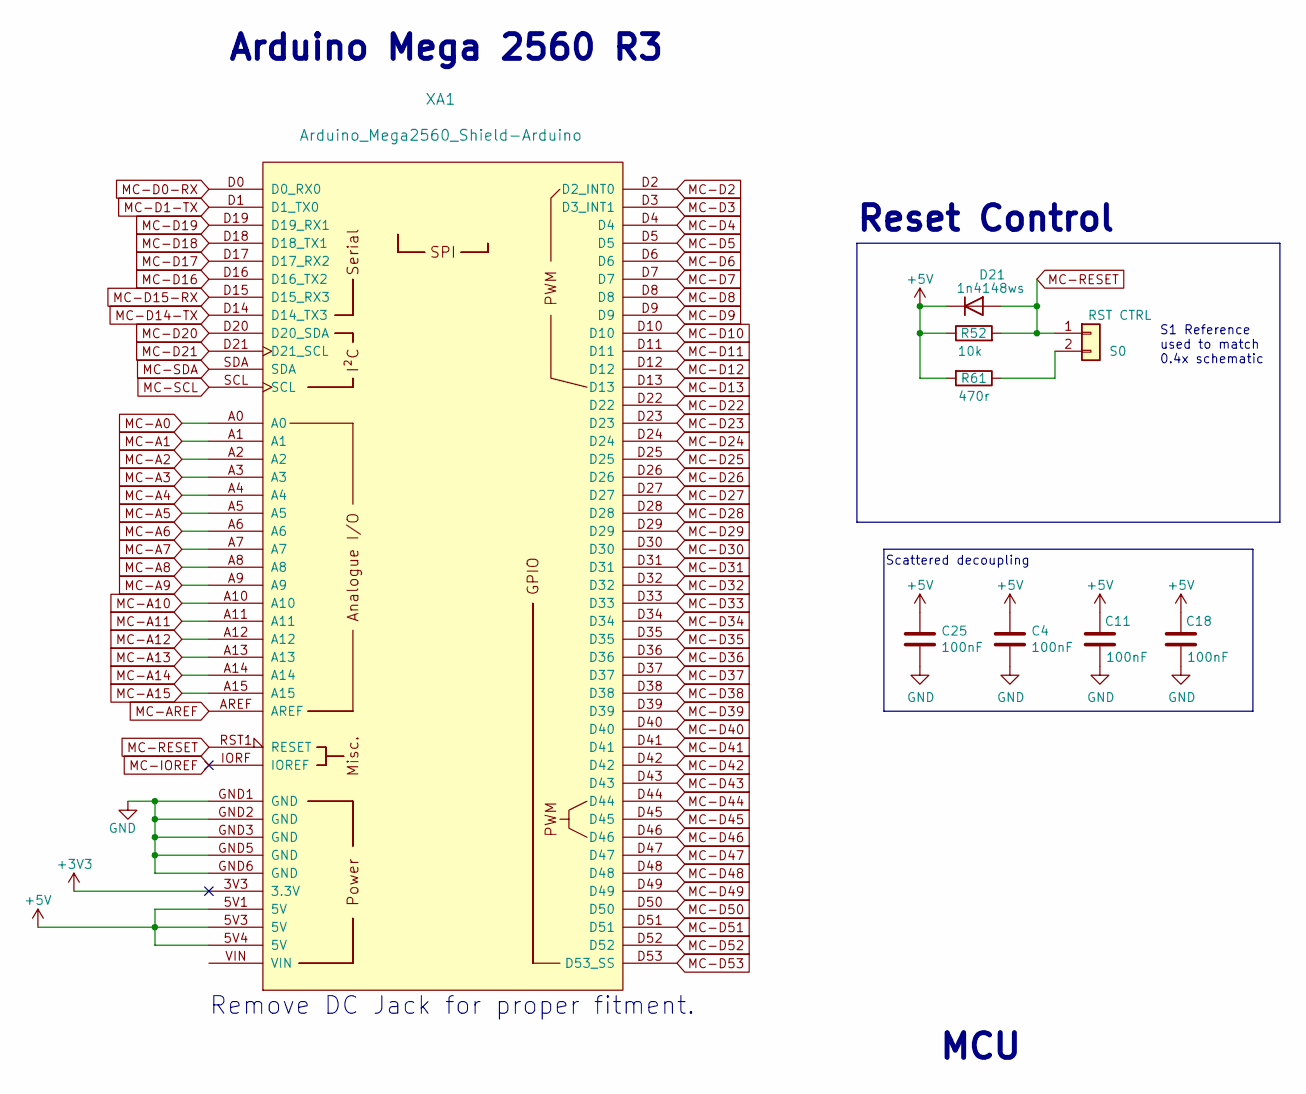
[picture p136: schematic mcu.kicad_sch, Pre-Ignition X4]

Parts:
C4, C11, C18, C25: 100nF; C_0603_1608Metric; LCSC C14663
D21: 1n4148ws; D_SOD-323F; LCSC C2128
R52: 10k; R_0603_1608Metric; LCSC C25804
R61: 470r; R_0402_1005Metric; LCSC C25117
S0: RST CTRL; 1x02-Proto
XA1: Arduino_Mega2560_Shield-Arduino; Arduino-Mega2560-Shield-Speeduino

Connections:
+3V3: XA1.3V3 (3.3V)
+5V: C4.1, C11.2, C18.2, C25.1, D21.1 (K), R52.1, R61.2, XA1.5V1 (5V), XA1.5V3 (5V), XA1.5V4 (5V); also elsewhere on the board
GND: C4.2, C11.1, C18.1, C25.2, XA1.GND1 (GND), XA1.GND2 (GND), XA1.GND3 (GND), XA1.GND5 (GND), XA1.GND6 (GND); also elsewhere on the board
MC-A0: XA1.A0; also elsewhere on the board
MC-A1: XA1.A1; also elsewhere on the board
MC-A2: XA1.A2; also elsewhere on the board
MC-A3: XA1.A3; also elsewhere on the board
MC-A4: XA1.A4; also elsewhere on the board
MC-A5: XA1.A5; also elsewhere on the board
MC-A6: XA1.A6
MC-A7: XA1.A7
MC-A8: XA1.A8; also elsewhere on the board
MC-A9: XA1.A9; also elsewhere on the board
MC-A10: XA1.A10; also elsewhere on the board
MC-A11: XA1.A11
MC-A12: XA1.A12
MC-A13: XA1.A13
MC-A14: XA1.A14
MC-A15: XA1.A15
MC-AREF: XA1.AREF
MC-D0-RX: XA1.D0 (D0_RX0); also elsewhere on the board
MC-D1-TX: XA1.D1 (D1_TX0); also elsewhere on the board
MC-D2: XA1.D2 (D2_INT0); also elsewhere on the board
MC-D3: XA1.D3 (D3_INT1)
MC-D4: XA1.D4; also elsewhere on the board
MC-D5: XA1.D5; also elsewhere on the board
MC-D6: XA1.D6; also elsewhere on the board
MC-D7: XA1.D7; also elsewhere on the board
MC-D8: XA1.D8; also elsewhere on the board
MC-D9: XA1.D9; also elsewhere on the board
MC-D10: XA1.D10; also elsewhere on the board
MC-D11: XA1.D11; also elsewhere on the board
MC-D12: XA1.D12
MC-D13: XA1.D13
MC-D14-TX: XA1.D14 (D14_TX3); also elsewhere on the board
MC-D15-RX: XA1.D15 (D15_RX3); also elsewhere on the board
MC-D16: XA1.D16 (D16_TX2); also elsewhere on the board
MC-D17: XA1.D17 (D17_RX2); also elsewhere on the board
MC-D18: XA1.D18 (D18_TX1); also elsewhere on the board
MC-D19: XA1.D19 (D19_RX1); also elsewhere on the board
MC-D20: XA1.D20 (D20_SDA); also elsewhere on the board
MC-D21: XA1.D21 (D21_SCL)
MC-D22: XA1.D22
MC-D23: XA1.D23
MC-D24: XA1.D24; also elsewhere on the board
MC-D25: XA1.D25
MC-D26: XA1.D26
MC-D27: XA1.D27
MC-D28: XA1.D28
MC-D29: XA1.D29
MC-D30: XA1.D30
MC-D31: XA1.D31
MC-D32: XA1.D32
MC-D33: XA1.D33
MC-D34: XA1.D34
MC-D35: XA1.D35
MC-D36: XA1.D36
MC-D37: XA1.D37
MC-D38: XA1.D38; also elsewhere on the board
MC-D39: XA1.D39; also elsewhere on the board
MC-D40: XA1.D40; also elsewhere on the board
MC-D41: XA1.D41; also elsewhere on the board
MC-D42: XA1.D42
MC-D43: XA1.D43
MC-D44: XA1.D44
MC-D45: XA1.D45; also elsewhere on the board
MC-D46: XA1.D46
MC-D47: XA1.D47; also elsewhere on the board
MC-D48: XA1.D48
MC-D49: XA1.D49; also elsewhere on the board
MC-D50: XA1.D50; also elsewhere on the board
MC-D51: XA1.D51; also elsewhere on the board
MC-D52: XA1.D52; also elsewhere on the board
MC-D53: XA1.D53 (D53_SS); also elsewhere on the board
MC-IOREF: XA1.IORF (IOREF)
MC-RESET: D21.2 (A), R52.2, S0.1, XA1.RST1 (RESET)
MC-SCL: XA1.SCL
MC-SDA: XA1.SDA
unnamed: R61.1, S0.2

Notes on the sheet:
Remove DC Jack for proper fitment.
Reset Control
Scattered decoupling
S1 Reference used to match 0.4x schematic
MCU
Arduino Mega 2560 R3

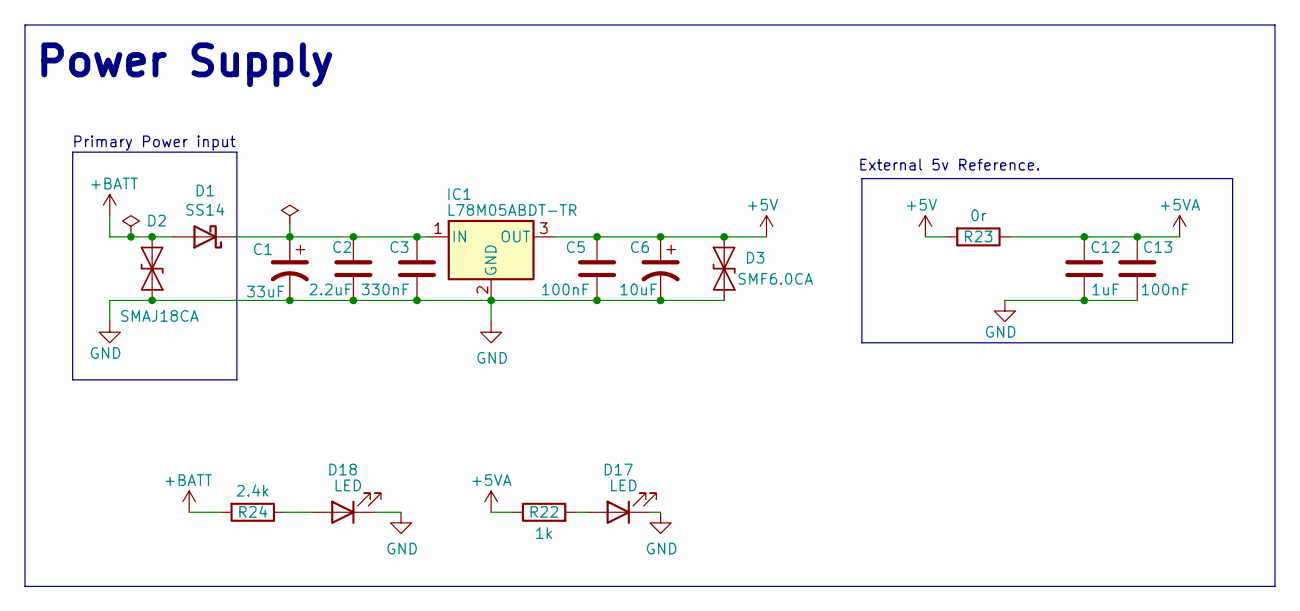
[picture p137: schematic power.kicad_sch, Pre-Ignition X4]

Parts:
C1: 33uF; CP_EIA-7343-31_Kemet-D; LCSC C571271
C2: 2.2uF; C_1206_3216Metric; Manufacture Part Number CL31B225KBHNNNE; LCSC C50254
C3: 330nF; C_0805_2012Metric; Manufacture Part Number 0805B334K500NT; LCSC C1740
C5, C13: 100nF; C_0603_1608Metric; LCSC C14663
C6: 10uF; CP_EIA-3216-18_Kemet-A; Manufacture Part Number TAJA106K016RNJ; LCSC C7171
C12: 1uF; C_0603_1608Metric; LCSC C15849
D1: SS14; D_SMA; Manufacture Part Number SS14; LCSC C2480
D2: SMAJ18CA; D_SMA; Manufacture Part Number SMAJ18CA; LCSC C19077539
D3: SMF6.0CA; D_SOD-123F; LCSC C2990473
D17, D18: LED; LED_0603_1608Metric; LCSC C2286
IC1: L78M05ABDT-TR; TO-252-2-Thermal-with-Silk; Manufacture Part Number L78M05ABDT-TR; LCSC C58069
R22: 1k; R_0402_1005Metric; Manufacture Part Number 0402WGF1001TCE; LCSC C11702
R23: 0r; R_1206_3216Metric; LCSC C17888
R24: 2.4k; C_0603_1608Metric; LCSC C22940

Connections:
+5V: C5.2, C6.1, D3.1 (A1), IC1.3 (OUT), R23.2; also elsewhere on the board
+5VA: C12.1, C13.2, R22.1, R23.1; also elsewhere on the board
+BATT: D1.2 (A), D2.2 (A2), R24.2; also elsewhere on the board
GND: C1.2, C2.2, C3.2, C5.1, C6.2, C12.2, C13.1, D2.1 (A1), D3.2 (A2), D17.1 (K), D18.1 (K), IC1.2 (GND); also elsewhere on the board
unnamed: C1.1, C2.1, C3.1, D1.1 (K), IC1.1 (IN)
unnamed: D17.2 (A), R22.2
unnamed: D18.2 (A), R24.1

Notes on the sheet:
Primary Power input
External 5v Reference.
Power Supply

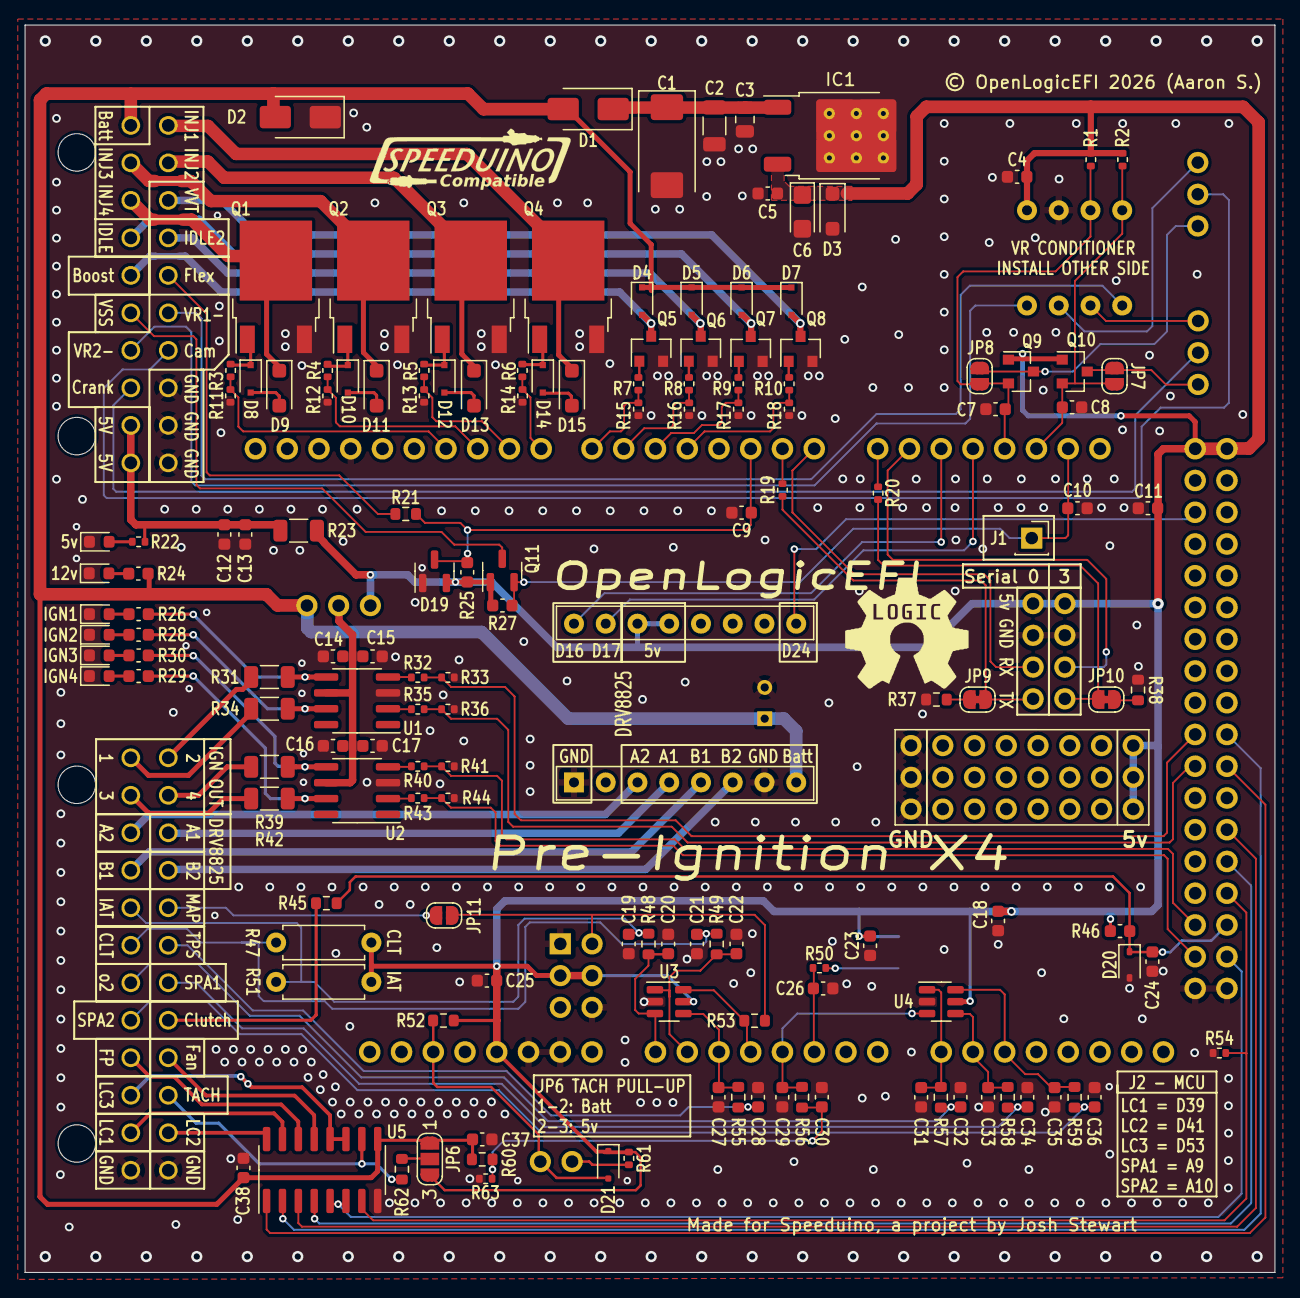
[picture p138: board Engine Managment/Pre-Ignition/Pre-Ignition x4/MX4D/Pre_Ignition.kicad… from above]

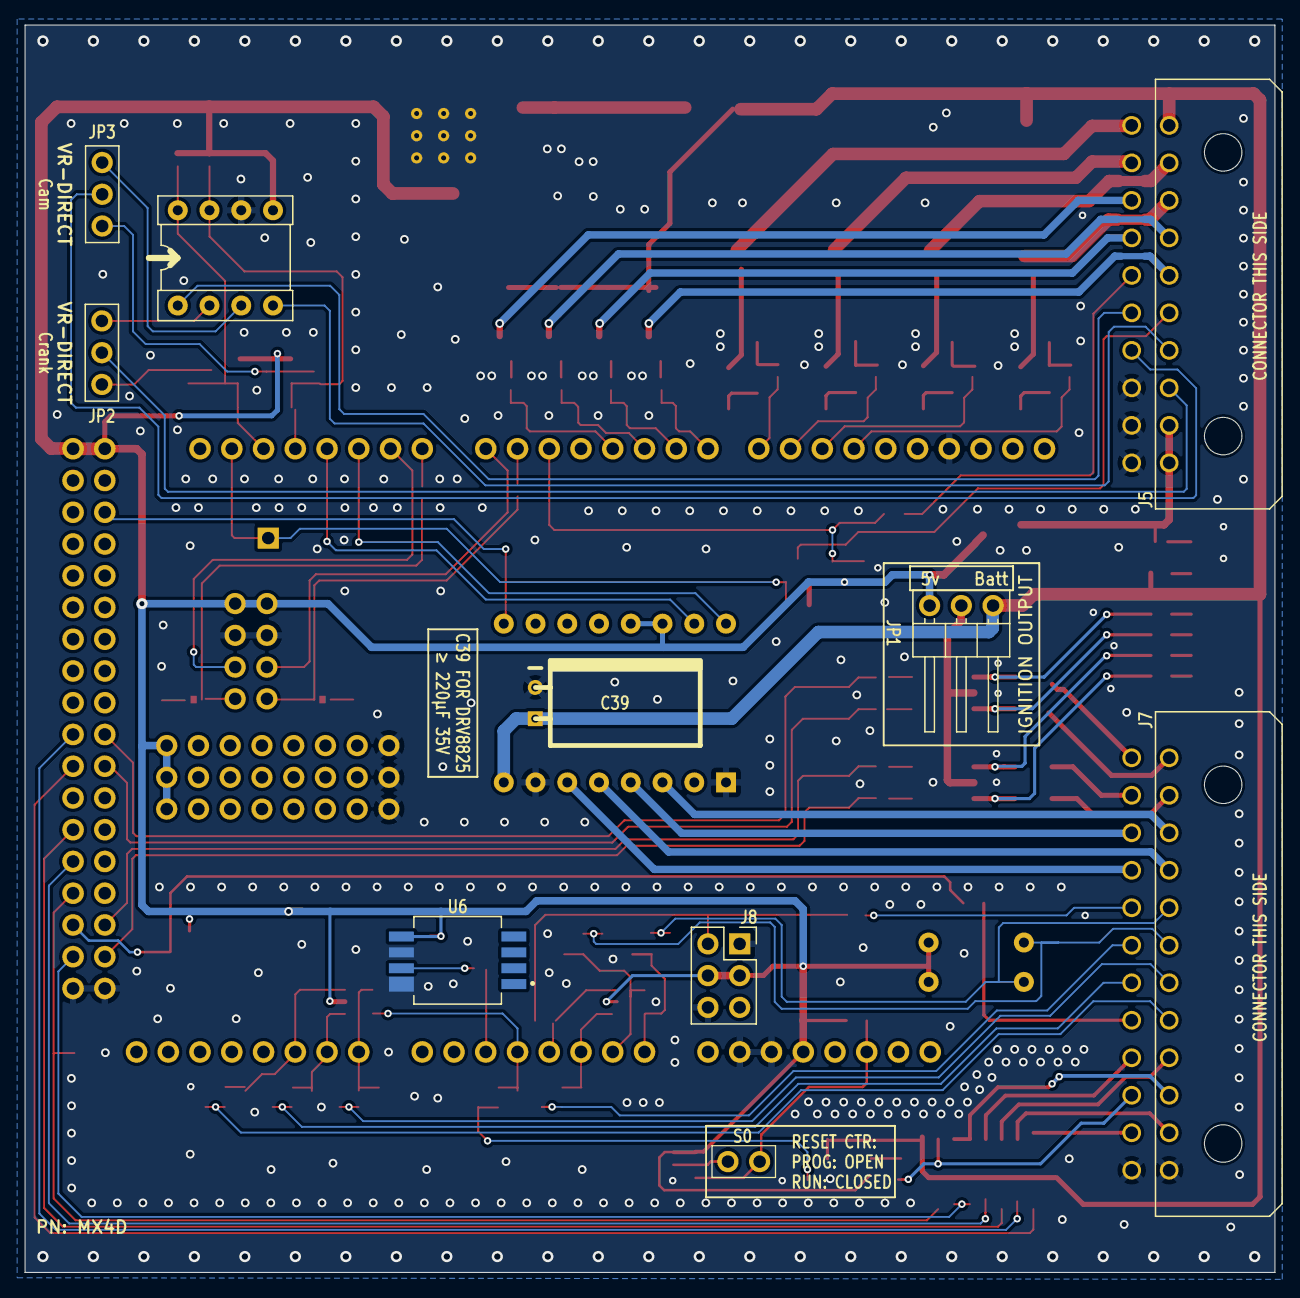
[picture p139: board Engine Managment/Pre-Ignition/Pre-Ignition x4/MX4D/Pre_Ignition.kicad… from below]

Board: 2 copper layers, 100.0 x 99.8 mm, 166 parts (10 on the bottom side), 121 nets.

Other parts of the board:
G1: LOGO; SpeeduinoCompatible-17mm
G2: LOGO; open-logic-10
