OpenLogicEFI/Hardware/Modules/VR Conditioner NCV1124/RevA/Duel VR.kicad_pcb

## KiCad design Modules/VR Conditioner NCV1124/RevA/Duel VR.kicad_pcb (2022-10-29, an earlier design)

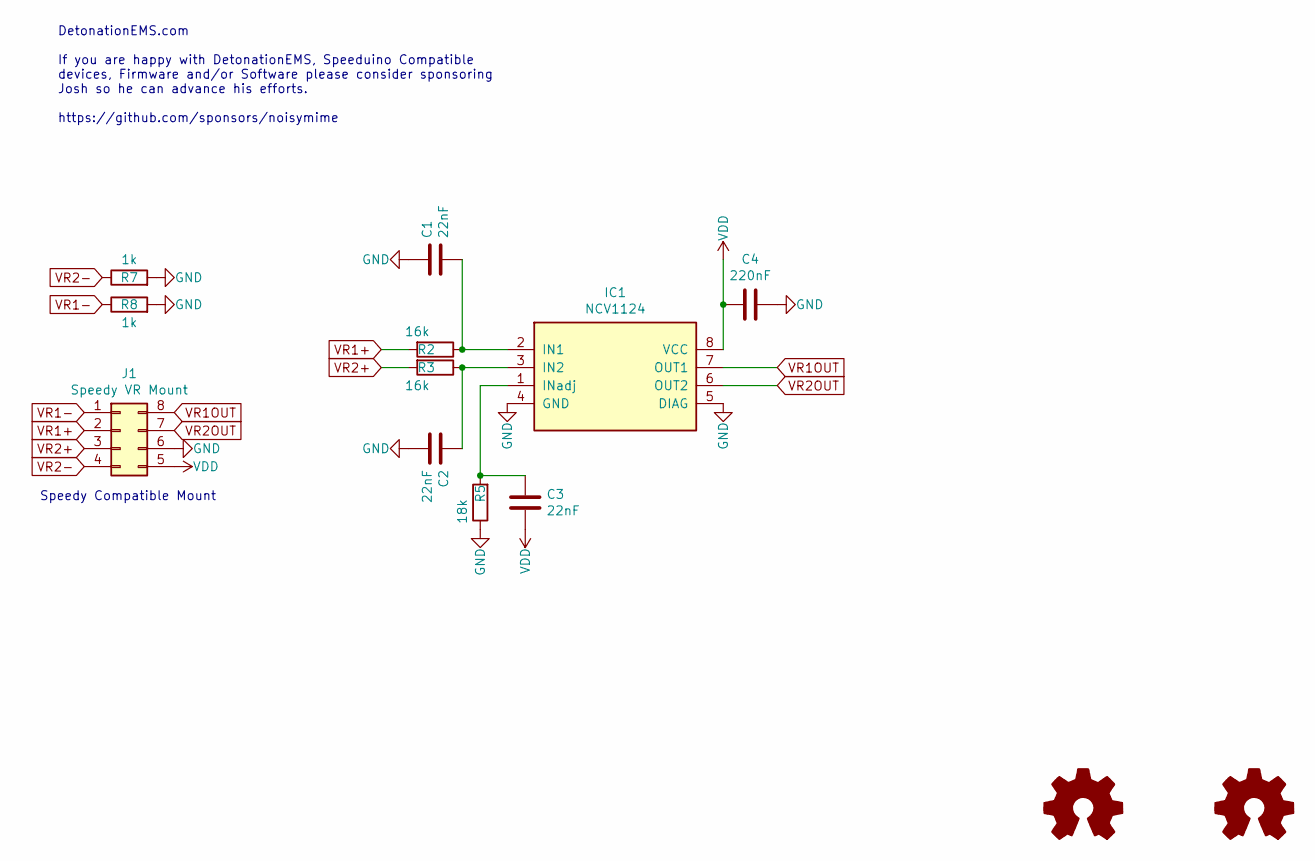
[picture p140: schematic Duel VR.kicad_sch, Duel VRConditioner]

Parts:
C1, C2, C3: 22nF; C_0603_1608Metric; LCSC C21122
C4: 220nF; C_0603_1608Metric; LCSC C21120
G1: Logo_Open_Hardware_Small; SpeeduinoCompatible-14mm
G2: Logo_Open_Hardware_Small; DetonationEMS-17mm
IC1: NCV1124; SO-8_3.9x4.9mm_P1.27mm; LCSC C152274
J1: Speedy VR Mount; DIP-8_W7.62mm_Socket_VRConditioner
R2, R3: 16k; R_0805_2012Metric; LCSC C17490
R5: 18k; R_0603_1608Metric; LCSC C25810
R7, R8: 1k; R_0805_2012Metric; LCSC C17513

Connections:
GND: C1.1, C2.2, C4.2, IC1.4 (GND), IC1.5 (DIAG), J1.6, R5.1, R7.2, R8.2
unnamed: C1.2, IC1.2 (IN1), R2.1
unnamed: C2.1, IC1.3 (IN2), R3.1
unnamed: C3.1, IC1.1 (INadj), R5.2
VDD: C3.2, C4.1, IC1.8 (VCC), J1.5
VR1+: J1.2, R2.2
VR1-: J1.1, R8.1
VR1OUT: IC1.7 (OUT1), J1.8
VR2+: J1.3, R3.2
VR2-: J1.4, R7.1
VR2OUT: IC1.6 (OUT2), J1.7

Notes on the sheet:
DetonationEMS.com If you are happy with DetonationEMS, Speeduino Compatible devices, Firmware and/or Software please consider sponsoring Josh so he can advance his efforts. https://github.com/sponsors/noisymime
Speedy Compatible Mount

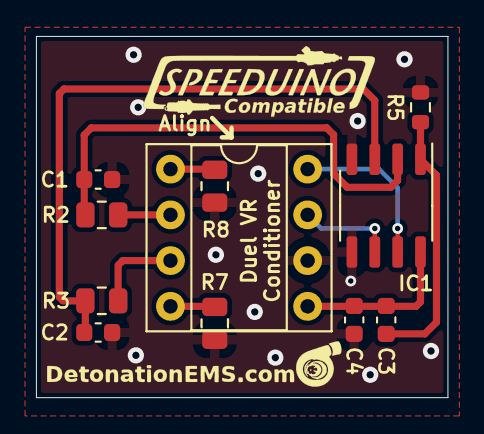
[picture p141: board Modules/VR Conditioner NCV1124/RevA/Duel VR.kicad_pcb from above]

Board: 2 copper layers, 22.9 x 20.1 mm, 13 parts (0 on the bottom side), 11 nets.
