OpenLogicEFI/Hardware/Engine Managment/Closed Deck/Closed Deck x4/RevA3/closed-deck-x4.kicad_pcb

## KiCad design Engine Managment/Closed Deck/Closed Deck x4/RevA3/closed-deck-x4.kicad_pcb (2025-05-19)

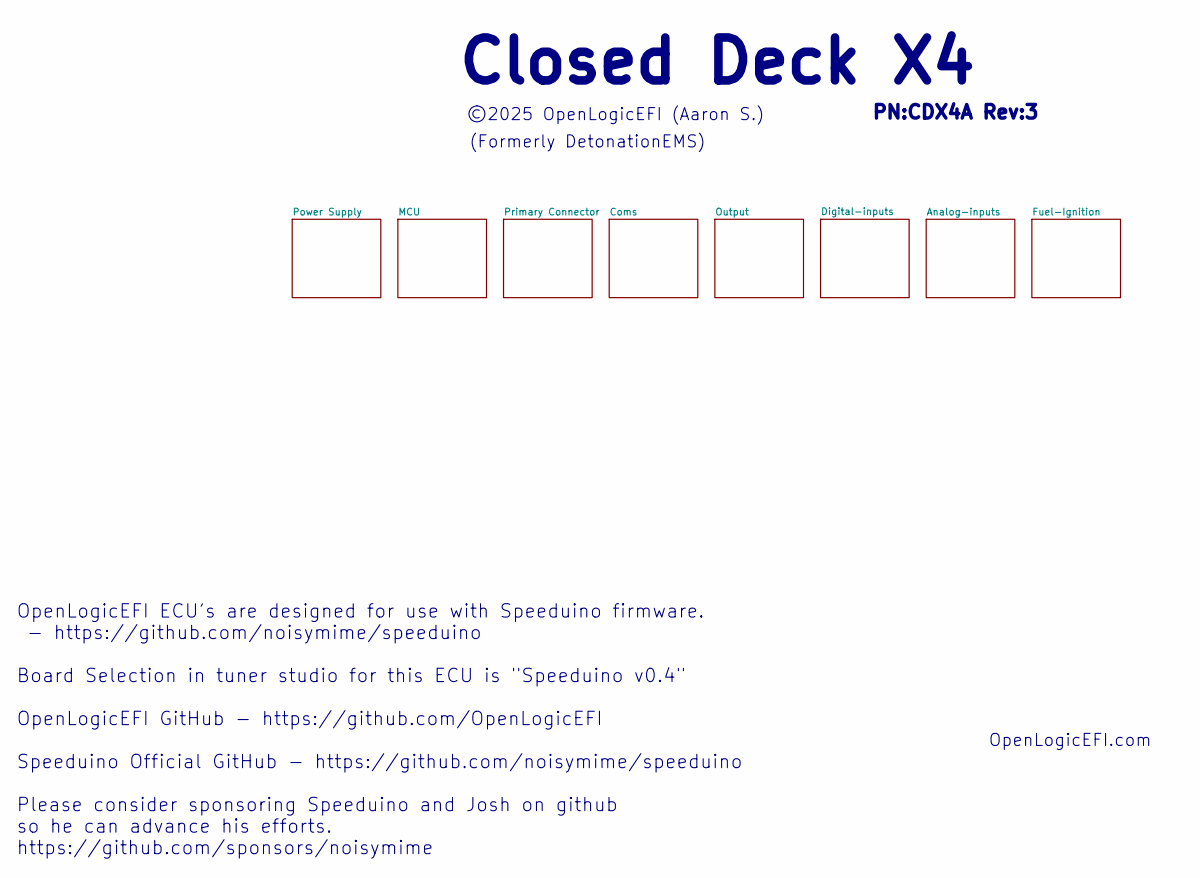
[picture p142: schematic closed-deck-x4.kicad_sch, Closed Deck X4]

Notes on the sheet:
©2025 OpenLogicEFI (Aaron S.)
(Formerly DetonationEMS)
OpenLogicEFI ECU's are designed for use with Speeduino firmware. - https://github.com/noisymime/speeduino Board Selection in tuner studio for this ECU is "Speeduino v0.4" OpenLogicEFI GitHub - https://github.com/OpenLogicEFI Speeduino Official GitHub - https://github.com/noisymime/speeduino Please 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
Closed Deck X4
PN:CDX4A Rev:3
OpenLogicEFI.com

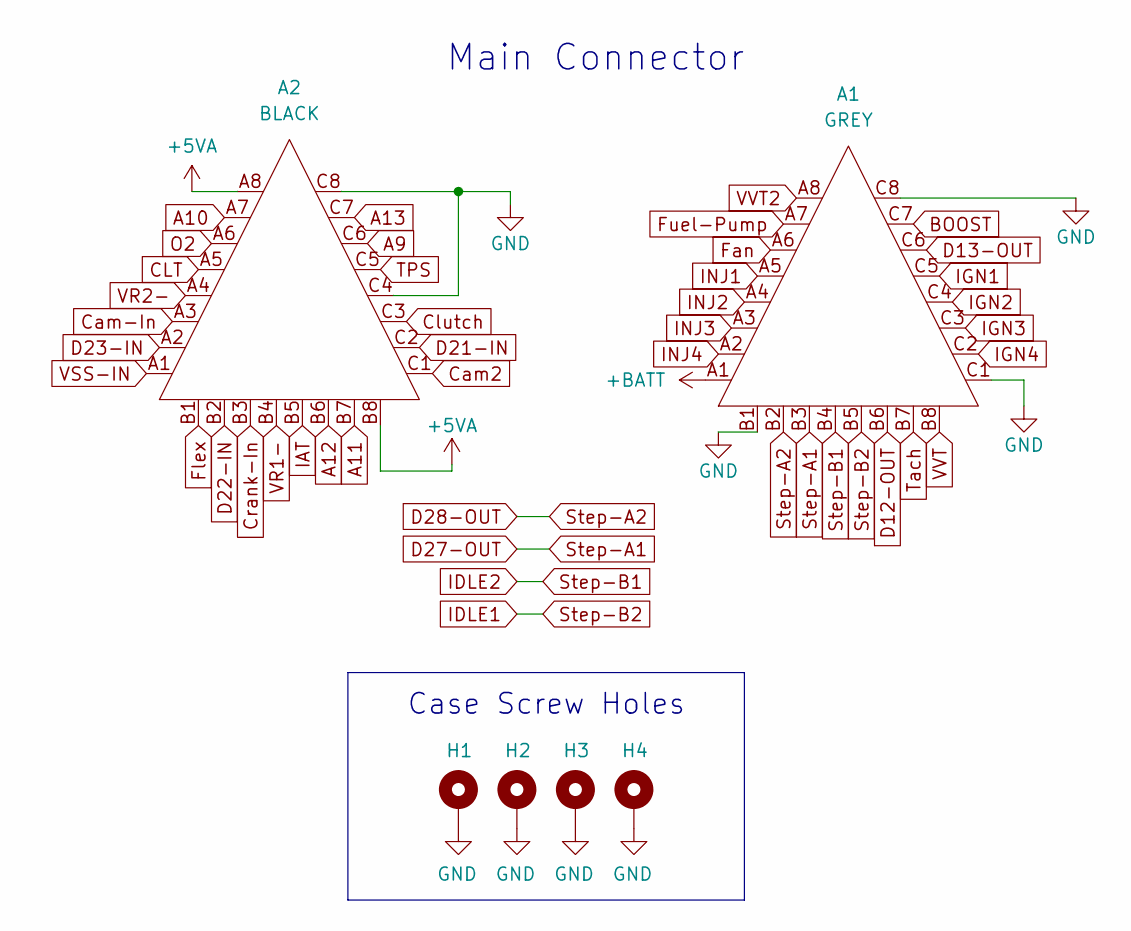
[picture p143: schematic connector.kicad_sch, Closed Deck X4]

Parts:
A1: GREY; Delphi_Sicma_24_Grey
A2: BLACK; Delphi_Sicma_24_Black
H1, H2, H3, H4: MountingHole_Pad; MountingHole_3.5mm_Pad

Connections:
+5V: A2.A8, A2.B8; also elsewhere on the board
+BATT: A1.A1; also elsewhere on the board
A9: A2.C6; also elsewhere on the board
A10: A2.A7; also elsewhere on the board
A11: A2.B7; also elsewhere on the board
A12: A2.B6; also elsewhere on the board
A13: A2.C7; also elsewhere on the board
BOOST: A1.C7; also elsewhere on the board
CLT: A2.A5; also elsewhere on the board
Cam2: A2.C1; also elsewhere on the board
Cam-In: A2.A3; also elsewhere on the board
Clutch: A2.C3; also elsewhere on the board
Crank-In: A2.B3; also elsewhere on the board
D12-OUT: A1.B6; also elsewhere on the board
D13-OUT: A1.C6; also elsewhere on the board
D21-IN: A2.C2; also elsewhere on the board
D22-IN: A2.B2; also elsewhere on the board
D23-IN: A2.A2; also elsewhere on the board
D27-OUT: A1.B3; also elsewhere on the board
D28-OUT: A1.B2; also elsewhere on the board
Fan: A1.A6; also elsewhere on the board
Flex: A2.B1; also elsewhere on the board
Fuel-Pump: A1.A7; also elsewhere on the board
GND: A1.B1, A1.C1, A1.C8, A2.C4, A2.C8, H1.1, H2.1, H3.1, H4.1; also elsewhere on the board
IAT: A2.B5; also elsewhere on the board
IDLE1: A1.B5; also elsewhere on the board
IDLE2: A1.B4; also elsewhere on the board
IGN1: A1.C5; also elsewhere on the board
IGN2: A1.C4; also elsewhere on the board
IGN3: A1.C3; also elsewhere on the board
IGN4: A1.C2; also elsewhere on the board
INJ1: A1.A5; also elsewhere on the board
INJ2: A1.A4; also elsewhere on the board
INJ3: A1.A3; also elsewhere on the board
INJ4: A1.A2; also elsewhere on the board
O2: A2.A6; also elsewhere on the board
TPS: A2.C5; also elsewhere on the board
Tach: A1.B7; also elsewhere on the board
VR1-: A2.B4; also elsewhere on the board
VR2-: A2.A4; also elsewhere on the board
VSS-IN: A2.A1; also elsewhere on the board
VVT: A1.B8; also elsewhere on the board
VVT2: A1.A8; also elsewhere on the board

Notes on the sheet:
Case Screw Holes
Main Connector

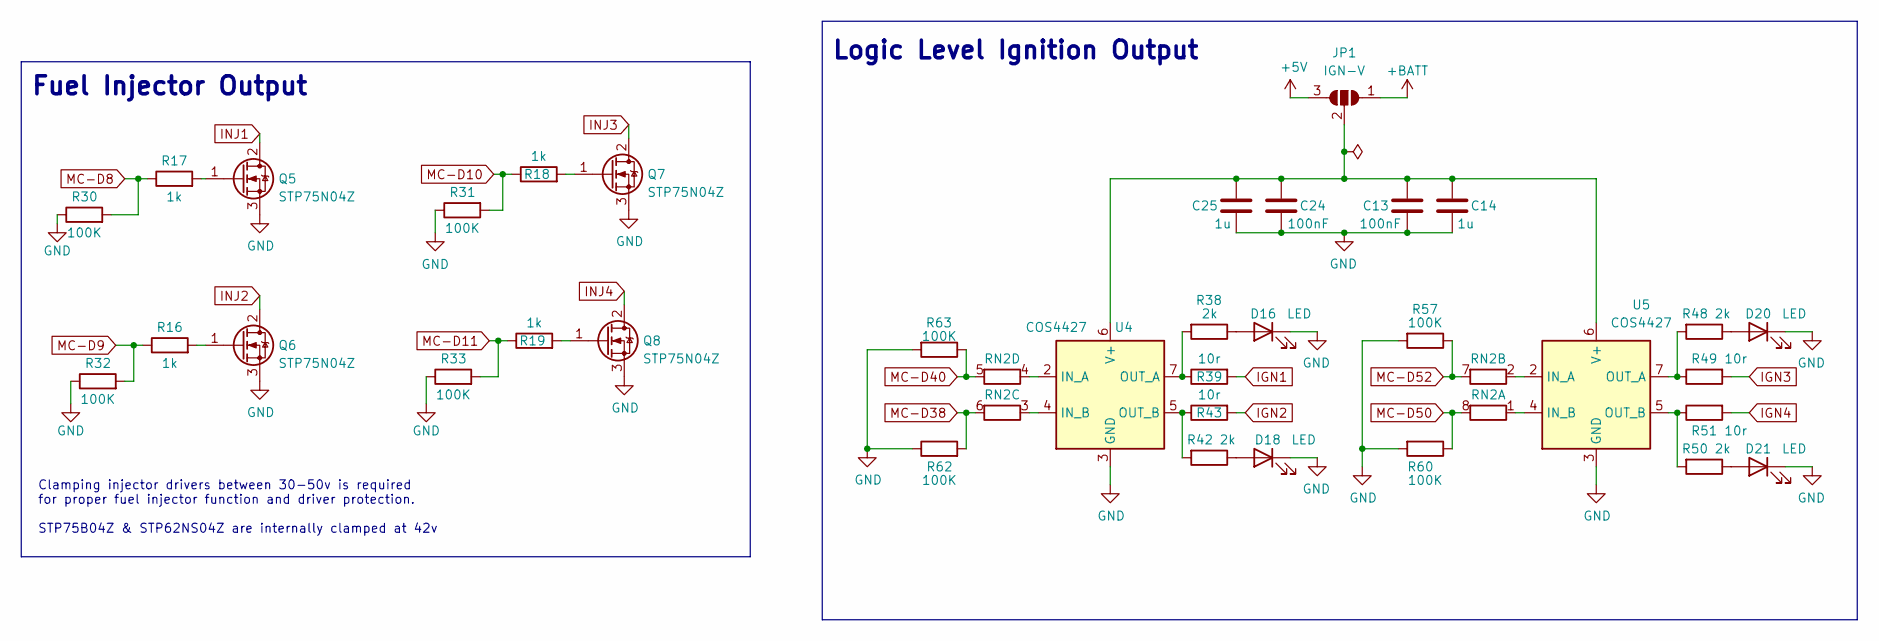
[picture p144: schematic fuel-ignition.kicad_sch, Closed Deck X4]

Parts:
C13, C24: 100nF; C_0402_1005Metric; LCSC C307331
C14, C25: 1u; C_0402_1005Metric; LCSC C52923
D16, D18, D20, D21: LED; LED_0603_1608Metric; Manufacture Part Number KT-0603R; LCSC C2286
JP1: IGN-V; 1x03-Proto
Q5, Q6, Q7, Q8: STP75N04Z; TO-220-3_Vertical
R16, R17, R18, R19: 1k; R_0402_1005Metric; Manufacture Part Number 0402WGF1001TCE; LCSC C11702
R30, R31, R32, R33, R57, R60, R62, R63: 100K; R_0402_1005Metric; Manufacture Part Number 0402WGF1003TCE; LCSC C25741
R38, R42, R48, R50: 2k; R_0402_1005Metric; Manufacture Part Number 0402WGF2001TCE; LCSC C4109
R39, R43, R49, R51: 10r; R_0805_2012Metric; Manufacture Part Number 0805W8F100JT5E; LCSC C17415
RN2: 1k; R_Array_Concave_4x0603; Manufacture Part Number 4D03WGJ0102T5E; LCSC C20197
U4, U5: COS4427; SOIC-8_3.9x4.9mm_P1.27mm; LCSC C2685358

Connections:
+5V: JP1.3 (B); also elsewhere on the board
+BATT: JP1.1 (A); also elsewhere on the board
GND: C13.2, C14.2, C24.2, C25.2, D16.1 (K), D18.1 (K), D20.1 (K), D21.1 (K), Q5.3 (S), Q6.3 (S), Q7.3 (S), Q8.3 (S), R30.1, R31.1, R32.1, R33.1, R57.2, R60.2, R62.1, R63.2, U4.3 (GND), U5.3 (GND); also elsewhere on the board
IGN1: R39.2; also elsewhere on the board
IGN2: R43.2; also elsewhere on the board
IGN3: R49.2; also elsewhere on the board
IGN4: R51.2; also elsewhere on the board
INJ1: Q5.2 (D); also elsewhere on the board
INJ2: Q6.2 (D); also elsewhere on the board
INJ3: Q7.2 (D); also elsewhere on the board
INJ4: Q8.2 (D); also elsewhere on the board
MC-D8: R17.1, R30.2; also elsewhere on the board
MC-D9: R16.1, R32.2; also elsewhere on the board
MC-D10: R18.1, R31.2; also elsewhere on the board
MC-D11: R19.1, R33.2; also elsewhere on the board
MC-D38: R62.2, RN2.6 (R3.2); also elsewhere on the board
MC-D40: R63.1, RN2.5 (R4.2); also elsewhere on the board
MC-D50: R60.1, RN2.8 (R1.2); also elsewhere on the board
MC-D52: R57.1, RN2.7 (R2.2); also elsewhere on the board
unnamed: D16.2 (A), R38.1
unnamed: D18.2 (A), R42.1
unnamed: D20.2 (A), R48.1
unnamed: D21.2 (A), R50.1
unnamed: C13.1, C14.1, C24.1, C25.1, JP1.2 (C), U4.6 (V+), U5.6 (V+)
unnamed: Q5.1 (G), R17.2
unnamed: Q6.1 (G), R16.2
unnamed: Q7.1 (G), R18.2
unnamed: Q8.1 (G), R19.2
unnamed: RN2.1 (R1.1), U5.4 (IN_B)
unnamed: RN2.2 (R2.1), U5.2 (IN_A)
unnamed: RN2.3 (R3.1), U4.4 (IN_B)
unnamed: RN2.4 (R4.1), U4.2 (IN_A)
unnamed: R38.2, R39.1, U4.7 (OUT_A)
unnamed: R42.2, R43.1, U4.5 (OUT_B)
unnamed: R48.2, R49.1, U5.7 (OUT_A)
unnamed: R50.2, R51.1, U5.5 (OUT_B)

Notes on the sheet:
Clamping injector drivers between 30-50v is required for proper fuel injector function and driver protection. STP75B04Z & STP62NS04Z are internally clamped at 42v
Fuel Injector Output
Logic Level Ignition Output

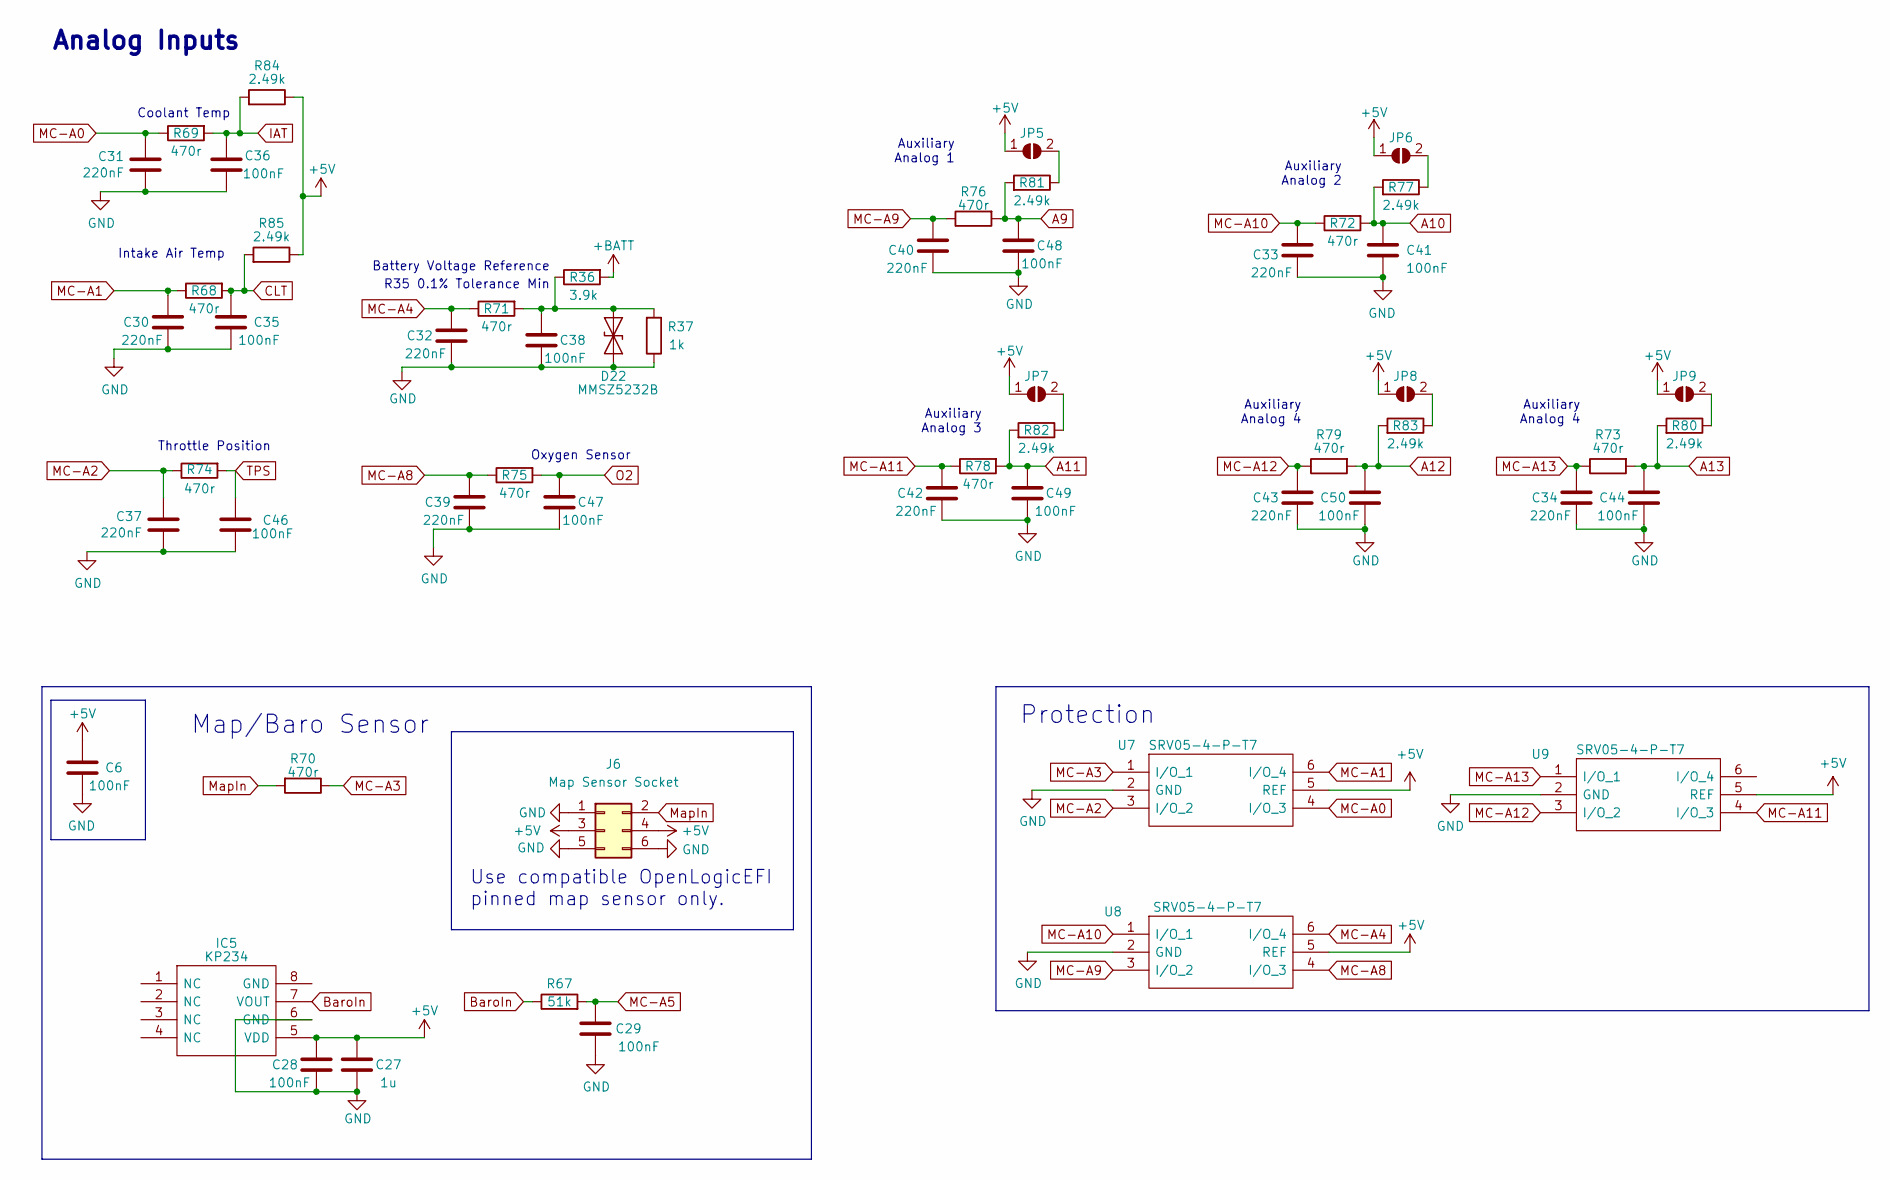
[picture p145: schematic input.kicad_sch, Closed Deck X4]

Parts:
C6, C28, C35, C36, C38, C41, C44, C46, C47, C48, C49, C50: 100nF; C_0402_1005Metric; LCSC C307331
C27: 1u; C_0402_1005Metric; LCSC C52923
C29: 100nF; C_0402_1005Metric; Manufacture Part Number CL05B104KB54PNC; LCSC C307331
C30, C31, C32, C33, C34, C37, C39, C40, C42, C43: 220nF; C_0402_1005Metric; LCSC C16772
D22: MMSZ5232B; D_SOD-123; LCSC C19077423
IC5: KP234; KP234-Handsoldering; Mouser Part Number 726-KP234XTMA1
J6: Map Sensor Socket; PinSocket 2x03
JP5, JP6, JP7, JP8, JP9: SolderJumper_2_Open; SolderJumper-2_P1.3mm_Open_RoundedPad1.0x1.5mm
R36: 3.9k; R_0603_1608Metric; Manufacture Part Number 0603WAF3901T5E; LCSC C23018
R37: 1k; R_0402_1005Metric; Manufacture Part Number 0402WGF1001TCE; LCSC C11702
R67: 51k; R_0402_1005Metric; Manufacture Part Number 0402WGF5102TCE; LCSC C25794
R68, R69, R70, R71, R72, R73, R74, R75, R76, R78, R79: 470r; R_0402_1005Metric; Manufacture Part Number 0402WGF4700TCE; LCSC C25117
R77, R80, R81, R82, R83, R84, R85: 2.49k; R_0402_1005Metric; Manufacture Part Number RC0402FR-072K49L; LCSC C145071
U7, U8, U9: SRV05-4-P-T7; SOT-23-6; LCSC C85364

Connections:
+5V: C6.2, C27.1, C28.1, IC5.5 (VDD), J6.3, J6.4, JP5.1 (A), JP6.1 (A), JP7.1 (A), JP8.1 (A), JP9.1 (A), R84.1, R85.1, U7.5 (REF), U8.5 (REF), U9.5 (REF); also elsewhere on the board
+BATT: R36.2; also elsewhere on the board
A9: C48.1, R76.2, R81.2; also elsewhere on the board
A10: C41.1, R72.2, R77.2; also elsewhere on the board
A11: C49.1, R78.2, R82.2; also elsewhere on the board
A12: C50.1, R79.2, R83.2; also elsewhere on the board
A13: C44.1, R73.2, R80.2; also elsewhere on the board
BaroIn: IC5.7 (VOUT), R67.1
CLT: C35.1, R68.2, R85.2; also elsewhere on the board
GND: C6.1, C27.2, C28.2, C29.2, C30.2, C31.2, C32.2, C33.2, C34.2, C35.2, C36.2, C37.2, C38.2, C39.2, C40.2, C41.2, C42.2, C43.2, C44.2, C46.2, C47.2, C48.2, C49.2, C50.2, D22.2 (A2), IC5.6 (GND), J6.1, J6.5, J6.6, R37.1, U7.2 (GND), U8.2 (GND), U9.2 (GND); also elsewhere on the board
IAT: C36.1, R69.2, R84.2; also elsewhere on the board
MC-A0: C31.1, R69.1, U7.4 (I/O_3); also elsewhere on the board
MC-A1: C30.1, R68.1, U7.6 (I/O_4); also elsewhere on the board
MC-A2: C37.1, R74.1, U7.3 (I/O_2); also elsewhere on the board
MC-A3: R70.1, U7.1 (I/O_1); also elsewhere on the board
MC-A4: C32.1, R71.1, U8.6 (I/O_4); also elsewhere on the board
MC-A5: C29.1, R67.2; also elsewhere on the board
MC-A8: C39.1, R75.1, U8.4 (I/O_3); also elsewhere on the board
MC-A9: C40.1, R76.1, U8.3 (I/O_2); also elsewhere on the board
MC-A10: C33.1, R72.1, U8.1 (I/O_1); also elsewhere on the board
MC-A11: C42.1, R78.1, U9.4 (I/O_3); also elsewhere on the board
MC-A12: C43.1, R79.1, U9.3 (I/O_2); also elsewhere on the board
MC-A13: C34.1, R73.1, U9.1 (I/O_1); also elsewhere on the board
MapIn: J6.2, R70.2
unnamed: C38.1, D22.1 (A1), R36.1, R37.2, R71.2
unnamed: JP5.2 (B), R81.1
unnamed: JP6.2 (B), R77.1
unnamed: JP7.2 (B), R82.1
unnamed: JP8.2 (B), R83.1
unnamed: JP9.2 (B), R80.1
O2: C47.1, R75.2; also elsewhere on the board
TPS: C46.1, R74.2; also elsewhere on the board

Notes on the sheet:
Analog Inputs
Throttle Position
Auxiliary Analog 2
Auxiliary Analog 4
Auxiliary Analog 1
R35 0.1% Tolerance Min
Oxygen Sensor
Map/Baro Sensor
Use compatible OpenLogicEFI pinned map sensor only.
Coolant Temp
Intake Air Temp
Battery Voltage Reference
Protection
Auxiliary Analog 3
