OpenLogicEFI/Hardware/Engine Managment/Closed Deck/Closed Deck x4/RevA3/closed-deck-x4.kicad_pcb

## KiCad design Engine Managment/Closed Deck/Closed Deck x4/RevA3/closed-deck-x4.kicad_pcb (continued)

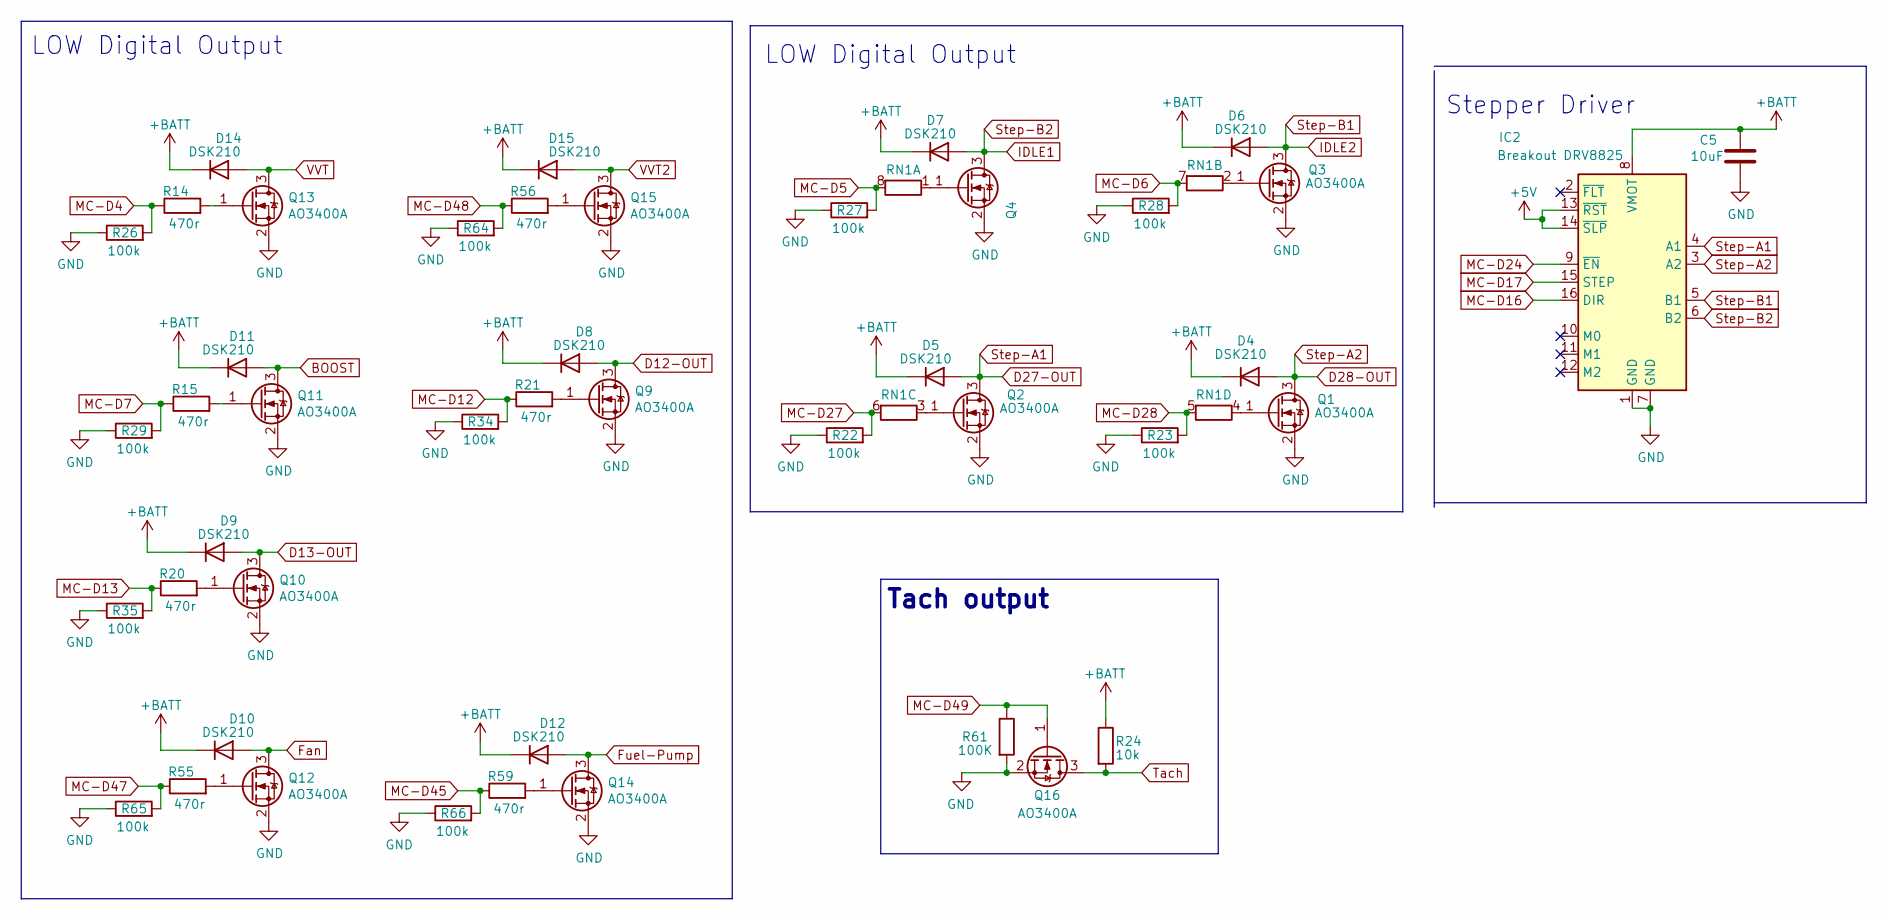
[picture p146: schematic output.kicad_sch, Closed Deck X4]

Parts:
C5: 10uF; C_1206_3216Metric; Manufacture Part Number CL31A106KBHNNNE; LCSC C13585
D4, D5, D6, D7, D8, D9, D10, D11, D12, D14, D15: DSK210; D_SOD-123F; JLC C2128
IC2: Breakout DRV8825; DVR8825-Labeled-Front
Q1, Q2, Q3, Q4, Q9, Q10, Q16: AO3400A; SOT-23; LCSC C20917
Q11, Q12, Q13, Q14, Q15: AO3400A; SOT-23; JLC C20917
R14, R15, R20, R21, R55, R56, R59: 470r; R_0402_1005Metric; Manufacture Part Number 0402WGF4700TCE; LCSC C25117
R22, R23, R26, R27, R28, R29, R34, R35, R64, R65, R66: 100k; R_0402_1005Metric; Manufacture Part Number 0402WGF1003TCE; LCSC C25741
R24: 10k; R_0402_1005Metric; Manufacture Part Number 0402WGF1002TCE; LCSC C25744
R61: 100K; R_0402_1005Metric; Manufacture Part Number 0402WGF1003TCE; LCSC C25741
RN1: 1k; R_Array_Concave_4x0603; Manufacture Part Number 4D03WGJ0102T5E; LCSC C20197

Connections:
+5V: IC2.13 (~RST), IC2.14 (~SLP); also elsewhere on the board
+BATT: C5.1, D4.1 (K), D5.1 (K), D6.1 (K), D7.1 (K), D8.1 (K), D9.1 (K), D10.1 (K), D11.1 (K), D12.1 (K), D14.1 (K), D15.1 (K), IC2.8 (VMOT), R24.1; also elsewhere on the board
BOOST: D11.2 (A), Q11.3 (D); also elsewhere on the board
D12-OUT: D8.2 (A), Q9.3 (D); also elsewhere on the board
D13-OUT: D9.2 (A), Q10.3 (D); also elsewhere on the board
D27-OUT: D5.2 (A), IC2.4 (A1), Q2.3 (D); also elsewhere on the board
D28-OUT: D4.2 (A), IC2.3 (A2), Q1.3 (D); also elsewhere on the board
Fan: D10.2 (A), Q12.3 (D); also elsewhere on the board
Fuel-Pump: D12.2 (A), Q14.3 (D); also elsewhere on the board
GND: C5.2, IC2.1 (GND), IC2.7 (GND), Q1.2 (S), Q2.2 (S), Q3.2 (S), Q4.2 (S), Q9.2 (S), Q10.2 (S), Q11.2 (S), Q12.2 (S), Q13.2 (S), Q14.2 (S), Q15.2 (S), Q16.2 (S), R22.1, R23.1, R26.1, R27.1, R28.1, R29.1, R34.1, R35.1, R61.2, R64.1, R65.1, R66.1; also elsewhere on the board
IDLE1: D7.2 (A), IC2.6 (B2), Q4.3 (D); also elsewhere on the board
IDLE2: D6.2 (A), IC2.5 (B1), Q3.3 (D); also elsewhere on the board
MC-D4: R14.1, R26.2; also elsewhere on the board
MC-D5: R27.2, RN1.8 (R1.2); also elsewhere on the board
MC-D6: R28.2, RN1.7 (R2.2); also elsewhere on the board
MC-D7: R15.1, R29.2; also elsewhere on the board
MC-D12: R21.1, R34.2; also elsewhere on the board
MC-D13: R20.1, R35.2; also elsewhere on the board
MC-D16: IC2.16 (DIR); also elsewhere on the board
MC-D17: IC2.15 (STEP); also elsewhere on the board
MC-D24: IC2.9 (~EN); also elsewhere on the board
MC-D27: R22.2, RN1.6 (R3.2); also elsewhere on the board
MC-D28: R23.2, RN1.5 (R4.2); also elsewhere on the board
MC-D45: R59.1, R66.2; also elsewhere on the board
MC-D47: R55.1, R65.2; also elsewhere on the board
MC-D48: R56.1, R64.2; also elsewhere on the board
MC-D49: Q16.1 (G), R61.1; also elsewhere on the board
unnamed: Q1.1 (G), RN1.4 (R4.1)
unnamed: Q2.1 (G), RN1.3 (R3.1)
unnamed: Q3.1 (G), RN1.2 (R2.1)
unnamed: Q4.1 (G), RN1.1 (R1.1)
unnamed: Q9.1 (G), R21.2
unnamed: Q10.1 (G), R20.2
unnamed: Q11.1 (G), R15.2
unnamed: Q12.1 (G), R55.2
unnamed: Q13.1 (G), R14.2
unnamed: Q14.1 (G), R59.2
unnamed: Q15.1 (G), R56.2
Tach: Q16.3 (D), R24.2; also elsewhere on the board
VVT: D14.2 (A), Q13.3 (D); also elsewhere on the board
VVT2: D15.2 (A), Q15.3 (D); also elsewhere on the board

Notes on the sheet:
Tach output
LOW Digital Output
Stepper Driver

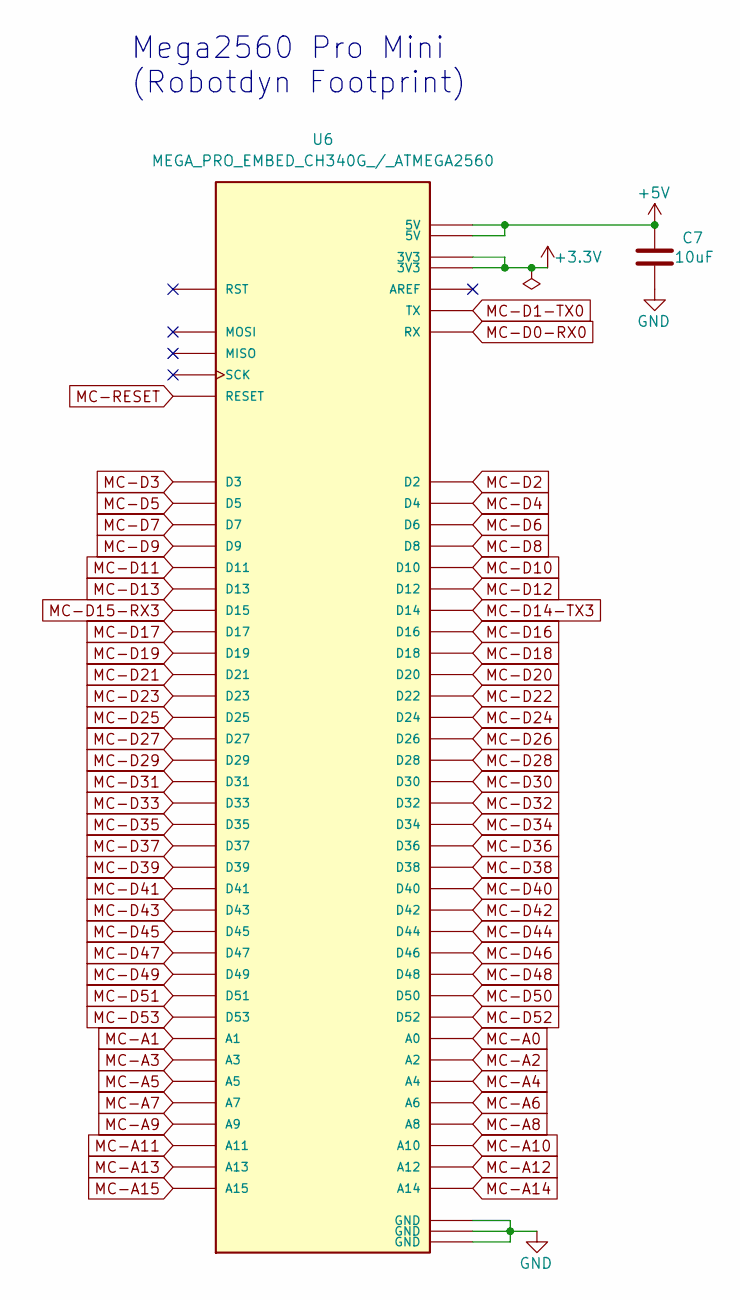
[picture p147: schematic mcu.kicad_sch, Closed Deck X4]

Parts:
C7: 10uF; C_1206_3216Metric; Manufacture Part Number CL31A106KBHNNNE; LCSC C13585
U6: MEGA_PRO_EMBED_CH340G_/_ATMEGA2560; Arduino_Mega_Mini_2560_SmallCrtYd_NoVin

Connections:
+3.3V: U6.3V3_1 (3V3), U6.3V3_2 (3V3)
+5V: C7.1, U6.5V_1 (5V), U6.5V_2 (5V), U6.5V_3 (5V); also elsewhere on the board
Flex: U6.D2; also elsewhere on the board
GND: C7.2, U6.GND_1 (GND), U6.GND_2 (GND), U6.GND_3 (GND); also elsewhere on the board
MC-A0: U6.A0; also elsewhere on the board
MC-A1: U6.A1; also elsewhere on the board
MC-A2: U6.A2; also elsewhere on the board
MC-A3: U6.A3; also elsewhere on the board
MC-A4: U6.A4; also elsewhere on the board
MC-A5: U6.A5; also elsewhere on the board
MC-A6: U6.A6
MC-A7: U6.A7
MC-A8: U6.A8; also elsewhere on the board
MC-A9: U6.A9; also elsewhere on the board
MC-A10: U6.A10; also elsewhere on the board
MC-A11: U6.A11; also elsewhere on the board
MC-A12: U6.A12; also elsewhere on the board
MC-A13: U6.A13; also elsewhere on the board
MC-A14: U6.A14
MC-A15: U6.A15
MC-D0-RX0: U6.RX; also elsewhere on the board
MC-D1-TX0: U6.TX; also elsewhere on the board
MC-D3: U6.D3; also elsewhere on the board
MC-D4: U6.D4; also elsewhere on the board
MC-D5: U6.D5; also elsewhere on the board
MC-D6: U6.D6; also elsewhere on the board
MC-D7: U6.D7; also elsewhere on the board
MC-D8: U6.D8; also elsewhere on the board
MC-D9: U6.D9; also elsewhere on the board
MC-D10: U6.D10; also elsewhere on the board
MC-D11: U6.D11; also elsewhere on the board
MC-D12: U6.D12; also elsewhere on the board
MC-D13: U6.D13; also elsewhere on the board
MC-D14-TX3: U6.D14; also elsewhere on the board
MC-D15-RX3: U6.D15; also elsewhere on the board
MC-D16: U6.D16; also elsewhere on the board
MC-D17: U6.D17; also elsewhere on the board
MC-D18: U6.D18; also elsewhere on the board
MC-D19: U6.D19; also elsewhere on the board
MC-D20: U6.D20; also elsewhere on the board
MC-D21: U6.D21; also elsewhere on the board
MC-D22: U6.D22; also elsewhere on the board
MC-D23: U6.D23; also elsewhere on the board
MC-D24: U6.D24; also elsewhere on the board
MC-D25: U6.D25
MC-D26: U6.D26
MC-D27: U6.D27; also elsewhere on the board
MC-D28: U6.D28; also elsewhere on the board
MC-D29: U6.D29
MC-D30: U6.D30
MC-D31: U6.D31
MC-D32: U6.D32
MC-D33: U6.D33
MC-D34: U6.D34
MC-D35: U6.D35
MC-D36: U6.D36
MC-D37: U6.D37
MC-D38: U6.D38; also elsewhere on the board
MC-D39: U6.D39
MC-D40: U6.D40; also elsewhere on the board
MC-D41: U6.D41
MC-D42: U6.D42
MC-D43: U6.D43
MC-D44: U6.D44
MC-D45: U6.D45; also elsewhere on the board
MC-D46: U6.D46
MC-D47: U6.D47; also elsewhere on the board
MC-D48: U6.D48; also elsewhere on the board
MC-D49: U6.D49; also elsewhere on the board
MC-D50: U6.D50; also elsewhere on the board
MC-D51: U6.D51; also elsewhere on the board
MC-D52: U6.D52; also elsewhere on the board
MC-D53: U6.D53
MC-RESET: U6.RESET; also elsewhere on the board

Notes on the sheet:
Mega2560 Pro Mini (Robotdyn Footprint)

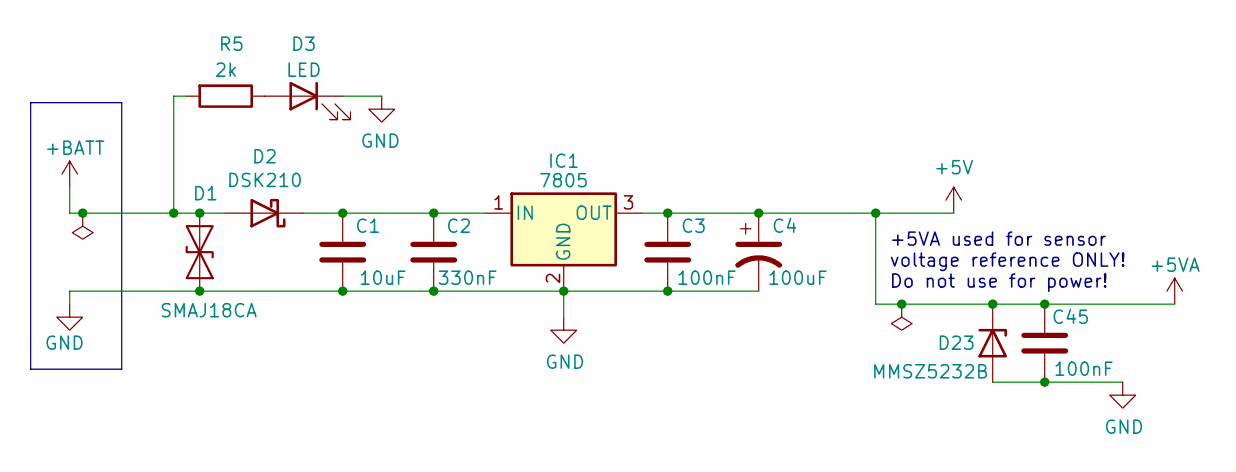
[picture p148: schematic powersupply.kicad_sch, Closed Deck X4]

Parts:
C1: 10uF; C_1206_3216Metric; Manufacture Part Number CL31A106KBHNNNE; LCSC C13585
C2: 330nF; C_0805_2012Metric; Manufacture Part Number 0805B334K500NT; LCSC C1740
C3, C45: 100nF; C_0805_2012Metric; Manufacture Part Number CC0805KRX7R9BB104; LCSC C49678
C4: 100uF; CP_EIA-3528-15_AVX-H; Manufacture Part Number TAJB107K006RNJ; LCSC C16133
D1: SMAJ18CA; D_SMA; Manufacture Part Number SMAJ18CA; LCSC C19077539
D2: DSK210; D_SOD-123F; Manufacture Part Number SS34; LCSC C7502713
D3: LED; LED_0603_1608Metric; Manufacture Part Number KT-0603R; LCSC C2286
D23: MMSZ5232B; D_SOD-123; LCSC C19077423
IC1: 7805; TO-220-SmallHeatSink; Manufacture Part Number L78M05ABDT-TR; LCSC C58069
R5: 2k; R_0402_1005Metric; Manufacture Part Number 0402WGF2001TCE; LCSC C4109

Connections:
+5V: C3.1, C4.1, C45.1, D23.1 (K), IC1.3 (OUT); also elsewhere on the board
+BATT: D1.2 (A2), D2.2 (A), R5.2; also elsewhere on the board
GND: C1.2, C2.2, C3.2, C4.2, C45.2, D1.1 (A1), D3.1 (K), D23.2 (A), IC1.2 (GND); also elsewhere on the board
unnamed: C1.1, C2.1, D2.1 (K), IC1.1 (IN)
unnamed: D3.2 (A), R5.1

Notes on the sheet:
+5VA used for sensor voltage reference ONLY! Do not use for power!

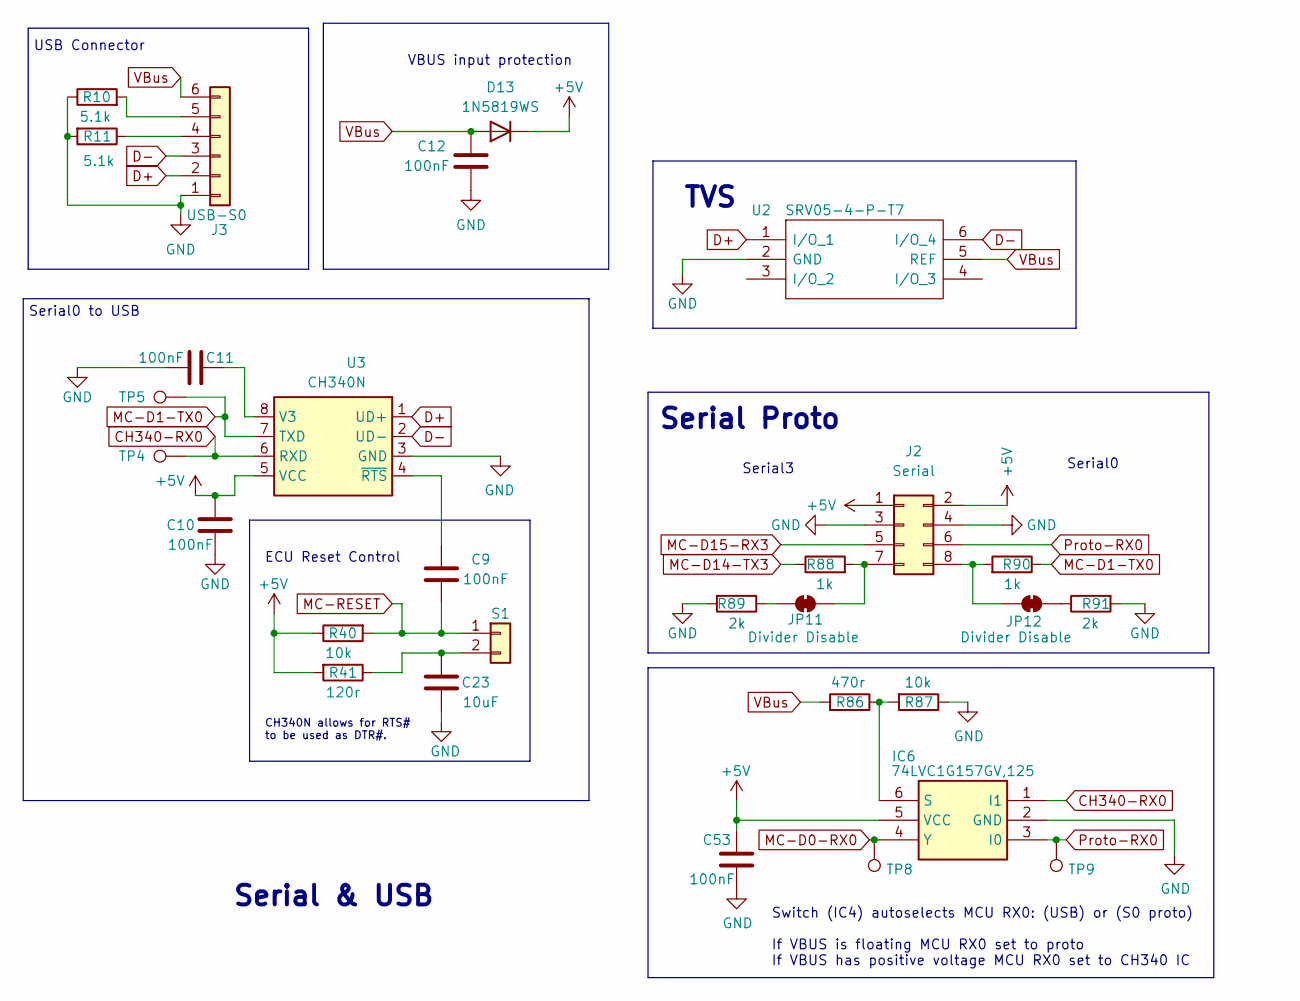
[picture p149: schematic usb.kicad_sch, Closed Deck X4]

Parts:
C9, C10, C11, C12, C53: 100nF; C_0402_1005Metric; LCSC C307331
C23: 10uF; C_0603_1608Metric; Manufacture Part Number CL10A106KP8NNNC; LCSC C19702
D13: 1N5819WS; D_SOD-323; Manufacture Part Number 1N5819WS; LCSC C191023
IC6: 74LVC1G157GV,125; TSOT-23-6; Mouser Part Number 771-74LVC1G157GW-G
J2: Serial; 2x04-2.54mm-Serial-withSilk
J3: USB-S0; JST_PH_B6B-PH-K_1x06_P2.00mm_Vertical
JP11, JP12: Divider Disable; SolderJumper-2_P1.3mm_Bridged_RoundedPad1.0x1.5mm
R10, R11: 5.1k; R_0402_1005Metric; Manufacture Part Number 0402WGF5101TCE; LCSC C25905
R40, R87: 10k; R_0402_1005Metric; Manufacture Part Number 0402WGF1002TCE; LCSC C25744
R41: 120r; R_0603_1608Metric; Manufacture Part Number 0402WGF4700TCE; LCSC C22787
R86: 470r; R_0402_1005Metric; Manufacture Part Number 0402WGF4700TCE; LCSC C25117
R88, R90: 1k; R_0402_1005Metric; Manufacture Part Number 0402WGF1001TCE; LCSC C11702
R89, R91: 2k; R_0402_1005Metric; Manufacture Part Number 0402WGF2001TCE; LCSC C4109
S1: Reset Control; PinHeader_1x02_P2.54mm_Vertical
TP4, TP5, TP8, TP9: TestPoint; TestPoint_THT_D0.6mm_Drill0.3mm
U2: SRV05-4-P-T7; SOT-23-6; LCSC C85364
U3: CH340N; SOIC-8_3.9x4.9mm_P1.27mm

Connections:
+5V: C10.1, C53.2, D13.1 (K), IC6.5 (VCC), J2.1, J2.2, R40.1, R41.2, U3.5 (VCC); also elsewhere on the board
CH340-RX0: IC6.1 (I1), TP4.1, U3.6 (RXD)
D+: J3.2, U2.1 (I/O_1), U3.1 (UD+)
D-: J3.3, U2.6 (I/O_4), U3.2 (UD-)
GND: C10.2, C11.2, C12.2, C23.2, C53.1, IC6.2 (GND), J2.3, J2.4, J3.1, R10.1, R11.2, R87.1, R89.2, R91.2, U2.2 (GND), U3.3 (GND); also elsewhere on the board
MC-D0-RX0: IC6.4 (Y), TP8.1; also elsewhere on the board
MC-D1-TX0: R90.1, TP5.1, U3.7 (TXD); also elsewhere on the board
MC-D14-TX3: R88.1; also elsewhere on the board
MC-D15-RX3: J2.5; also elsewhere on the board
MC-RESET: C9.2, R40.2, S1.1; also elsewhere on the board
unnamed: IC6.6 (S), R86.1, R87.2
unnamed: J2.7, JP11.2 (B), R88.2
unnamed: J2.8, JP12.1 (A), R90.2
unnamed: J3.4, R11.1
unnamed: J3.5, R10.2
unnamed: JP11.1 (A), R89.1
unnamed: JP12.2 (B), R91.1
unnamed: C23.1, R41.1, S1.2
unnamed: C11.1, U3.8 (V3)
unnamed: C9.1, U3.4 (~RTS)
Proto-RX0: IC6.3 (I0), J2.6, TP9.1
VBus: C12.1, D13.2 (A), J3.6, R86.2, U2.5 (REF)

Notes on the sheet:
Serial0
TVS
CH340N allows for RTS# to be used as DTR#.
VBUS input protection
Switch (IC4) autoselects MCU RX0: (USB) or (S0 proto) If VBUS is floating MCU RX0 set to proto If VBUS has positive voltage MCU RX0 set to CH340 IC
Serial & USB
ECU Reset Control
Serial3
Serial0 to USB
USB Connector
Serial Proto

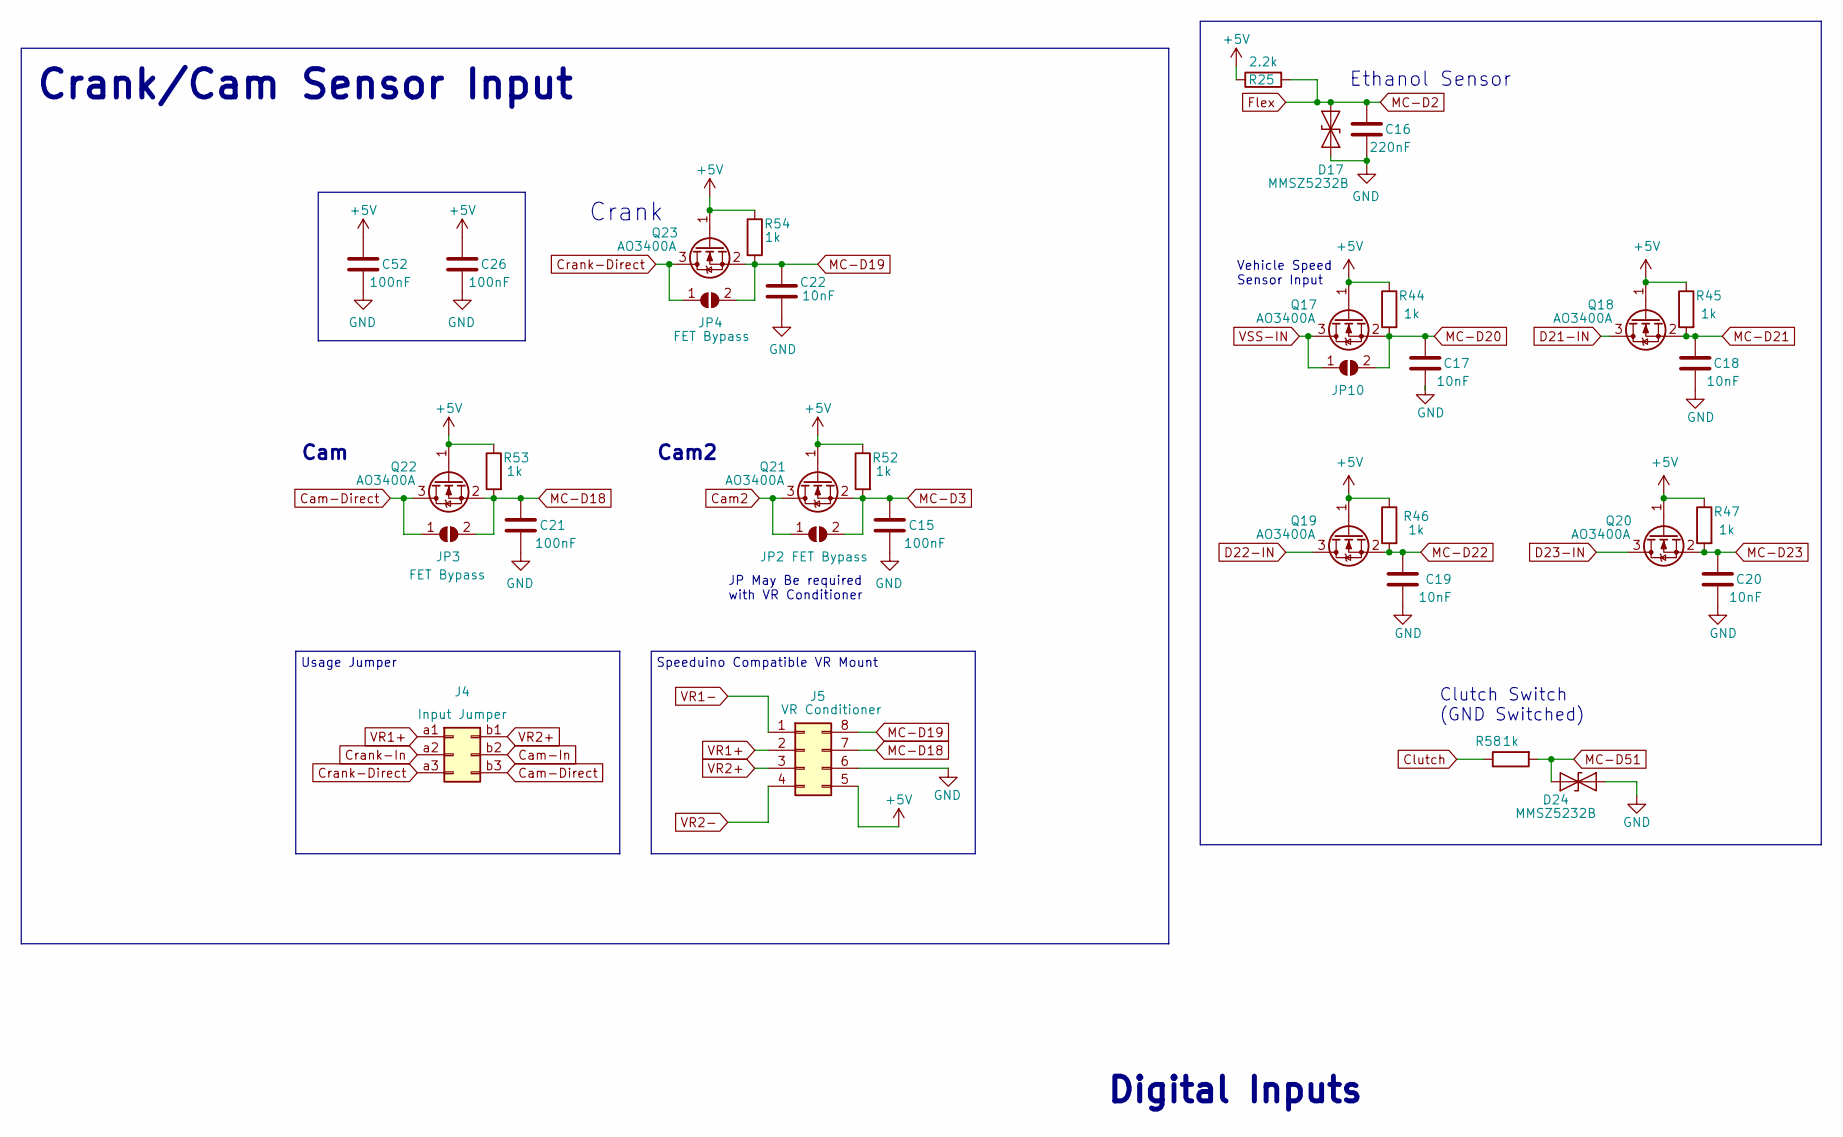
[picture p150: schematic digital-inputs.kicad_sch, Closed Deck X4]

Parts:
C15, C21, C26, C52: 100nF; C_0402_1005Metric; LCSC C307331
C16: 220nF; C_0402_1005Metric; LCSC C16772
C17, C18, C19, C20, C22: 10nF; C_0402_1005Metric; LCSC C15195
D17, D24: MMSZ5232B; D_SOD-123; LCSC C19077423
J4: Input Jumper; PinHeader2x03_Jumper
J5: VR Conditioner; Socket_VRConditioner_Corrected
JP2, JP3, JP4, JP10: FET Bypass; SolderJumper-2_P1.3mm_Open_RoundedPad1.0x1.5mm
Q17, Q18, Q19, Q20, Q21, Q22, Q23: AO3400A; SOT-23
R25: 2.2k; R_0402_1005Metric; Manufacture Part Number 0402WGF2201TCE; LCSC C25879
R44, R45, R46, R47, R52, R53, R54, R58: 1k; R_0402_1005Metric; Manufacture Part Number 0402WGF1001TCE; LCSC C11702

Connections:
+5V: C26.2, C52.2, J5.5, Q17.1 (G), Q18.1 (G), Q19.1 (G), Q20.1 (G), Q21.1 (G), Q22.1 (G), Q23.1 (G), R25.1, R44.1, R45.1, R46.1, R47.1, R52.1, R53.1, R54.1; also elsewhere on the board
Cam2: JP2.1 (A), Q21.3 (D); also elsewhere on the board
Cam-Direct: J4.b3, JP3.1 (A), Q22.3 (D)
Cam-In: J4.b2; also elsewhere on the board
Clutch: R58.1; also elsewhere on the board
Crank-Direct: J4.a3, JP4.1 (A), Q23.3 (D)
Crank-In: J4.a2; also elsewhere on the board
D21-IN: Q18.3 (D); also elsewhere on the board
D22-IN: Q19.3 (D); also elsewhere on the board
D23-IN: Q20.3 (D); also elsewhere on the board
Flex: C16.1, D17.1 (A1), R25.2; also elsewhere on the board
GND: C15.1, C16.2, C17.2, C18.2, C19.2, C20.2, C21.1, C22.1, C26.1, C52.1, D17.2 (A2), D24.1 (A1), J5.6; also elsewhere on the board
MC-D3: C15.2, JP2.2 (B), Q21.2 (S), R52.2; also elsewhere on the board
MC-D18: C21.2, J5.7, JP3.2 (B), Q22.2 (S), R53.2; also elsewhere on the board
MC-D19: C22.2, J5.8, JP4.2 (B), Q23.2 (S), R54.2; also elsewhere on the board
MC-D20: C17.1, JP10.2 (B), Q17.2 (S), R44.2; also elsewhere on the board
MC-D21: C18.1, Q18.2 (S), R45.2; also elsewhere on the board
MC-D22: C19.1, Q19.2 (S), R46.2; also elsewhere on the board
MC-D23: C20.1, Q20.2 (S), R47.2; also elsewhere on the board
MC-D51: D24.2 (A2), R58.2; also elsewhere on the board
VR1+: J4.a1, J5.2
VR1-: J5.1; also elsewhere on the board
VR2+: J4.b1, J5.3
VR2-: J5.4; also elsewhere on the board
VSS-IN: JP10.1 (A), Q17.3 (D); also elsewhere on the board

Notes on the sheet:
Vehicle Speed Sensor Input
JP May Be required with VR Conditioner
Cam
Speeduino Compatible VR Mount
Clutch Switch (GND Switched)
Ethanol Sensor
Usage Jumper
Crank
Crank/Cam Sensor Input
Cam2
Digital Inputs

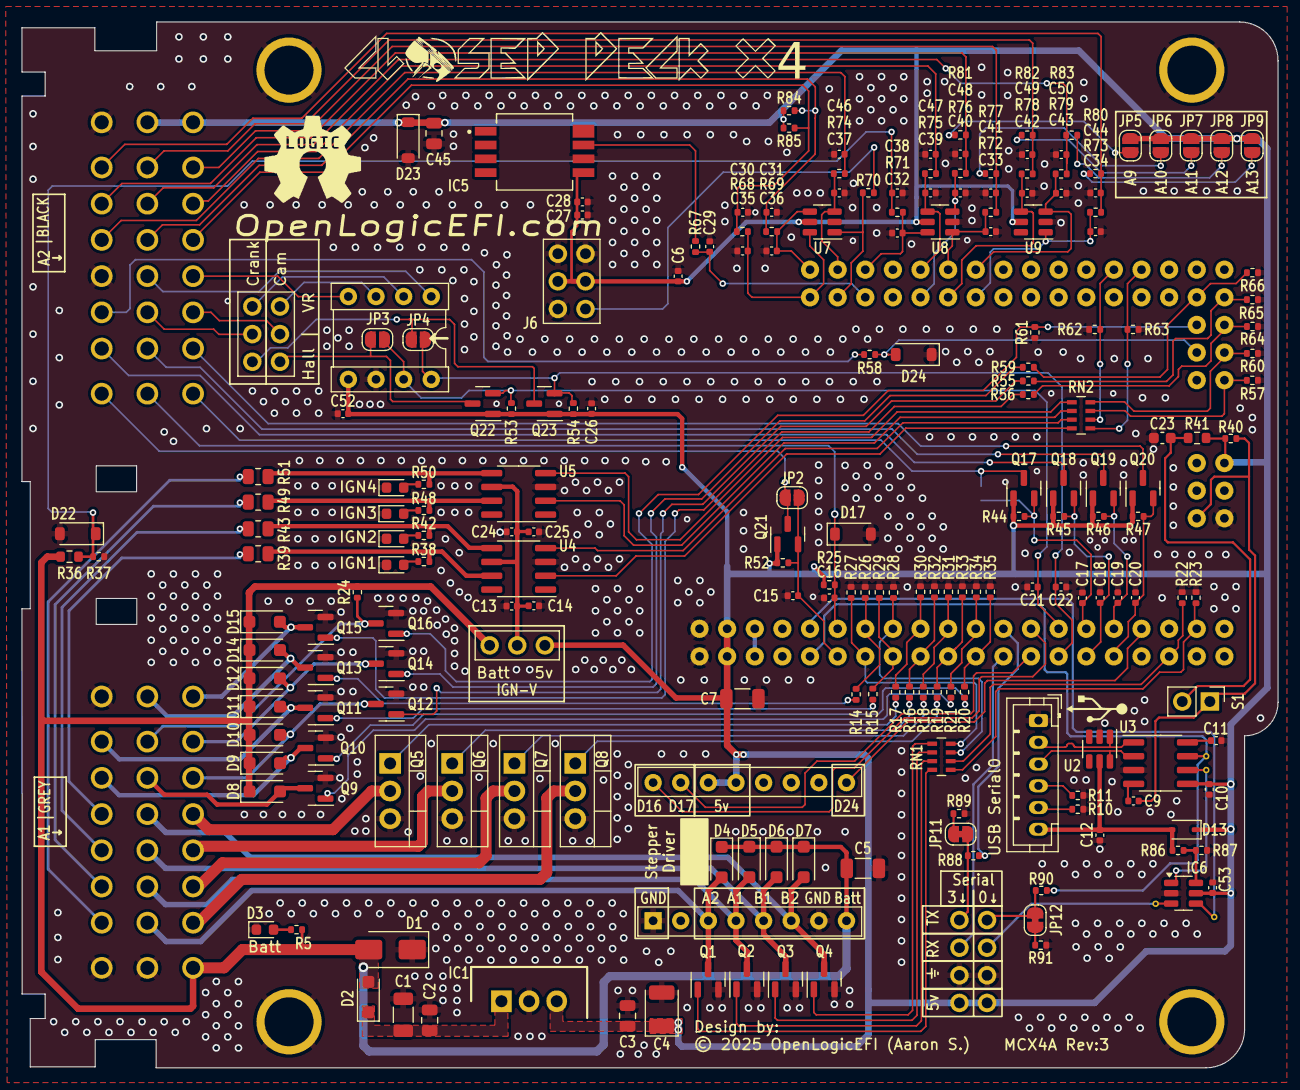
[picture p151: board Engine Managment/Closed Deck/Closed Deck x4/RevA3/closed-deck-x4.kica… from above]

Board: 2 copper layers, 115.5 x 96.2 mm, 220 parts (1 on the bottom side), 149 nets.
