OpenLogicEFI/Hardware/Modules/MAP Sensor Modules/PMAP-L/map-pinned.kicad_pcb

## KiCad design Modules/MAP Sensor Modules/PMAP-L/map-pinned.kicad_pcb (2023-06-15, an earlier design)

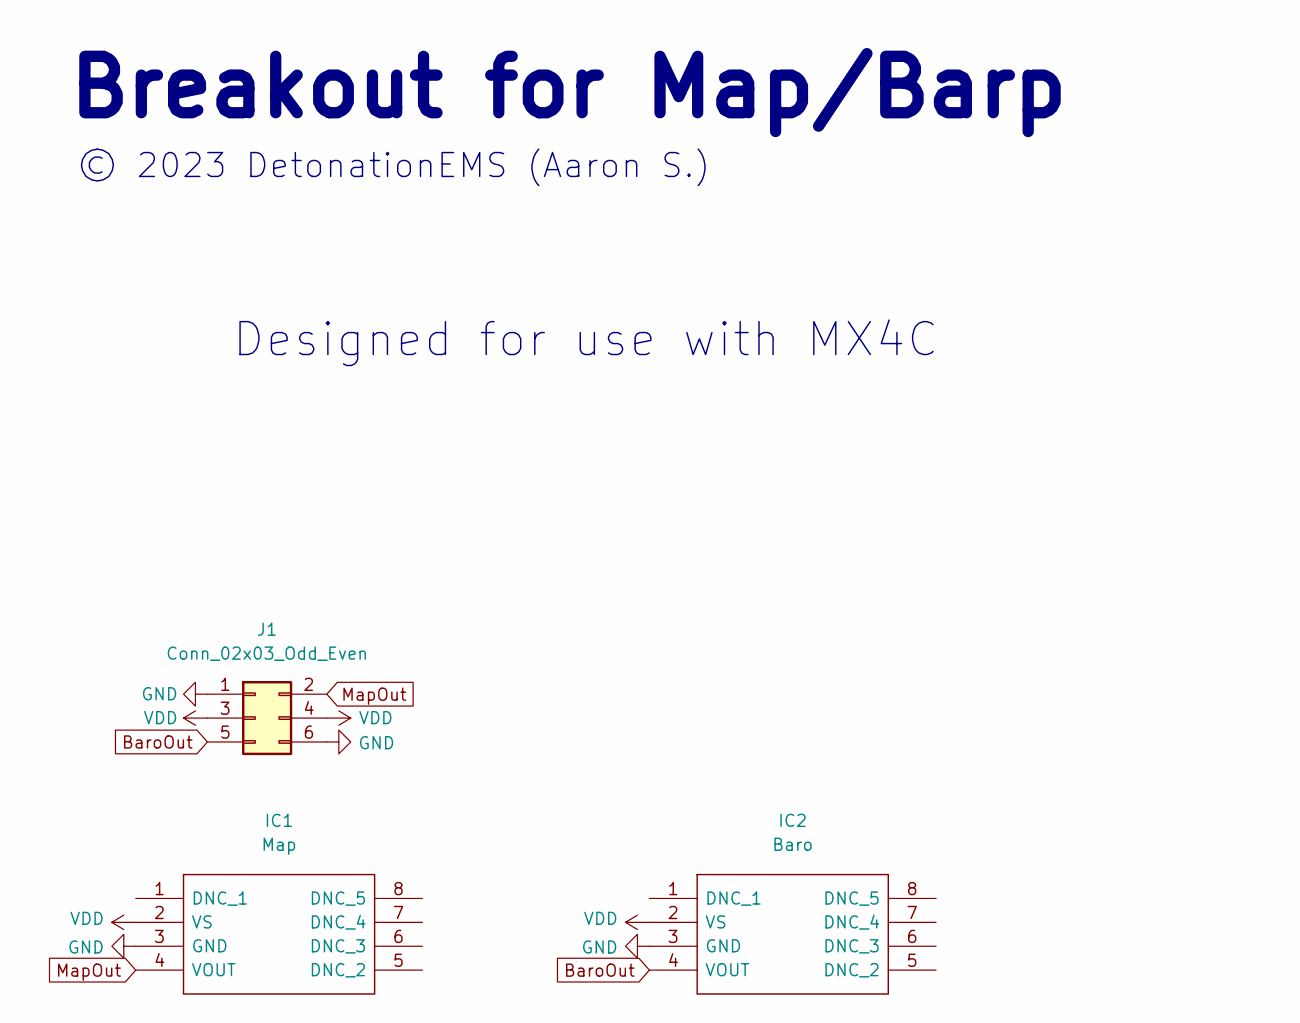
[picture p152: schematic map-pinned.kicad_sch]

Parts:
IC1: Map; MPXH6250
IC2: Baro; MPXH6250
J1: Conn_02x03_Odd_Even; PinHeader_2x03_P2.54mm_Horizontal

Connections:
BaroOut: IC2.4 (VOUT), J1.5
GND: IC1.3 (GND), IC2.3 (GND), J1.1, J1.6
MapOut: IC1.4 (VOUT), J1.2
VDD: IC1.2 (VS), IC2.2 (VS), J1.3, J1.4

Notes on the sheet:
© 2023 DetonationEMS (Aaron S.)
Breakout for Map/Barp
Designed for use with MX4C

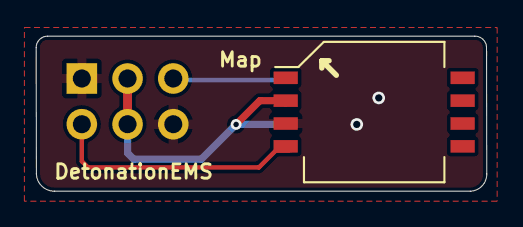
[picture p153: board Modules/MAP Sensor Modules/PMAP-L/map-pinned.kicad_pcb from above]

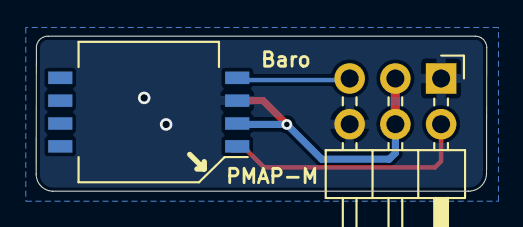
[picture p154: board Modules/MAP Sensor Modules/PMAP-L/map-pinned.kicad_pcb from below]

Board: 2 copper layers, 25.0 x 8.6 mm, 3 parts (2 on the bottom side), 4 nets.
