OpenLogicEFI/Hardware/Engine Managment/Pre-Ignition/Pre-Ignition x4/MX4A/Pre_Ignition.kicad_pcb

## KiCad design Engine Managment/Pre-Ignition/Pre-Ignition x4/MX4A/Pre_Ignition.kicad_pcb (2021-08-11)

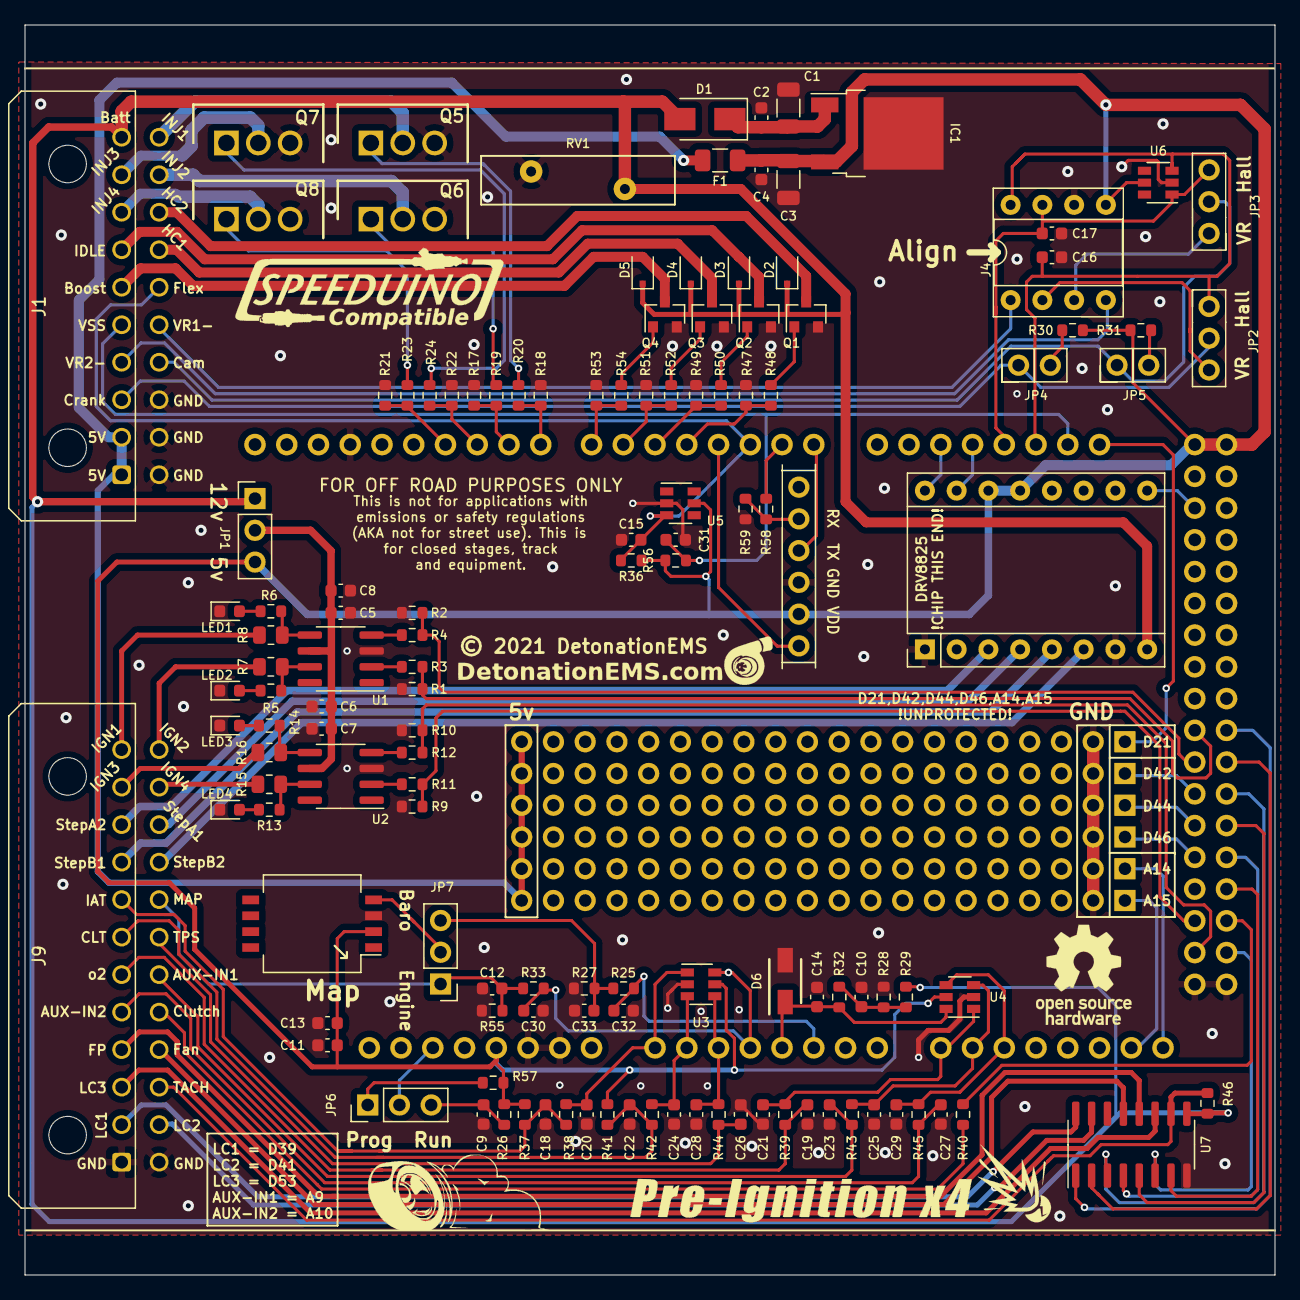
[picture p155: board Engine Managment/Pre-Ignition/Pre-Ignition x4/MX4A/Pre_Ignition.kicad… from above]

Board: 2 copper layers, 100.0 x 100.0 mm, 137 parts (0 on the bottom side), 116 nets.

Parts:
A1: Pololu_Breakout_DRV8825; Pololu_Breakout-16_15.2x20.3mm
C1: 10uF; C_1206_3216Metric
C2, C4, C5, C7, C10, C11, C17, C18, C19, C22, C23, C26, C27: 0.1uF; C_0603_1608Metric
C3: 47uF; C_1206_3216Metric
C6, C8, C13: 1uF; C_0603_1608Metric
C9: 22uF; C_0603_1608Metric
C12, C33: 470pF; C_0603_1608Metric
C14, C15, C20, C21, C24, C25, C28, C29: 0.22uF; C_0603_1608Metric
C16, C31: 0.01uF; C_0603_1608Metric
C30, C32: 33uF; C_0603_1608Metric
D1: D_Schottky; D_SMA
D2, D3, D4, D5: 1N4148WS; D_SOD-323F
D6: 1SMAF4733A; SODFL4626X120N
F1: nSMD025; Fuse_1206_3216Metric
G?: Disclaimer; Off_Road_Disclaimer
IC1: MC7805CDTRKG; TO-252-2
J1: Conn_02x10_Counter_Clockwise; Molex_Micro-Fit_3.0_43045-2000_2x10_P3.00mm_Horizontal
J2: Conn_01x04; Bluetooth-Module
J3, J5, J10: Conn_02x20_Counter_Clockwise; 2x20_P2.54mm-Small-CrtYd
J4: VR_Header; DIP-8_W7.62mm_Socket_VRConditioner
J9: Conn_02x12_Counter_Clockwise; Molex_Micro-Fit_3.0_43045-2400_2x12_P3.00mm_Horizontal
JP1: Ignition Voltage; PinHeader_1x03_P2.54mm_Vertical
JP2: VR-HALL; PinHeader-1x03-P2.54mm-Jumper
JP3: VR-Hall; PinHeader-1x03-P2.54mm-Jumper
JP4, JP5: Pullup; 1x02-P2.54mm-Jumper
JP6: Reset Control; PinHeader_1x03_P2.54mm_Vertical
JP7: Jumper_3_Bridged12; PinHeader_1x03_P2.54mm_Vertical
LED1, LED2, LED3, LED4: LED; LED_0603_1608Metric
Map1: Map; Freescale_98ARH99066A
Q1, Q2, Q3, Q4: AO3400A; SOT-23
Q5, Q6, Q7, Q8: STP62NS04Z; TO255P460X1020X2008-3P
R1, R2, R9, R10, R17, R18, R21, R22, R47, R49, R51, R53: 100K; R_0603_1608Metric
R3, R4, R11, R12, R19, R20, R23, R24, R28, R30, R31, R40, R56, R58: 1K; R_0603_1608Metric
R5, R6, R13, R14, R36: 2.4k; R_0603_1608Metric
R7, R8, R15, R16: 22; R_0805_2012Metric
R25, R32, R33, R38, R39, R42, R43, R44, R45: 470; R_0603_1608Metric
R26, R48, R50, R52, R54: 120; R_0603_1608Metric
R27, R55: 51k; R_0603_1608Metric
R29: 3.9k; R_0603_1608Metric
R37, R41: 2.49k; R_0603_1608Metric
R46: 10K; R_0603_1608Metric
R57: 10k; R_0603_1608Metric
R59: 2K; R_0603_1608Metric
RV1: MOV; RV_Disc_D15.5mm_W3.9mm_P7.5mm
Speeduino_Compatible1: Logo_Open_Hardware_Large; detonationems
U1, U2: TC4427; SOIC-8_3.9x4.9mm_P1.27mm
U3, U4, U5, U6: SRV05-4-P-T7; SOT-23-6
U7: ULN2003A; SOIC-16_3.9x9.9mm_P1.27mm
XA1: Arduino_Mega2560_Shield-Arduino; Arduino_Mega2560_Shield_IO_Only_No_Silk_Screen

Connections:
5v-Fused: F1.2, J1.1, J1.2, J3.39, J3.40, J5.39, J5.40, J10.39, J10.40
+BATT: A1.8, D1.2, D2.1, D3.1, D4.1, D5.1, J1.10, JP1.1, R29.2, R46.2, RV1.1, U7.9
A9: C23.1, J9.18, R43.2
A10: C27.1, J9.5, R45.2
BOOST: D5.2, J1.6, Q4.3
CLT: C22.1, J9.7, R41.1, R42.2
Cam-In: J1.14, JP3.2, JP5.1
Clutch: J9.17, R40.2
Crank-In: J1.3, JP2.2, JP4.1
D39: J9.2, U7.16
D41: J9.14, U7.15
D53: J9.3, U7.11
Fan: J9.16, U7.13
Flex: C15.1, J1.16, R36.2, U5.3, XA1.D2
Fuel-Pump: J9.4, U7.12
GND: A1.1, A1.7, C1.2, C2.2, C3.2, C4.2, C5.2, C6.2, C7.2, C8.2, C9.1, C10.2, C11.1, C12.2, C13.1, C14.2, C15.2, C16.1, C17.1, C18.2, C19.2, C20.2, C21.2, C22.2, C23.2, C24.2, C25.2, C26.2, C27.2, C28.2, C29.2, C30.1, C31.2, C32.1, C33.2, D6.2, IC1.2, J1.11, J1.12, J1.13, J2.3, J3.3, J3.4, J4.6, J5.3, J5.4, J9.1, J9.13, J10.3, J10.4, LED1.1, LED2.1, LED3.1, LED4.1, Map1.3, Q1.2, Q2.2, Q3.2, Q4.2, Q5.3, Q6.3, Q7.3, Q8.3, R1.2, R2.1, R9.2, R10.1, R17.2, R18.1, R21.2, R22.1, R27.2, R28.1, R47.1, R49.1, R51.1, R53.1, R55.2, R59.1, RV1.2, U1.3, U2.3, U3.2, U4.2, U5.2, U6.2, U7.8, XA1.GND1, XA1.GND2, XA1.GND3, XA1.GND5, XA1.GND6
HC1: D4.2, J1.17, Q3.3
HC2: D2.2, J1.18, Q1.3
IAT: C18.1, J9.8, R37.1, R38.2
IDLE: D3.2, J1.7, Q2.3
IGN1: J9.12, R8.1
IGN2: J9.24, R7.1
IGN3: J9.11, R16.1
IGN4: J9.23, R15.1
IGN-V-Select: C5.1, C6.1, C7.1, C8.1, JP1.2, U1.6, U2.6
INJ1: J1.20, Q5.2
INJ2: J1.19, Q6.2
INJ3: J1.9, Q7.2
INJ4: J1.8, Q8.2
MC-A0: C20.1, R38.1, U3.1, XA1.A0
MC-A1: C24.1, R42.1, U3.3, XA1.A1
MC-A2: C28.1, R44.1, U3.4, XA1.A2
MC-A3: C30.2, R33.2, U3.6, XA1.A3
MC-A4: C14.1, D6.1, R32.1, U4.6, XA1.A4
MC-A5: C32.2, R25.2, XA1.A5
MC-A8: C21.1, R39.1, U4.1, XA1.A8
MC-A9: C25.1, R43.1, U4.3, XA1.A9
MC-A10: C29.1, R45.1, U4.4, XA1.A10
MC-A14: J5.2, XA1.A14
MC-A15: J5.1, XA1.A15
MC-D0: J2.4, XA1.D0
MC-D1: R58.2, XA1.D1
MC-D3: J2.1, XA1.D3
MC-D4: R47.2, R48.2, XA1.D4
MC-D5: R49.2, R50.2, XA1.D5
MC-D6: R51.2, R52.2, XA1.D6
MC-D7: R53.2, R54.2, XA1.D7
MC-D8: R18.2, R20.2, XA1.D8
MC-D9: R17.1, R19.2, XA1.D9
MC-D10: R22.2, R24.2, XA1.D10
MC-D11: R21.1, R23.2, XA1.D11
MC-D16: A1.16, XA1.D16
MC-D17: A1.15, XA1.D17
MC-D18: C17.2, J4.7, JP3.3, U6.1, XA1.D18
MC-D19: C16.2, J4.8, JP2.1, U6.3, XA1.D19
MC-D20: C31.1, J1.5, R56.1, XA1.D20
MC-D21: J10.1, XA1.D21
MC-D24: A1.9, XA1.D24
MC-D38: R1.1, R3.2, XA1.D38
MC-D39: U7.1, XA1.D39
MC-D40: R2.2, R4.2, XA1.D40
MC-D41: U7.2, XA1.D41
MC-D42: J10.2, XA1.D42
MC-D43: U7.3, XA1.D43
MC-D44: J3.1, XA1.D44
MC-D45: U7.5, XA1.D45
MC-D46: J3.2, XA1.D46
MC-D47: U7.4, XA1.D47
MC-D49: U7.7, XA1.D49
MC-D50: R9.1, R11.2, XA1.D50
MC-D51: R40.1, XA1.D51
MC-D52: R10.2, R12.2, XA1.D52
MC-D53: U7.6, XA1.D53
MC-RESET: JP6.2, XA1.RST1
Map-External: C12.1, J9.20, JP7.1, R33.1, R55.1
unnamed: C1.1, C2.1, D1.1, IC1.1
unnamed: C9.2, JP6.3, R26.1
unnamed: C10.1, R28.2, R29.1, R32.2
unnamed: C33.1, JP7.3, R25.1, R27.1
unnamed: J2.5, R58.1, R59.2
unnamed: J4.2, JP2.3
unnamed: J4.3, JP3.1
unnamed: JP4.2, R30.1
unnamed: JP5.2, R31.1
unnamed: JP6.1, R57.2
unnamed: JP7.2, Map1.4
unnamed: LED1.2, R6.1
unnamed: LED2.2, R5.2
unnamed: LED3.2, R14.1
unnamed: LED4.2, R13.2
unnamed: Q1.1, R48.1
unnamed: Q2.1, R50.1
unnamed: Q3.1, R52.1
unnamed: Q4.1, R54.1
unnamed: Q5.1, R20.1
unnamed: Q6.1, R19.1
unnamed: Q7.1, R24.1
unnamed: Q8.1, R23.1
unnamed: R3.1, U1.2
unnamed: R4.1, U1.4
unnamed: R5.1, R7.2, U1.7
unnamed: R6.2, R8.2, U1.5
unnamed: R11.1, U2.2
unnamed: R12.1, U2.4
unnamed: R13.1, R15.2, U2.7
unnamed: R14.2, R16.2, U2.5
O2: C19.1, J9.6, R39.2
Step-A1: A1.4, J9.22
Step-A2: A1.3, J9.10
Step-B1: A1.5, J9.9
Step-B2: A1.6, J9.21
TPS: C26.1, J9.19, R44.2
Tach: J9.15, R46.1, U7.10
VDD: A1.13, A1.14, C3.1, C4.1, C11.2, C13.2, F1.1, IC1.3, J2.2, J4.5, JP1.3, Map1.2, R26.2, R30.2, R31.2, R36.1, R37.2, R41.2, R56.2, R57.1, U3.5, U4.5, U5.5, U6.5, XA1.5V1, XA1.5V3, XA1.5V4
VR1-: J1.15, J4.1
VR2-: J1.4, J4.4
