OpenLogicEFI/Hardware/Engine Simulation/8 Channel/RevA/Simulator.kicad_pcb

## KiCad design Engine Simulation/8 Channel/RevA/Simulator.kicad_pcb (2022-09-11, an earlier design)

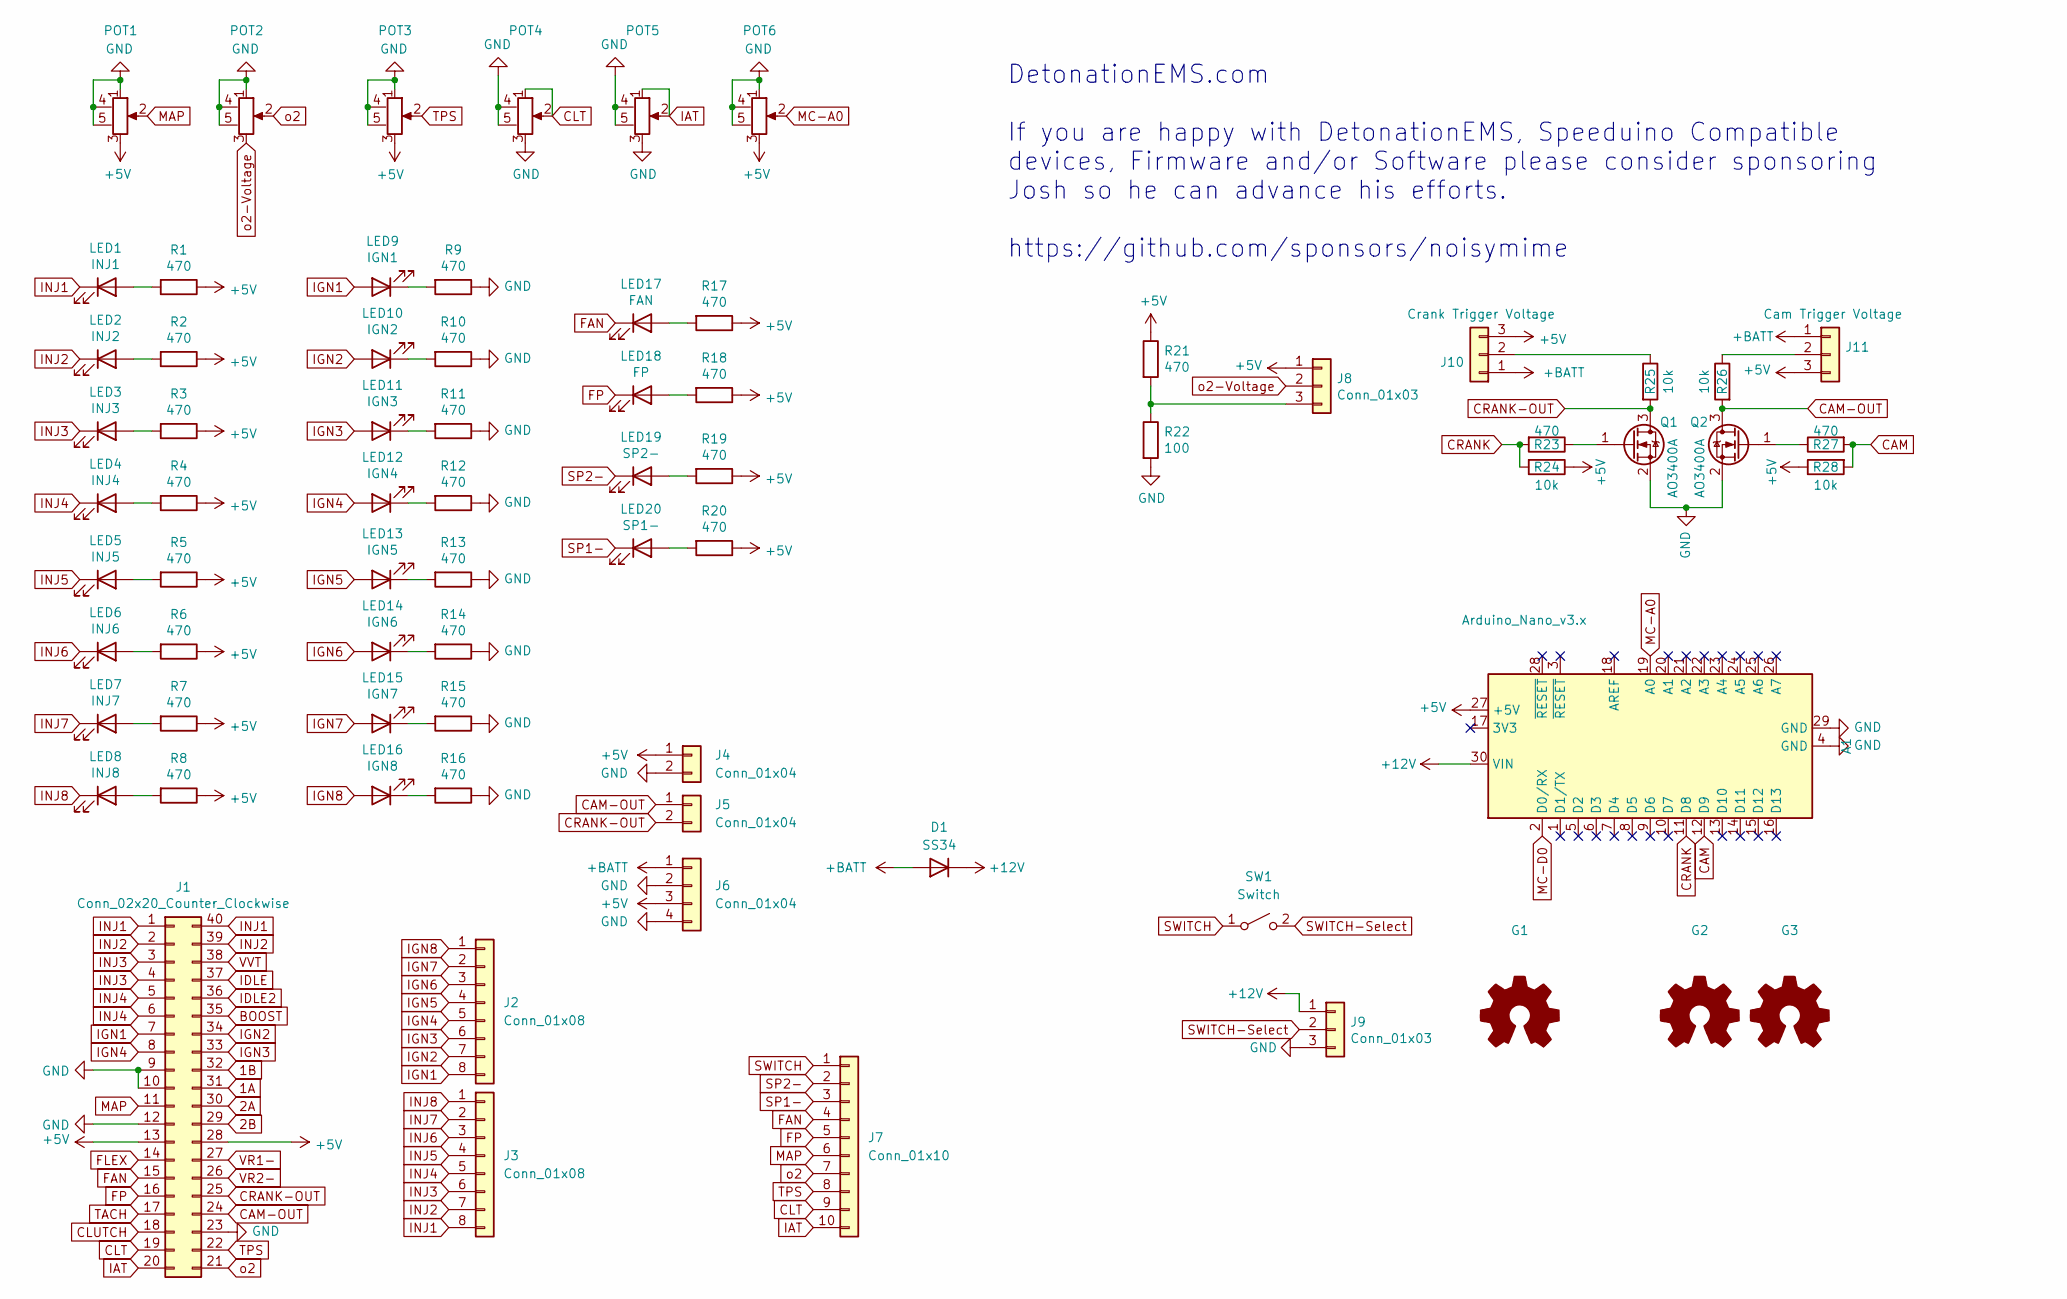
[picture p156: schematic Simulator.kicad_sch, Engine Simulator]

Parts:
A1: Arduino_Nano_v3.x; Arduino_Nano
D1: SS34; D_SOD-123; LCSC C8598
G1: Logo_Open_Hardware_Small; DetonationEMS-30mm
G2: Logo_Open_Hardware_Small; SpeeduinoCompatible-17mm
G3: Logo_Open_Hardware_Small; OSHW-Logo2_7.3x6mm_SilkScreen
J1: Conn_02x20_Counter_Clockwise; IDC-Header_2x20_P2.54mm_Vertical_Speeduino
J2, J3: Conn_01x08; TerminalBlock_Phoenix_PT-1,5-8-3.5-H_1x08_P3.50mm_Horizontal
J4, J5: Conn_01x04; TerminalBlock_Phoenix_PT-1,5-2-3.5-H_1x02_P3.50mm_Horizontal
J6: Conn_01x04; TerminalBlock_Phoenix_PT-1,5-4-3.5-H_1x04_P3.50mm_Horizontal
J7: Conn_01x10; TerminalBlock_Phoenix_PT-1,5-10-3.5-H_1x10_P3.50mm_Horizont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
J8, J9: Conn_01x03; 3-PinSwitch
J10: Crank Trigger Voltage; 3-PinSwitch
J11: Cam Trigger Voltage; 3-PinSwitch
LED1: INJ1; LED_0603_1608Metric; LCSC C2286
LED2: INJ2; LED_0603_1608Metric; LCSC C2286
LED3: INJ3; LED_0603_1608Metric; LCSC C2286
LED4: INJ4; LED_0603_1608Metric; LCSC C2286
LED5: INJ5; LED_0603_1608Metric; LCSC C2286
LED6: INJ6; LED_0603_1608Metric; LCSC C2286
LED7: INJ7; LED_0603_1608Metric; LCSC C2286
LED8: INJ8; LED_0603_1608Metric; LCSC C2286
LED9: IGN1; LED_0603_1608Metric; LCSC C2286
LED10: IGN2; LED_0603_1608Metric; LCSC C2286
LED11: IGN3; LED_0603_1608Metric; LCSC C2286
LED12: IGN4; LED_0603_1608Metric; LCSC C2286
LED13: IGN5; LED_0603_1608Metric; LCSC C2286
LED14: IGN6; LED_0603_1608Metric; LCSC C2286
LED15: IGN7; LED_0603_1608Metric; LCSC C2286
LED16: IGN8; LED_0603_1608Metric; LCSC C2286
LED17: FAN; LED_0603_1608Metric; LCSC C2286
LED18: FP; LED_0603_1608Metric; LCSC C2286
LED19: SP2-; LED_0603_1608Metric; LCSC C2286
LED20: SP1-; LED_0603_1608Metric; LCSC C2286
POT1: IAT; RV09AF4020KB10K
POT2: CLT; RV09AF4020KB10K
POT3: MAP/SP1; RV09AF4020KB10K
POT4: TPS; RV09AF4020KB10K
POT5: o2; RV09AF4020KB10K
POT6: RPM; RV09AF4020KB10K
Q1, Q2: AO3400A; SOT-23; LCSC C20917
R1, R2, R3, R4, R5, R6, R7, R8, R9, R10, R11, R12, R13, R14, R15, R16, R17, R18, R19, R20, R21, R23, R27: 470; R_0603_1608Metric; LCSC C23179
R22: 100; R_0603_1608Metric; LCSC C22775
R24, R25, R26, R28: 10k; R_0603_1608Metric; LCSC C23138
SW1: Switch; SW_PUSH_6mm_H9.5mm

Connections:
1A: J1.31
1B: J1.32
2A: J1.30
2B: J1.29
+5V: A1.27 (+5V), J1.13, J1.28, J4.1, J6.3, J8.1, J10.3, J11.3, POT1.3, POT3.3, POT6.3, R1.1, R2.1, R3.1, R4.1, R5.1, R6.1, R7.1, R8.1, R17.1, R18.1, R19.1, R20.1, R21.1, R24.1, R28.1
+12V: A1.30 (VIN), D1.1 (K), J9.1
+BATT: D1.2 (A), J6.1, J10.1, J11.1
BOOST: J1.35
CAM: A1.12 (D9), R27.2, R28.2
CAM-OUT: J1.24, J5.1, Q2.3 (D), R26.2
CLT: J1.19, J7.9, POT4.1, POT4.2
CLUTCH: J1.18
CRANK: A1.11 (D8), R23.2, R24.2
CRANK-OUT: J1.25, J5.2, Q1.3 (D), R25.2
FAN: J1.15, J7.4, LED17.1 (K)
FLEX: J1.14
FP: J1.16, J7.5, LED18.1 (K)
GND: A1.4 (GND), A1.29 (GND), J1.9, J1.10, J1.12, J1.23, J4.2, J6.2, J6.4, J9.3, POT1.1, POT1.4 (Mounting_Tap), POT1.5 (Mounting_Tap), POT2.1, POT2.4 (Mounting_Tap), POT2.5 (Mounting_Tap), POT3.1, POT3.4 (Mounting_Tap), POT3.5 (Mounting_Tap), POT4.3, POT4.4 (Mounting_Tap), POT4.5 (Mounting_Tap), POT5.3, POT5.4 (Mounting_Tap), POT5.5 (Mounting_Tap), POT6.1, POT6.4 (Mounting_Tap), POT6.5 (Mounting_Tap), Q1.2 (S), Q2.2 (S), R9.1, R10.1, R11.1, R12.1, R13.1, R14.1, R15.1, R16.1, R22.2; also elsewhere on the board
IAT: J1.20, J7.10, POT5.1, POT5.2
IDLE: J1.37
IDLE2: J1.36
IGN1: J1.7, J2.8, LED9.2 (A)
IGN2: J1.34, J2.7, LED10.2 (A)
IGN3: J1.33, J2.6, LED11.2 (A)
IGN4: J1.8, J2.5, LED12.2 (A)
IGN5: J2.4, LED13.2 (A)
IGN6: J2.3, LED14.2 (A)
IGN7: J2.2, LED15.2 (A)
IGN8: J2.1, LED16.2 (A)
INJ1: J1.1, J1.40, J3.8, LED1.1 (K)
INJ2: J1.2, J1.39, J3.7, LED2.1 (K)
INJ3: J1.3, J1.4, J3.6, LED3.1 (K)
INJ4: J1.5, J1.6, J3.5, LED4.1 (K)
INJ5: J3.4, LED5.1 (K)
INJ6: J3.3, LED6.1 (K)
INJ7: J3.2, LED7.1 (K)
INJ8: J3.1, LED8.1 (K)
MAP: J1.11, J7.6, POT1.2
MC-A0: A1.19 (A0), POT6.2
MC-D0: A1.2 (D0/RX)
unnamed: J8.3, R21.2, R22.1
unnamed: J10.2, R25.1
unnamed: J11.2, R26.1
unnamed: LED1.2 (A), R1.2
unnamed: LED2.2 (A), R2.2
unnamed: LED3.2 (A), R3.2
unnamed: LED4.2 (A), R4.2
unnamed: LED5.2 (A), R5.2
unnamed: LED6.2 (A), R6.2
unnamed: LED7.2 (A), R7.2
unnamed: LED8.2 (A), R8.2
unnamed: LED9.1 (K), R9.2
unnamed: LED10.1 (K), R10.2
unnamed: LED11.1 (K), R11.2
unnamed: LED12.1 (K), R12.2
unnamed: LED13.1 (K), R13.2
unnamed: LED14.1 (K), R14.2
unnamed: LED15.1 (K), R15.2
unnamed 58: LED16.1 (K), R16.2; also elsewhere on the board
unnamed: LED17.2 (A), R17.2
unnamed: LED18.2 (A), R18.2
unnamed: LED19.2 (A), R19.2
unnamed: LED20.2 (A), R20.2
unnamed: Q1.1 (G), R23.1
unnamed: Q2.1 (G), R27.1
SP1-: J7.3, LED20.1 (K)
SP2-: J7.2, LED19.1 (K)
SWITCH: J7.1, SW1.1 (A)
SWITCH-Select: J9.2, SW1.2 (B)
TACH: J1.17
TPS: J1.22, J7.8, POT3.2
VR1-: J1.27
VR2-: J1.26
VVT: J1.38
o2: J1.21, J7.7, POT2.2
o2-Voltage: J8.2, POT2.3

Notes on the sheet:
DetonationEMS.com If you are happy with DetonationEMS, Speeduino Compatible devices, Firmware and/or Software please consider sponsoring Josh so he can advance his efforts. https://github.com/sponsors/noisymime

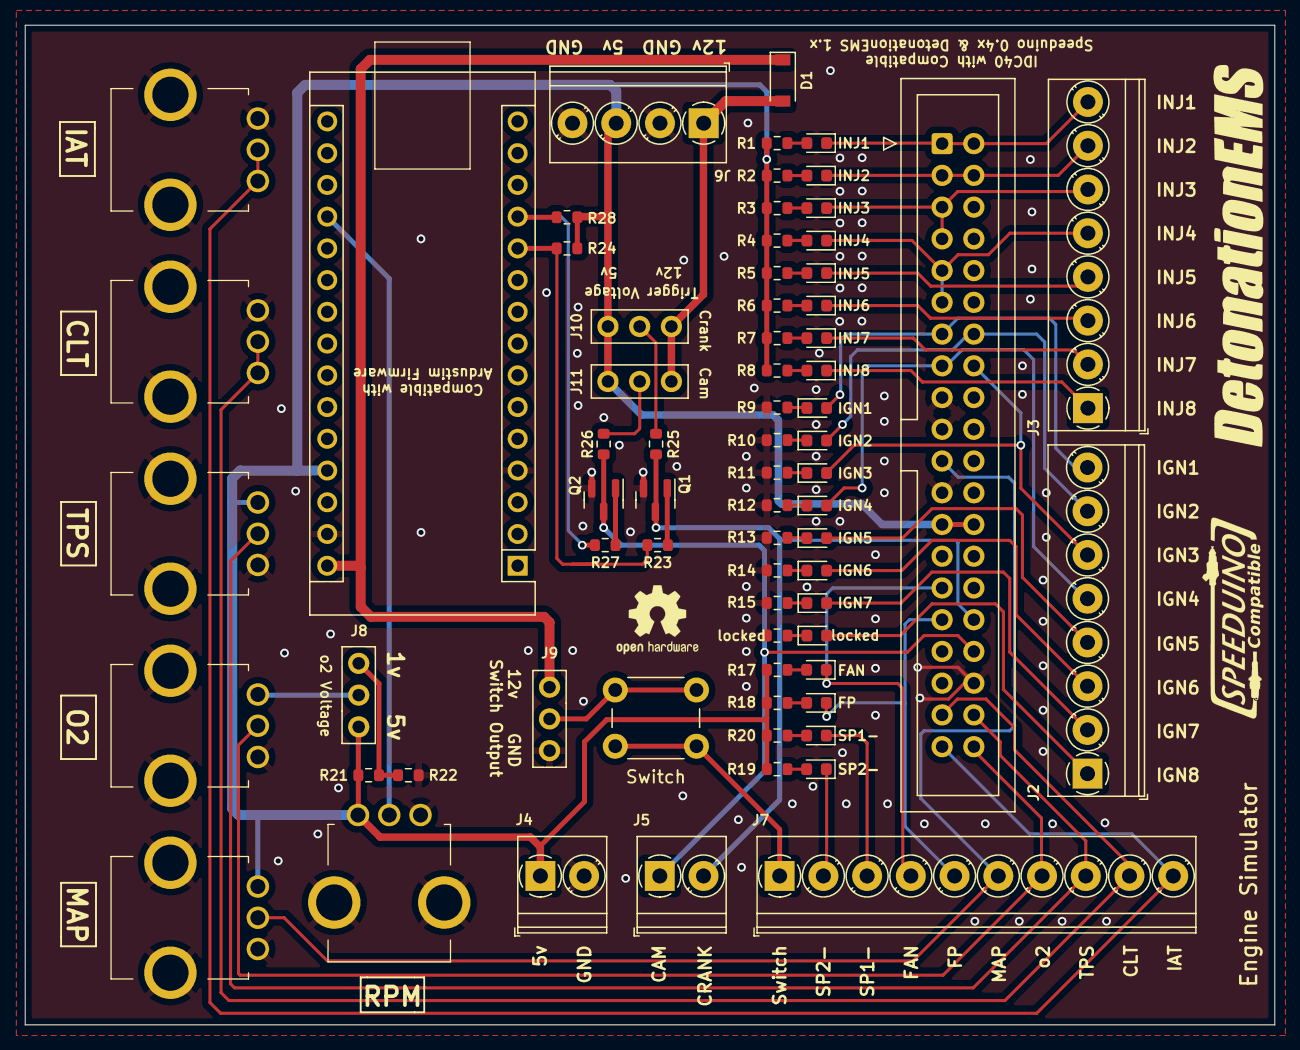
[picture p157: board Engine Simulation/8 Channel/RevA/Simulator.kicad_pcb from above]

Board: 2 copper layers, 100.0 x 80.0 mm, 73 parts (0 on the bottom side), 62 nets.

Other parts of the board:
locked: 470; R_0603_1608Metric

Their connections:
GND: locked.1; also elsewhere on the board
unnamed 58: locked.2; also elsewhere on the board
