OpenLogicEFI/Hardware/Engine Simulation/4 Channel/Simulator.kicad_pcb

## KiCad design Engine Simulation/4 Channel/Simulator.kicad_pcb (2022-02-17, an earlier design)

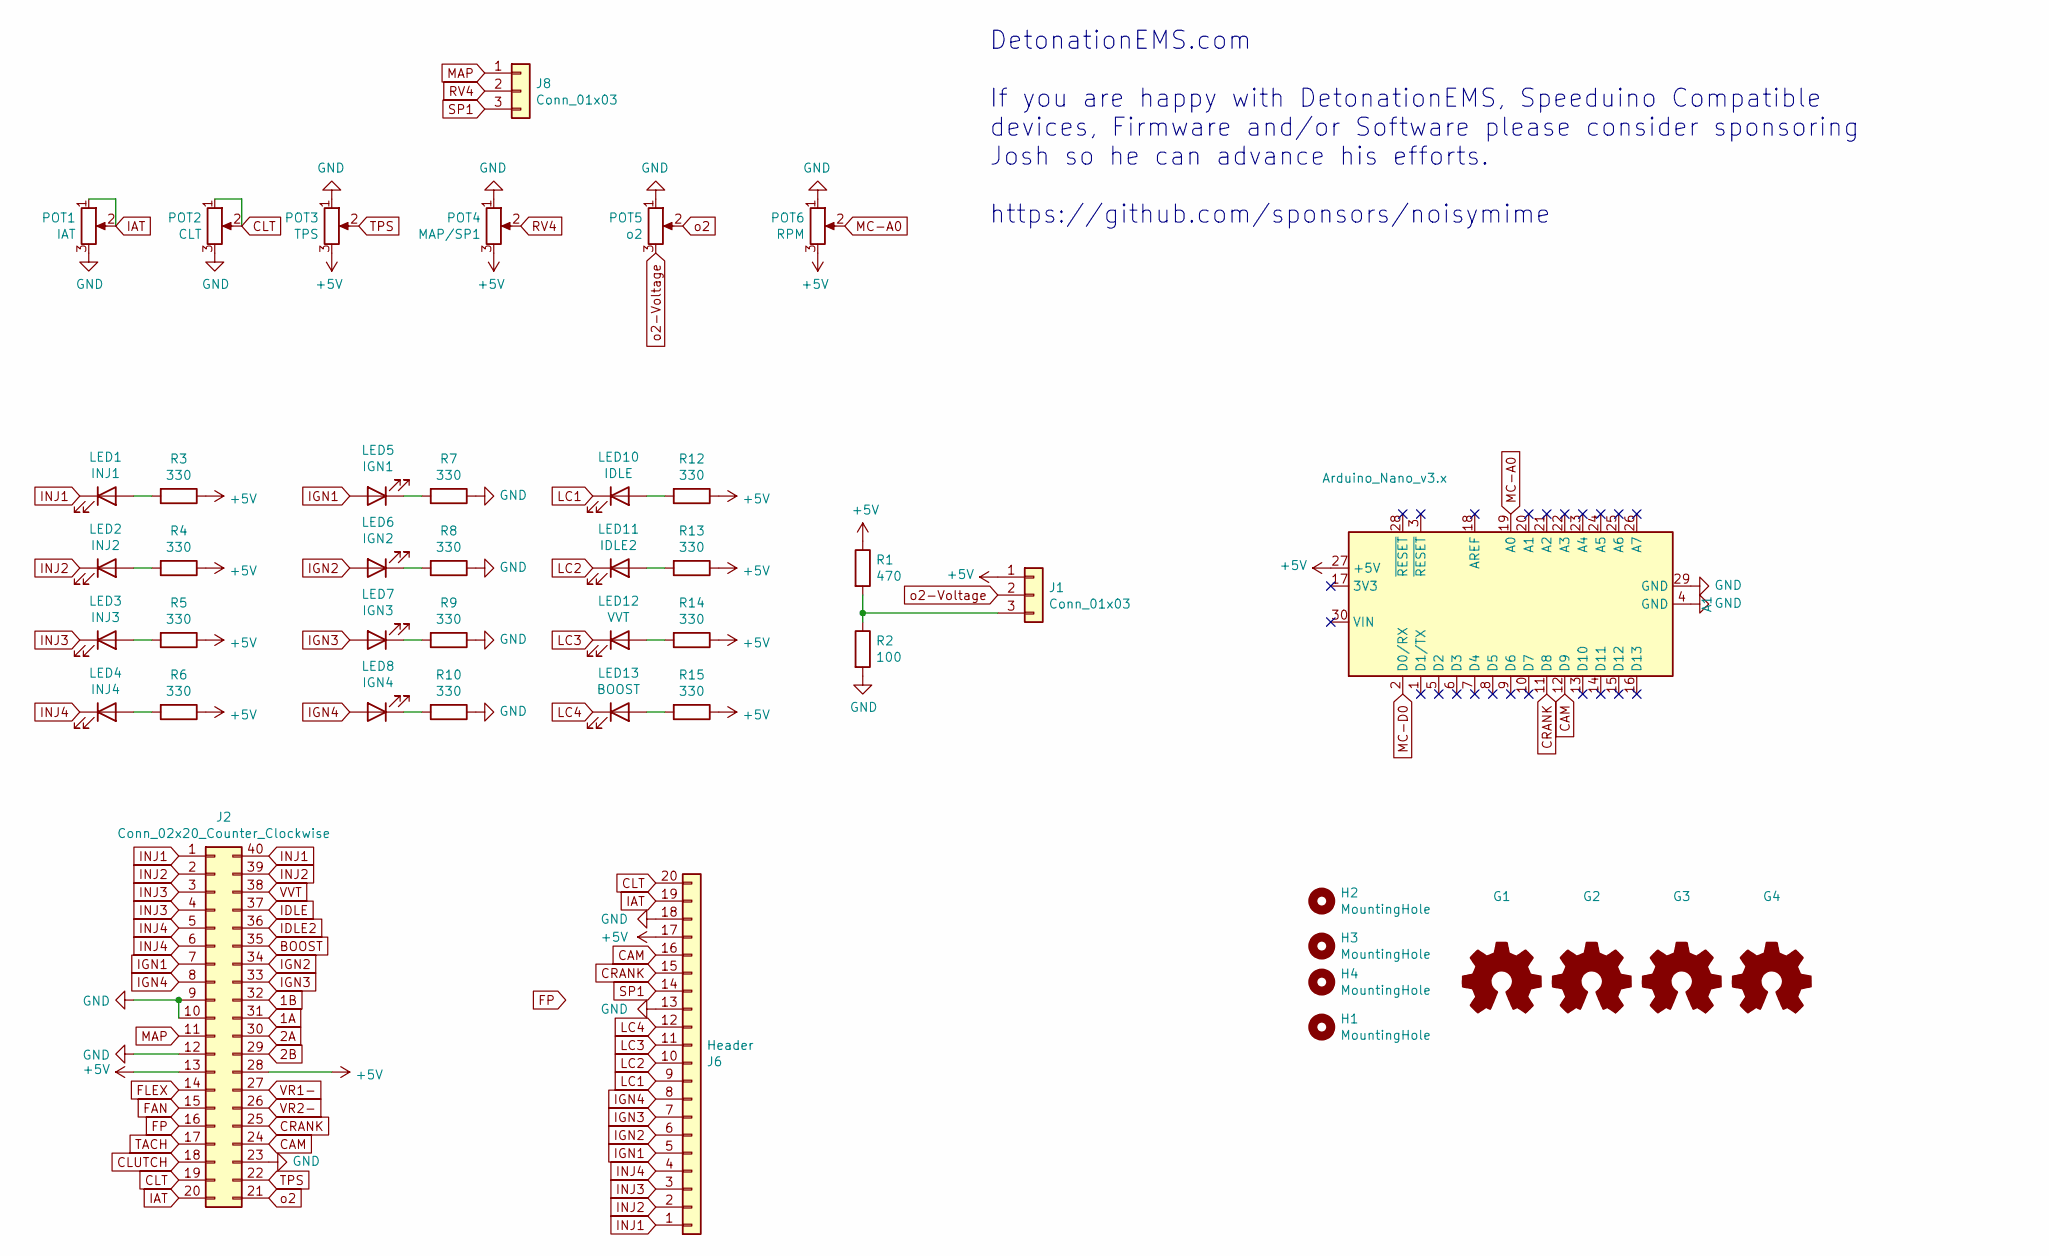
[picture p158: schematic Simulator.kicad_sch, Engine Simulator]

Parts:
A1: Arduino_Nano_v3.x; Arduino_Nano
G1: Logo_Open_Hardware_Small; TireSmoke-22mm
G2: Logo_Open_Hardware_Small; DetonationEMS
G3: Logo_Open_Hardware_Small; SpeeduinoCompatible-30mm
G4: Logo_Open_Hardware_Small; OSHW-Logo2_14.6x12mm_SilkScreen
H1, H2, H3, H4: MountingHole; MountingHole_3.2mm_M3
J1, J8: Conn_01x03; 3-PinSwitch
J2: Conn_02x20_Counter_Clockwise; IDC-Header_2x20_P2.54mm_Vertical_Speeduino
J6: Header; PinHeader_1x20_P2.54mm_Vertical
LED1: INJ1; LED_0603_1608Metric; LCSC C2286
LED2: INJ2; LED_0603_1608Metric; LCSC C2286
LED3: INJ3; LED_0603_1608Metric; LCSC C2286
LED4: INJ4; LED_0603_1608Metric; LCSC C2286
LED5: IGN1; LED_0603_1608Metric; LCSC C2286
LED6: IGN2; LED_0603_1608Metric; LCSC C2286
LED7: IGN3; LED_0603_1608Metric; LCSC C2286
LED8: IGN4; LED_0603_1608Metric; LCSC C2286
LED10: IDLE; LED_0603_1608Metric; LCSC C2286
LED11: IDLE2; LED_0603_1608Metric; LCSC C2286
LED12: VVT; LED_0603_1608Metric; LCSC C2286
LED13: BOOST; LED_0603_1608Metric; LCSC C2286
POT1: IAT; RV09AF4020KB10K
POT2: CLT; RV09AF4020KB10K
POT3: TPS; RV09AF4020KB10K
POT4: MAP/SP1; RV09AF4020KB10K
POT5: o2; RV09AF4020KB10K
POT6: RPM; RV09AF4020KB10K
R1: 470; R_0603_1608Metric; LCSC C23179
R2: 100; R_0603_1608Metric; LCSC C22775
R3, R4, R5, R6, R7, R8, R9, R10, R12, R13, R14, R15: 330; R_0603_1608Metric; LCSC C23138

Connections:
1A: J2.31
1B: J2.32
2A: J2.30
2B: J2.29
+5V: A1.27 (+5V), J1.1, J2.13, J2.28, J6.17, POT3.3, POT4.3, POT6.3, R1.1, R3.1, R4.1, R5.1, R6.1, R12.1, R13.1, R14.1, R15.1
BOOST: J2.35
CAM: A1.12 (D9), J2.24, J6.16
CLT: J2.19, J6.20, POT2.1, POT2.2
CLUTCH: J2.18
CRANK: A1.11 (D8), J2.25, J6.15
FAN: J2.15
FLEX: J2.14
FP: J2.16
GND: A1.4 (GND), A1.29 (GND), J2.9, J2.10, J2.12, J2.23, J6.13, J6.18, POT1.3, POT2.3, POT3.1, POT4.1, POT5.1, POT6.1, R2.2, R7.1, R8.1, R9.1, R10.1
IAT: J2.20, J6.19, POT1.1, POT1.2
IDLE: J2.37
IDLE2: J2.36
IGN1: J2.7, J6.5, LED5.2 (A)
IGN2: J2.34, J6.6, LED6.2 (A)
IGN3: J2.33, J6.7, LED7.2 (A)
IGN4: J2.8, J6.8, LED8.2 (A)
INJ1: J2.1, J2.40, J6.1, LED1.1 (K)
INJ2: J2.2, J2.39, J6.2, LED2.1 (K)
INJ3: J2.3, J2.4, J6.3, LED3.1 (K)
INJ4: J2.5, J2.6, J6.4, LED4.1 (K)
LC1: J6.9, LED10.1 (K)
LC2: J6.10, LED11.1 (K)
LC3: J6.11, LED12.1 (K)
LC4: J6.12, LED13.1 (K)
MAP: J2.11, J8.1
MC-A0: A1.19 (A0), POT6.2
MC-D0: A1.2 (D0/RX)
unnamed: J1.3, R1.2, R2.1
unnamed: LED1.2 (A), R3.2
unnamed: LED2.2 (A), R4.2
unnamed: LED3.2 (A), R5.2
unnamed: LED4.2 (A), R6.2
unnamed: LED5.1 (K), R7.2
unnamed: LED6.1 (K), R8.2
unnamed: LED7.1 (K), R9.2
unnamed: LED8.1 (K), R10.2
unnamed: LED10.2 (A), R12.2
unnamed: LED11.2 (A), R13.2
unnamed: LED12.2 (A), R14.2
unnamed: LED13.2 (A), R15.2
RV4: J8.2, POT4.2
SP1: J6.14, J8.3
TACH: J2.17
TPS: J2.22, POT3.2
VR1-: J2.27
VR2-: J2.26
VVT: J2.38
o2: J2.21, POT5.2
o2-Voltage: J1.2, POT5.3

Notes on the sheet:
DetonationEMS.com If you are happy with DetonationEMS, Speeduino Compatible devices, Firmware and/or Software please consider sponsoring Josh so he can advance his efforts. https://github.com/sponsors/noisymime

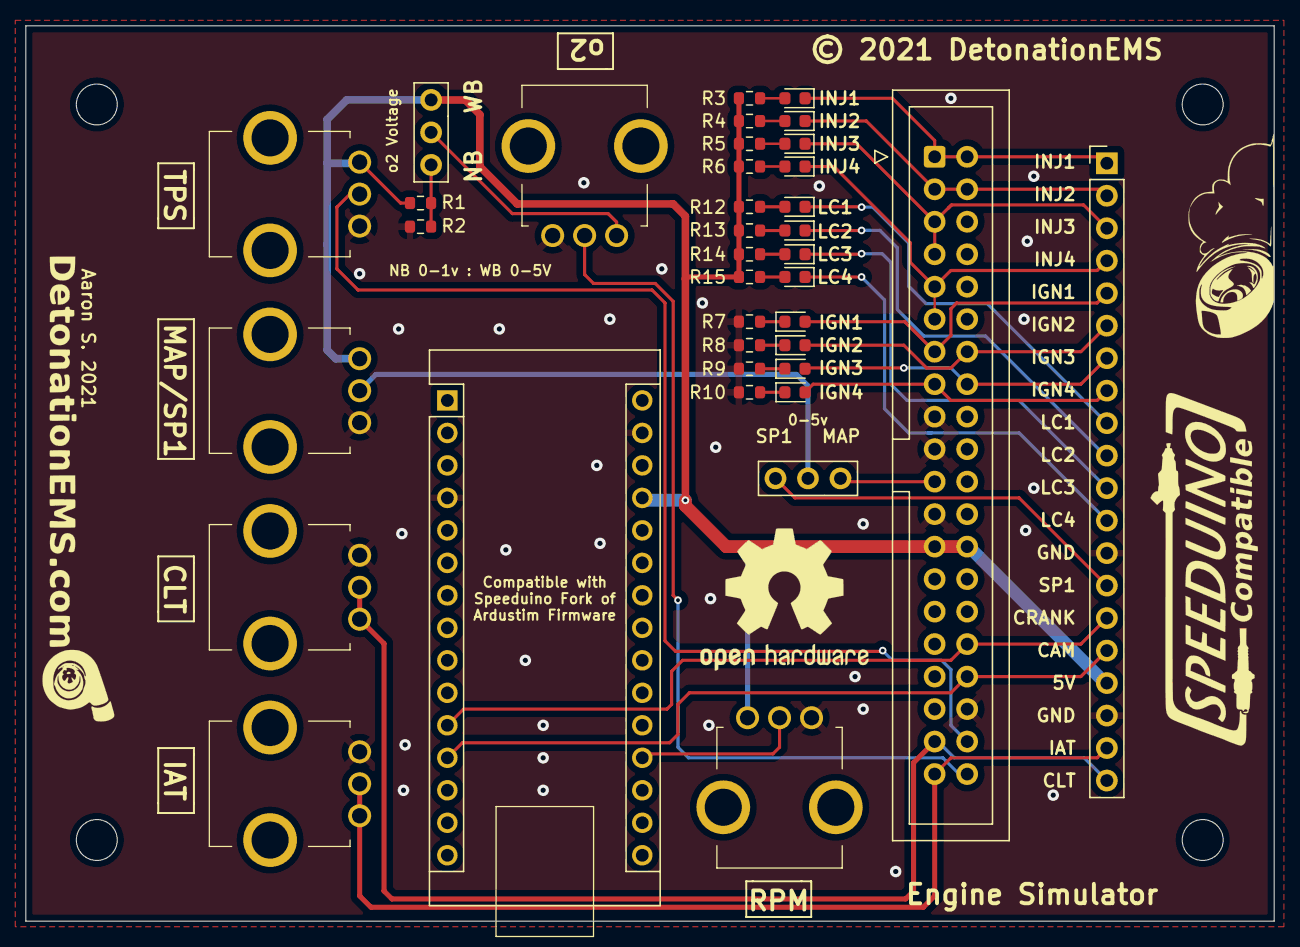
[picture p159: board Engine Simulation/4 Channel/Simulator.kicad_pcb from above]

Board: 2 copper layers, 97.6 x 70.0 mm, 45 parts (0 on the bottom side), 38 nets.
