OpenLogicEFI/Hardware/Modules/VR Conditioner MAX9926/RevA/Max9926-VR.kicad_pcb

## KiCad design Modules/VR Conditioner MAX9926/RevA/Max9926-VR.kicad_pcb (2022-11-17, an earlier design)

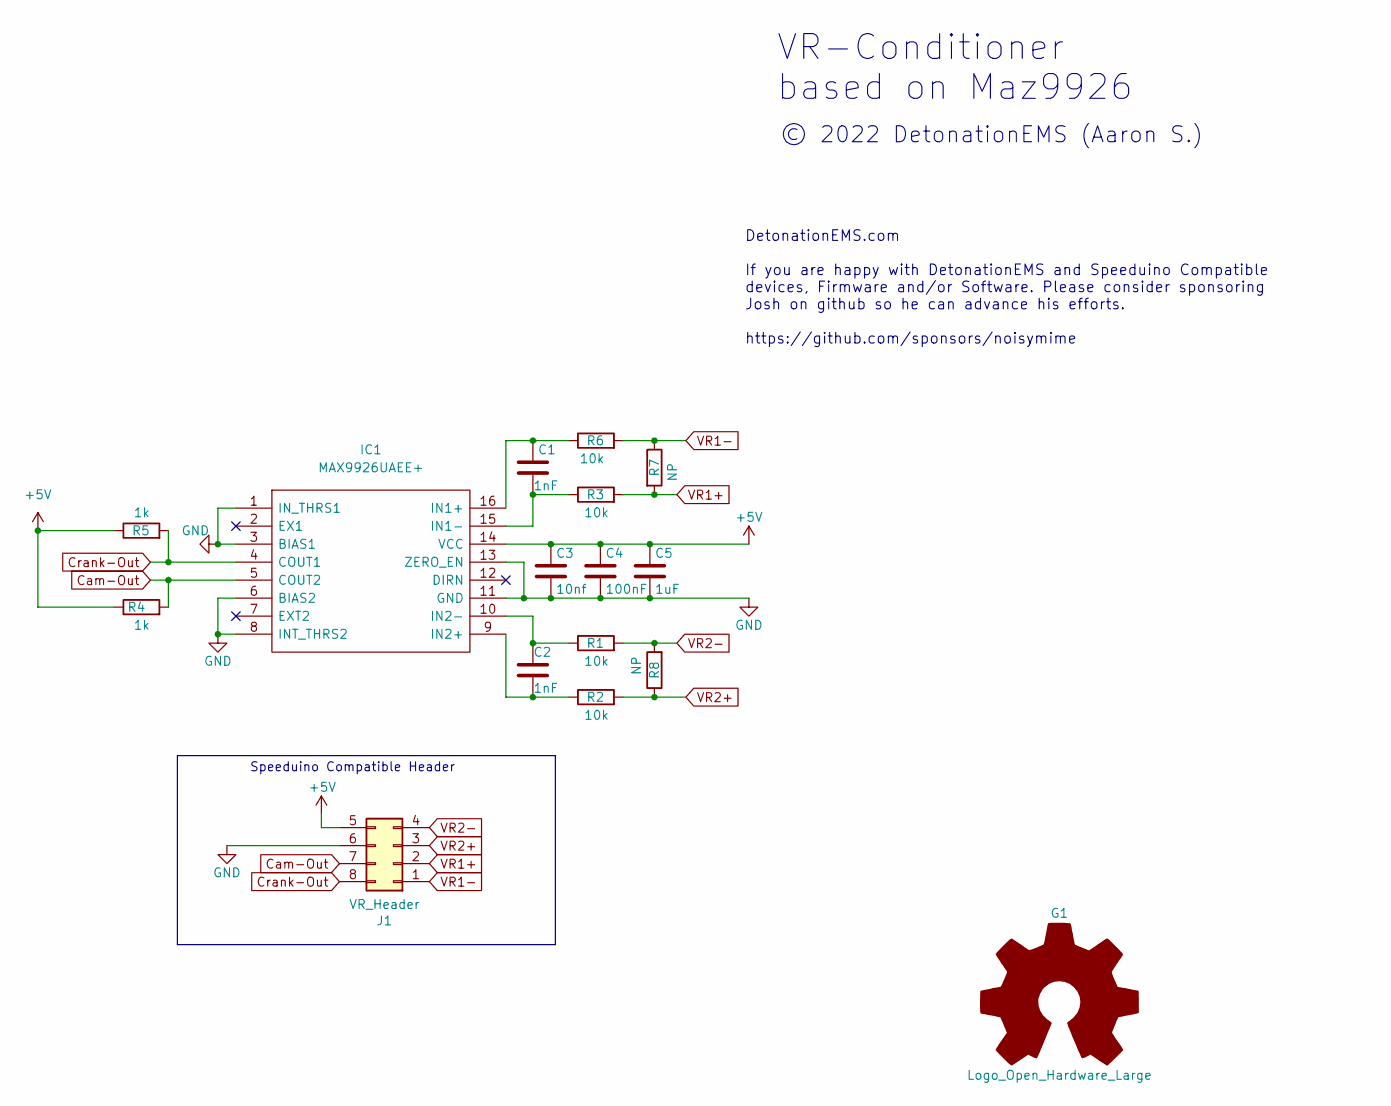
[picture p160: schematic Max9926-VR.kicad_sch, VR-Conditioner]

Parts:
C1, C2: 1nF; C_0603_1608Metric; LCSC C1588
C3: 10nf; C_0603_1608Metric; LCSC C57112
C4: 100nF; C_0603_1608Metric; LCSC C14663
C5: 1uF; C_0603_1608Metric; LCSC C15849
G1: Logo_Open_Hardware_Large; SpeeduinoCompatible-17mm
IC1: MAX9926UAEE+; SOP64P602X175-16N; MFG Part Num MAX9926UAEE+
J1: VR_Header; Socket_VRConditioner
R1, R2, R3, R6: 10k; R_1206_3216Metric; LCSC C17902
R4, R5: 1k; R_0402_1005Metric; LCSC C11702
R7, R8: NP; R_Axial_DIN0207_L6.3mm_D2.5mm_P7.62mm_Horizontal

Connections:
+5V: C3.1, C4.1, C5.1, IC1.14 (VCC), J1.5, R4.1, R5.1
Cam-Out: IC1.5 (COUT2), J1.7, R4.2
Crank-Out: IC1.4 (COUT1), J1.8, R5.2
GND: C3.2, C4.2, C5.2, IC1.1 (IN_THRS1), IC1.3 (BIAS1), IC1.6 (BIAS2), IC1.8 (INT_THRS2), IC1.11 (GND), IC1.13 (ZERO_EN), J1.6
unnamed: C1.1, IC1.16 (IN1+), R6.1
unnamed: C1.2, IC1.15 (IN1-), R3.1
unnamed: C2.1, IC1.10 (IN2-), R1.1
unnamed: C2.2, IC1.9 (IN2+), R2.1
VR1+: J1.2, R3.2, R7.2
VR1-: J1.1, R6.2, R7.1
VR2+: J1.3, R2.2, R8.1
VR2-: J1.4, R1.2, R8.2

Notes on the sheet:
© 2022 DetonationEMS (Aaron S.)
DetonationEMS.com If you are happy with DetonationEMS and Speeduino Compatible devices, Firmware and/or Software. Please consider sponsoring Josh on github so he can advance his efforts. https://github.com/sponsors/noisymime
Speeduino Compatible Header
VR-Conditioner based on Maz9926

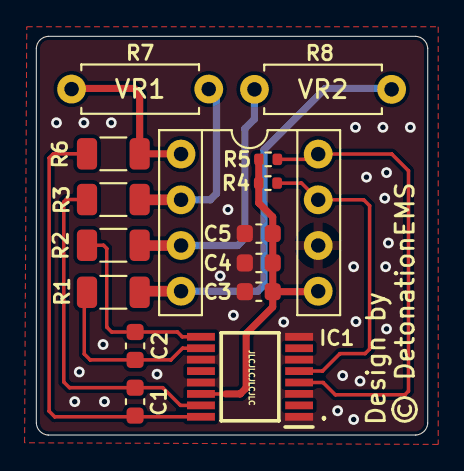
[picture p161: board Max9926-VR.kicad_pcb from above]

Board: 2 copper layers, 21.7 x 22.1 mm, 16 parts (1 on the bottom side), 12 nets.
