OpenLogicEFI/Hardware/Engine Managment/1.x/v1.3/1.3e/1.3.kicad_pcb

## KiCad design Engine Managment/1.x/v1.3/1.3e/1.3.kicad_pcb (2021-09-22)

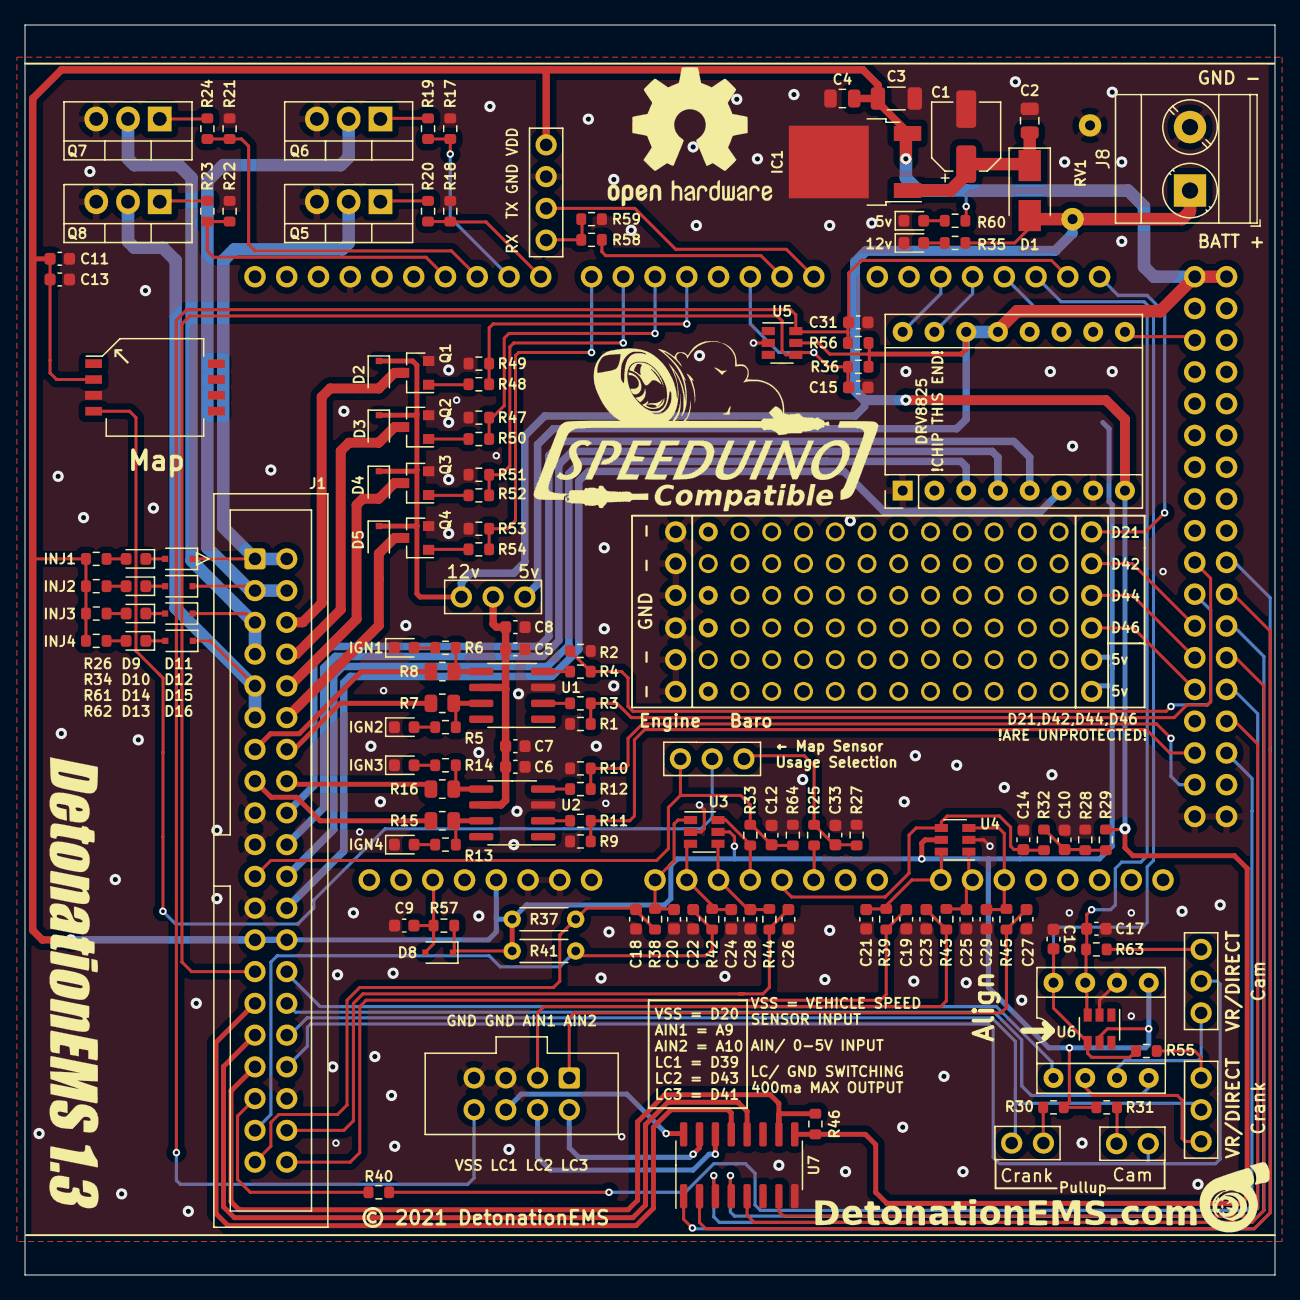
[picture p162: board 1.3.kicad_pcb from above]

Board: 2 copper layers, 100.0 x 100.0 mm, 157 parts (0 on the bottom side), 121 nets.

Parts:
A1: Pololu_Breakout_DRV8825; Pololu_Breakout-16_15.2x20.3mm
C1: 10uF; CP_Elec_5x5.3
C2: 330nf; C_0805_2012Metric
C3: 47uF; C_1206_3216Metric
C4: 100nF; C_0805_2012Metric
C5, C7, C10, C11, C17, C18, C19, C22, C23, C26, C27: 100nF; C_0603_1608Metric
C6, C8, C13: 1uF; C_0603_1608Metric
C9: 4.7nF; C_0603_1608Metric
C12, C33: 47pF; C_0603_1608Metric
C14, C15, C20, C21, C24, C25, C28, C29: 220nF; C_0603_1608Metric
C16, C31: 10nF; C_0603_1608Metric
D1: SS34; D_SMA
D2, D3, D4, D5, D8, D11, D12, D15, D16: 1N4148WS; D_SOD-323F
D6, D7: LED Green; LED_0603_1608Metric
D9, D10, D13, D14: LED Blue; LED_0603_1608Metric
G1: Logo_Open_Hardware_Small; TireSmoke-22mm
G2: Logo_Open_Hardware_Small; SpeeduinoCompatible-30mm
G3: Logo_Open_Hardware_Small; DetonationEMS
G4: Logo_Open_Hardware_Small; Detonationems1.3-36mm
G5: Logo_Open_Hardware_Small; OSHW-Logo2_14.6x12mm_SilkScreen
IC1: L7805CDT; TO-252-2
IGN1, IGN2, IGN3, IGN4: LED Blue; LED_0603_1608Metric
J1: Conn_02x20_Counter_Clockwise; IDC-Header_2x20_P2.54mm_Vertical_Speeduino
J2: Conn_01x04; 1X4-PROTO
J3, J7: Conn_02x16_Counter_Clockwise; PROTO-3X32
J4: VR_Header; Socket_VRConditioner
J5, J6, J10, J11: Conn_01x02; 3x1-GPIO-NOBORDER
J8: Screw_Terminal_01x02; TerminalBlock_Phoenix_MKDS-3-2-5.08_1x02_P5.08mm_Horizontal
J9: Conn_02x04_Counter_Clockwise; IDC-8-AUX
JP1: Ignition Voltage; 3x1-GPIO
JP2: VR-HALL; 3x1-GPIO
JP3: VR-Hall; 3x1-GPIO
JP4, JP5: Pullup; 1x02-Proto
JP7: Jumper_3_Bridged12; 3-PinSwitch
Map1: Map; MPXH6250
Q1, Q2, Q3, Q4: AO3400A; SOT-23
Q5, Q6, Q7, Q8: STP62/75; TO-220-3_Vertical
R1, R2, R9, R10, R17, R18, R21, R22, R47, R49, R51, R53: 100k; R_0603_1608Metric
R3, R4, R11, R12, R19, R20, R23, R24, R28, R30, R31, R35, R40, R56, R58: 1k; R_0603_1608Metric
R5, R6, R13, R14, R36: 2.4k; R_0603_1608Metric
R7, R8, R15, R16: 10; R_0805_2012Metric
R25, R26, R32, R33, R34, R38, R39, R42, R43, R44, R45, R60, R61, R62: 470; R_0603_1608Metric
R27, R64: 51k; R_0603_1608Metric
R29: 3.9k; R_0603_1608Metric
R37, R41: 2.49k; R_Axial_DIN0204_L3.6mm_D1.6mm_P5.08mm_Horizontal
R46, R57: 10k; R_0603_1608Metric
R48, R50, R52, R54: 120; R_0603_1608Metric
R55, R63: 220; R_0603_1608Metric
R59: 2k; R_0603_1608Metric
RV1: MOV
U1, U2: TC4427; SOIC-8_3.9x4.9mm_P1.27mm
U3, U4, U5, U6: SRV05-4-P-T7; SOT-23-6
U7: ULN2003A; SOIC-16_3.9x9.9mm_P1.27mm
XA1: Arduino_Mega2560_Shield-Arduino; Arduino_Mega2560_Shield_IO_Only_No_Silk_Screen

Connections:
+BATT: A1.8, D1.2, D2.1, D3.1, D4.1, D5.1, J8.1, JP1.1, R29.2, R35.2, R46.2, RV1.1, U7.9
A9: C23.1, J9.3, R43.2
A10: C27.1, J9.1, R45.2
BOOST: D5.2, J1.35, Q4.3
CLT: C22.1, J1.19, R41.1, R42.2
Cam-In: J1.24, JP3.2, JP5.1
Clutch: J1.18, R40.2
Crank-In: J1.25, JP2.2, JP4.1
D39: J9.6, U7.16
D41: J9.2, U7.15
D43: J9.4, U7.14
Fan: J1.15, U7.13
Flex: C15.1, J1.14, R36.2, U5.4, XA1.D2
Fuel-Pump: J1.16, U7.12
GND: A1.1, A1.7, C1.2, C2.2, C3.2, C4.2, C5.2, C6.2, C7.2, C8.2, C9.1, C10.2, C11.1, C12.1, C13.1, C14.2, C15.2, C16.1, C17.1, C18.2, C19.2, C20.2, C21.2, C22.2, C23.2, C24.2, C25.2, C26.2, C27.2, C28.2, C29.2, C31.2, C33.2, D6.1, D7.1, IC1.2, IGN1.1, IGN2.1, IGN3.1, IGN4.1, J1.9, J1.10, J1.12, J1.23, J2.2, J4.6, J6.1, J6.2, J6.3, J8.2, J9.5, J9.7, J11.1, J11.2, J11.3, Map1.3, Q1.2, Q2.2, Q3.2, Q4.2, Q5.3, Q6.3, Q7.3, Q8.3, R1.2, R2.1, R9.2, R10.1, R17.1, R18.1, R21.1, R22.1, R27.2, R28.1, R47.1, R49.1, R51.1, R53.1, R59.1, R64.1, RV1.2, U1.3, U2.3, U3.2, U4.2, U5.2, U6.2, U7.8, XA1.GND1, XA1.GND2, XA1.GND3, XA1.GND5, XA1.GND6
HC1: D4.2, J1.36, Q3.3
HC2: D2.2, J1.38, Q1.3
IAT: C18.1, J1.20, R37.1, R38.2
IDLE: D3.2, J1.37, Q2.3
IGN1: J1.7, R8.1
IGN2: J1.34, R7.1
IGN3: J1.33, R16.1
IGN4: J1.8, R15.1
IGN-V-Select: C5.1, C6.1, C7.1, C8.1, JP1.2, U1.6, U2.6
INJ1: D11.1, J1.1, J1.40, Q5.2
INJ2: D12.1, J1.2, J1.39, Q6.2
INJ3: D15.1, J1.3, J1.4, Q7.2
INJ4: D16.1, J1.5, J1.6, Q8.2
MC-A0: C20.1, R38.1, U3.1, XA1.A0
MC-A1: C24.1, R42.1, U3.3, XA1.A1
MC-A2: C28.1, R44.1, U3.4, XA1.A2
MC-A3: R33.2, U3.6, XA1.A3
MC-A4: C14.1, R32.1, U4.4, XA1.A4
MC-A5: R25.2, XA1.A5
MC-A8: C21.1, R39.1, U4.6, XA1.A8
MC-A9: C25.1, R43.1, U4.1, XA1.A9
MC-A10: C29.1, R45.1, U4.3, XA1.A10
MC-D0: J2.3, XA1.D0
MC-D1: R58.2, XA1.D1
MC-D4: R48.2, R49.2, XA1.D4
MC-D5: R47.2, R50.2, XA1.D5
MC-D6: R51.2, R52.2, XA1.D6
MC-D7: R53.2, R54.2, XA1.D7
MC-D8: R18.2, R20.2, XA1.D8
MC-D9: R17.2, R19.2, XA1.D9
MC-D10: R21.2, R24.2, XA1.D10
MC-D11: R22.2, R23.2, XA1.D11
MC-D16: A1.16, XA1.D16
MC-D17: A1.15, XA1.D17
MC-D18: C17.2, J4.7, R63.2, U6.3, XA1.D18
MC-D19: C16.2, J4.8, R55.1, U6.4, XA1.D19
MC-D20: C31.1, J9.8, R56.1, U5.6, XA1.D20
MC-D21: J5.1, XA1.D21
MC-D24: A1.9, XA1.D24
MC-D38: R1.1, R3.2, XA1.D38
MC-D39: U7.1, XA1.D39
MC-D40: R2.2, R4.2, XA1.D40
MC-D41: U7.2, XA1.D41
MC-D42: J5.2, XA1.D42
MC-D43: U7.3, XA1.D43
MC-D44: J5.3, XA1.D44
MC-D45: U7.5, XA1.D45
MC-D46: J10.1, XA1.D46
MC-D47: U7.4, XA1.D47
MC-D49: U7.7, XA1.D49
MC-D50: R9.1, R11.2, XA1.D50
MC-D51: R40.1, XA1.D51
MC-D52: R10.2, R12.2, XA1.D52
MC-RESET: C9.2, D8.2, R57.2, XA1.RST1
Map-External: C12.2, J1.11, JP7.1, R33.1, R64.2
unnamed: C1.1, C2.1, D1.1, IC1.1
unnamed: C10.1, R28.2, R29.1, R32.2
unnamed: C33.1, JP7.3, R25.1, R27.1
unnamed: D6.2, R35.1
unnamed: D7.2, R60.1
unnamed: D9.2, R26.2
unnamed: D10.1, D12.2
unnamed: D10.2, R34.2
unnamed: D9.1, D11.2
unnamed: D13.1, D15.2
unnamed: D13.2, R61.2
unnamed: D14.1, D16.2
unnamed: D14.2, R62.2
unnamed: IGN1.2, R6.1
unnamed: IGN2.2, R5.2
unnamed: IGN3.2, R14.1
unnamed: IGN4.2, R13.2
unnamed: J2.4, R58.1, R59.2
unnamed: J4.2, JP2.3
unnamed: J4.3, JP3.1
unnamed: JP2.1, R55.2
unnamed: JP3.3, R63.1
unnamed: JP4.2, R30.1
unnamed: JP5.2, R31.1
unnamed: JP7.2, Map1.4
unnamed: Q1.1, R48.1
unnamed: Q2.1, R50.1
unnamed: Q3.1, R52.1
unnamed: Q4.1, R54.1
unnamed: Q5.1, R20.1
unnamed: Q6.1, R19.1
unnamed: Q7.1, R24.1
unnamed: Q8.1, R23.1
unnamed: R3.1, U1.2
unnamed: R4.1, U1.4
unnamed: R5.1, R7.2, U1.7
unnamed: R6.2, R8.2, U1.5
unnamed: R11.1, U2.2
unnamed: R12.1, U2.4
unnamed: R13.1, R15.2, U2.7
unnamed: R14.2, R16.2, U2.5
O2: C19.1, J1.21, R39.2
Step-A1: A1.4, J1.31
Step-A2: A1.3, J1.30
Step-B1: A1.5, J1.32
Step-B2: A1.6, J1.29
TPS: C26.1, J1.22, R44.2
Tach: J1.17, R46.1, U7.10
VDD: A1.13, A1.14, C3.1, C4.1, C11.2, C13.2, D8.1, IC1.3, J1.13, J1.28, J2.1, J4.5, J10.2, J10.3, JP1.3, Map1.2, R26.1, R30.2, R31.2, R34.1, R36.1, R37.2, R41.2, R56.2, R57.1, R60.2, R61.1, R62.1, U3.5, U4.5, U5.5, U6.5, XA1.5V1, XA1.5V3, XA1.5V4
VR1-: J1.27, J4.1
VR2-: J1.26, J4.4
