OpenLogicEFI/Hardware/(commit log)

2021-08-05 schematic upload for 1.3
    PDF
2021-08-11 Release of Pre-Ignition X4
    Initial upload of Pre-Ignition X4
    [Analog.sch, Connector.sch, Fuel-Ignition.sch, Output.sch, Pre_Ignition.kicad_pcb, Pre_Ignition.sch, bomjlc.csv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]
2021-09-18 Folder Organization
    [Analog.sch, BOM-SMD.csv, Connector.sch, Fuel-Ignition.sch, Output.sch, Pre_Ignition.kicad_pcb, Pre_Ignition.sch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]
2021-09-21 Initial Upload of DetonationEMS 1.3 Rev E
    Latest version of 1.3 brings several new features and an easier to use layout.
    [1.3.kicad_pcb, 1.3.sch, Analog.sch, BOM-SMD.csv, BOM-THT.csv, Connector.sch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]
2021-09-21 Pre-Ignition x4 MX4B upload for reference only
    [Analog.sch, Connector.sch, Fuel-Ignition.sch, Output.sch, Pre_Ignition.kicad_pcb, Pre_Ignition.sch]
2021-09-22 Pre-Ignition x2 Initial Upload, MX4B Production.
    Pre-Ignition x2 Initial Upload - 2 Channel Speeduino compatible ECU
    Pre-Ignition x4 MX4B (revision B) - minor updates, BOM changes, connectors moved to bottom side of board.
    [1.3.kicad_pcb, Analog.sch, Connector.sch, Fuel-Ignition.sch, Output.sch, Pre_Ignition.kicad_pcb, Pre_Ignition.sch, Protection.sch]
2021-09-22 STL update
    Added end caps for Pre-Ignition x4
    1.3 End cap updated
    [Back.stl, Front.stl, back (bottom mounted connectors).stl, back.stl, front (bottom mounted connectors).stl, front.stl]
2021-09-22 bom fix
    [1.3.kicad_pcb, Analog.sch, Pre_Ignition.kicad_pcb]
2021-09-23 Pinout Documentation for MX4B Updated.
    Unnecessary build files removed.
    [bomjlc.csv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]
2021-09-23 x4 stl file improvments
    [Back(Bottom Mounted Connectors).stl, Front(Bottom Mounted Connectors).stl, back (bottom mounted connectors).stl, front (bottom mounted connectors).stl]
2021-09-24 Pre-Ignition x4 pinout update
    Update pinout charts to include both top and bottom mount located connectors.
2021-10-03 update STL files
    Add Pre-ignition x2
    [back.stl, body.stl, front.stl]
2021-10-03 Initial Upload of VR Conditioner NCV1124
    Rename Josh's Conditioner folder and create readme.
    [Duel VR.kicad_pcb, Duel VR.sch, VR Conditioner v3.1.fzz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]
2021-10-05 add schem PDF
    added PDF schematic for x2
2021-10-09 DetoStim initial Upload
    DetoStim initial Upload - Engine Simulator for Ardustim
    Update a few readme files.
    [Simulator.kicad_pcb, Simulator.sch]
2022-02-17 VR Conditioner Update
    Update Schematic
    Include Instructions
    Update Readme
    [Duel VR.kicad_pcb, Duel VR.kicad_sch, Duel VR.sch]
2022-02-17 DetoStim Upload
    Product read upload
    [Simulator.kicad_pcb, Simulator.kicad_sch, Simulator.sch]
2022-02-17 Delete Simulator-2022-02-17_154741.zip
    remove kicad backup
2022-08-21 8channel Simulator and re-organize
    Initial Upload - 8 Channel Engine Simulator
    File structure organize.
    [1.3 - Back.stl, 1.3 - Front.stl, 1.3.kicad_pcb, 1.3.sch, Analog.sch, BOM-SMD.csv, BOM-THT.csv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]
2022-09-11 Minor Corrections
    Silkscreen Correction - Cam and Crank output labels were swapped
    Output pulse LED's removed (Serve no purpose)
    Minor layout improvements.
    [Simulator.kicad_pcb, Simulator.kicad_sch]
2022-10-29 Schematic Correction
    VRConditioner NCV1124 schematic math correction.
    Readme Updated for upcoming revision
    Instructions Added to RevA folder
    [Duel VR.kicad_pcb, Duel VR.kicad_sch]
2022-11-07 Remove unnecessary pinout
    Remove top mount pinout from MX4B. It was only used of a select few MX4A
2022-11-17 Product upload, file organization.
    Initial upload of NCV1124 based condition RevB
    File organization, removal of unnecessary files.
    [Analog.kicad_sch, Connector.kicad_sch, Duel VR.kicad_pcb, Duel VR.kicad_sch, Fuel-Ignition.kicad_sch, Max9926-VR.kicad_pcb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]
2022-11-17 Engine Simulator RevB Initial upload
    Improved design 8 Channel engine simulator. Optocoupler output allows for more versatile signal output usage.
    Fixed silk screen error.
    [Simulator.kicad_pcb, Simulator.kicad_sch]
2022-12-11 File organization.
    Remove redundant files.
    [Analog.kicad_sch, Connector.kicad_sch, Duel VR.kicad_sch, Fuel-Ignition.kicad_sch, Output.kicad_sch, mapping.csv]
2022-12-27 MX4B-2 initial upload. MX4X Pinout
    Pre-ignition MX4B-2 Initial upload
    Pinout documentation clarification updated.
    [Connector.kicad_sch, Fuel-Ignition.kicad_sch, Output.kicad_sch, Pre_Ignition.kicad_pcb, Pre_Ignition.kicad_sch, input.kicad_sch]
2022-12-27 MX4C Initial Upload
    [Analog.kicad_sch, Connector.kicad_sch, Fuel-Ignition.kicad_sch, Output.kicad_sch, Pre_Ignition.kicad_pcb, Pre_Ignition.kicad_sch, cover to copy.kicad_sch, mcu.kicad_sch]
2023-03-24 EngineSim PCB rev-c, minor fixed/layout changes.
    see readme
    [Simulator.kicad_pcb, Simulator.kicad_sch]
2023-05-11 Upload correct initial upload files
    Initial upload files were accidently taken from an alpha folder. 5v pins on main connector had no voltage. To fix the issue on any manufactured boards remove C8 and C9. Then short the pins of the removed capacitors.
    [Analog.kicad_sch, Connector.kicad_sch, Fuel-Ignition.kicad_sch, Output.kicad_sch, Pre_Ignition.kicad_pcb, Pre_Ignition.kicad_sch, mcu.kicad_sch, power.kicad_sch]
2023-06-14 VRNCV-B
    Layout update. Schematic unchanged.
    [Duel VR.kicad_pcb, Duel VR.kicad_sch]
2023-06-14 Engine Simulator Upload Revision Correcton
    Minor changes were made to RevB and uploaded as RevC by mistake. RevB minor layout changes for ease of use. Protection Zener added. Label correction.
    [Simulator.kicad_pcb, Simulator.kicad_sch, input.kicad_sch, mcu.kicad_sch, simulation.kicad_sch]
2023-06-15 Structure Update
    MX2 - RevB Upload
    MX4B-2 - KiCad Version update (no changes)
    MX4C - Organized Schematic, Minor layout change
    Engine Simulator 8 Channel - Organized Schematic (no changes)
    PMAP-M - Map Sensor Breakout for MX4C
    [Analog.kicad_sch, Connector.kicad_sch, Fuel-Ignition.kicad_sch, Output.kicad_sch, Pre_Ignition.kicad_pcb, Pre_Ignition.kicad_sch, Simulator.kicad_sch, connector-power.kicad_sch]
2023-10-24 minor update
    Copper Pour and clearances updated.
    [Analog.kicad_sch, Connector.kicad_sch, Fuel-Ignition.kicad_sch, Output.kicad_sch, Pre_Ignition.kicad_pcb, Pre_Ignition.kicad_sch, mcu.kicad_sch, power.kicad_sch]
2023-10-27 MX4C PCB end caps
    Initial upload of Pre-Ignition x4 MX4C PCB end caps
    [endcap.kicad_pcb, endcap.kicad_sch]
2024-01-13 Initial upload PMAP-M
    Updated map sensor design for OpenLogicEFI ECU's.
    SHOULD NOT BE USED FOR BOARDS LABLED "DETONATIONEMS".
    [map-pinned.kicad_pcb, map-pinned.kicad_sch]
2024-02-08 Minor updates
    PMAP-M correction
    Endcap updates
    readme updates
    [Pinout.xlsx, endcap.kicad_pcb, endcap.kicad_sch, map-pinned.kicad_pcb, map-pinned.kicad_sch]
2024-07-06 Closed-Deck-x4
    Initial hardware upload
    [CKP-CMP.kicad_sch, Pinout.xlsx, closed-deck-x4.kicad_pcb, closed-deck-x4.kicad_sch, connector.kicad_sch, digital-inputs.kicad_sch, fuel-ignition.kicad_sch, input.kicad_sch]
2024-07-17 Initial upload spark gap x4
    [Connector.kicad_sch, Fuel-Ignition.kicad_sch, MCU-Power.kicad_sch, Output.kicad_sch, Pre_Ignition.kicad_pcb, Pre_Ignition.kicad_sch, input.kicad_sch, serial.kicad_sch]
2024-10-08 Initial upload NCV1124 RevB2
    NVC1124 RevB2 upload
    Ncv1124 RevB - spelling correction
    [Duel VR.kicad_pcb, Duel VR.kicad_sch]
2024-10-08 schematic exports
    kicad version updates, schematic exports
    [Analog.kicad_sch, Connector.kicad_sch, Fuel-Ignition.kicad_sch, Output.kicad_sch, Pre_Ignition.kicad_pcb, Pre_Ignition.kicad_sch, connector-power.kicad_sch, digital.kicad_sch]
2025-04-27 minor document changes
    CD pinout zip
    [map-pinned.kicad_pcb, map-pinned.kicad_sch]
2025-05-05 file relocation
    schematic relocation
2025-05-19 CDx4a RevA3 | Engine Sim RevB2: initial upload
    CDx4 RevA3: Minor layout changes, improved protection and stability, PCB edgecut corrections
    Engine Sim RevB2: Minor layout changes, added additional protection.
    [CKP-CMP.kicad_sch, Simulator.kicad_pcb, Simulator.kicad_sch, closed-deck-x4.kicad_pcb, closed-deck-x4.kicad_sch, connector.kicad_sch, digital-inputs.kicad_sch, fuel-ignition.kicad_sch]
2025-05-19 pmap-m update
    bom update (footprint change)
    [map-pinned.kicad_pcb, map-pinned.kicad_sch]
2025-05-19 Spark Gap X4 RevC
    RevC initial upload
    Note: RevB was never released.
    [Connector.kicad_sch, Fuel-Ignition.kicad_sch, MCU-Power.kicad_sch, Output.kicad_sch, Pre_Ignition.kicad_pcb, Pre_Ignition.kicad_sch, input.kicad_sch, notes.kicad_sch]
2025-05-19 ICM2a Initial Upload
    [ICM.kicad_pcb, ICM.kicad_sch]
2025-05-19 VRMAX-B initial upload
    Very minor changes:
    Slight footprint location changes
    Minor slikscreen changes.
    [Max9926-VR.kicad_pcb, Max9926-VR.kicad_sch]
2025-05-19 Repair file structure
    Remove redundant hardware/hardware folder
    [1.3.kicad_pcb, 1.3.sch, Analog.kicad_sch, Analog.sch, BOM-SMD.csv, BOM-THT.csv, CKP-CMP.kicad_sch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]
2025-05-30 document organization
    document organization
    mx4c & sim8-b2 schematic PDF upload
2025-05-30 fix the fix (oops)
    fix mistakes in schematic location file structure..
2026-03-03 mx4d initial upload
    MX4D comes with quality, layout, protection and IC
    [Analog.kicad_sch, Connector.kicad_sch, Fuel-Ignition.kicad_sch, Output.kicad_sch, Pre_Ignition.kicad_pcb, Pre_Ignition.kicad_sch, mcu.kicad_sch, power.kicad_sch]
2026-06-21 Reorganization - Version uploads
    CDx4 B1,2 - NCV1124 B3 - PMAPM 2 - Sim8 B3 - Upload
    Remove ICM2A (design issues), Upload ICM2B Major redesign,
    [CKP-CMP.kicad_sch, Duel VR.kicad_pcb, Duel VR.kicad_sch, ICM.kicad_pcb, ICM.kicad_sch, Pre_Ignition.kicad_pcb, Simulator.kicad_pcb, Simulator.kicad_sch]
2026-06-21 INJ N-fet upload - Date corrections
    N-Fet Initial Upload, recent upload date corrections.
    [ICM.kicad_sch, Simulator.kicad_sch, closed-deck-x4.kicad_sch, connector.kicad_sch, digital-inputs.kicad_sch, fuel-ignition.kicad_sch, input.kicad_sch, map-pinned.kicad_sch]
2026-07-25 Incorrect version cdx4 previously uploaded
    Remove cdx4 rev3 (unreleased beta) / Replace cdx4 rev2 with correct version
    [closed-deck-x4.kicad_pcb, closed-deck-x4.kicad_sch, connector.kicad_sch, digital-inputs.kicad_sch, fuel-ignition.kicad_sch, input.kicad_sch, mcu.kicad_sch, output.kicad_sch]
