OpenLogicEFI/Hardware/(notices)

Notices in the files:
Engine Managment/Pre-Ignition/Pre-Ignition x4/MX4B/Pre_Ignition.kicad_pcb:
© 2021 DetonationEMS
Engine Managment/Spark Gap/Spark Gap X4/RevA/Pre_Ignition.kicad_pcb:
© 2024 OpenLogicEFI (Aaron S.)
Modules/VR Conditioner NCV1124/RevB/Duel VR.kicad_pcb:
©Aaron S. 2023
Modules/VR Conditioner MAX9926/RevB/Max9926-VR.kicad_pcb:
© OpenLogicEFI 2024
Modules/VR Conditioner MAX9926/RevA/Max9926-VR.kicad_pcb:
© DetonationEMS
Engine Managment/Pre-Ignition/Pre-Ignition x4/MX4B-2/Pre_Ignition.kicad_pcb:
© 2022 Aaron S.
Modules/VR Conditioner MAX9926/RevB/Max9926-VR.kicad_sch:
© 2025 DetonationEMS (Aaron S.)
Engine Simulation/8 Channel/RevB/Simulator.kicad_pcb:
DetonationEMS © 2023 (Aaron S.)
Engine Managment/Spark Gap/Spark Gap X4/RevC/Pre_Ignition.kicad_pcb:
Design by: © 2025 OpenLogicEFI
Modules/MAP Sensor Modules/PMAP-M/Rev1/map-pinned.kicad_pcb:
©OpenLogicEFI 2025
Engine Simulation/8 Channel/RevA/Simulator.kicad_pcb:
DetonationEMS © 2022
Engine Simulation/8 Channel/RevB2/Simulator.kicad_pcb:
Design by: OpenLogicEFI ©2025
Engine Managment/Pre-Ignition/Pre-Ignition x4/MX4D/Pre_Ignition.kicad_pcb:
© OpenLogicEFI 2026 (Aaron S.)
Engine Simulation/8 Channel/RevC/Simulator.kicad_pcb:
Design by: OpenLogicEFI ©2026
Engine Managment/Spark Gap/Spark Gap X4/RevC2/SparkGapX4.kicad_pcb:
Design by: © 2026 OpenLogicEFI
